UW-Allen-School-Robotics/opendubs/description/README.md

# Robot description

The single description of the robot's geometry, read by everything that needs it: the MuJoCo
simulator (`sim/`), the clearance checker, the choreography preview, and the dashboard's arm
view. Nothing else in the repository carries a copy.

| Folder | What | Source |
|---|---|---|
| [`opendubs/`](opendubs/) | the base, wheels, Z-axis lift and pan/tilt head: `opendubs.xml` (MJCF), its meshes, and `dimensions.yaml`, which records where every number came from | this project, from CAD and measurement |
| [`openarm/gafro/`](openarm/gafro/) | the arms for the gafro stack: `openarm_assets`' model with joint 2 capped for the head, generated by `tools/arm_gafro_model.py` (its meshes are `openarm/meshes/`) | generated |
| [`openarm/`](openarm/) | the two OpenArm v1 arms and their frame: `mjcf/` (MuJoCo), `urdf/` (for the dashboard), `meshes/collision/` (shared by both), `meshes/visual/` (MuJoCo only, decimated), and `chain.json` (generated) | vendored; see below |

**The geometry is real; the dynamics are not.** See the banner in `sim/README.md` before reading
anything about force, timing or mass out of these files.

## The vendored arms

`openarm/` comes from two upstream projects, both Apache-2.0 at their origin:

- **MuJoCo model** — `mjcf/` and `meshes/` from
  [`openarm_assets`](https://github.com/ericjgoossen/openarm_assets) (MIT), which packages
  [`enactic/openarm_mujoco`](https://github.com/enactic/openarm_mujoco). The MJCF and the collision
  meshes are unchanged; the visual meshes are decimated to keep this repository small.
  `PROVENANCE.json` records both commits and the triangle counts before and after.
- **URDF** — `urdf/v1.urdf` from
  [`enactic/openarm_description`](https://github.com/enactic/openarm_description), with its
  collision mesh paths pointed at the shared meshes. See `urdf/README.md`.

Licences: `LICENSE-openarm-models` (Apache-2.0, the arm models), `LICENSE-openarm_assets` (MIT,
the packaging), `urdf/LICENSE.txt` (Apache-2.0, the URDF).

`opendubs/` is the project's own: its meshes are the project's CAD under the repository's hardware
licence (CERN-OHL-W-2.0, `LICENSE-HARDWARE`), and `dimensions.yaml` (`meshes:`) records where each
came from.

### Refreshing the arms

```bash
git clone https://github.com/ericjgoossen/openarm_assets /tmp/oa_assets
uv run --python 3.11 --with trimesh --with fast-simplification --with numpy \
    python tools/vendor_openarm.py --from /tmp/oa_assets
python3 sim/scene.py --check
python3 tools/arm_chain.py --check
```

To try a newer upstream model without vendoring it, pass the checkout to `sim/scene.py --assets`.

## Who reads what

| Consumer | Reads |
|---|---|
| `sim/scene.py`, `sim/view.sh`, `sim/clearance.py`, `software/choreo/sim_preview.py` | `opendubs/opendubs.xml` + meshes, `openarm/mjcf/` + `openarm/meshes/` |
| The dashboard's arm view (`software/kiosk-dashboard/frontend/armview.js`) | `openarm/chain.json` + `openarm/meshes/collision/`, through `frontend/assets/arm`, a symlink to `openarm/` in a checkout. `deploy.sh` copies just those files to the robot |
| `tools/arm_chain.py` | `openarm/urdf/v1.urdf` → writes `openarm/chain.json` |
| `opendubs/gen_urdf.py` | `opendubs/dimensions.yaml` → writes `opendubs/opendubs.urdf` (the ROS TF tree for `robot_state_publisher`) |
| `opendubs/variants.py` | `opendubs/dimensions.yaml` → swaps an alternative part (the straight Femto mount; the 30° one is fitted) into an `opendubs.xml` MjSpec before it is compiled |

## Regenerating the derived files

`describe.py` runs every generator above, so nothing has to know them one by one:

```sh
python3 description/describe.py              # rebuild chain.json and the URDFs (one per Femto mount)
python3 description/describe.py --check      # exit 1 if either is stale (CI runs this)
python3 description/describe.py --watch      # rebuild on any change to an input (pip install watchfiles)
python3 description/describe.py --manifest   # JSON sha256 of every input and output, for caching
```

It needs Python 3 and PyYAML, and no ROS. Exit codes are 0 for OK, 1 for stale and 2 for a missing
input or a generator that crashed. A generator script counts as an input, so editing one changes the
manifest.
