UW-Allen-School-Robotics/opendubs/hardware/renders/README.md

# Renders

Exploded views and assembly figures for the build guide (exported from Fusion 360).
**TODO — populate.** One exploded render per subassembly (`CH`, `DT-*`, `PW`, …) drops straight into
the corresponding assembly-guide step.
