UW-Allen-School-Robotics/opendubs/software/kiosk-dashboard/frontend/assets/README.md

# DRIVE page mode illustrations (TEMPORARY)

The DRIVE page shows the current drive variant with a robot render. Drop the two
provided Fusion renders here (exact names matter):

- `robot-mecanum.png`  — the mecanum-wheel build (MECANUM mode)
- `robot-4wd.png`      — the traction-tire build (4WD TRACTION mode)

These are placeholders for illustration; swap for final art later. The frontend
references them at `assets/robot-mecanum.png` / `assets/robot-4wd.png`.
