UW-Allen-School-Robotics/opendubs/docs/system-overview.md

# System Overview

## Core Architecture

The core robot as buses and interfaces. **Click the diagram to pan and zoom the live board** — the
labels are small at page scale:

<div class="embed-facade" markdown="1" data-embed="https://embed.figma.com/board/LVbgJwMKO65TARF3m6v7I6/OpenDubs?node-id=21-995&embed-host=opendubs-docs" data-title="OpenDubs bus map (Figma)">
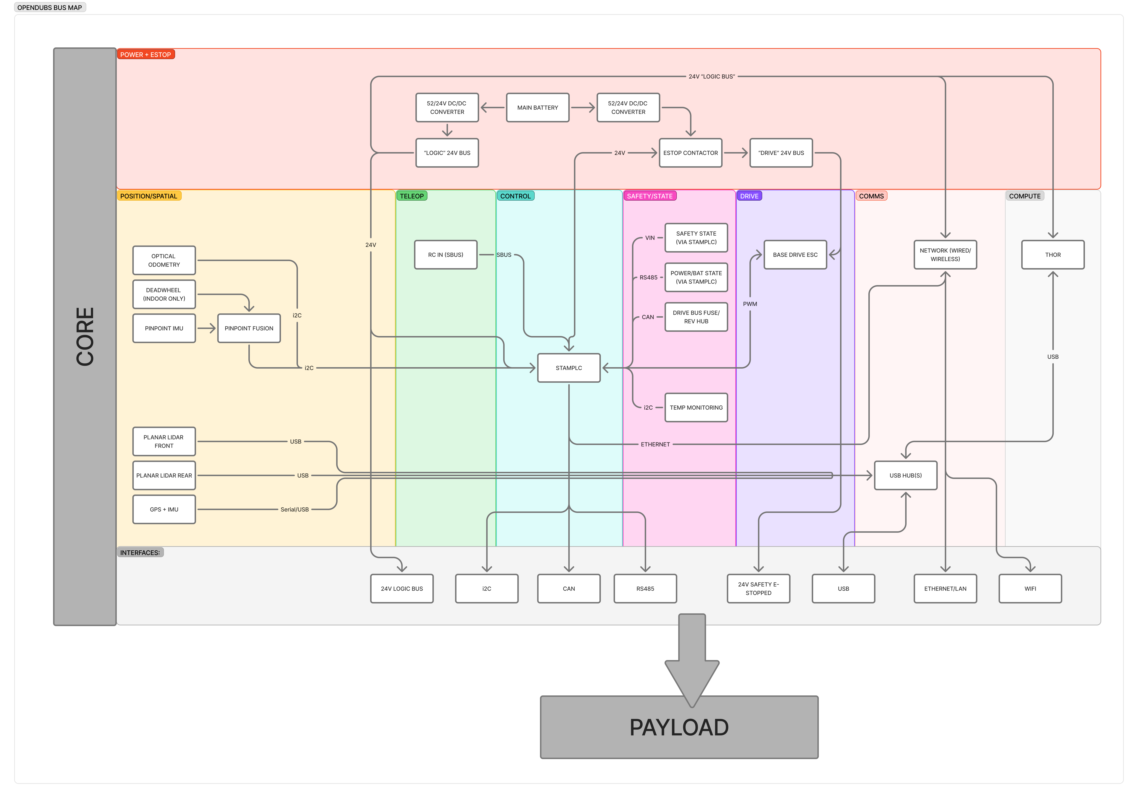
[picture p1: docs/assets/diagrams/opendubs-bus-map.png]
OpenDubs bus map — click to pan and zoom the interactive board

<span class="embed-facade__play">▶ Pan &amp; zoom the live board</span>
</div>

Power + e-stop, position/spatial, teleop, control, safety/state, drive, comms, and compute —
converging on the StamPLC and Thor, and exposed to a payload through the standard interfaces
(24 V logic, I²C, CAN, RS485, USB, Ethernet, Wi-Fi, and 24 V safety/e-stopped).

- **Open in Figma:** [OpenDubs board — bus map](https://www.figma.com/board/LVbgJwMKO65TARF3m6v7I6/OpenDubs?node-id=21-995) — the live board also includes the **payload-connected** system bus map (the poster above shows the core version). Clicking the diagram loads the full interactive board.

- Primary robot brain: **NVIDIA Thor AGX Dev Kit**
- Edge controllers: **StamPLC** on the mobile base, and an **M5Dial** neck controller for the
  head — introduced under *Responsibility split* below. Each payload may bring its own as well
- Mobile base: 4 motors + 2 dual-channel ESCs, optimised for **mecanum** drive and switchable to
  **4WD traction** drive in software
- Z-axis: the interchangeable payload that raises and lowers the arms — a **scissor lift**
  (fitted today) or a **mast** (DC motor driving a lead screw)
- Manipulators: dual OpenArm 7-DOF arms

OpenArm reference:
- https://github.com/enactic/OpenArm

## Responsibility split

Two edge controllers sit beneath the Thor. Neither reduces to a single function, so each is
introduced here with what it owns — and referred to by name everywhere after that.

### Thor AGX — robot level

- High-level behavior, planning, and autonomy orchestration
- Robot mode supervision
- Subsystem enable/disable coordination
- System-level fault handling policy decisions

### StamPLC — the mobile base

It owns the safety-critical edge of the base: it is the RC receiver, the e-stop moderator, the
source of the ESC and motor commands, and the publisher of hardware telemetry.

- RC/SBUS ingest and normalisation
- PWM output generation and safety gating
- E-stop moderation — contactor coil, button sense, weld detect
- Z-axis relay control and the pinch guard
- I²C and CAN edge interactions
- Fast safety fallback behaviours
- Hardware telemetry publishing

### The head — a tablet on an M5Dial neck

The head is two devices.

- **The tablet** — an Android tablet on the neck's mount, running the face page the dashboard
  serves. It is the display, speaker, microphone and cameras, and, lifted off its mount, the
  operator's dashboard. It runs on its own battery.
- **The M5Dial neck controller** — the second edge controller. It drives the pan and tilt servos
  through its own 8Servo, from the RC sticks (forwarded by the StamPLC) or from the Thor.

## Subsystems

- Mobile base subsystem
- Z-axis subsystem
- Left arm subsystem
- Right arm subsystem

Each subsystem has local state, fault state, and enable state.

## Related Docs

- [Control Authority and Modes](control-authority.md)
- [Robot and Subsystem State Machines](state-machines.md)
- [PWM and ESC Safety](pwm-esc-safety.md)
