UW-Allen-School-Robotics/opendubs/notes/design/choreo-dance-live.md

# DANCE on the real base

A show's DANCE cues are small dance steps of the base: sway, rock, twist, shuffle, box (`cue.DANCE_MOVES`).
Every one returns the base to where it started by construction. Until now they played in the twin only.
This is how a live run plays them on the robot. Owned by the Choreography lane. The tracker, the people
guard and the speed measurement are the Thor lane's (drive_bridge: #471 the guard, #472 the tracker).

## Fixed by the user

- **The deadman stays.** The base moves only in CH5 AUTO with the deadman held, under the firmware's
  0.35 command ceiling. Nothing here gates motion; it only sends targets.
- **No new sensors.** Relative motion comes from the Pinpoint odometry (`/odom`). The people guard uses
  the two LIDARs.
- **Free-form DRIVE stays twin-only.** Only DANCE moves, which return home, reach the robot.

## The interface (agreed with the Thor lane, 2026-10-21)

| topic | type | who | what |
|---|---|---|---|
| `/dance/origin` | `std_msgs/Empty` | runner | once per run, at the show's t0, the base at rest: the tracker latches the current `/odom` pose as the show's origin (`origin_seq` +1) |
| `/dance/target` | `nav_msgs/Odometry` | runner | 20 Hz while a move plays and for 1.5 s after it (the home target, zero twist, so the tracker closes the residual). `frame_id` `dance_origin`, `child_frame_id` `base_link`; pose = the intended base pose in the origin frame (x forward, y left, yaw); twist = the intended BODY velocity (m/s, rad/s) as feed-forward. Freshness by receipt time: older than 250 ms means stop |
| `/dance/stop` | `std_msgs/Empty` | runner | on every end: at once on an operator stop, abort or e-stop; after the last move's settle on a completion. Stops and drops the stream, and releases the base (the tracker holds it as the owner `show`, #485) |
| `/dance/status` | `std_msgs/String` (JSON, ~5 Hz) | tracker | `{"ready", "why", "origin", "origin_seq", "mode": idle\|tracking\|settling\|holding, "guard": clear\|stopped\|blind, "owner": null\|"show"\|<another program>, "err_m", "err_deg"}`; `ready` covers `/odom`, the guard, and no OTHER program holding the base ("the base is held by <name>": the base has one software owner at a time, #485); `origin` whether one is latched |

The tracker:

- never chases: corrections are capped at the 0.35 ceiling;
- past 0.3 m or 20° of error it HOLDS where it is and reports `mode: holding`;
- when a LIDAR scan is over 0.5 s old it is `blind` and refuses to move;
- refuses a target that arrives before any origin.

## The runner (`base_output.py`, `--base ros`)

- **Preflight, on a live run of a show with DANCE:** the tracker's status must be fresh and ready.
  - Not ready: the show runs WITHOUT its base moves and says why. The arms and everything else play as
    written; every move is relative to the base, so nothing collides.
  - A show with `dance: {required: true}` is refused instead (SHOW_BASE_NOT_READY).
- **The run:**
  - At t0 it publishes the origin.
  - Through each move it streams the same pose the twin draws (`sim_preview`'s model, the same speeds),
    with its body velocity.
  - Nothing is sent between moves, so the tracker stops.
  - On completion the last move still gets its settle, then it publishes `/dance/stop`. On any other end it
    publishes it at once. Either way the base is handed back, so another program can claim it.
- **Logging:** the guard (`stopped`: someone in the way; `blind`) and a `holding` tracker are logged.
  Neither aborts the show: the tracker decides what the base does.
- **Elsewhere:** a runner without `--base ros`, or a run that is not live, plays DANCE in the twin only.

## Speeds

The twist is in m/s and rad/s, and drive_bridge maps it to the wheels through its full scale, the speed
at DRIVE 1.0. In AUTO that is the firmware ceiling: 0.35 × the CH8 knob × full command.

- **The show cap** (the user's direction, 2026-10-22): software (AUTO) base motion is capped at a
  fraction of full command on every wheel, 0.35 on opendubs2 today (`cue.SHOW_BASE_CAP`, provisional). The
  Thor's drive path enforces it, per robot (`/etc/opendubs/base.env`), and the user may change it; RC is
  not capped. A dance unit of 1.0 is the cap. Top speed is never measured: shows are planned at the speeds
  at the cap.
- **Headroom** (the user's decision, 2026-10-22): a move peaks at no more than 70 % of the cap on the axis
  it uses (`cue.DANCE_PEAK_OF_CAP` 0.7; `amp` ≤ 0.7, the default), so the tracker has room to correct, and
  the validator refuses a DANCE cue that asks for more. At half the cap the motors barely turned and the
  base shuddered. No stroke moves and turns at once: strafing right yaws this base clockwise (about
  15 °/s, mechanical), and holding the heading uses part of the turn budget. The tracker trims that yaw by
  feed-forward, per strafe direction.
- **The speeds at the cap**, opendubs2's `base.env` (provisional: measured at a 0.25 cap, 1.5 s bursts,
  CH8 at its maximum, from `/odom`, and scaled to 0.35): forward 0.38 m/s, strafing 0.25 m/s either way,
  turning 0.52 rad/s (`BASE_M_PER_S_AT_CAP`, `BASE_M_PER_S_STRAFE_AT_CAP`, `BASE_RAD_PER_S_AT_CAP`). So
  at the default amp a sway peaks at about 0.175 m/s, and a 3 s sway swings about ±5.4 cm.
- **Every move starts and ends at rest** (measured on opendubs2, 2026-10-22). Constant-speed steps
  shuddered, the StamPLC holds each wheel still for 0.2 s at every direction flip, and a move that ends at
  speed makes the tracker brake from the peak. So each stroke is either a **swing**, the windowed sine
  `sin(2πu)·sin²(πu)` (out one way, through the middle at peak speed, out the other way and home, slow at
  both turn-arounds), or a **step**, `(1 − cos πu)/2` (to a new place and stop). A stroke's peak speed is
  exactly its amp × the speed at the cap.
- All of these numbers are re-measured after the drivetrain gets its belts. When the cap changes,
  `SHOW_BASE_CAP`, `DANCE_PEAK_OF_CAP` and the three speeds change together.
- Shows assume CH8 at its maximum. A lower knob can make the base lag, and the tracker holds rather than
  chase.

## Staging (also in every DANCE show's notices)

- **Glass.** Keep the show's declared floor radius clear of glass railings and glass walls: the LIDARs
  see through glass, so the guard does not see the edge.
- **Polished floors.** The odometry pods may skip on a polished floor: run a short out-and-back there
  first and compare `/odom` with where the base really went.
- **The floor test at the venue**, in this order:
  1. DANCE alone, measured with `/odom`: each move returns home within the tracker's error;
  2. then a full show.
