UW-Allen-School-Robotics/opendubs/notes/design/choreo-video.md

# Show video on a projector

Choreography lane, with the Tablet, Thor and Network lanes for their parts. Started 2026-10-20 for a
projector arriving the next day: an Anker Nebula P1i (1080p, Google TV with Chromecast built in,
a 20 W speaker; HDMI in presumed, to confirm when unboxed). It sits either on the robot or on the floor.

**Decided (the user):** casting first — the Thor serves the file over Wi-Fi and the projector's built-in
Cast plays it; HDMI from the Thor is the alternative when the projector is on the robot and sync
matters; the output is chosen at design time (per show or per cue) and at play time; and the dashboard
shows whether the projector is set up.

**Built (this PR):** the VIDEO track in the show format, the library's `video` kind, both outputs
(`software/choreo/video_out.py`), the runner playing them on the show's clock with its preflight and
the play-time override, the dashboard routes the projector card reads, and a CLI for the first test.
**Not built:** the HDMI player's service (Thor lane), the projector card (Tablet lane, #441), the
router reservation (Network lane), and the audio question (§5, for the user).

## 1. Video in a show

```yaml
video: { output: cast }            # optional: the show's default output (cast | hdmi | off), and
                                   # required: true to REFUSE the show when that output isn't ready
cues:
  - { bar: "5.1", slot: VIDEO, do: play, video: intro-loop }                   # to its end, then black
  - { t: 42.0,    slot: VIDEO, do: play, video: lab-tour, from_s: 12, secs: 20, end: hold }
  - { t: 70.0,    slot: VIDEO, do: stop }                                      # black now
```

- `video:` is a **library** id of kind `video` (`library.py add FILE --kind video --duration S --width W
  --height H --source … --licence …`). Video media never goes in the repository: the robot yes, the repo
  no. MP4/H.264 up to 1920×1080 plays on any Cast device; WebM and MKV are accepted for HDMI.
  `show_sync.py` sends a show's videos with its songs and skins (`library_sync.py`).
- `play` starts at the cue's time, `from_s` seconds into the file, for `secs` (default: to its end).
  Then `end`: `black` (default) or `hold` (its last frame). The next VIDEO cue ends the one before it.
  One video at a time — one projector — so overlapping VIDEO cues are refused like any slot collision.
- The output is the cue's `output`, else the show's `video: {output}`, else the robot's default
  (`OPENDUBS_VIDEO_OUTPUT`, else `cast`); the operator's play-time choice overrides them all (§4).
  The export carries each VIDEO event's resolved `output`.
- It stops on every end: COMPLETED, a stop, an abort → black; an e-stop → stopped at once.

## 2. The cast path

- **Discovery:** mDNS (`_googlecast._tcp`) from the Thor, refreshed every 10 s by the runner, so the
  card's answer is never older than that. Where multicast does not cross the network, a fixed address
  works without mDNS: `OPENDUBS_CAST_HOST` in `/etc/opendubs/robot.env`. With several Cast devices
  around, `OPENDUBS_CAST_NAME` names this robot's projector.
- **Serving:** the runner serves only the files a run registers (no directory, no other path) from a
  byte-range HTTP server on `OPENDUBS_VIDEO_PORT` (**8094**; 8093 is the voice service), bound at start to
  the robot-LAN interface's address — the interface avahi is limited to (`allow-interfaces`, as the
  AirPlay receiver reads it), or `OPENDUBS_VIDEO_BIND` (an address or an interface name) in robot.env;
  never a written-down address, since the Thor's LAN address is a DHCP lease. Cast receivers fetch and seek with Range
  requests. The URL's host is the Thor's own address toward the projector.
- **Control:** pychromecast, the Default Media Receiver: `load` (BUFFERED, paused at `from_s`) while the
  arms travel to their start pose, `play`, `seek`, `stop`, and a black still for `end: black`.
- **Sync** (`ShowVideo`): the receiver keeps its own clock, so —
  1. **start early** by its measured start latency, `OPENDUBS_CAST_LEAD_S` (default 0.8 s, per robot;
     measure it with `video_out.py play` and the test clip, §8);
  2. **correct with seeks**: every second the receiver's position (its last report, extrapolated to
     now) is compared with the show's; past **±250 ms** it is seeked back, but never within **8 s** of the
     last seek, because a Cast seek re-buffers — a visible hitch of a few hundred ms.
- **How tight, honestly:** the receiver reports its position as status messages, not a stream of
  timestamps, and its playback is not slaved to anything we control. Expect a steady error of about
  **±0.1–0.3 s** against the show's clock after the first correction, plus a **constant** lag of the
  projector's picture processing (typically 50–150 ms on a TV-style pipeline) that the receiver cannot
  report and only the lead can absorb — the test clip shows it. Good for backdrops, titles, scene
  changes and visuals timed to a beat; **not** good enough for lip-sync against sound played elsewhere
  (the tablet), and a correction is a visible hitch. Tighter sync is the HDMI path.
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
