UW-Allen-School-Robotics/opendubs/notes/design/network-uplinks.md

# Taking the robot off campus: joining other networks, and eduroam

**DRAFT, 2026-10-19, Network lane.** Design only; nothing is configured. Plan items N-J1…N-J5 and
N-E1…N-E4 in [`../workplan-network.md`](../workplan-network.md).

**The goal.** The router should join a venue's network as its uplink the same way it joins
UW MPSK today. The robot's own Wi-Fi ("Opendubs2") and its LAN (10.42.2.0/24) must stay exactly
as they are. An operator adds or switches a network without the router's admin web page and
without any risk of locking themselves out.

MikroTik facts come from the
[Wireless Interface](https://help.mikrotik.com/docs/spaces/ROS/pages/8978446/Wireless+Interface)
and [WiFi](https://help.mikrotik.com/docs/spaces/ROS/pages/224559120/WiFi) pages, read
2026-10-19. Facts about this router come from a read-only session the same day.

---

## 1. Constraints that shape every option
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
