UW-Allen-School-Robotics/opendubs/notes/design/choreo-direction.md

# Choreography: direction

Intent from the project team's composer discussion, 2026-10-16. **Notes, not work orders**: nothing
here is scheduled or started. What is built is in [`choreo-format-v1.md`](choreo-format-v1.md) and
[`../workplan-choreography.md`](../workplan-choreography.md).
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
