UW-Allen-School-Robotics/opendubs/docs/assets/build/electronics-bay/hero.png

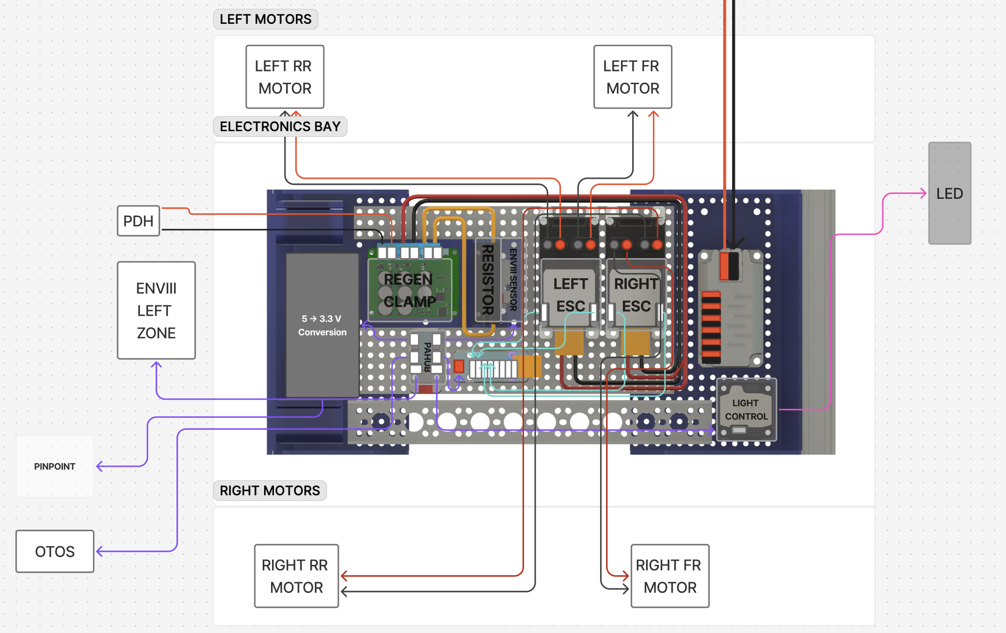
docs/assets/build/electronics-bay/hero.png
