UW-Allen-School-Robotics/opendubs/docs/assets/build/power-bay/06b-bay-overview.webp

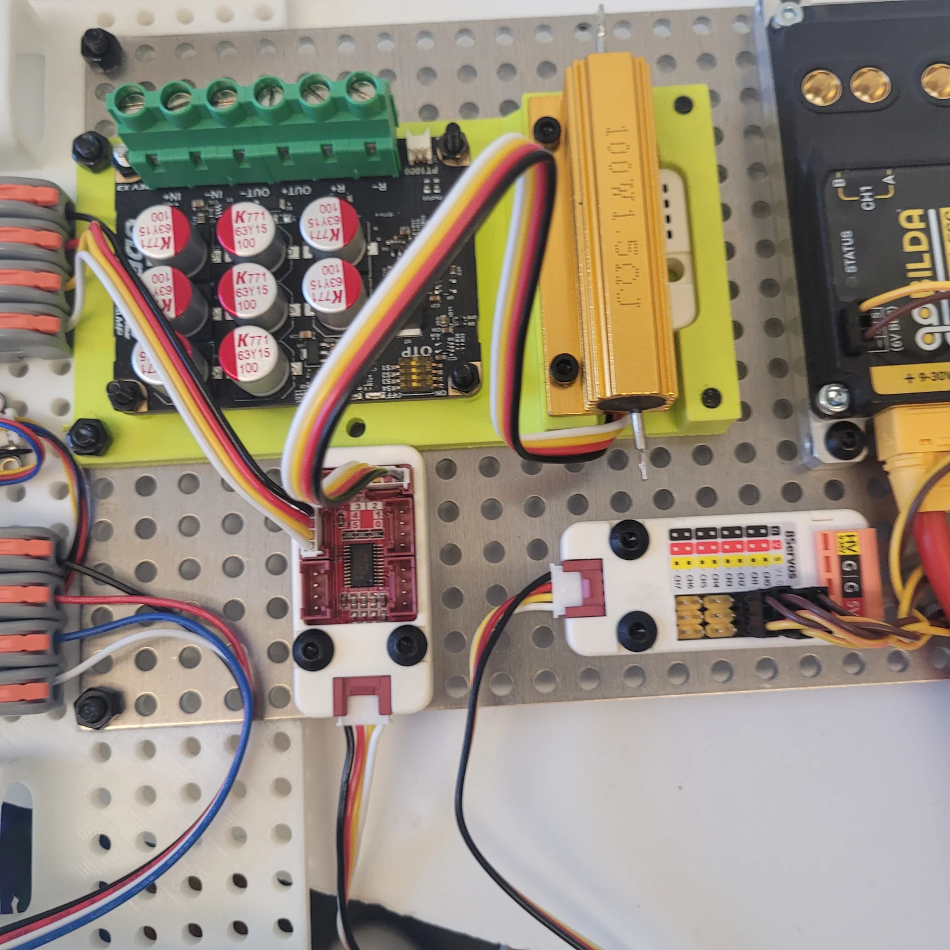
docs/assets/build/power-bay/06b-bay-overview.webp
