UW-Allen-School-Robotics/opendubs/docs/assets/composer/composer-01-overview.png

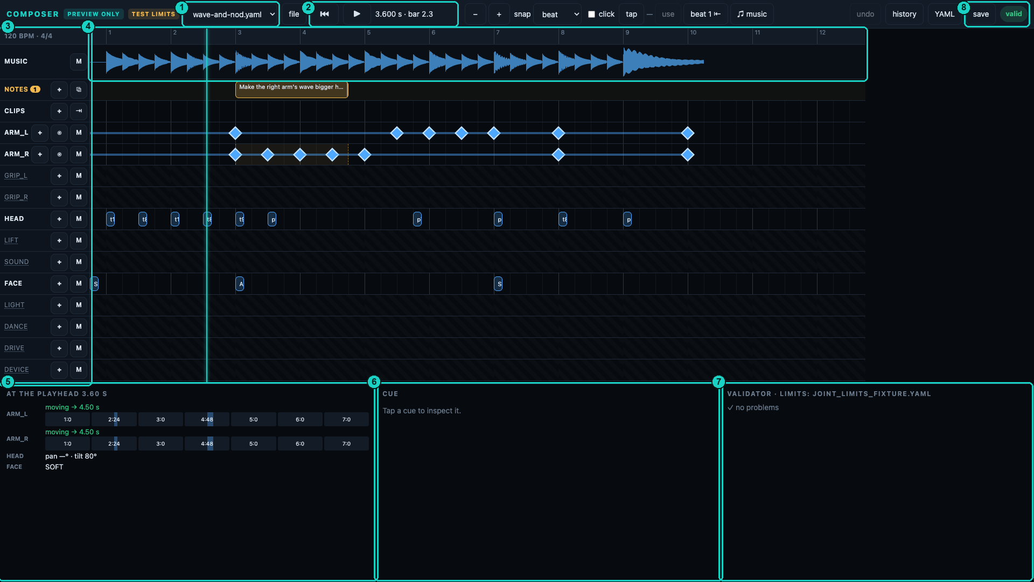
docs/assets/composer/composer-01-overview.png
