UW-Allen-School-Robotics/opendubs/docs/assets/composer/composer-02-music.png

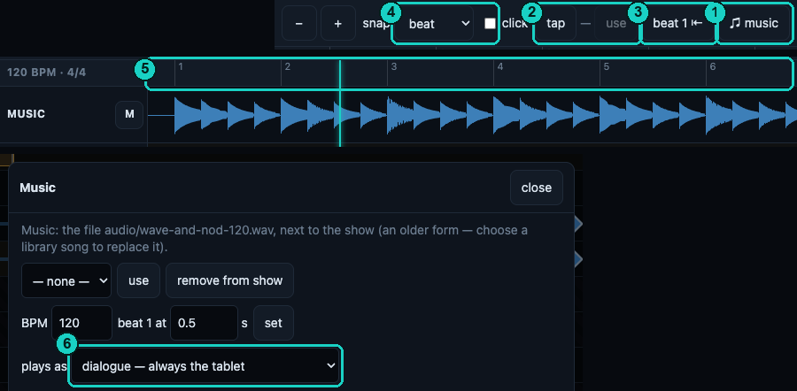
docs/assets/composer/composer-02-music.png
