UW-Allen-School-Robotics/opendubs/docs/assets/composer/composer-03-cues.png

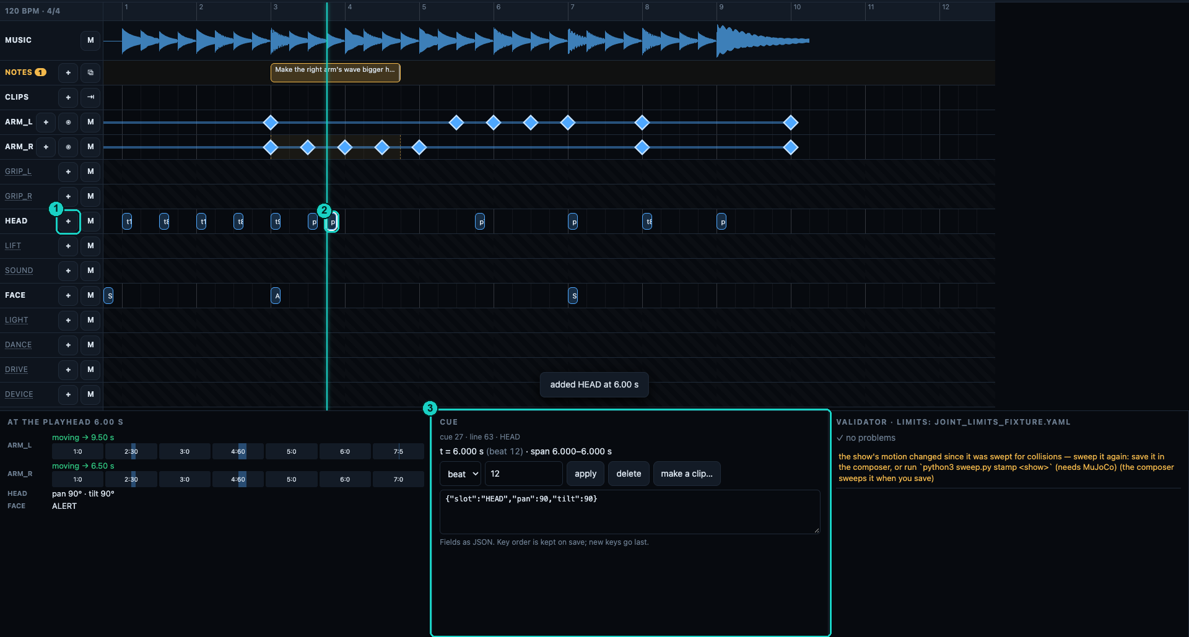
docs/assets/composer/composer-03-cues.png
