UW-Allen-School-Robotics/opendubs/docs/assets/composer/composer-04-notes.png

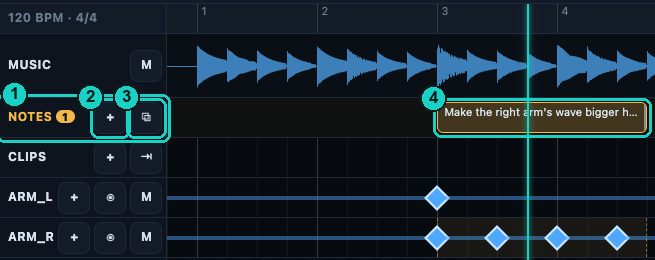
docs/assets/composer/composer-04-notes.png
