UW-Allen-School-Robotics/opendubs/docs/assets/composer/composer-06-twin.png

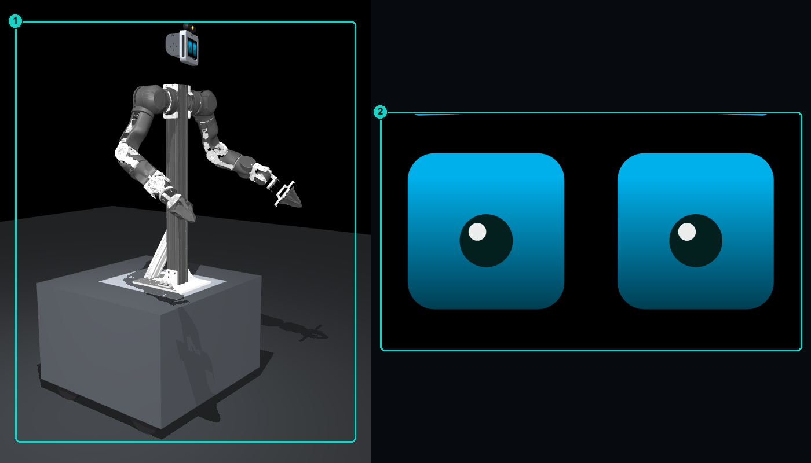
docs/assets/composer/composer-06-twin.png
