UW-Allen-School-Robotics/opendubs/docs/assets/composer/composer-07-render.png

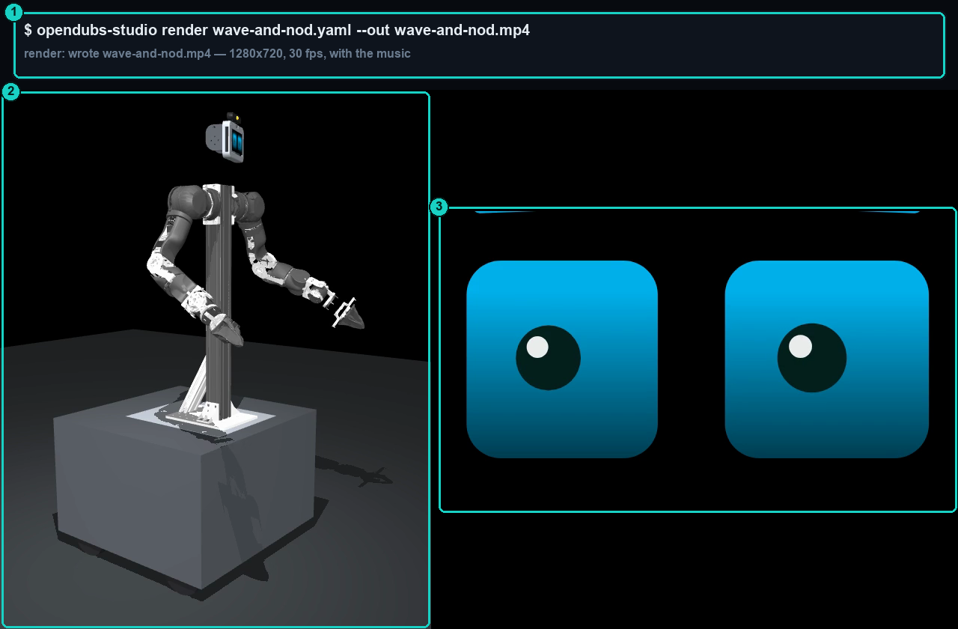
docs/assets/composer/composer-07-render.png
