UW-Allen-School-Robotics/opendubs/docs/assets/composer/composer-08-shows.png

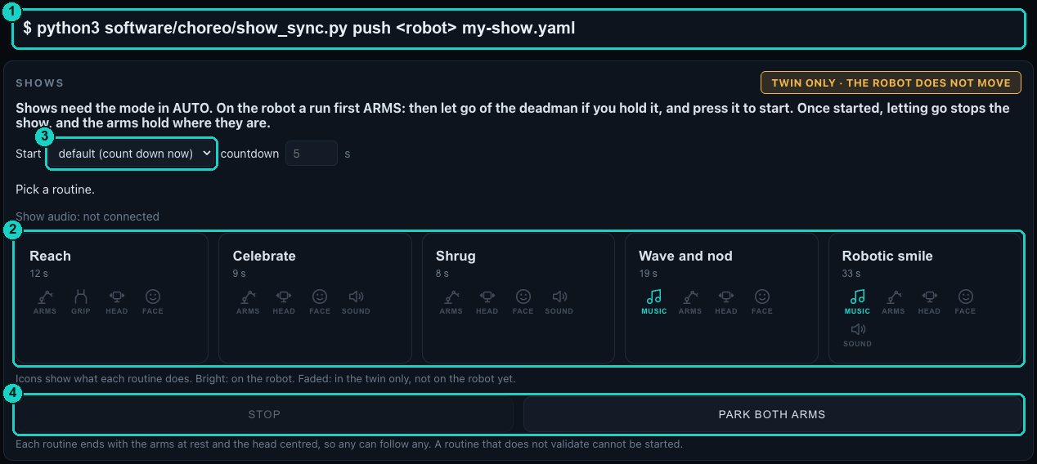
docs/assets/composer/composer-08-shows.png
