UW-Allen-School-Robotics/opendubs/docs/assets/diagrams/stamplc-buses.png

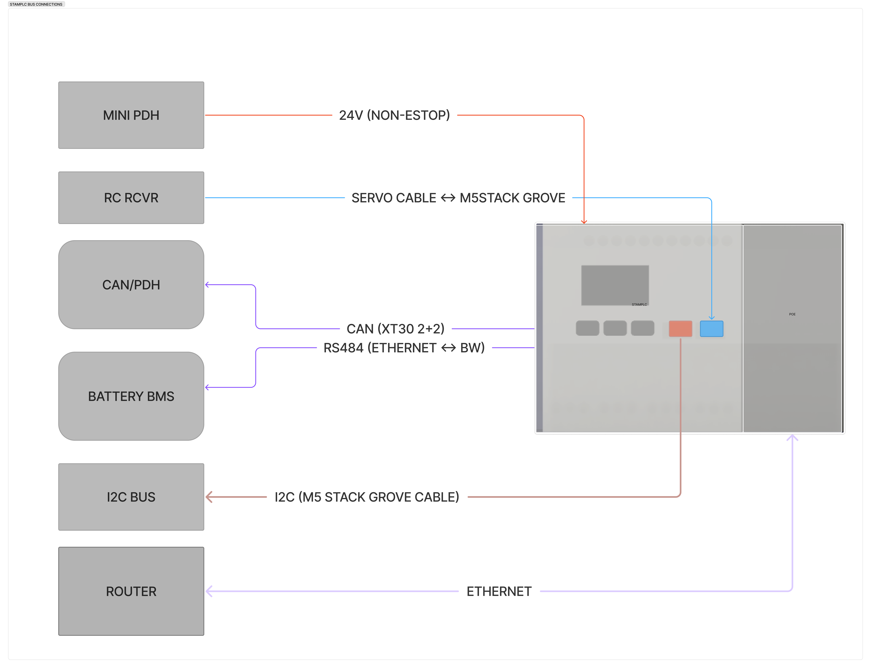
docs/assets/diagrams/stamplc-buses.png
