UW-Allen-School-Robotics/opendubs/docs/assets/diagrams/stamplc-inputs-and-relays.png

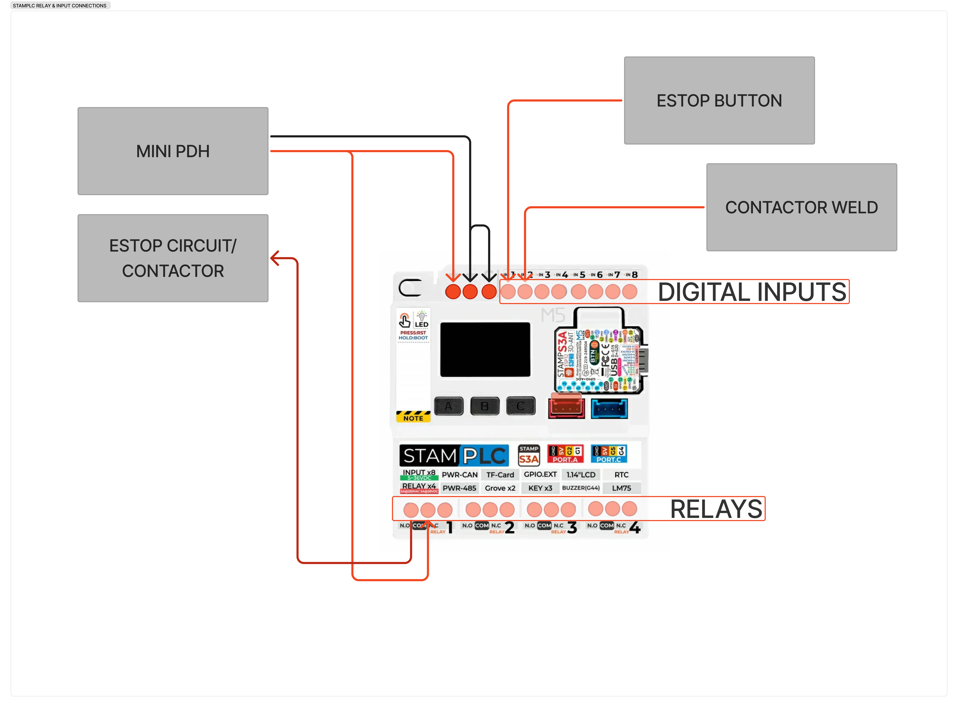
docs/assets/diagrams/stamplc-inputs-and-relays.png
