UW-Allen-School-Robotics/opendubs/hardware/parts.csv

id | name | type | group | sku | module | qty | need | source | notes | buy_qty | price_usd | price_source | price_date
uch-25h-624 | U-channel, 25-hole, 624 mm | structure | Frame structure | 1120-0025-0624 | base-frame | 2 |  | https://www.gobilda.com/1120-series-u-channel-25-hole-624mm-length/ | Frame long side rails | 2 | 28.99 | https://www.gobilda.com/1120-series-u-channel-25-hole-624mm-length/ | 2026-10-09
uch-17h-432 | U-channel, 17-hole, 432 mm | structure | Frame structure | 1120-0017-0432 | base-frame | 3 |  | https://www.gobilda.com/1120-series-u-channel-17-hole-432mm-length/ | Cross rails (three lower-rail assemblies) | 3 | 20.99 | https://www.gobilda.com/1120-series-u-channel-17-hole-432mm-length/ | 2026-10-09
quad-block | Quad block mount | structure | Frame structure | 1201-0043-0002 | base-frame | 10 |  | https://www.servocity.com/1201-series-quad-block-pattern-mount-43-2/ | 6 for lower rails + 4 for drive assemblies | 10 | 6.99 | https://www.gobilda.com/1201-series-quad-block-pattern-mount-43-2/ | 2026-10-09
gorail-192 | 1118 Series Open goRAIL, 192 mm | structure | Frame structure | 1118-0024-0192 | base-frame | 4 |  | https://www.servocity.com/1118-series-open-gorail-192mm-length/ | 192 mm open goRAIL (T-slot extrusion); 4 per frame | 4 | 7.79 | https://www.gobilda.com/1118-series-open-gorail-192mm-length/ | 2026-10-09
hub-shaft | Hub shaft | structure | Drive assembly (x4) | 2110-0608-0002 | base-frame | 4 |  | https://www.gobilda.com/shouldered-8mm-rex-hub-shaft-20mm-hub-offset/ | 1 per drive assembly | 4 | 12.99 | https://www.gobilda.com/shouldered-8mm-rex-hub-shaft-20mm-hub-offset/ | 2026-10-09
bearing-6id | Bearing, 6 mm ID | structure | Drive assembly (x4) | 1611-0514-0006 | base-frame | 4 |  | https://www.gobilda.com/1611-series-flanged-ball-bearing-6mm-id-x-14mm-od-5mm-thickness-2-pack/ | 1 per drive assembly | 2 | 3.99 | https://www.gobilda.com/1611-series-flanged-ball-bearing-6mm-id-x-14mm-od-5mm-thickness-2-pack/ | 2026-10-09
bearing-8 | Bearing, 8 mm | structure | Drive assembly (x4) | 1611-0514-0008 | base-frame | 4 |  | https://www.gobilda.com/1611-series-flanged-ball-bearing-8mm-id-x-14mm-od-5mm-thickness-2-pack/ | 1 per drive assembly | 2 | 3.99 | https://www.gobilda.com/1611-series-flanged-ball-bearing-8mm-id-x-14mm-od-5mm-thickness-2-pack/ | 2026-10-09
miter-8rex | Miter gear, 8 mm REX | structure | Drive assembly (x4) | 2320-4008-0024 | base-frame | 8 |  | https://www.gobilda.com/clamping-steel-miter-gear-8mm-rex-bore-24-tooth-mod-1/ | 2 per drive assembly; orientation sets wheel direction | 8 | 15.99 | https://www.gobilda.com/clamping-steel-miter-gear-8mm-rex-bore-24-tooth-mod-1/ | 2026-10-09
spacer-9 | Spacer, 9 mm | structure | Drive assembly (x4) | 1522-0010-0090 | base-frame | 4 |  | https://www.gobilda.com/1522-series-8mm-id-spacer-10mm-od-9mm-length-4-pack/ | 1 per drive assembly | 1 | 4.24 | https://www.gobilda.com/1522-series-8mm-id-spacer-10mm-od-9mm-length-4-pack/ | 2026-10-09
shim-6id | Shim, 6 mm ID | structure | Drive assembly (x4) | 2807-0609-0250 | base-frame | 4 |  | https://www.gobilda.com/2807-series-stainless-steel-shim-6mm-id-x-9mm-od-0-25mm-thickness-12-pack/ | 1 per drive assembly | 1 | 2.49 | https://www.gobilda.com/2807-series-stainless-steel-shim-6mm-id-x-9mm-od-0-25mm-thickness-12-pack/ | 2026-10-09
shim-8id | Shim, 8 mm ID | structure | Drive assembly (x4) | 2807-0811-0500 | base-frame | 4 |  | https://www.gobilda.com/2807-series-stainless-steel-shim-8mm-id-x-11mm-od-0-50mm-thickness-12-pack/ | 1 per drive assembly | 1 | 2.69 | https://www.gobilda.com/2807-series-stainless-steel-shim-8mm-id-x-11mm-od-0-50mm-thickness-12-pack/ | 2026-10-09
washer-4 | Washer, 4 mm | structure | Drive assembly (x4) | 2801-0004-0008 | base-frame | 4 |  | https://www.gobilda.com/2801-series-zinc-plated-steel-washer-4mm-id-x-8mm-od/ | 1 per drive assembly | 1 | 1.99 | https://www.gobilda.com/2801-series-zinc-plated-steel-washer-4mm-id-x-8mm-od/ | 2026-10-09
drive-motor | goBILDA 5303-series motor, 99.5:1, 24 mm | structure | Drive motors | 5303-series (99.5:1 / 24 mm) | base-frame | 4 |  | https://www.servocity.com/5303-series-saturn-planetary-gear-motor-99-5-1-ratio-24mm-length-8mm-rex-shaft-180-rpm-3-3-5v-encoder/ | RECOMMENDED for this build (good speed/torque mix); ANY 5303-series motor fits physically. 1 per drive assembly; same motor class reused for the mast | 4 | 59.99 | https://www.servocity.com/5303-series-saturn-planetary-gear-motor-99-5-1-ratio-24mm-length-8mm-rex-shaft-180-rpm-3-3-5v-encoder/ | 2026-10-09
wheel-mec-l | Mecanum wheel, LEFT slant | structure | Wheels | 3213-3606-0003 | base-frame | 2 |  | https://www.gobilda.com/140mm-mecanum-wheel-set-70a-durometer-bearing-supported-rollers/ | Handed; do NOT install until late in the build | 1 | 299.99 | https://www.gobilda.com/140mm-mecanum-wheel-set-70a-durometer-bearing-supported-rollers/ | 2026-10-09
wheel-mec-r | Mecanum wheel, RIGHT slant | structure | Wheels | 3213-3606-0003 | base-frame | 2 |  | https://www.gobilda.com/140mm-mecanum-wheel-set-70a-durometer-bearing-supported-rollers/ | Handed; do NOT install until late in the build | 0 | 299.99 | https://www.gobilda.com/140mm-mecanum-wheel-set-70a-durometer-bearing-supported-rollers/ | 2026-10-09
m4x8-shcs | M4 x 8 mm socket-head screw (bulk) | fastener |  |  | shared | 2-3 packs | recommended | https://a.co/d/06F4f8am | 105-count pack; the primary structural fastener; DEGREASE before use | 3 | 7.99 | https://www.amazon.com/dp/B0CZP521J7 | 2026-10-09
m4x10-shcs | M4 x 10 mm socket-head screw (bulk) | fastener |  |  | shared | 2-3 packs | recommended | https://a.co/d/07bUYr2o | 105-count pack; DEGREASE before use | 3 | 7.99 | https://www.amazon.com/dp/B0CZP5LXWV | 2026-10-09
m4-caphead | M4 cap-head screw assortment | fastener |  |  | shared | 1 assortment | optional |  | Some parts use cap-head M4 (installed with a 2.5 mm hex); buy an assortment
m3-shcs | M3 socket-head screw assortment | fastener |  |  | shared | 1 assortment | optional |  | For non-goBILDA parts; not used in the base frame
ppe-glasses | Safety glasses (PPE) | tool |  |  | shared | 1 | required |  | Wear during ALL assembly — cutting, wiring, battery handling
ppe-gloves | Work gloves (PPE) | tool |  |  | shared | 1 | required |  | Protect hands during assembly, wiring, and battery handling
tool-hex3 | 3 mm hex wrench (4-pack) | tool |  |  | shared | 1 | required | https://a.co/d/028aG2GM | Minimum tool; builds the frame by hand (~$7) | 1 | 6.59 | https://www.amazon.com/dp/B0CZRRWF71 | 2026-10-09
tool-driver | Rechargeable hex driver (incl. 3 mm bit) | tool |  |  | shared | 1 | recommended | https://a.co/d/06aqx7Jc | Much faster for the bulk of the screws | 1 | 69.99 | https://www.amazon.com/dp/B0G3TVJS2K | 2026-10-09
tool-hex25 | 2.5 mm hex wrench / bit | tool |  |  | shared | 1 | recommended |  | For M4 cap-head screws
tool-ratchet7 | 7 mm ratcheting wrench | tool |  |  | shared | 1 | optional | https://a.co/d/03lJ5n8P | For nuts | 1 | 6.99 | https://www.amazon.com/dp/B0DCZJNYR7 | 2026-10-09
tool-longbits3 | Long 3 mm hex bits | tool |  |  | shared | 1 | optional | https://a.co/d/05i2Vbj9 | Reach screws in tight spots | 1 | 11.99 | https://www.amazon.com/dp/B08DSH7WW6 | 2026-10-09
threadlocker-blue | Blue removable threadlocker | consumable |  |  | shared | 1 | recommended | https://a.co/d/0igs0Bmw | Apply to structural screws; BLUE (removable), not red | 1 | 9.99 | https://www.amazon.com/dp/B0CHM5QS3N | 2026-10-09
otos-sensor | SparkFun Optical Tracking Odometry Sensor (OTOS) | component | Sensor & level shifting |  | otos | 1 |  | https://www.sparkfun.com/sparkfun-optical-tracking-odometry-sensor-paa5160e1-qwiic.html | PAA5160E1, Qwiic; 3.3 V — needs level-shifting to the 5 V M5 I2C bus | 1 | 84.95 | https://www.sparkfun.com/sparkfun-optical-tracking-odometry-sensor-paa5160e1-qwiic.html | 2026-10-09
otos-llc | Adafruit logic level converter | component | Sensor & level shifting | Adafruit 5637 | otos | 1 |  | https://www.adafruit.com/product/5637 | Shifts OTOS 3.3 V I2C up to the 5 V M5 bus | 1 | 2.95 | https://www.adafruit.com/product/5637 | 2026-10-09
otos-enclosure | 3D-printed enclosure set | printed | Enclosure & mounting |  | otos | 1 |  |  | A few small printed parts; STLs in hardware/ TBD
m4x55-shcs | M4 x 55 mm socket-head screw | fastener | Enclosure & mounting |  | otos | 4 |  | https://www.amazon.com/iExcell-Stainless-Socket-Screws-Wrench/dp/B089NGGLZQ | Long standoff screws for the 10 mm sensor mount; confirm qty | 1 | 8.86 | https://www.amazon.com/dp/B089NGGLZQ | 2026-10-09
otos-wago | WAGO lever connectors | consumable | Wiring |  | otos | a few |  | https://a.co/d/09VO6gwP | Qwiic<->Grove and I2C/power joins — or solder instead | 1 | 23.99 | https://www.amazon.com/dp/B0D456KL7K | 2026-10-09
pinpoint-pack | 4-Bar Odometry Pack — Pinpoint computer + 2 dead-wheel pods | component | Odometry computer | 3203-3110-0002 | pinpoint | 1 |  | https://www.servocity.com/4-bar-odometry-pack-2-pods-1-pinpoint-computer/ | Pinpoint (IMU + odometry) + 2 pods; I2C at 3.3 V — the step-down lives in the electronics bay, NOT this module. Same pack on the Core BOM. | 1 | 279.99 | https://www.gobilda.com/4-bar-odometry-pack-2-pods-1-pinpoint-computer/ | 2026-10-09
pinpoint-housing | 3D-printed module housing | printed | Mounting hardware |  | pinpoint | 1 |  |  | Holds the Pinpoint computer + pods; STLs in hardware/ TBD
m10-thumbscrew | M10 thumb screw (3D-printed) | printed | Mounting hardware |  | pinpoint | 2 |  |  | Hand-tightens the module to the rear rail; confirm qty
m10-rivnut | M10 riv-nut | fastener | Mounting hardware |  | pinpoint | 2 |  | https://a.co/d/07JbuGAl | Set into the rail's 14 mm holes; rivnut install is a FOLLOW-ON base-frame step; confirm qty | 1 | 9.99 | https://www.amazon.com/dp/B0D5D1HPNY | 2026-10-09
rivnut-tool-manual | Riv-nut tool (manual) | tool | Mounting tools |  | pinpoint | 1 |  | https://a.co/d/0am8KbEV | Sets the M10 riv-nuts — CHOOSE this OR the drill attachment | 1 | 43.99 | https://www.amazon.com/dp/B0CBKFV533 | 2026-10-09
rivnut-tool-drill | Riv-nut drill attachment | tool | Mounting tools |  | pinpoint | 1 |  | https://a.co/d/09zmlaXE | Drill-driven alternative to the manual riv-nut tool | 0 | 59.99 | https://www.amazon.com/dp/B0D8Q12YDQ | 2026-10-09
ebay-power | REV Mini Power Module (24 V logic bus) | component | Power distribution | REV-11-1956 | electronics-bay | 1 |  | https://www.revrobotics.com/rev-11-1956/ | 6 fused branch circuits — feeds Thor / StamPLC / router / USB hub(s) / E-stop signal (outside the bay) and the PRISM (inside) | 1 | 38.00 | https://www.revrobotics.com/rev-11-1956/ | 2026-10-09
ebay-esc | goBILDA 2x80A ESC | component | Drive electronics | 3105-0202-0080 | electronics-bay | 2 |  | https://www.servocity.com/content/user_manuals/3105-0202-0080_data-sheet.pdf | Drive ESCs (datasheet at the link). NOTE: 2x80A is likely OVER-SPEC for this drivetrain — a lower-amperage ESC would work and cost less; we used these because we had them on hand. | 2 | 159.99 | https://www.servocity.com/2x80a-motor-controller/ | 2026-10-09
ebay-8servo | M5 8Servo unit | component | Drive electronics |  | electronics-bay | 1 |  | https://docs.m5stack.com/en/unit/8Servos%20Unit | The StamPLC's: PWM to the four drive ESCs, at I2C 0x25 behind the PaHub. The neck has its own (Pan/Tilt HMI). | 1 | 6.95 | https://shop.m5stack.com/products/8-channel-servo-driver-unit-stm32f030 | 2026-10-09
neck-dial | M5Stack Dial v1.1 (ESP32-S3) | component | Neck controller | K130-V11 | pan-tilt-hmi | 1 |  | https://shop.m5stack.com/products/m5stack-dial-v1-1 | The neck controller: takes the head's commands over the network and drives the neck's 8Servo. | 1 | 34.90 | https://shop.m5stack.com/products/m5stack-dial-v1-1 | 2026-10-16
neck-8servo | M5 8Servo unit | component | Neck controller |  | pan-tilt-hmi | 1 |  | https://docs.m5stack.com/en/unit/8Servos%20Unit | The neck's own, at I2C 0x25 on the M5Dial neck controller's Port A: channel 0 tilt, channel 1 pan. Separate from the StamPLC's in the electronics bay. | 1 | 6.95 | https://shop.m5stack.com/products/8-channel-servo-driver-unit-stm32f030 | 2026-10-09
neck-servo | goBILDA 2000 Series Dual Mode Servo (25-2, Torque) | component | Neck controller | 2000-0025-0002 | pan-tilt-hmi | 2 |  | https://www.servocity.com/2000-series-dual-mode-servo-25-2/ | Pan and tilt, on the neck 8Servo's channels 1 and 0. Dual-mode: confirm each is in positional mode before fitting (see Commissioning). | 2 | 36.99 | https://www.servocity.com/2000-series-dual-mode-servo-25-2/ | 2026-10-20
chest-light | goBILDA RGB Indicator Light (PWM Controlled) | component | Chest indicator light | 3118-0808-0002 | pan-tilt-hmi | 1 |  | https://www.servocity.com/rgb-indicator-light-pwm-controlled/ | Lights the chest badge from behind in the robot's state colour; the PWM pulse width sets the colour. Fixed with M4 screws through its own holes. | 1 | 24.99 | https://www.servocity.com/rgb-indicator-light-pwm-controlled/ | 2026-10-16
chest-printed | 3D-printed chest plate set (face, gear, diffuser, centre mask, light box) | printed | Chest indicator light |  | pan-tilt-hmi | 1 |  |  | About 59 g of PLA in black, purple, gold, transparent and white; files and print settings in hardware/chest-plate/.
chest-m4x20 | M4 x 20 mm socket-head cap screw (ISO 4762) | fastener | Chest indicator light |  | pan-tilt-hmi | 4 |  |  | Through the light box floor and the light into the inserts; snug only. Socket heads, not button heads: the light's cover leaves exactly 7 mm for a head.
chest-m4-insert | M4 heat-set insert | fastener | Chest indicator light |  | pan-tilt-hmi | 4 |  |  | In the chest piece; about 5.6 mm hole x 8.1 mm long. Check yours against the CAD parameters.
chest-magnet | 6 x 2 mm disc magnet (N52 or similar) | component | Chest indicator light |  | pan-tilt-hmi | 8 |  |  | Four pairs, poles attracting: they hold the face on, so it lifts off to reach the screws.
chest-ca | CA glue | consumable | Chest indicator light |  | pan-tilt-hmi | 1 |  |  | Fixes the magnets and the gear, and tacks the diffuser to the face.
ebay-regen | ODrive Regen Clamp | component | Regen & protection |  | electronics-bay | 1 |  | https://shop.odriverobotics.com/products/odrive-regeneration-clamp | Absorbs braking regen; the resistor lead requires SOLDERING | 1 | 89.00 | https://shop.odriverobotics.com/products/odrive-regeneration-clamp | 2026-10-09
ebay-pahub | M5Stack PaHub (I2C hub) | component | I2C bus & level shift |  | electronics-bay | 1 |  | https://docs.m5stack.com/en/unit/pahub | I2C hub for the M5 bus | 1 | 5.95 | https://shop.m5stack.com/products/i2c-hub-1-to-6-expansion-unit-v2-1-with-dip-switch-pca9548a | 2026-10-09
ebay-llc | Adafruit logic level converter | component | I2C bus & level shift | Adafruit 5637 | electronics-bay | 1 |  | https://www.adafruit.com/product/5637 | 3.3 V<->5 V step-down for the Pinpoint I2C (the Pinpoint module has none) | 1 | 2.95 | https://www.adafruit.com/product/5637 | 2026-10-09
ebay-enviii | M5 ENV III sensor | component | Sensors |  | electronics-bay | 1 |  | https://docs.m5stack.com/en/unit/env-iii | Thermal probe under the regen clamp resistor | 1 | 6.95 | https://shop.m5stack.com/products/env-iii-unit-with-temperature-humidity-air-pressure-sensor-sht30-qmp6988 | 2026-10-09
ebay-prism | goBILDA PRISM light controller | component | Lighting |  | electronics-bay | 1 |  | https://www.gobilda.com/prism-rgb-led-driver-6-30v-input-i2c-pwm-control/ | In the bay; fed by the REV Mini Power Module; goBILDA I2C | 1 | 39.99 | https://www.gobilda.com/prism-rgb-led-driver-6-30v-input-i2c-pwm-control/ | 2026-10-09
ebay-gridplate | goBILDA grid plate, 17x29-hole, 136x232 mm | structure | Mounting | 1116-0136-0232 | electronics-bay | 1 |  | https://www.servocity.com/1116-series-grid-plate-17-x-29-hole-136-x-232mm/ | M5 + goBILDA components both mount here with M4 screws | 1 | 13.99 | https://www.gobilda.com/1116-series-grid-plate-17-x-29-hole-136-x-232mm/ | 2026-10-09
ebay-printed | 3D-printed mounting components | printed | Mounting |  | electronics-bay | 2 |  |  | 2 printed parts attach the bay to the robot; STLs in hardware/ TBD
ebay-wago | WAGO lever connectors | consumable | Wiring |  | electronics-bay | a few |  | https://a.co/d/09VO6gwP | PaHub<->PRISM (goBILDA I2C) and PaHub<->LLC<->Pinpoint joins | 0 | 23.99 | https://www.amazon.com/dp/B0D456KL7K | 2026-10-09
ebay-solder | Soldering iron + solder | tool | Bay-specific tools |  | electronics-bay | 1 | required |  | Required to build the regen clamp resistor lead
ebay-wire-cutter | Wire cutter | tool | Bay-specific tools |  | electronics-bay | 1 | recommended | https://a.co/d/04pImvE0 | Or similar | 1 | 5.99 | https://www.amazon.com/dp/B0G6JKGQPD | 2026-10-09
ebay-wire-stripper | Wire stripper | tool | Bay-specific tools |  | electronics-bay | 1 | recommended | https://a.co/d/05DNUngu | Or similar | 1 | 12.99 | https://www.amazon.com/dp/B08YDCTHMS | 2026-10-09
ebay-heat-gun | Heat gun | tool | Bay-specific tools |  | electronics-bay | 1 | recommended | https://a.co/d/00PNwYUp | For heat-shrink; or similar | 1 | 24.99 | https://www.amazon.com/dp/B00004TUCV | 2026-10-09
ebay-heatshrink | Heat-shrink assortment / labels | consumable | Wiring |  | electronics-bay | 1 | recommended | https://a.co/d/04p7f5Vs | Heat-shrink tube assortment or heat-shrink labels | 1 | 7.99 | https://www.amazon.com/dp/B01MFA3OFA | 2026-10-09
pbay-pdh | REV Power Distribution Hub (PDH) | component | Distribution — choose one | REV-11-1850 | power-bay | 1 | not for new builds | https://www.revrobotics.com/rev-11-1850/ | NOT for new builds — designed for the 12 V FRC ecosystem and this drive bus is 24 V. Fitted on this robot because it was bought before the bus voltage settled; its CAN telemetry is not enabled. CHOOSE the fuse block instead.
pbay-fuseblock | Fuse block (blade fuses) | component | Distribution — choose one |  | power-bay | 1 |  | https://www.amazon.com/dp/B0FLJV9BDD | RECOMMENDED for the 24 V drive bus. Simple, cheap, correctly rated. CHOOSE this OR the REV PDH. | 1 | 29.99 | https://www.amazon.com/dp/B0FLJV9BDD | 2026-10-09
pbay-dcdc | 24 V 60 A DC/DC converter | component | Power input |  | power-bay | 1 |  |  | Mounted OUTSIDE the bay, feeds in; the bay/bus sits behind the e-stop contactor
pbay-printed | 3D-printed mounting parts | printed | Mounting |  | power-bay | 2 |  |  | Mount EITHER the REV PDH or the fuse block; STLs in hardware/ TBD
pbay-crimper | Wire crimper | tool | Wiring tools |  | power-bay | 1 | recommended | https://a.co/d/0dhX4RmB | For battery connections; also if you crimp instead of WAGO/solder | 1 | 23.99 | https://www.amazon.com/dp/B0978S514B | 2026-10-09
pbay-crimps | Crimp connector assortment (butt joints + ring terminals) | consumable | Wiring |  | power-bay | 1 | recommended | https://a.co/d/08GtC4Ql | Butt joints + ring connectors | 1 | 9.99 | https://www.amazon.com/dp/B086Z2Y1D6 | 2026-10-09
lidar-a1 | Slamtec RPLIDAR A1 | component | Lidar (front + rear) |  | lidar | 2 |  | https://www.adafruit.com/product/4010 | One front, one rear; the A1 typically ships with its USB adapter + cable | 2 | 99.95 | https://www.adafruit.com/product/4010 | 2026-10-09
lidar-daughter | RPLIDAR USB adapter (daughter board) | component | Lidar (front + rear) |  | lidar | 2 |  |  | Comes with the RPLIDAR A1 kit. | 0
lidar-usb | USB cable (A1 to hub) | component | Lidar (front + rear) |  | lidar | 2 |  |  | Usually included with the A1
lidar-mounts | 3D-printed lidar mount set | printed | Lidar (front + rear) |  | lidar | 2 |  |  | One set per unit (front + rear); STLs in hardware/ TBD
lidar-gps | Holybro M9N GPS / compass | component | GPS (front only) |  | lidar | 1 |  | https://docs.holybro.com/gps-and-rtk-system/m8n-m9n-m10-gps/standard-m10-m9n-m8n-gps/overview | FRONT lidar only | 1 | 54.99 | https://holybro.com/products/m9n-gps | 2026-10-09
lidar-gps-mount | 3D-printed GPS mount stack | printed | GPS (front only) |  | lidar | 1 |  |  | FRONT only; stacked parts that raise the M9N above the front lidar; STLs TBD
ureb-stamplc | M5Stack StamPLC controller | component | Controller | K141 | upper-right-electronics-bay | 1 |  | https://www.digikey.com/en/products/detail/m5stack-technology-co-ltd/K141/26459381 | The mobile base's edge controller. Available from many sources; DigiKey (shown) stocks well for US-based teams. | 1 | 42.90 | https://shop.m5stack.com/products/m5stamp-plc-controller-with-m5stamps3 | 2026-10-09
ureb-poe | M5Stack StamPLC PoE module | component | Controller | A165 | upper-right-electronics-bay | 1 |  | https://www.digikey.com/en/products/detail/m5stack-technology-co-ltd/A165/28968801 | Adds PoE Ethernet to the StamPLC — the StamPLC<->Thor transport rides this. Many sources; DigiKey stocks well for US teams. | 1 | 18.50 | https://www.digikey.com/en/products/detail/m5stack-technology-co-ltd/A165/28968801 | 2026-10-09
ureb-stamplc-clip | StamPLC DIN-rail clip (3D-printed) | printed | Mounting |  | upper-right-electronics-bay | 1 |  |  | Clips the StamPLC to the DIN rail; STL in hardware/ TBD.
ureb-wago-kit | WAGO DIN-rail assortment (rail + rail-mount connectors) | consumable | Wiring |  | upper-right-electronics-bay | 1 |  | https://a.co/d/07yKPglw | Includes the DIN rail AND the WAGO connectors — the bay's field-wiring junction. | 1 | 33.99 | https://www.amazon.com/dp/B0FV7YXJ8X | 2026-10-09
mpm-microfit | Micro-Fit 3.0 4-pin cable (Thor DC input) | component | Thor branch | B07Z6BJCVH | mini-power-module | 1 |  | https://a.co/d/06nenwIA | Sold as an ATX 4-pin 12 V cable — the housing fits Thor, the PIN ASSIGNMENT DOES NOT. Verify against Thor's pinout and re-pin before first power-on; do not trust wire colors. | 1 | 6.99 | https://www.amazon.com/dp/B07Z6BJCVH | 2026-10-09
mpm-fuse-5a | ATM (mini) blade fuse, 5 A | consumable | Fuses |  | mini-power-module | 4 |  |  | Positions 1/2/3/6 — StamPLC, E-stop, accessory bus, PRISM. Leave the spare bay unfused until it is used.
mpm-fuse-10a | ATM (mini) blade fuse, 10 A | consumable | Fuses |  | mini-power-module | 1 |  |  | Position 5 — Thor only. Every other branch is 5 A.
mpm-xt30 | XT30 connector pair (PRISM branch) | consumable | Lighting branch |  | mini-power-module | 1 |  |  | Position 6 lands on the PRISM light controller through an XT30; see the wiring board
thor-dualblock | goBILDA 1205-series dual block mount (2-pack) | component | Mounting |  | thor-install | 1 |  | https://www.servocity.com/1205-series-dual-block-mount-1-5-2-pack/ | The 2-pack gives the two dual blocks that clamp the Thor cradle to the rail. | 1 | 6.99 | https://www.servocity.com/1205-series-dual-block-mount-1-5-2-pack/ | 2026-10-09
thor-m4-55 | M4 x 55 mm socket-head screws | fastener | Mounting |  | thor-install | 2 |  | https://www.amazon.com/gp/product/B0DFYK39N6 | Run up through the dual blocks to receive the cradle. The 50-pack bought for the OTOS module covers these two. | 0 | 7.19 | https://www.amazon.com/dp/B0DFYK39N6 | 2026-10-09
thor-cradle | Thor cradle (3D-printed) | printed | Mounting |  | thor-install | 1 |  |  | Holds the Thor to the frame; STL in hardware/ TBD.
sys-thor | NVIDIA Jetson AGX Thor Developer Kit | component | Compute |  | system | 1 |  | https://www.nvidia.com/en-us/autonomous-machines/embedded-systems/jetson-thor/ | The main computer: runs the dashboard, the ROS software and the arms. | 1 | 5499.00 | https://developer.nvidia.com/embedded/faq | 2026-10-09
sys-tablet | Samsung Galaxy Tab A11, 8.7-inch, Wi-Fi (the head and the operator's tablet) | component | Head and operator interface | SM-X133 | system | 1 |  | https://www.samsung.com/latin_en/tablets/galaxy-tab-a/galaxy-tab-a11-gray-64gb-sm-x133nzaagto/ | One tablet does both jobs: on the head's mount it is the face and plays the robot's sound; lifted off, it is the operator's dashboard. It runs the project's kiosk app, whose setup guide is written for this model.
sys-battery | ECO-WORTHY 51.2 V 50 Ah LiFePO4 server-rack battery | component | Power |  | system | 1 |  | https://www.ecoworthy.com/ | 2.56 kWh, 16 cells in series. Its BMS reports charge and voltage to the StamPLC over RS-485. The heaviest single part. | 1 | 399.00 | paid: the listing it was bought from has been withdrawn | 2026-10-09
sys-charger | 48 V LiFePO4 battery charger | component | Power |  | system | 1 |  | https://a.co/d/0aP9q4YX | Set it to 48 V; 8 A is the recommended current. | 1 | 98.00 | https://www.amazon.com/dp/B0G8JYWGBP | 2026-10-09
sys-contactor | GIGAVAC GX11 contactor, 24 V coil | component | Power | GX11CAB | system | 1 |  | https://www.sensata.com/products/gigavac-power-contactors-fuses/gx-contactors-800v/gx-normally-open-contactors | The e-stop contactor: sealed, normally open, with an auxiliary contact the StamPLC reads to detect a weld. | 1 | 194.91 | https://www.digikey.com/en/products/detail/sensata-gigavac-clean-energy/GX11CAB/17867704 | 2026-10-09
sys-rc | RadioLink T8S transmitter + R8EF receiver | component | Control |  | system | 1 |  | https://a.co/d/0cFzagC4 | Manual control; the receiver talks SBUS to the StamPLC. | 1 | 51.99 | https://www.amazon.com/dp/B09BTSJN7P | 2026-10-09
sys-lift | DIHOOL electric scissor lift table, 130 lb, 3.95–14.76 in travel | component | Z-axis |  | system | 1 |  | https://www.amazon.com/dp/B0F7H1C4DJ | Comes with its own up/down controller; the StamPLC presses its buttons through two relays. | 1 | 168.88 | https://www.amazon.com/dp/B0F7H1C4DJ | 2026-10-09
sys-lift-tof | M5Stack ToF4M unit (VL53L1X) | component | Z-axis |  | system | 1 |  | https://docs.m5stack.com/en/unit/Unit-ToF4M | Measures the lift's height for the pinch guard. | 1 | 8.95 | https://shop.m5stack.com/products/time-of-flight-distance-unit-vl53l1x | 2026-10-09
sys-openarm | OpenArm bimanual arm set (two 7-DOF arms with grippers) | component | Arms |  | system | 1 |  | https://shop.wowrobo.com/products/openarm-open-source-humanoid-robot-arm-by-enactic | Left and right, from OpenArm's certified seller. Each arm has its own CAN-FD bus. The robot uses the follower set; leader arms are a separate set. | 1 | 5400.00 | https://shop.wowrobo.com/products/openarm-open-source-humanoid-robot-arm-by-enactic | 2026-10-09
sys-pcan | Pibiger USB to dual-channel CAN FD converter | component | Arms | SavvyCAN-FD-X2 | system | 1 |  | https://www.amazon.com/dp/B0CGPRPZN8 | Two CAN-FD channels, one per arm: up to 12 Mbit/s, isolated from USB to 2.5 kV. | 1 | 139.00 | https://www.amazon.com/dp/B0CGPRPZN8 | 2026-10-20
sys-router | MikroTik hAP ac3 router | component | Network |  | system | 1 |  | https://mikrotik.com/product/hap_ac3 | The robot's own network: the computer, the StamPLC, the head and the tablet. | 1 | 109.00 | https://mikrotik.com/product/hap_ac3 | 2026-10-09
sys-camera | RealSense D415 depth camera | component | Sensing |  | system | 1 | optional | https://www.realsenseai.com/products/stereo-depth-camera-d415/ | Optional. A depth camera for the head; the face tracker uses it. The Orbbec Femto Bolt is an alternative. | 1 | 325.00 | https://store.realsenseai.com/buy-realsense-depth-camera-d415.html | 2026-10-09
sys-camera-femto | Orbbec Femto Bolt depth camera | component | Camera | 100100433 | depth-camera | 1 | optional | https://store.orbbec.com/products/femto-bolt | Optional. A time-of-flight depth camera; an alternative to the RealSense D415. | 1 | 418.00 | https://store.orbbec.com/products/femto-bolt | 2026-10-20
stage-pi5 | Raspberry Pi 5, 4 GB | component | Stage display box |  | stage-display | 1 | optional | https://www.raspberrypi.com/products/raspberry-pi-5/ | Optional, for shows. The box's computer. 4 GB is plenty. A Raspberry Pi 4 runs the same image and makes a good spare.
stage-psu | Raspberry Pi 27 W USB-C power supply | component | Stage display box |  | stage-display | 1 | optional | https://www.raspberrypi.com/products/27w-power-supply/ | Optional, for shows. The official supply for the Pi 5; a weaker one shows as an under-voltage warning on the stage page. A Pi 4 takes the official 15 W one.
stage-cooler | Raspberry Pi Active Cooler (for Pi 5) | component | Stage display box |  | stage-display | 1 | optional | https://www.raspberrypi.com/products/active-cooler/ | Optional, for shows. Clips onto the Pi 5.
stage-microsd | High-endurance microSD card, 32 GB or more | component | Stage display box |  | stage-display | 1 | optional | https://www.sandisk.com/products/memory-cards/microsd-cards/sandisk-high-endurance-uhs-i-microsd | Optional, for shows. Holds the system, which runs read-only. A high-endurance card is made for constant use.
stage-hdmi | Micro-HDMI to HDMI cable, short | component | Stage display box |  | stage-display | 1 | optional | https://www.raspberrypi.com/products/micro-hdmi-to-standard-hdmi-a-cable/ | Optional, for shows. The Pi's HDMI ports are micro-HDMI. Use HDMI 0, the port nearest the USB-C power.
stage-usb-stick | USB 3 flash drive, 32 GB or more | component | Stage display box |  | stage-display | 1 | optional |  | Optional, for shows. The box's own copies of the show videos, so a show plays without Wi-Fi. The setup erases it. Plug it into a blue (USB 3) port.
stage-audio | Sabrent USB external stereo sound adapter | component | Stage display box | AU-MMSA | stage-display | 1 | optional | https://sabrent.com/products/au-mmsa | Optional, for shows. Any class-compliant USB audio adapter works. Sends the show's music to a powered speaker instead of the screen.
stage-aux | 3.5 mm stereo audio cable | component | Stage display box |  | stage-display | 1 | optional |  | Optional, for shows. From the USB audio adapter to a powered speaker's aux input.
stage-isolator | 3.5 mm ground-loop isolator | component | Stage display box |  | stage-display | 1 | optional |  | Optional, for shows. Only if the speaker hums. Fits inline on the audio cable.
femto-mount | Femto Bolt mount, 30° or straight (3D-printed) | printed | Mount |  | depth-camera | 1 | optional |  | A sleeve around the camera with two legs that drop into the face holder's pockets. The 30° mount tilts the camera down and is the default; the straight one holds it square. PLA or PETG, 15% infill; STL and 3MF in hardware/ TBD.
femto-mount-m4 | M4 x 16 mm bolt with a nut or threaded insert | fastener | Mount |  | depth-camera | 2 | optional |  | One through each pocket of the face holder and the leg inside it (4.3 mm hole). A pin that stops the leg sliding out; the pocket's fit holds the mount.
femto-retain | Camera retaining screw (size TBD) | fastener | Mount |  | depth-camera | 4 | optional |  | Through the small holes in the sleeve's side walls, two a side, to hold the camera in. Size and length to be confirmed.
