UW-Allen-School-Robotics/opendubs/docs/assets/build/power-bay/05a-level-shifter-parts.webp

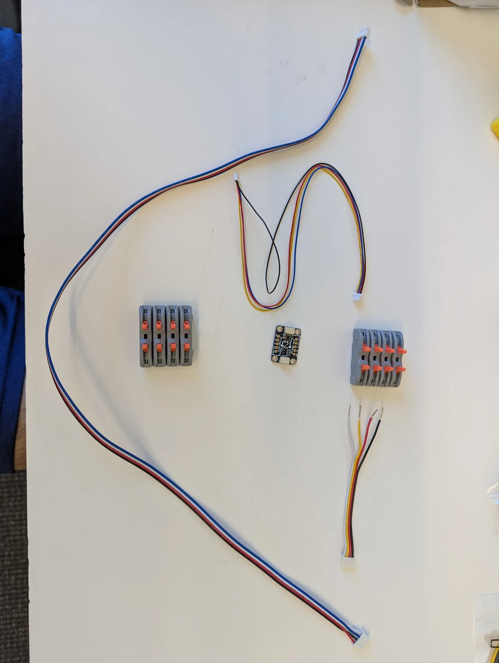
docs/assets/build/power-bay/05a-level-shifter-parts.webp
