UW-Allen-School-Robotics/opendubs/description/openarm/meshes/collision/arm/link4.stl

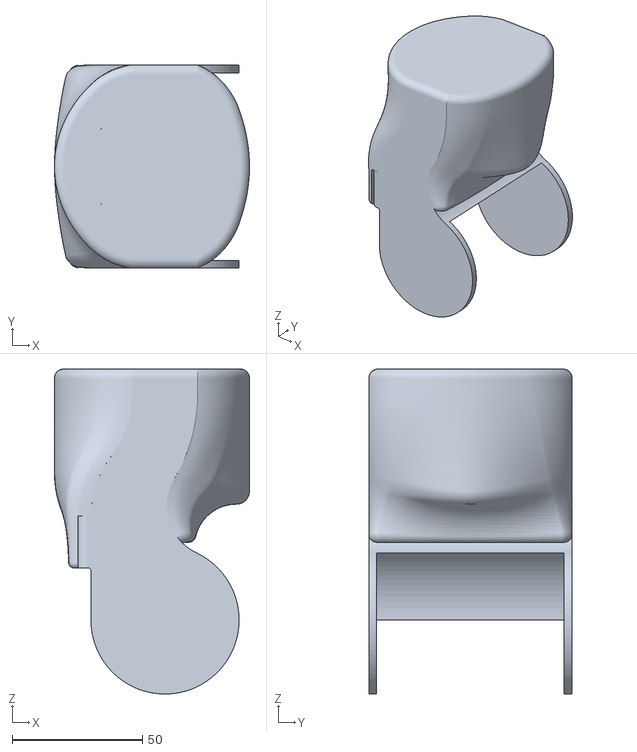
[picture p14: CAD file, 2026-10-04]
description/openarm/meshes/collision/arm/link4.stl
75.0 x 78.2 x 125.0
