UW-Allen-School-Robotics/opendubs/description/openarm/meshes/collision/body/body_link0.stl

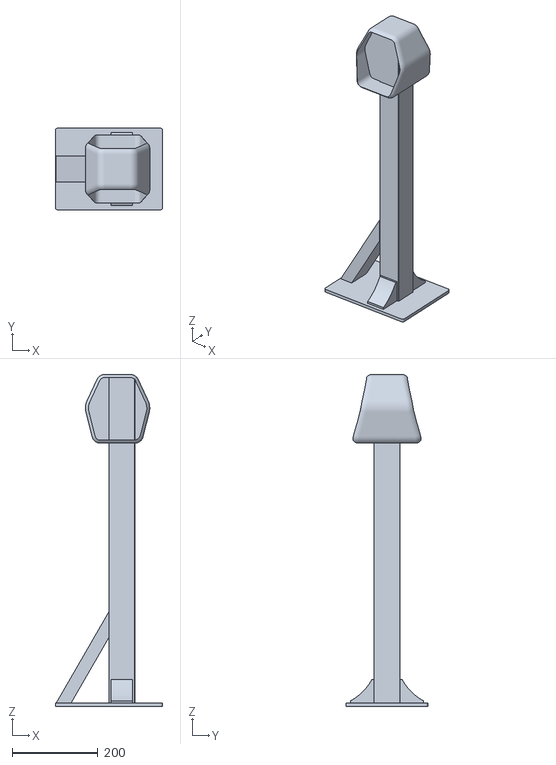
[picture p15: CAD file, 2026-10-04]
description/openarm/meshes/collision/body/body_link0.stl
250.0 x 190.0 x 773.0
