UW-Allen-School-Robotics/opendubs/description/openarm/meshes/collision/gripper/hand.stl

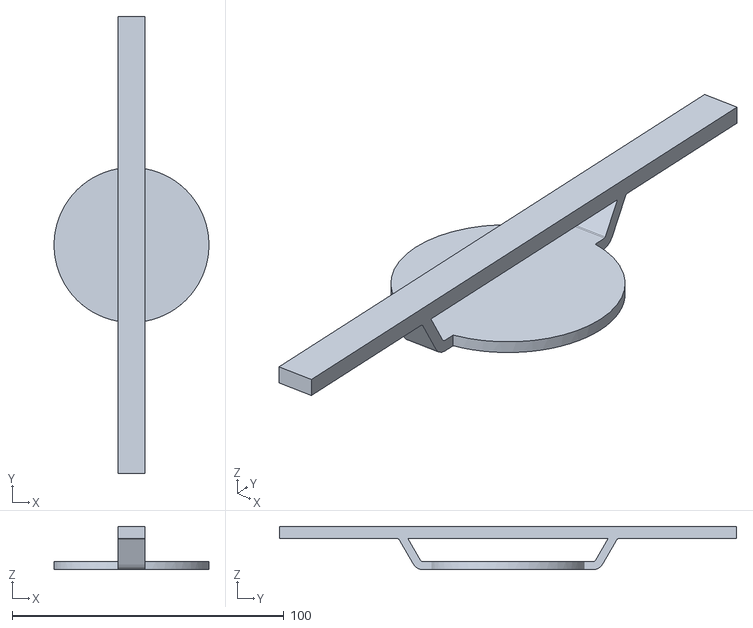
[picture p16: CAD file, 2026-10-08]
description/openarm/meshes/collision/gripper/hand.stl
57.0 x 168.1 x 16.0
