UW-Allen-School-Robotics/opendubs/description/openarm/meshes/visual/arm/link4_2.obj

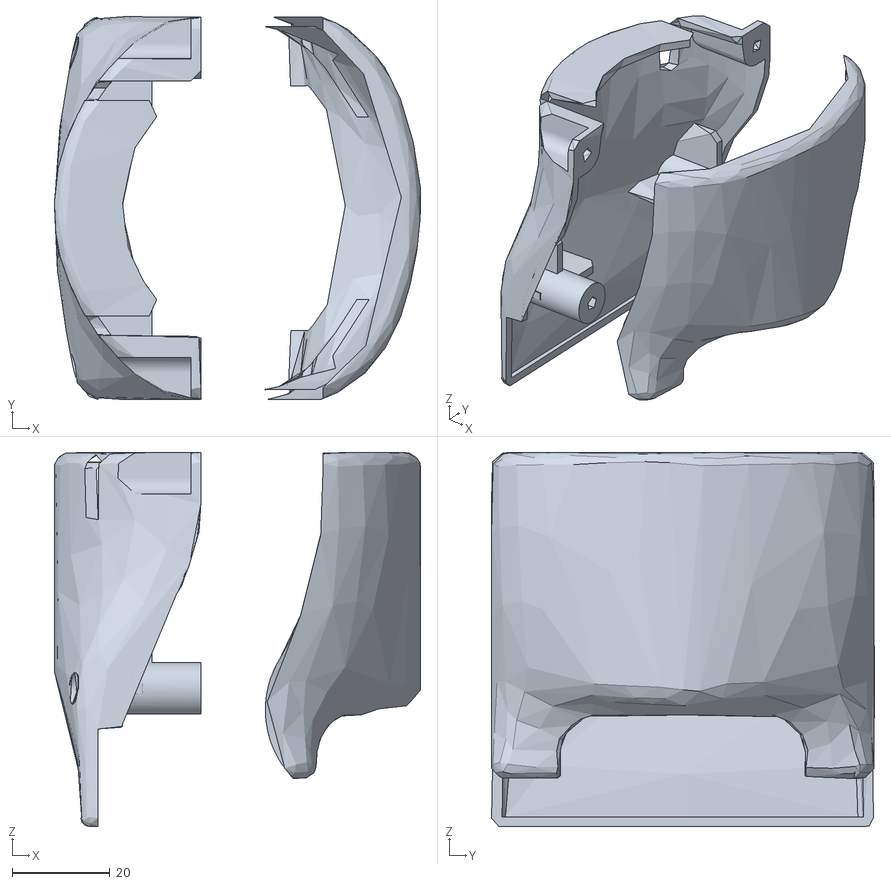
[picture p17: CAD file, 2026-10-08]
description/openarm/meshes/visual/arm/link4_2.obj
74.8 x 78.3 x 76.5
