UW-Allen-School-Robotics/opendubs/description/openarm/meshes/visual/body/body_link0_5.obj

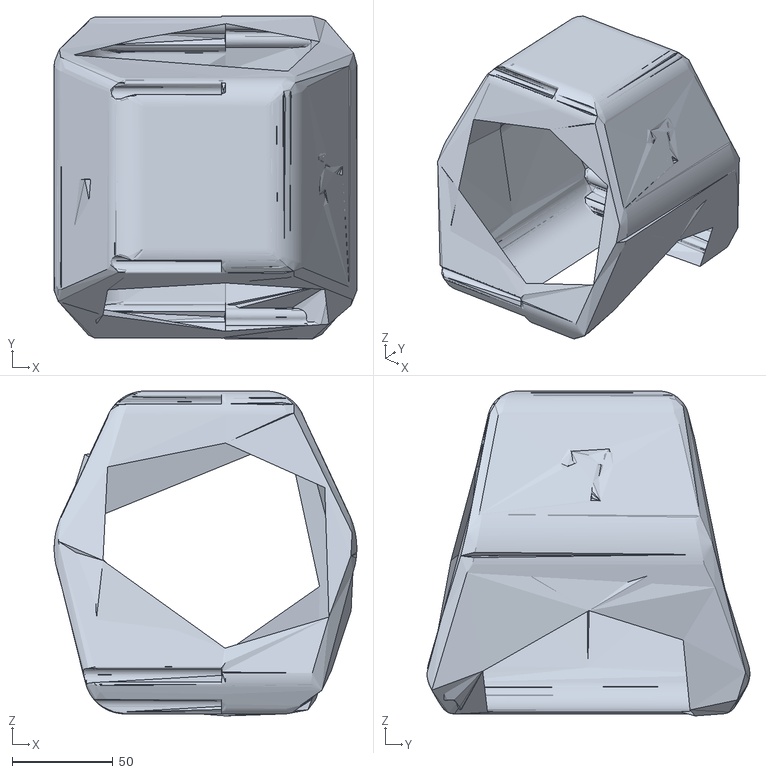
[picture p18: CAD file, 2026-10-08]
description/openarm/meshes/visual/body/body_link0_5.obj
150.0 x 160.1 x 161.0
