UW-Allen-School-Robotics/opendubs/description/openarm/meshes/visual/gripper/finger_1.obj

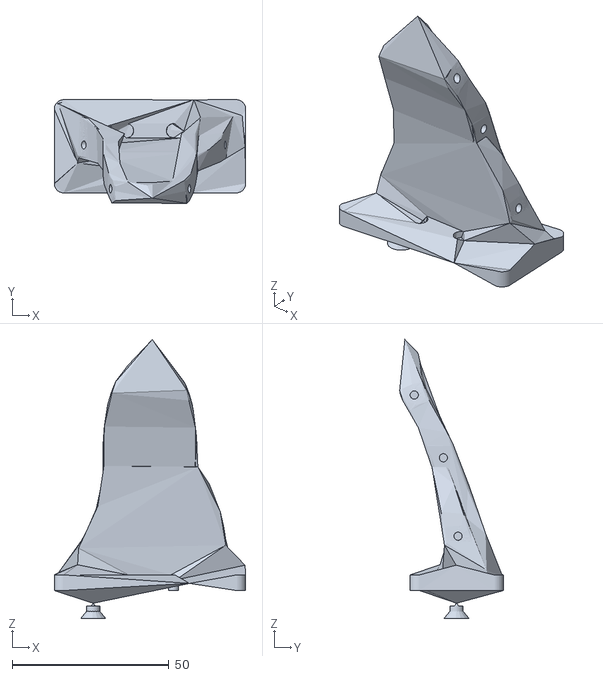
[picture p19: CAD file, 2026-10-08]
description/openarm/meshes/visual/gripper/finger_1.obj
61.0 x 33.0 x 88.9
