UW-Allen-School-Robotics/opendubs/description/opendubs/meshes/femto_mount_tilt30.stl

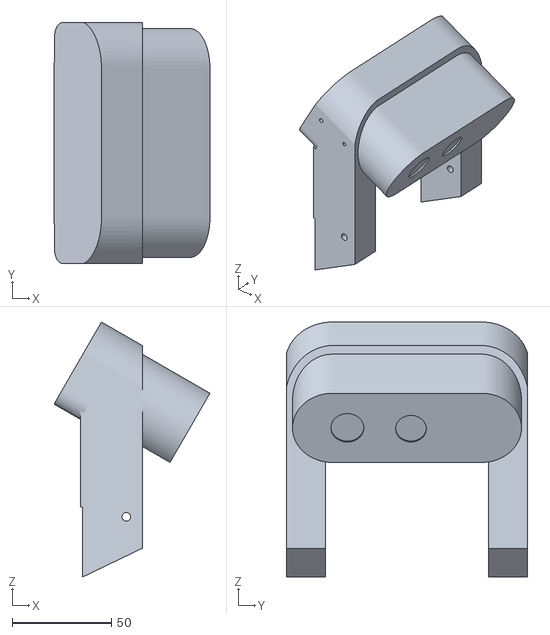
[picture p20: CAD file, 2026-10-28]
description/opendubs/meshes/femto_mount_tilt30.stl
78.4 x 121.1 x 128.3
