UW-Allen-School-Robotics/opendubs/hardware/chest-plate/cad/husky_trace.dxf

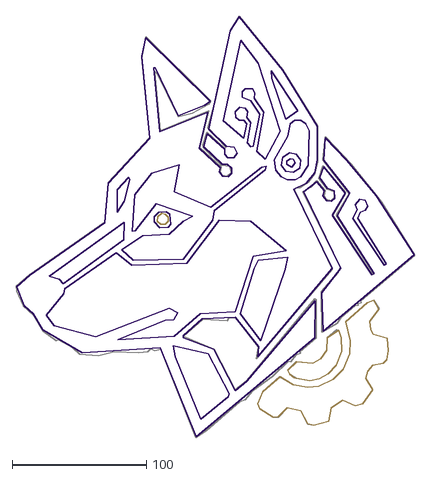
[picture p21: CAD file, 2026-10-16]
hardware/chest-plate/cad/husky_trace.dxf
296.8 x 314.2
