UW-Allen-School-Robotics/opendubs/sim/props/candy_bucket_handle_down.stl

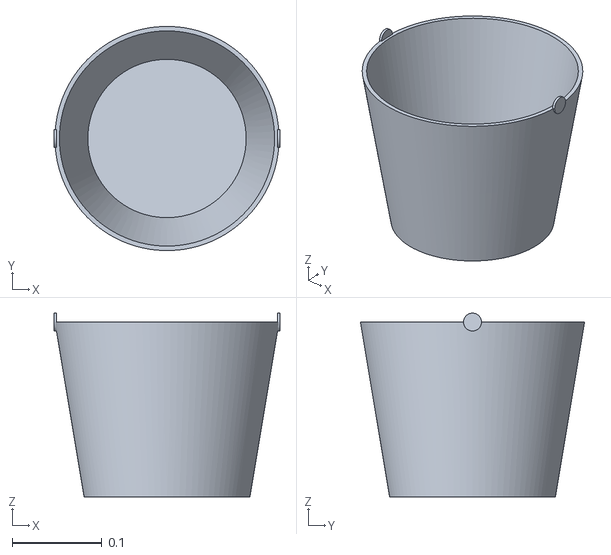
[picture p22: CAD file, 2026-10-29]
sim/props/candy_bucket_handle_down.stl
0.252 x 0.25 x 0.205
