UW-Allen-School-Robotics/opendubs/description/openarm/meshes/collision/arm/link3.stl

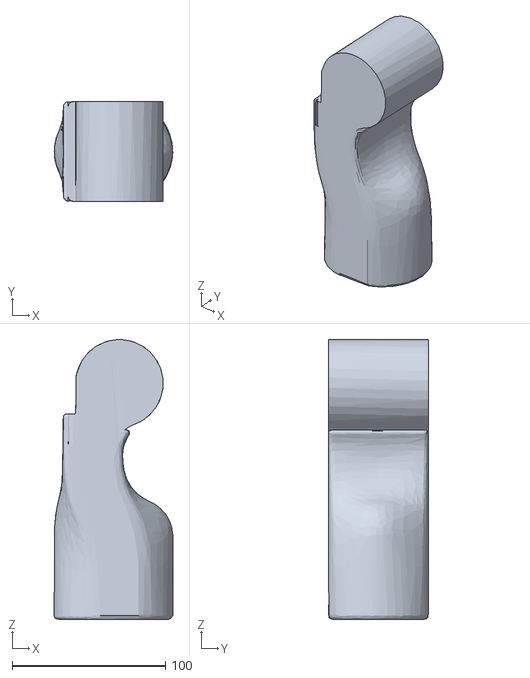
[picture p23: CAD file, 2026-10-04]
description/openarm/meshes/collision/arm/link3.stl
77.3 x 65.0 x 182.6
