UW-Allen-School-Robotics/opendubs/description/openarm/meshes/collision/gripper/finger.stl

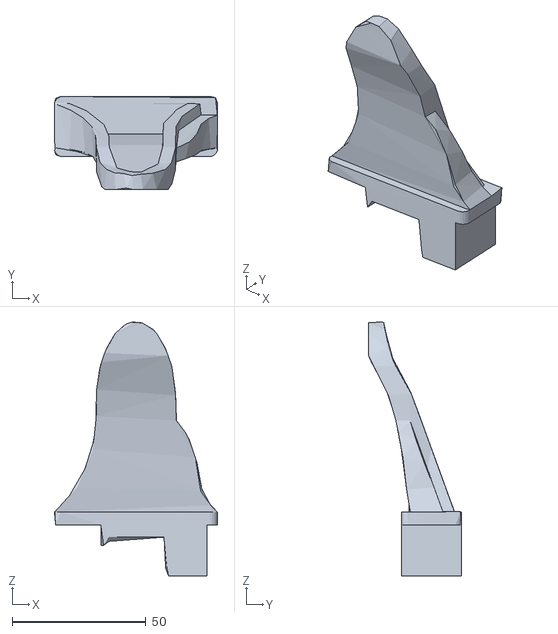
[picture p24: CAD file, 2026-10-04]
description/openarm/meshes/collision/gripper/finger.stl
61.0 x 34.8 x 94.9
