UW-Allen-School-Robotics/opendubs/description/openarm/meshes/visual/arm/link1_0.obj

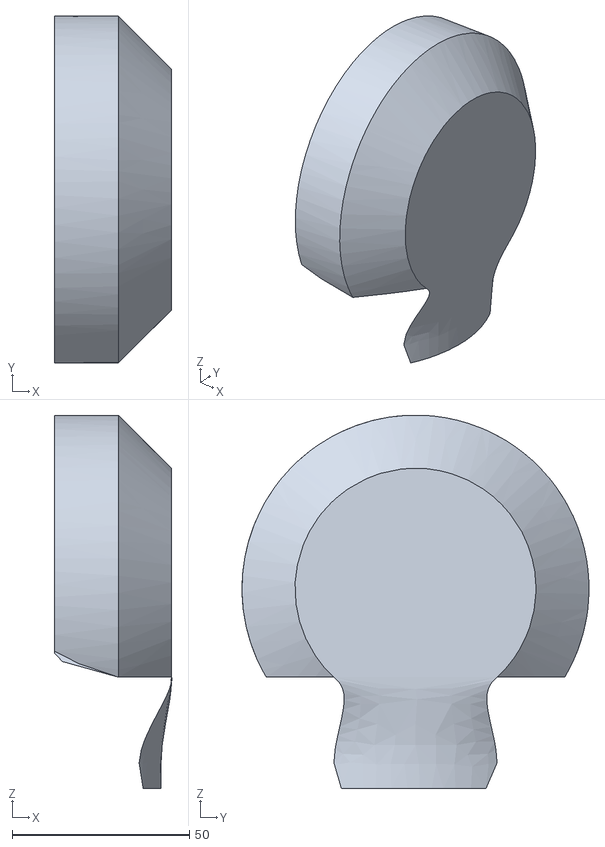
[picture p25: CAD file, 2026-10-08]
description/openarm/meshes/visual/arm/link1_0.obj
33.1 x 98.0 x 105.5
