UW-Allen-School-Robotics/opendubs/description/openarm/meshes/visual/body/body_link0_4.obj

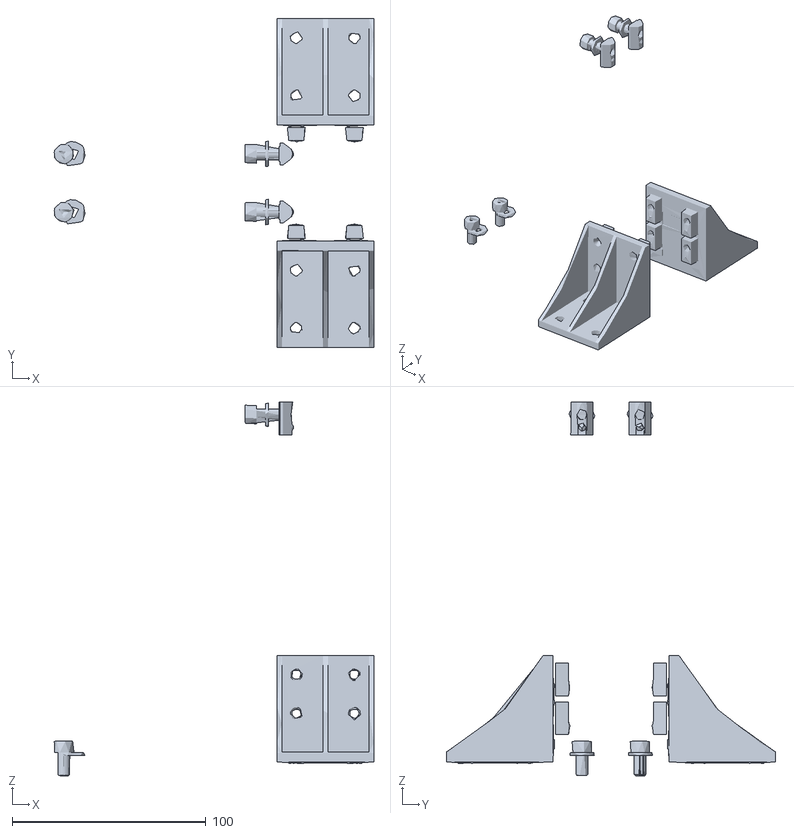
[picture p26: CAD file, 2026-10-08]
description/openarm/meshes/visual/body/body_link0_4.obj
165.0 x 170.0 x 193.1
