UW-Allen-School-Robotics/opendubs/description/openarm/meshes/visual/gripper/hand_1.obj

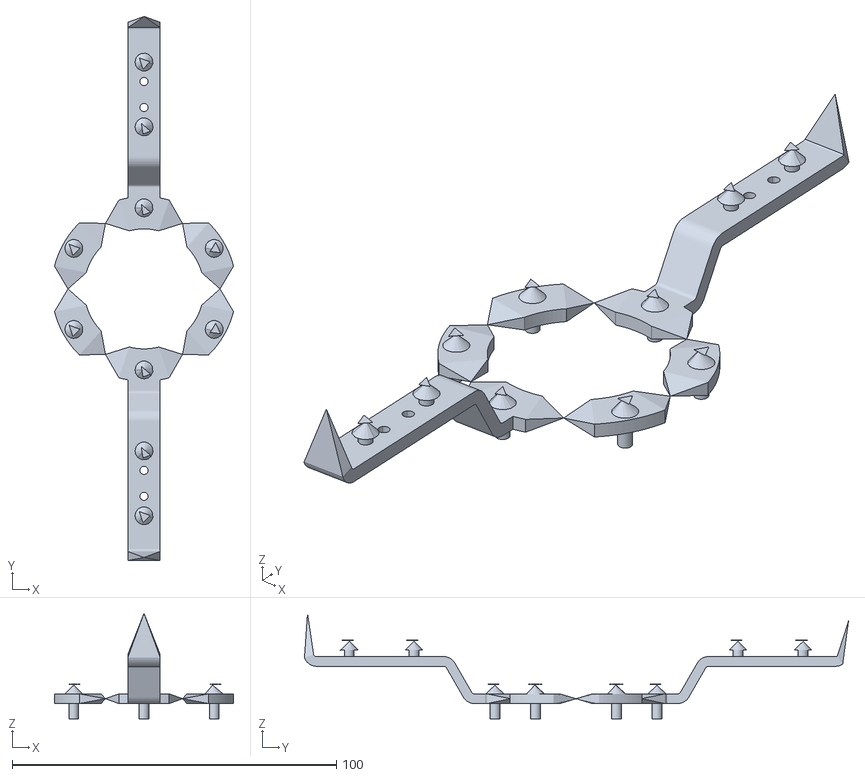
[picture p27: CAD file, 2026-10-08]
description/openarm/meshes/visual/gripper/hand_1.obj
55.2 x 167.9 x 32.6
