UW-Allen-School-Robotics/opendubs/description/opendubs/meshes/chest_cover.stl

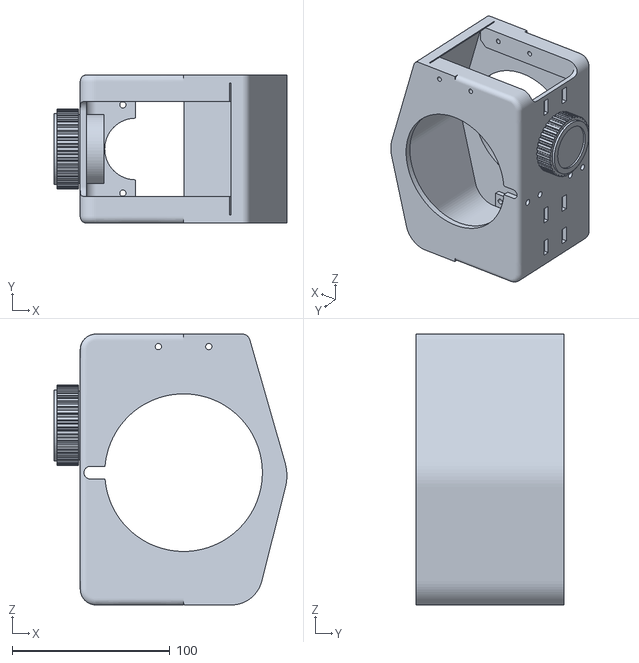
[picture p28: CAD file, 2026-10-28]
description/opendubs/meshes/chest_cover.stl
147.8 x 94.0 x 172.0
