UW-Allen-School-Robotics/opendubs/sim/props/candy_bucket.stl

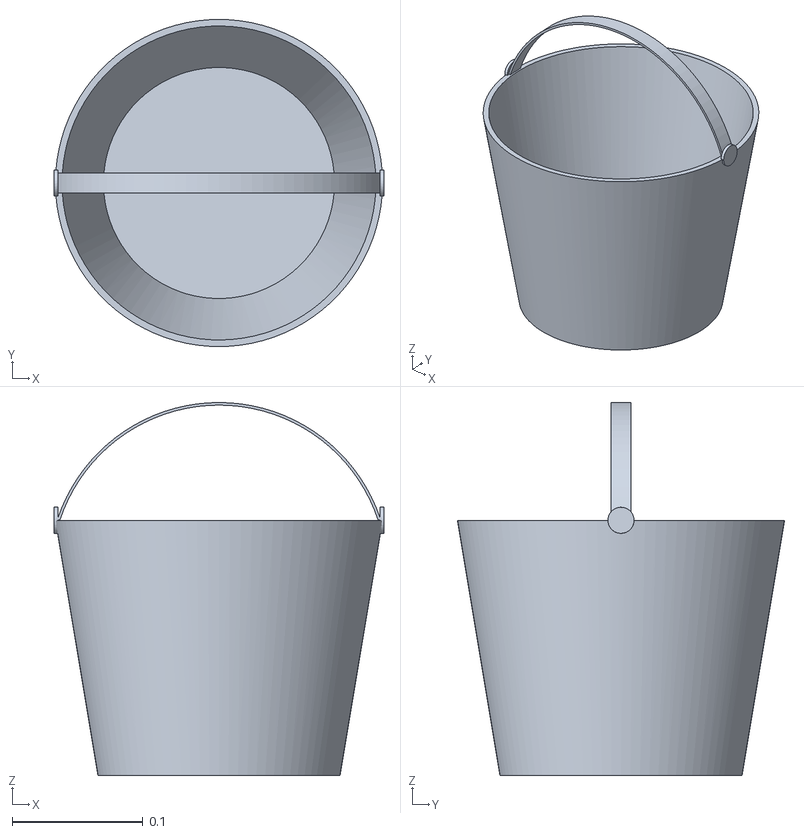
[picture p29: CAD file, 2026-10-28]
sim/props/candy_bucket.stl
0.252 x 0.25 x 0.285
