UW-Allen-School-Robotics/opendubs/description/openarm/meshes/collision/arm/link7.stl

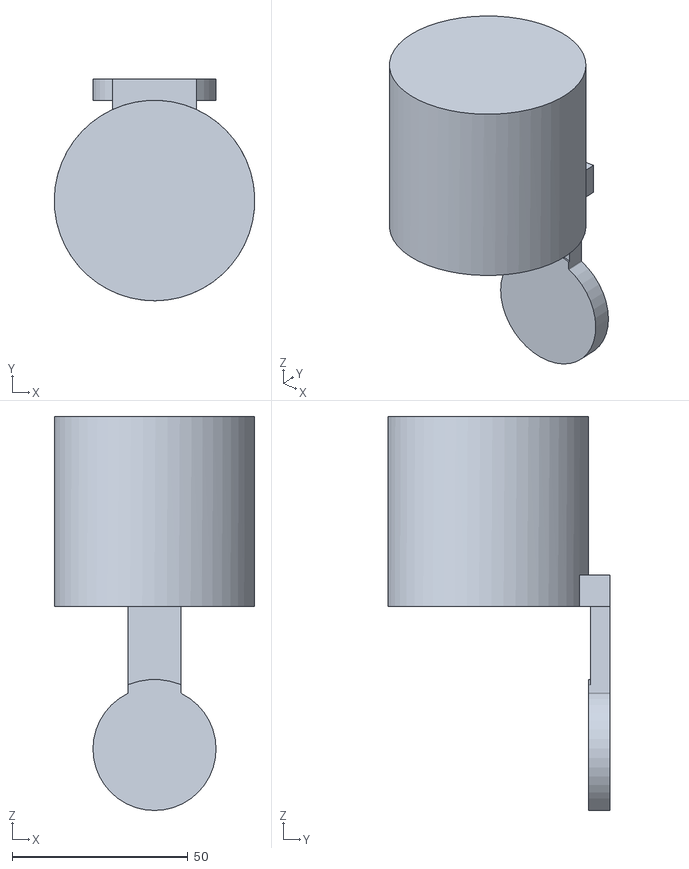
[picture p30: CAD file, 2026-10-04]
description/openarm/meshes/collision/arm/link7.stl
57.0 x 63.0 x 112.0
