UW-Allen-School-Robotics/opendubs/description/openarm/meshes/visual/arm/link4_0.obj

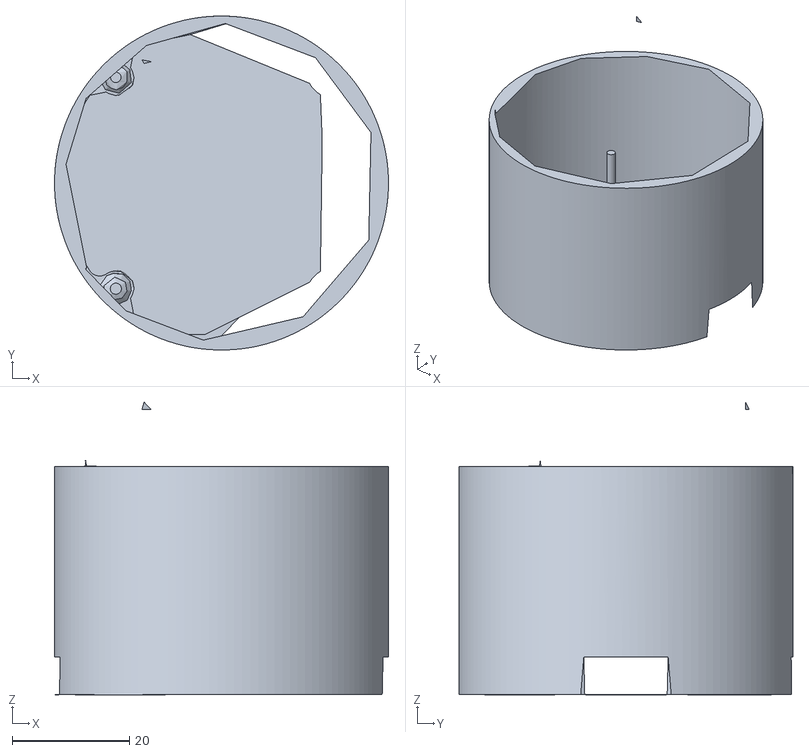
[picture p31: CAD file, 2026-10-08]
description/openarm/meshes/visual/arm/link4_0.obj
57.0 x 57.0 x 50.0
