UW-Allen-School-Robotics/opendubs/description/openarm/meshes/visual/body/body_link0_1.obj

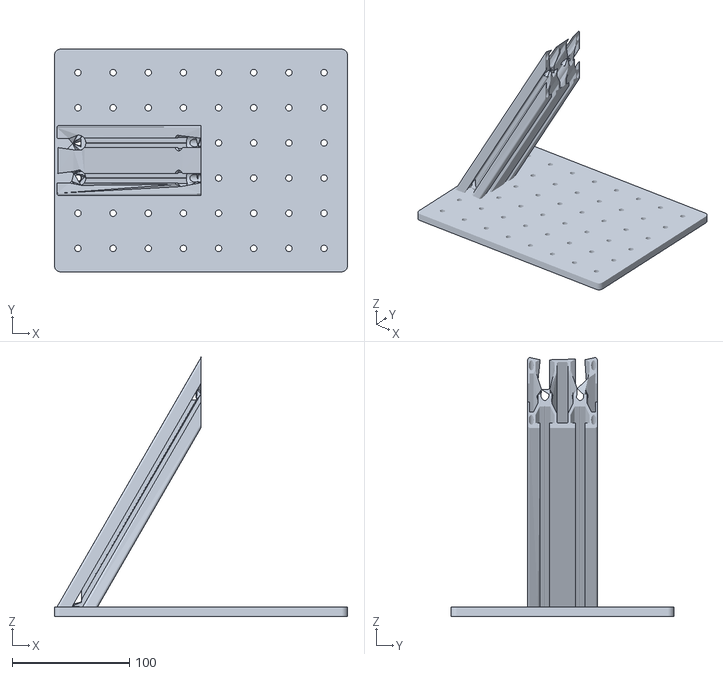
[picture p32: CAD file, 2026-10-08]
description/openarm/meshes/visual/body/body_link0_1.obj
250.0 x 190.0 x 221.0
