UW-Allen-School-Robotics/opendubs/description/openarm/meshes/visual/gripper/finger_0.obj

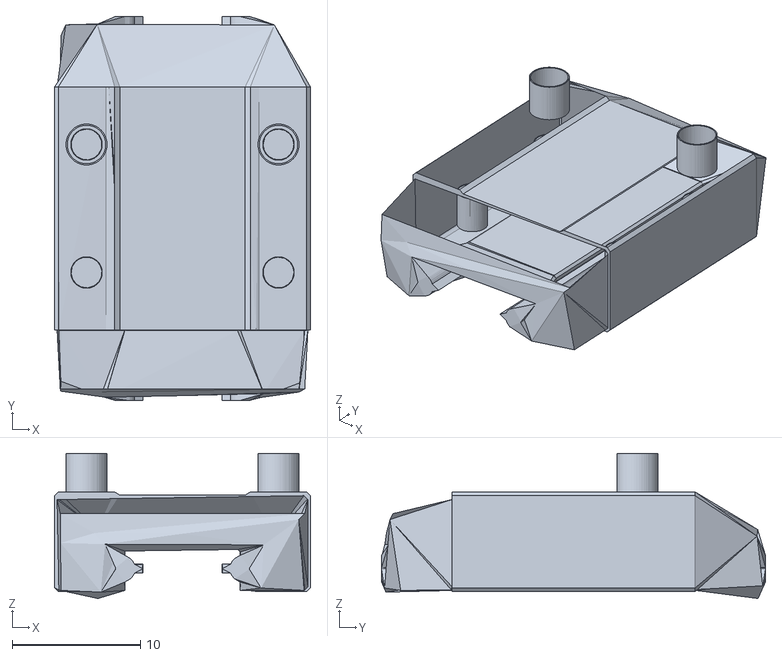
[picture p33: CAD file, 2026-10-08]
description/openarm/meshes/visual/gripper/finger_0.obj
20.0 x 30.0 x 11.3
