UW-Allen-School-Robotics/opendubs/description/openarm/meshes/collision/arm/link5.stl

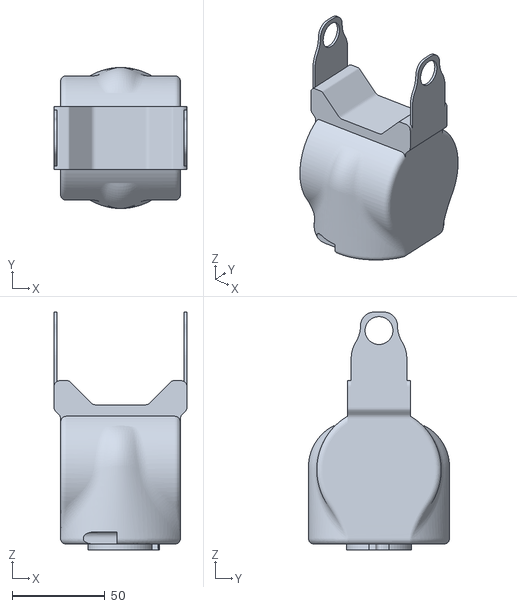
[picture p34: CAD file, 2026-10-04]
description/openarm/meshes/collision/arm/link5.stl
71.6 x 76.0 x 128.2
