UW-Allen-School-Robotics/opendubs/description/openarm/meshes/visual/arm/link3_0.obj

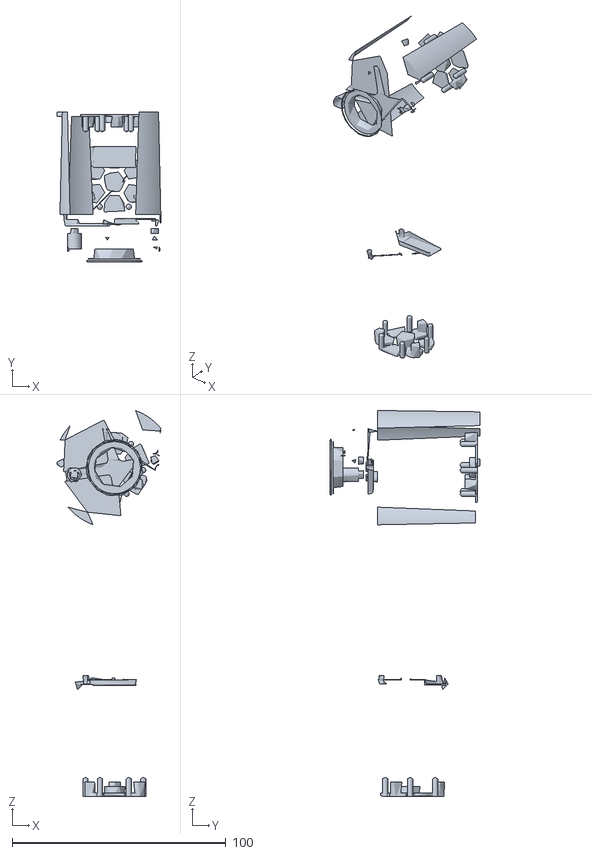
[picture p35: CAD file, 2026-10-08]
description/openarm/meshes/visual/arm/link3_0.obj
48.6 x 69.9 x 180.5
