UW-Allen-School-Robotics/opendubs/description/openarm/meshes/visual/body/body_link0_2.obj

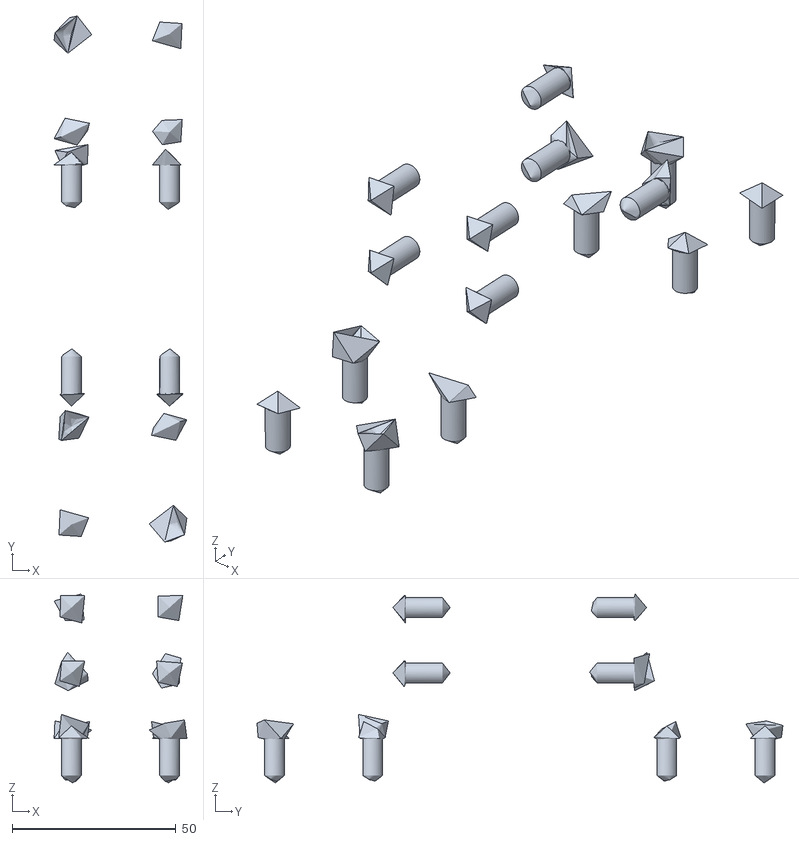
[picture p36: CAD file, 2026-10-08]
description/openarm/meshes/visual/body/body_link0_2.obj
40.6 x 160.8 x 57.8
