UW-Allen-School-Robotics/opendubs/description/openarm/meshes/visual/gripper/hand_0.obj

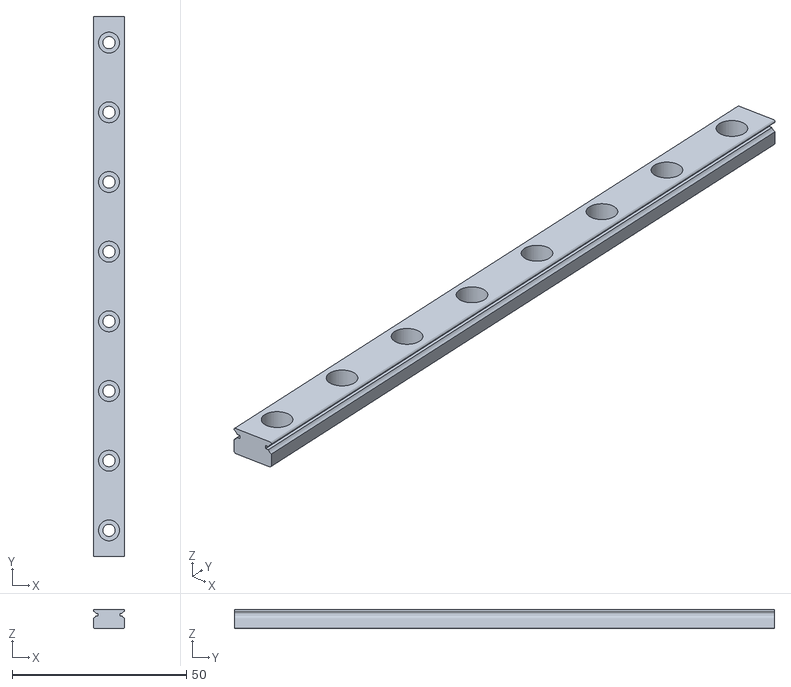
[picture p37: CAD file, 2026-10-08]
description/openarm/meshes/visual/gripper/hand_0.obj
9.00 x 155.0 x 5.50
