UW-Allen-School-Robotics/opendubs/description/opendubs/meshes/femto_mount.stl

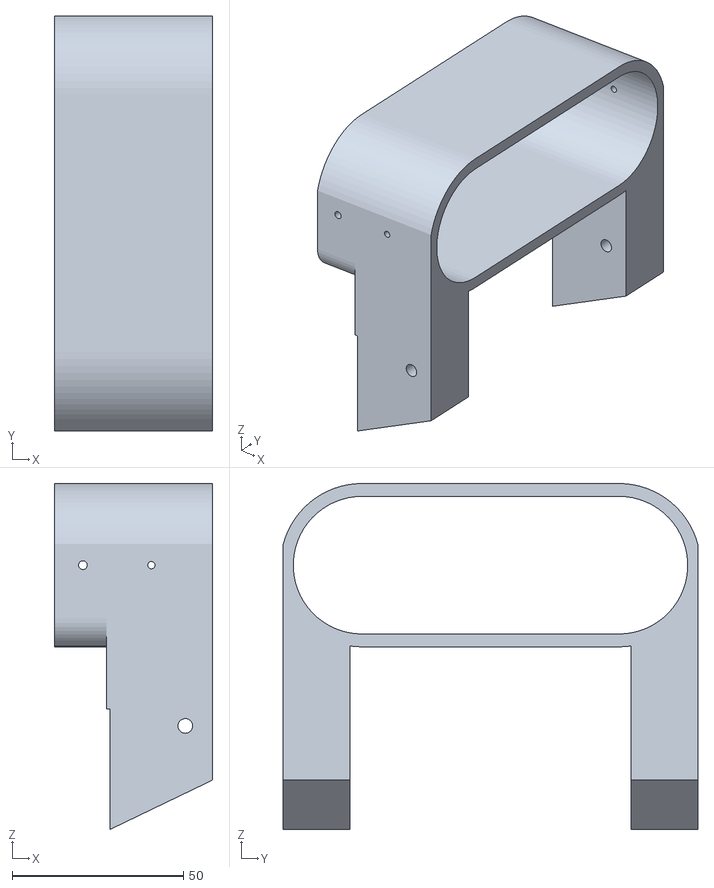
[picture p38: CAD file, 2026-10-23]
description/opendubs/meshes/femto_mount.stl
46.3 x 121.1 x 101.1
