UW-Allen-School-Robotics/opendubs/description/openarm/meshes/collision/arm/link0.stl

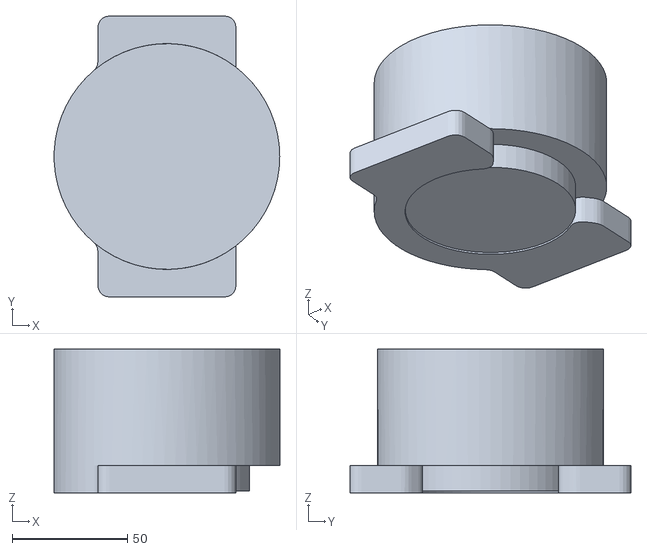
[picture p39: CAD file, 2026-10-04]
description/openarm/meshes/collision/arm/link0.stl
97.9 x 122.0 x 62.5
