UW-Allen-School-Robotics/opendubs/description/openarm/meshes/visual/arm/link7_0.obj

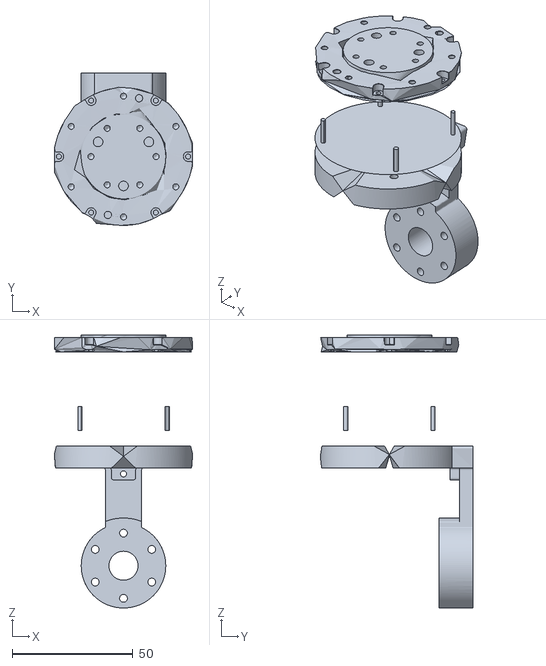
[picture p40: CAD file, 2026-10-08]
description/openarm/meshes/visual/arm/link7_0.obj
57.3 x 63.1 x 113.0
