UW-Allen-School-Robotics/opendubs/description/openarm/meshes/visual/body/body_link0_0.obj

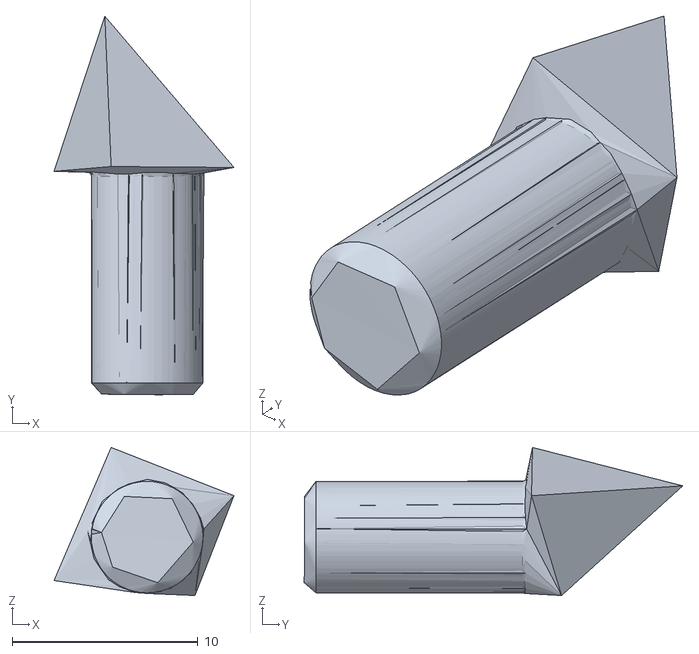
[picture p41: CAD file, 2026-10-08]
description/openarm/meshes/visual/body/body_link0_0.obj
9.70 x 20.4 x 7.98
