UW-Allen-School-Robotics/opendubs/description/opendubs/meshes/head_face_tilt.stl

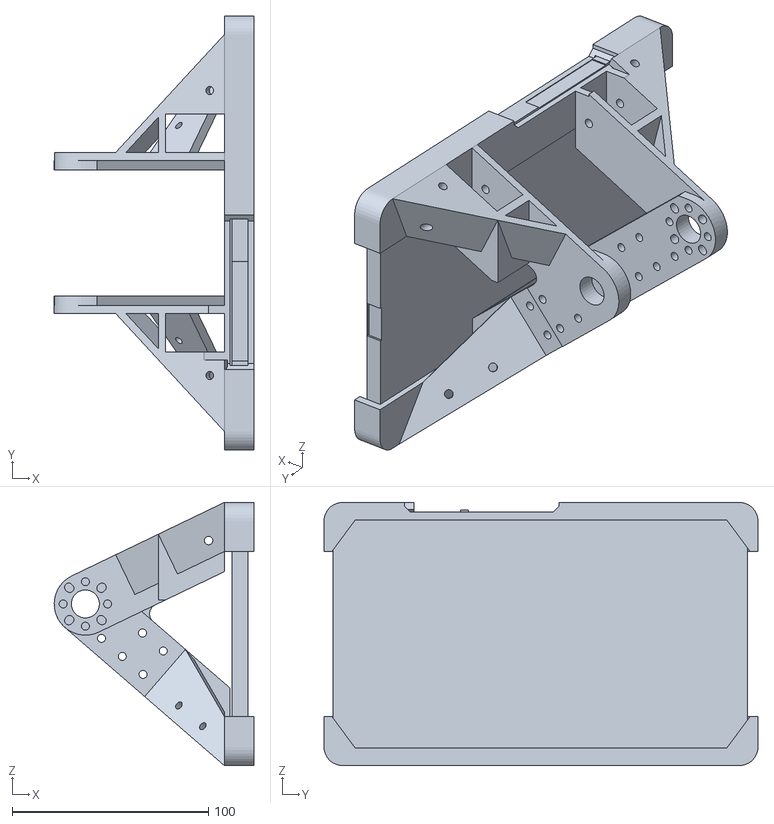
[picture p42: CAD file, 2026-10-23]
description/opendubs/meshes/head_face_tilt.stl
101.6 x 221.0 x 134.0
