UW-Allen-School-Robotics/opendubs/description/openarm/meshes/collision/arm/link6.stl

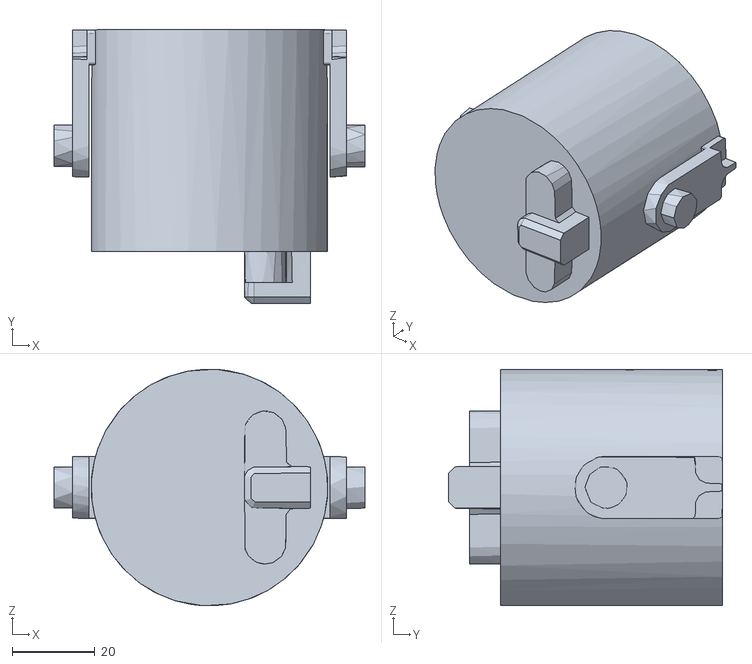
[picture p43: CAD file, 2026-10-04]
description/openarm/meshes/collision/arm/link6.stl
75.0 x 66.0 x 57.0
