UW-Allen-School-Robotics/opendubs/description/openarm/meshes/visual/arm/link0_0.obj

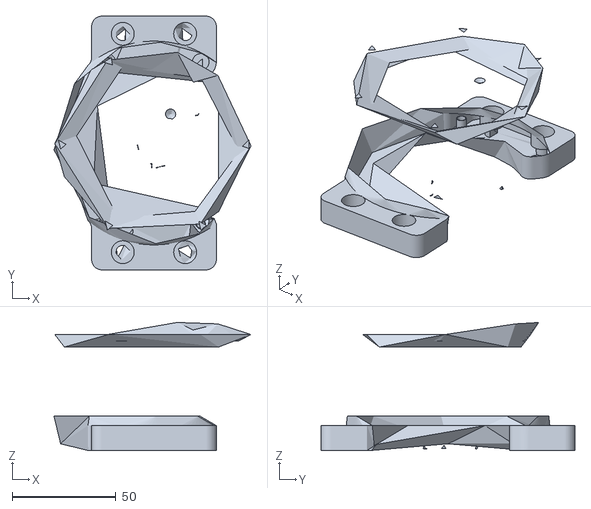
[picture p44: CAD file, 2026-10-08]
description/openarm/meshes/visual/arm/link0_0.obj
94.8 x 122.0 x 61.6
