UW-Allen-School-Robotics/opendubs/description/openarm/meshes/visual/body/body_link0_3.obj

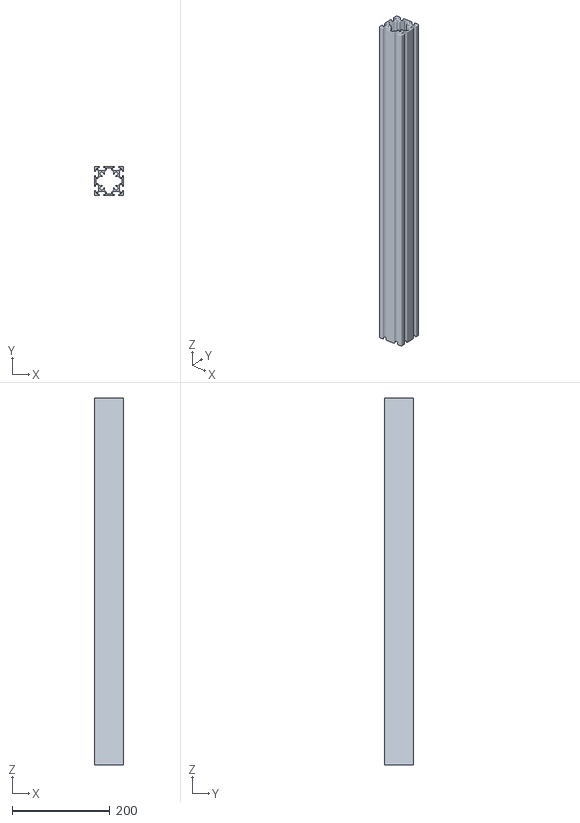
[picture p45: CAD file, 2026-10-08]
description/openarm/meshes/visual/body/body_link0_3.obj
60.0 x 60.0 x 750.0
