UW-Allen-School-Robotics/opendubs/description/opendubs/meshes/head_neck_pan.stl

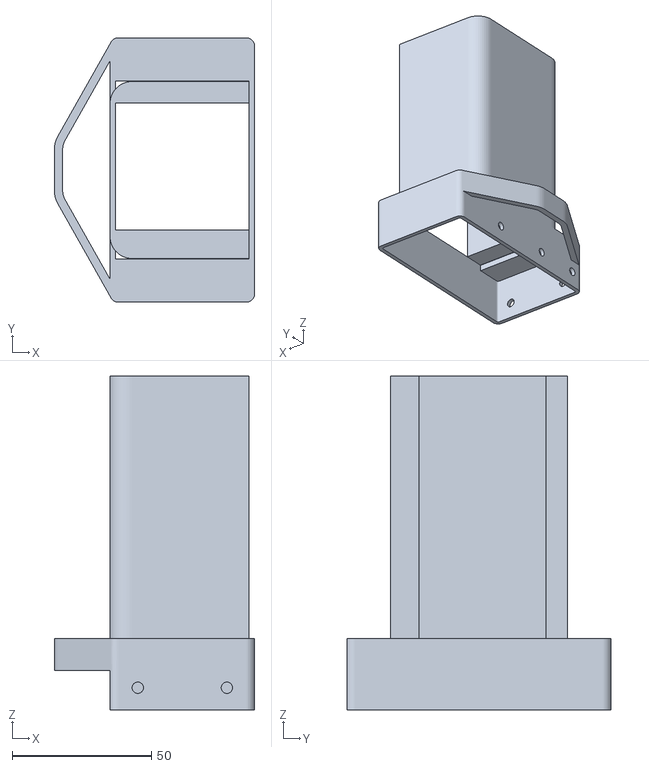
[picture p46: CAD file, 2026-10-23]
description/opendubs/meshes/head_neck_pan.stl
72.0 x 95.0 x 120.0
