UW-Allen-School-Robotics/opendubs/description/openarm/meshes/collision/arm/link1.stl

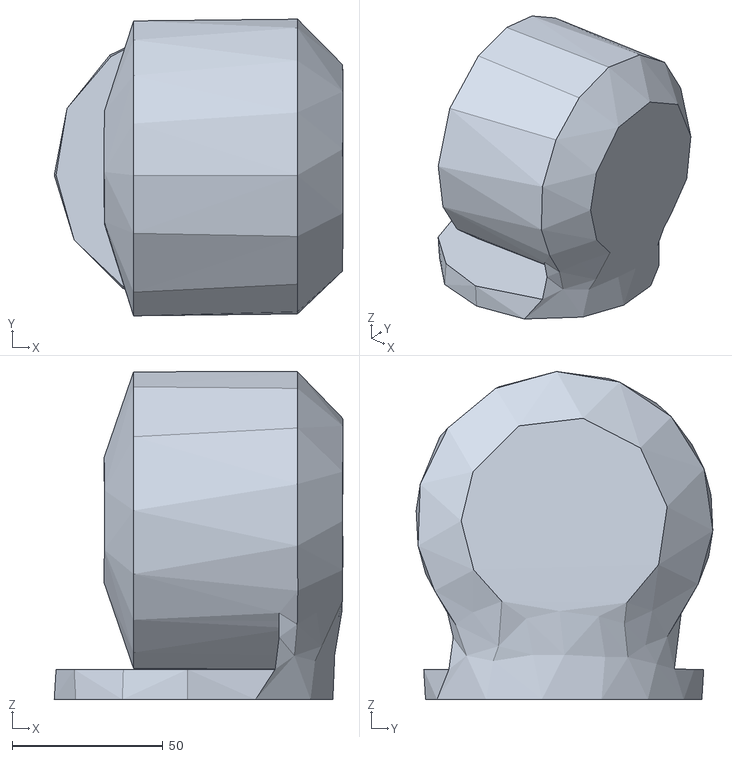
[picture p47: CAD file, 2026-10-04]
description/openarm/meshes/collision/arm/link1.stl
95.7 x 98.4 x 108.8
