UW-Allen-School-Robotics/opendubs/description/openarm/meshes/visual/arm/link2_1.obj

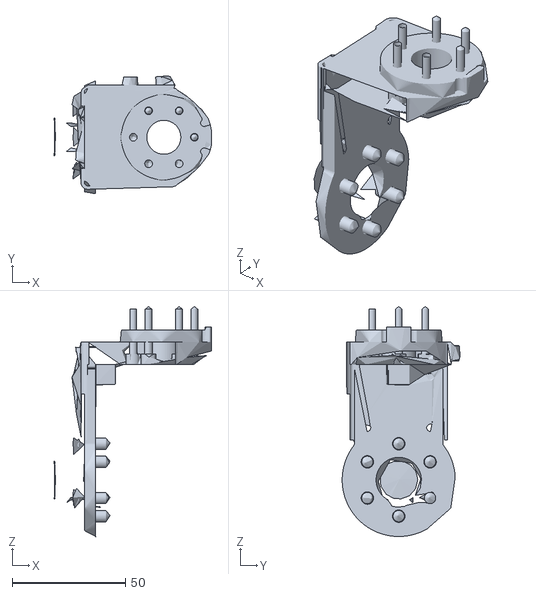
[picture p48: CAD file, 2026-10-08]
description/openarm/meshes/visual/arm/link2_1.obj
69.5 x 52.0 x 101.6
