UW-Allen-School-Robotics/opendubs/description/opendubs/meshes/FR-wheel.stl

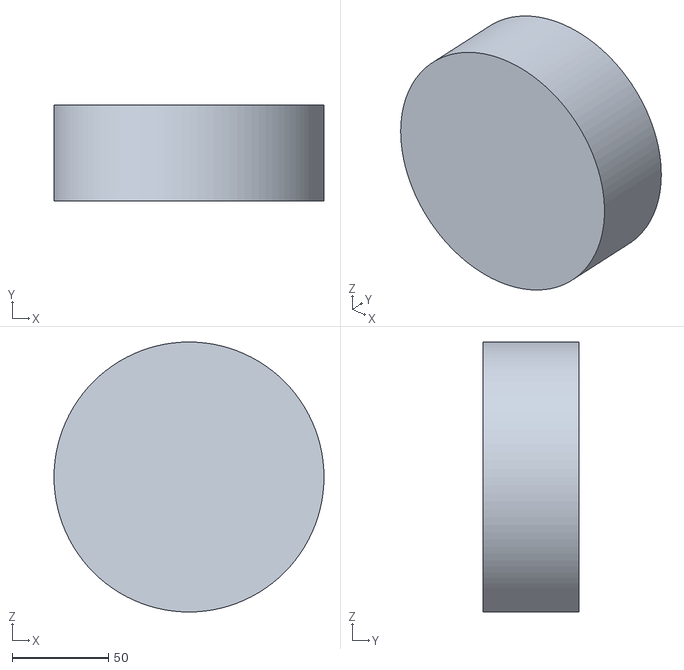
[picture p49: CAD file, 2026-09-23]
description/opendubs/meshes/FR-wheel.stl
140.0 x 50.0 x 140.0
