UW-Allen-School-Robotics/opendubs/description/openarm/meshes/collision/arm/link2.stl

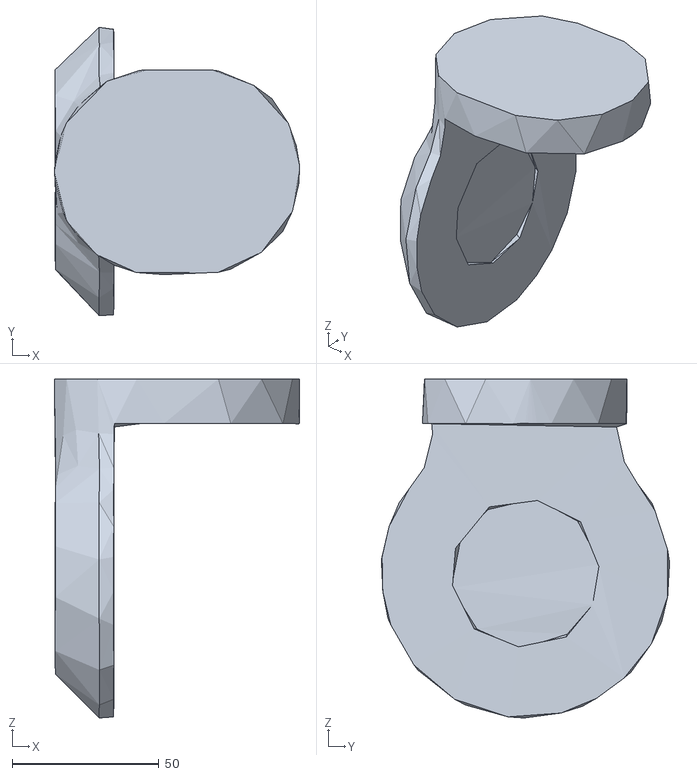
[picture p50: CAD file, 2026-10-04]
description/openarm/meshes/collision/arm/link2.stl
83.7 x 98.3 x 115.6
