UW-Allen-School-Robotics/opendubs/description/openarm/meshes/visual/arm/link3_2.obj

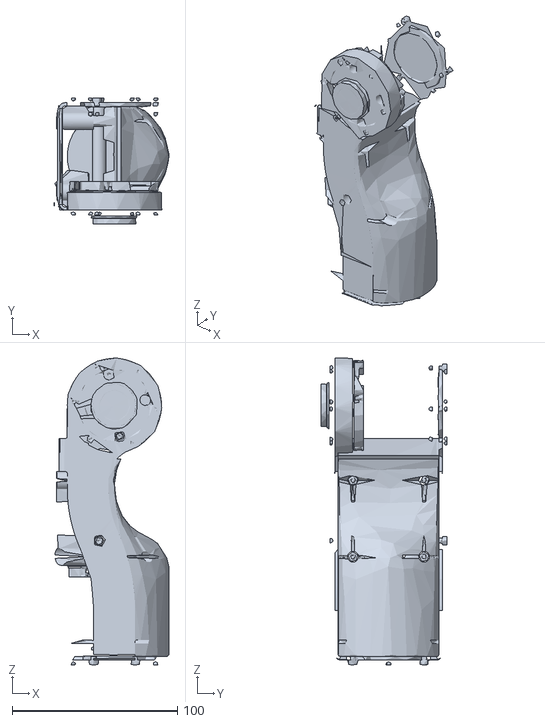
[picture p51: CAD file, 2026-10-08]
description/openarm/meshes/visual/arm/link3_2.obj
69.5 x 76.5 x 185.7
