UW-Allen-School-Robotics/opendubs/description/opendubs/meshes/z-axis-down.stl

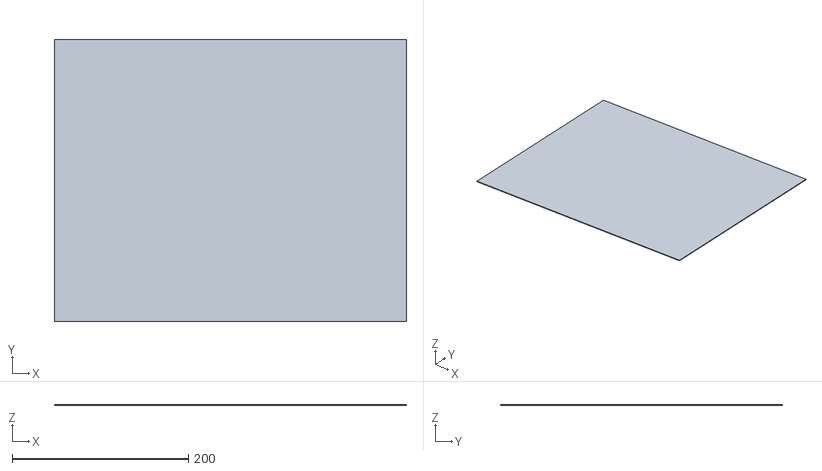
[picture p52: CAD file, 2026-09-23]
description/opendubs/meshes/z-axis-down.stl
400.0 x 320.0 x 1.00
