UW-Allen-School-Robotics/opendubs/description/openarm/meshes/visual/arm/link6_1.obj

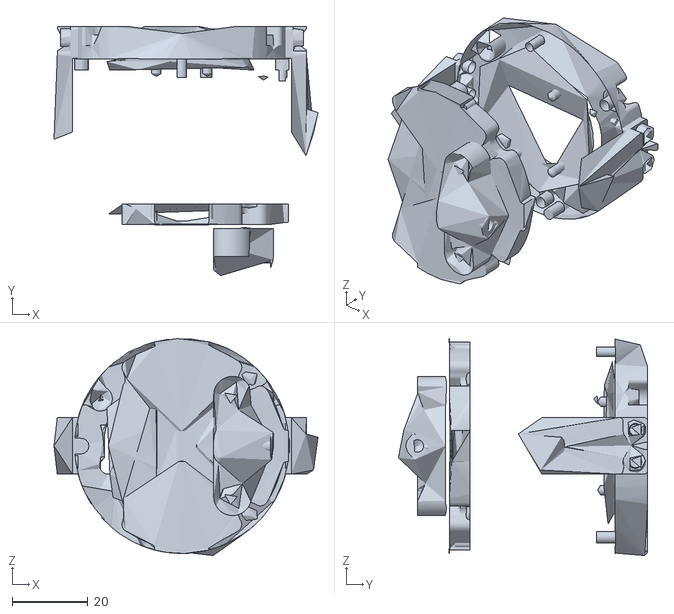
[picture p53: CAD file, 2026-10-08]
description/openarm/meshes/visual/arm/link6_1.obj
69.9 x 66.0 x 57.5
