UW-Allen-School-Robotics/opendubs/description/openarm/meshes/visual/arm/link5_0.obj

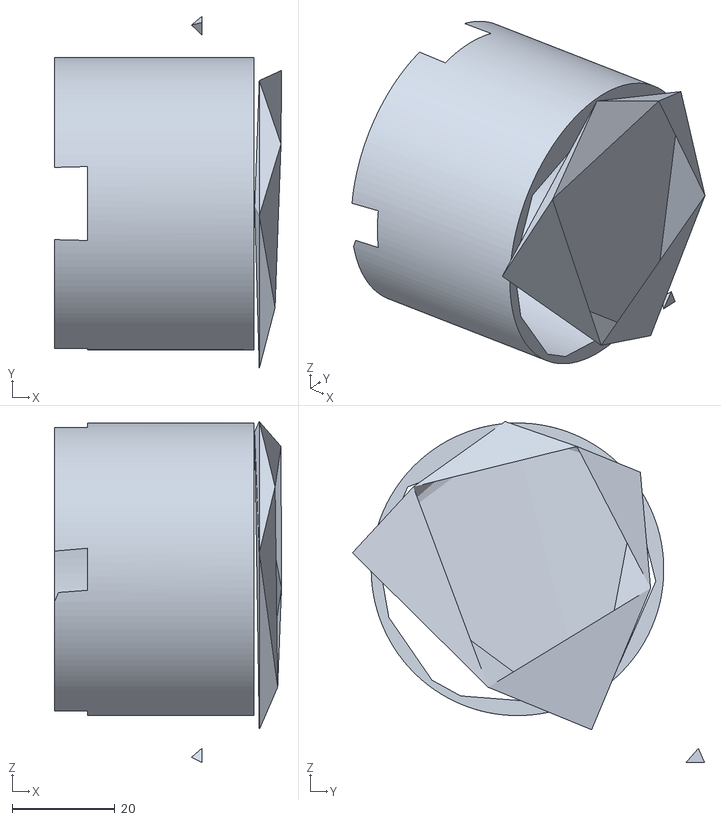
[picture p54: CAD file, 2026-10-08]
description/openarm/meshes/visual/arm/link5_0.obj
44.2 x 68.6 x 66.4
