UW-Allen-School-Robotics/opendubs/description/openarm/meshes/visual/arm/link4_1.obj

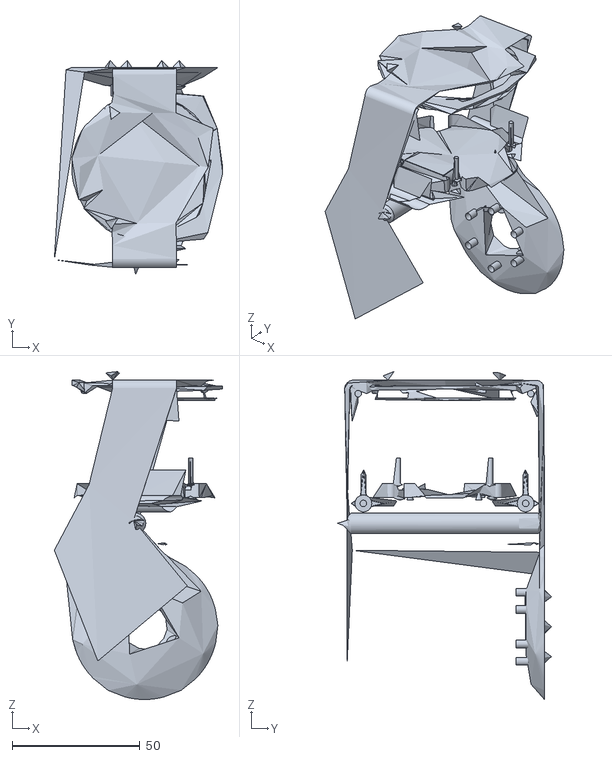
[picture p55: CAD file, 2026-10-08]
description/openarm/meshes/visual/arm/link4_1.obj
65.9 x 83.8 x 128.4
