UW-Allen-School-Robotics/opendubs/description/openarm/meshes/visual/arm/link0_1.obj

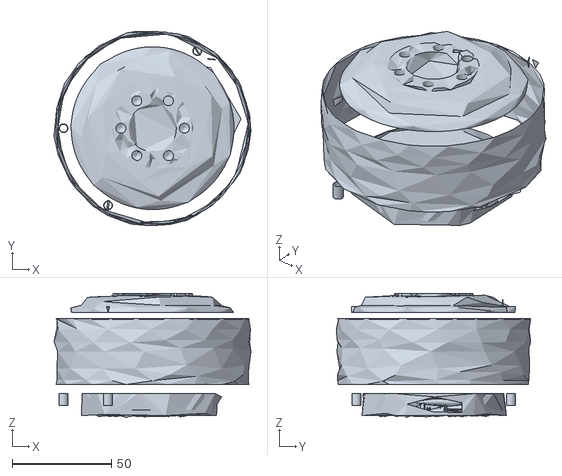
[picture p56: CAD file, 2026-10-08]
description/openarm/meshes/visual/arm/link0_1.obj
99.5 x 98.2 x 62.7
