UW-Allen-School-Robotics/opendubs/description/openarm/meshes/visual/arm/link2_0.obj

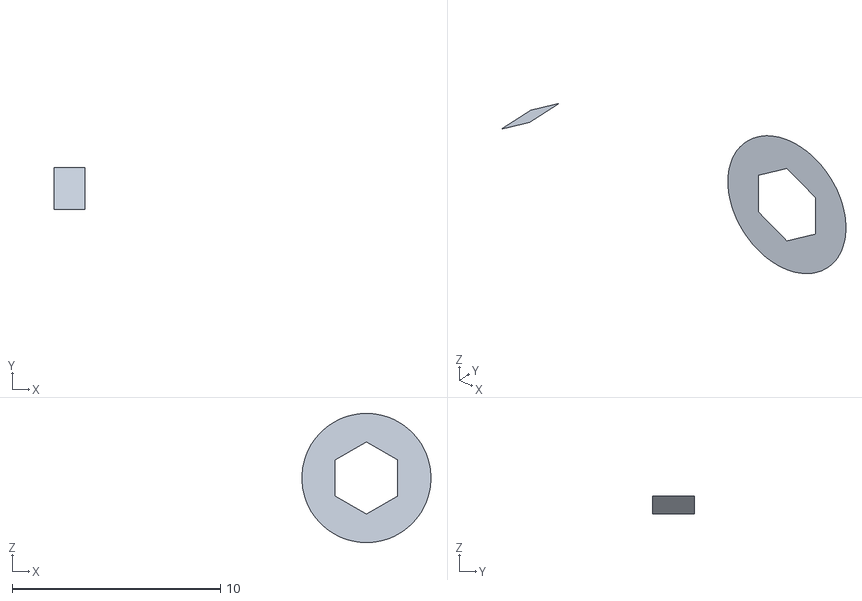
[picture p57: CAD file, 2026-10-08]
description/openarm/meshes/visual/arm/link2_0.obj
18.1 x 2.00 x 6.20
