UW-Allen-School-Robotics/opendubs/description/openarm/meshes/visual/arm/link1_2.obj

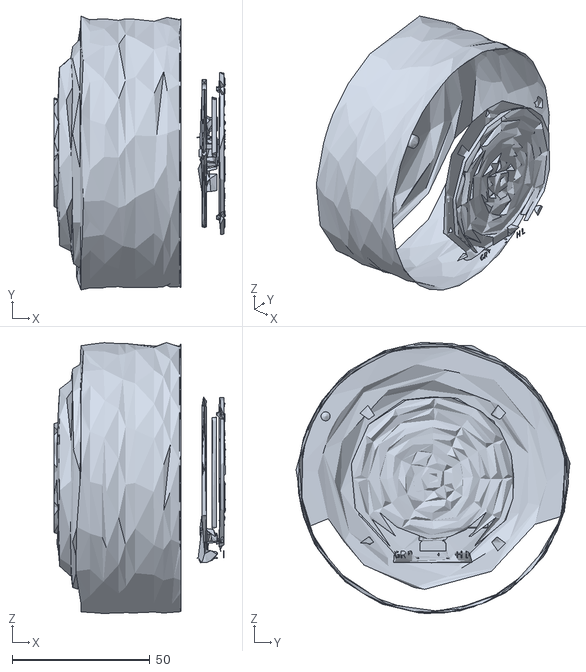
[picture p58: CAD file, 2026-10-08]
description/openarm/meshes/visual/arm/link1_2.obj
62.4 x 99.5 x 98.5
