UW-Allen-School-Robotics/opendubs/description/openarm/meshes/visual/arm/link3_1.obj

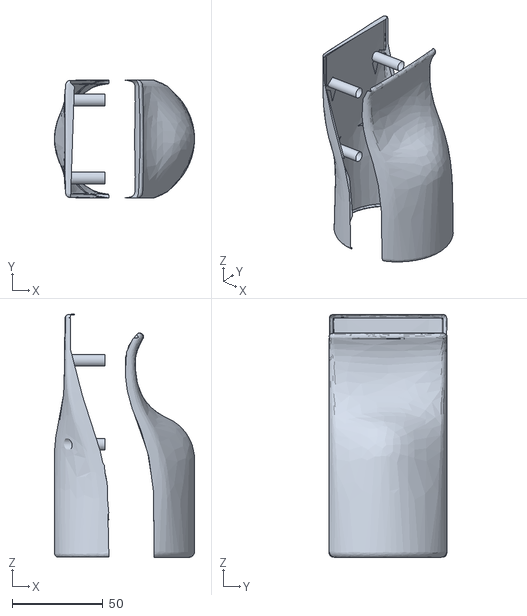
[picture p59: CAD file, 2026-10-08]
description/openarm/meshes/visual/arm/link3_1.obj
77.3 x 65.0 x 134.0
