UW-Allen-School-Robotics/opendubs/description/openarm/meshes/visual/arm/link5_1.obj

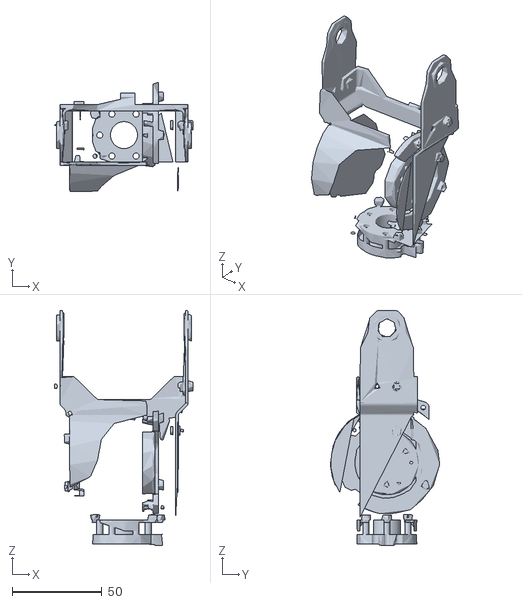
[picture p60: CAD file, 2026-10-08]
description/openarm/meshes/visual/arm/link5_1.obj
77.6 x 61.0 x 131.0
