UW-Allen-School-Robotics/opendubs/description/openarm/meshes/visual/arm/link6_0.obj

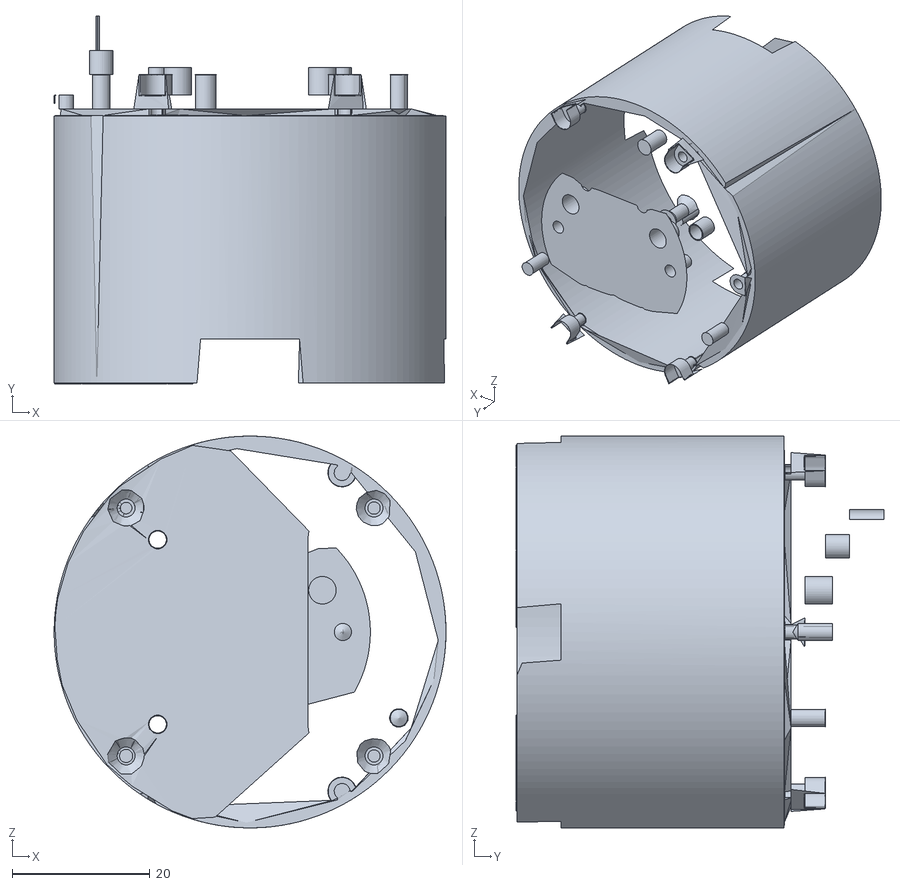
[picture p61: CAD file, 2026-10-08]
description/openarm/meshes/visual/arm/link6_0.obj
57.0 x 53.5 x 57.0
