UW-Allen-School-Robotics/opendubs/description/openarm/meshes/visual/arm/link2_2.obj

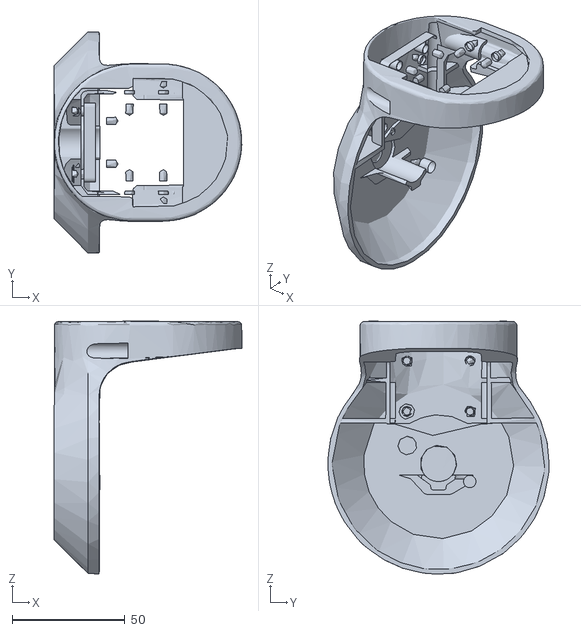
[picture p62: CAD file, 2026-10-08]
description/openarm/meshes/visual/arm/link2_2.obj
83.2 x 98.1 x 112.2
