UW-Allen-School-Robotics/opendubs/description/openarm/meshes/visual/arm/link1_3.obj

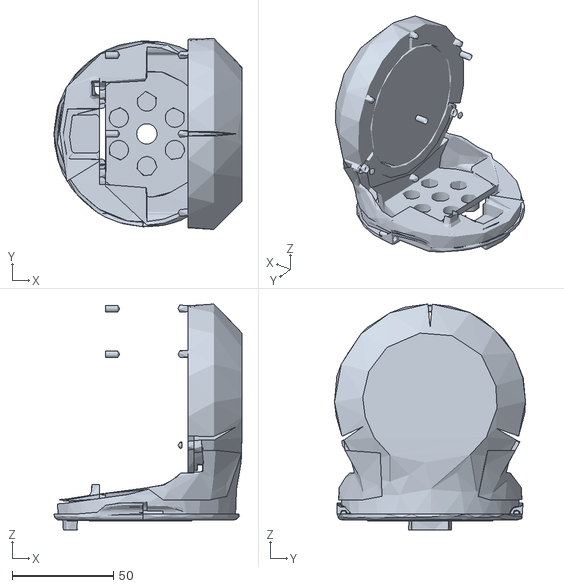
[picture p63: CAD file, 2026-10-08]
description/openarm/meshes/visual/arm/link1_3.obj
92.9 x 94.4 x 111.7
