UW-Allen-School-Robotics/opendubs/description/openarm/meshes/visual/arm/link5_2.obj

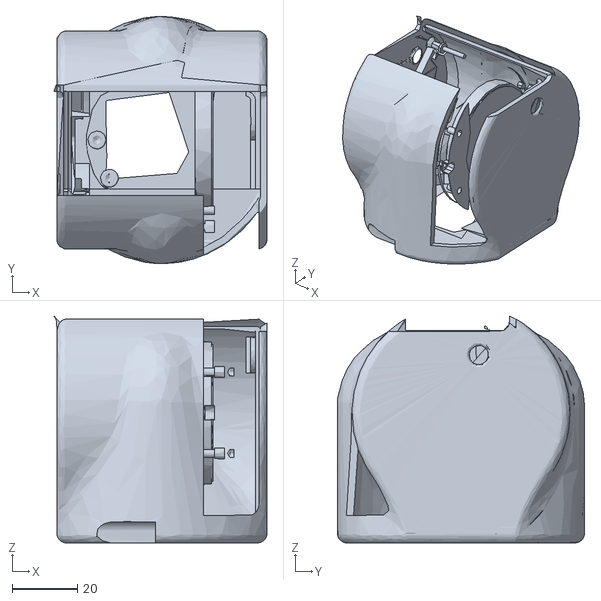
[picture p64: CAD file, 2026-10-08]
description/openarm/meshes/visual/arm/link5_2.obj
65.5 x 76.0 x 69.8
