UW-Allen-School-Robotics/opendubs/description/openarm/meshes/visual/arm/link1_1.obj

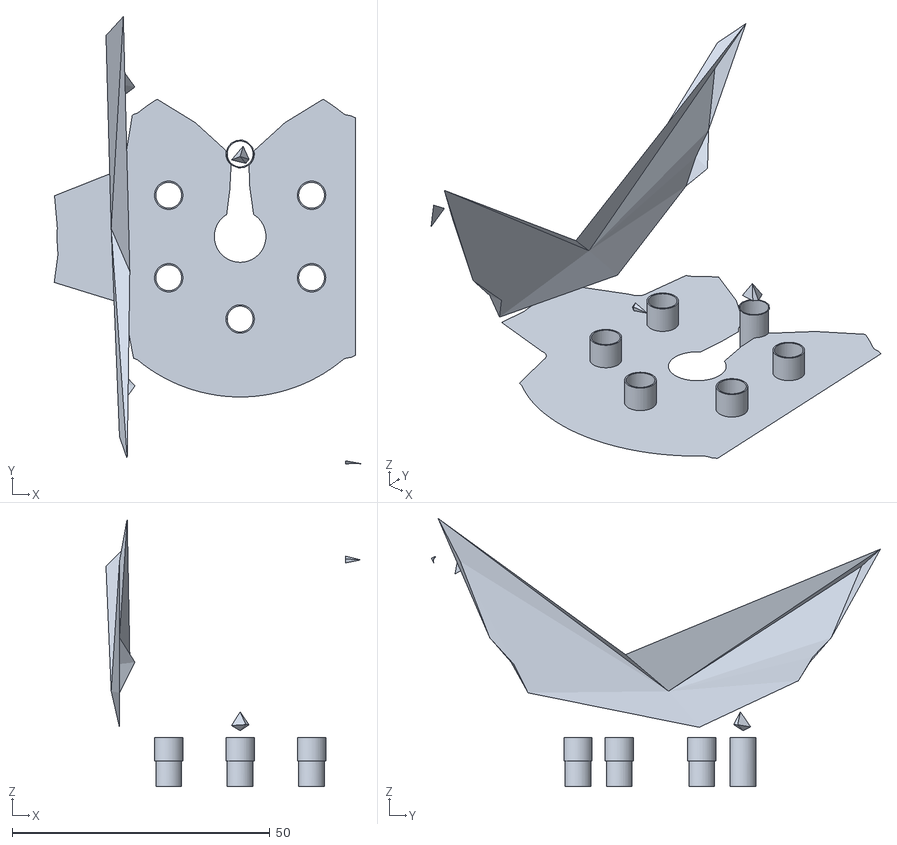
[picture p65: CAD file, 2026-10-08]
description/openarm/meshes/visual/arm/link1_1.obj
59.5 x 87.1 x 52.0
