UW-Allen-School-Robotics/opendubs/description/openarm/meshes/visual/arm/link7_1.obj

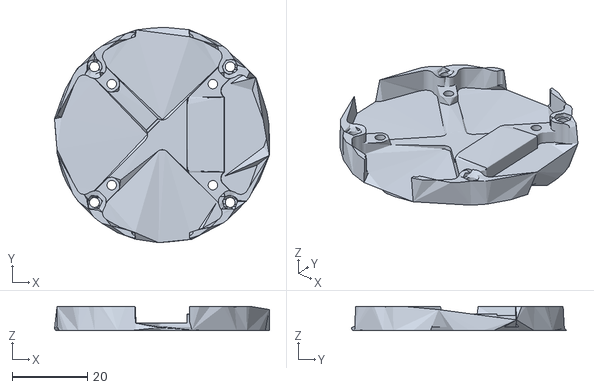
[picture p66: CAD file, 2026-10-08]
description/openarm/meshes/visual/arm/link7_1.obj
57.1 x 57.2 x 6.51
