UW-Allen-School-Robotics/opendubs/(list of files, cad)

Other CAD files:
description/opendubs/meshes/FL-wheel.stl
description/opendubs/meshes/RL-wheel.stl
description/opendubs/meshes/RR-wheel.stl
description/opendubs/meshes/femto_bolt.stl
