UW-Allen-School-Robotics/opendubs/docs/build/depth-camera.md

# Depth Camera Mount (Femto Bolt)

!!! warning "In development"
    The mount is designed and its geometry is in the repository, but this page does not yet have
    photos, the CAD and print files, the camera's retaining-screw size or the cable. Those are
    marked *TODO* below.

!!! info "At a glance"
    | | |
    |---|---|
    | **You'll build** | A 3D-printed sleeve that holds an Orbbec Femto Bolt depth camera on top of the robot's face, looking where the face looks |
    | **Time** | *TODO* |
    | **Difficulty** | Beginner (print one part, slide the camera in, fit a few screws) |
    | **Prerequisites** | The [Pan/Tilt HMI module](pan-tilt-hmi.md), whose face holder carries the mount; an Orbbec Femto Bolt |
    | **Mates to** | Two pockets in the top of the face holder; a USB 3 cable to a USB hub on the [Thor](thor-install.md) (*TODO: the cable*) |
    | **Optional?** | Yes — the robot drives and performs without one |

## What this is

A depth camera measures how far away each point in its view is. The robot uses one to find
people: the face can turn toward them, and the stage page draws the people dancing in front of
the robot as live skeletons. No camera image is shown, streamed or recorded for that; only
joint positions are used.

This module puts an **Orbbec Femto Bolt**, a time-of-flight depth camera, on top of the robot's
face. It rides the face's tilt, so the camera always looks where the face looks.

The mount is a single printed part: a **rectangular sleeve** that wraps the camera's body, with
**two legs** underneath that drop into pockets in the top of the face holder.

There are two versions of the mount, and both fit the same pockets in the same way:

- the **30° mount**, which tilts the camera 30° down from the face. This is the default, and the
  one the robot model describes;
- the **straight mount**, which holds the camera square to the face.

Print whichever suits where the robot works. The sleeve measurements below are the straight
mount's; *TODO: the 30° mount's, where they differ.*

The Intel RealSense D415 is an alternative depth camera, also listed as optional in the
[Hardware BOM](../hardware-bom.md). This mount is for the Femto Bolt only.
[Camera selection](../camera-selection.md) compares these and other cameras.

## CAD & 3D model

- **View in browser (Fusion):** *TODO — add permalink*
- **Download:** *TODO — STEP, plus the mount's STL and 3MF print file, into `hardware/`. 3MF
  print files are still to come for every printed part in this guide.*

The robot's description in the repository already carries simplified meshes, for the simulator
and the robot model, in `description/opendubs/meshes/`: `femto_mount_tilt30.stl` (the 30° mount
with the camera in it), and for the straight mount `femto_mount.stl` and `femto_bolt.stl` (the
camera's 115 × 65 × 40 mm outer envelope, not Orbbec's CAD). Use the CAD downloads above for
printing, not these.

## Bill of materials

!!! note "Generated from `hardware/parts.csv`"
    Edit the CSV (rows tagged `module = depth-camera`), then run `tools/bom.py --inject`.

<!-- BOM-AUTO:build:depth-camera -->
**Camera**

| Part | SKU | Qty | Notes |
|---|---|---:|---|
| [Orbbec Femto Bolt depth camera](https://store.orbbec.com/products/femto-bolt) | `100100433` | 1 | Optional. A time-of-flight depth camera; an alternative to the RealSense D415. |

**Mount**

| Part | SKU | Qty | Notes |
|---|---|---:|---|
| Femto Bolt mount, 30° or straight (3D-printed) | — | 1 | A sleeve around the camera with two legs that drop into the face holder's pockets. The 30° mount tilts the camera down and is the default; the straight one holds it square. PLA or PETG, 15% infill; STL and 3MF in hardware/ TBD. |
| M4 x 16 mm bolt with a nut or threaded insert | — | 2 | One through each pocket of the face holder and the leg inside it (4.3 mm hole). A pin that stops the leg sliding out; the pocket's fit holds the mount. |
| Camera retaining screw (size TBD) | — | 4 | Through the small holes in the sleeve's side walls, two a side, to hold the camera in. Size and length to be confirmed. |
<!-- /BOM-AUTO:build:depth-camera -->

## Print

Print the mount in **PLA or PETG** at **15% infill**, as the part sits on the bed in the print
file. *TODO: the 3MF print file.*

The sleeve's walls are about 3 mm thick at the sides and 3.75 mm top and bottom.

## Assembly

*TODO — photos for each step.*

1. **Slide the camera into the sleeve.** The sleeve is open at the back and the front. It
   holds the camera on all four sides, with the camera's front face standing about 19 mm proud
   of the sleeve so nothing overlaps the lenses. Face the camera's lenses forward, the same way
   as the tablet's screen.
2. **Fit the retaining screws.** Each side wall of the sleeve has two small holes at the
   camera's mid-height, 20 mm apart. A screw through each holds the camera in the sleeve so it
   can't slide out. *TODO: the screw size and length.*
3. **Drop the legs into the face holder.** The top of the face holder has two rectangular
   pockets, one at each side. Each leg slides about 50 mm down into its pocket, which holds it
   on all four sides; the sleeve then sits just above the top of the face holder.
4. **Pin each leg.** A 4.3 mm hole runs sideways through each pocket and the leg inside it. Put
   an M4 × 16 mm bolt through each, with a nut or a threaded insert. The pockets' fit is what
   holds the mount; the bolts act as pins that stop the legs sliding back out, so they only
   need to be snug.
5. **Run the camera's cable**, a USB 3 cable, to a USB hub on the Thor. Leave enough slack for
   the head's full pan and tilt. *TODO: the cable and its route along the neck.*

## Where the camera is, for software

The robot model places the camera with three frames. The numbers below are from the CAD, with
the head at its centre (no pan, no tilt) and the lift fully down; the robot model
(`description/opendubs/dimensions.yaml`, turned into the robot's URDF by
`description/opendubs/gen_urdf.py`) is the source for them.

| Frame | Attached to | Where | Orientation |
|---|---|---|---|
| `femto_mount_link` | `head_tilt_link` (the tilting face) | where the mount's legs enter the face holder: centred between the two pockets, on the holder's top face | the same as `head_tilt_link` |
| `camera_link`, 30° mount | `femto_mount_link` | on the **depth** camera's lens, at the camera's front face: 39.00 mm forward, 30.0 mm to the robot's right and 25.34 mm up from `femto_mount_link` | pitched **36° down** |
| `camera_link`, straight mount | `femto_mount_link` | the same point: 33.95 mm forward, 30.0 mm to the robot's right and 27.51 mm up | pitched **6° down** |

The depth lens is the one 30 mm to the right of the camera's centre, as seen from behind the
robot; the colour (RGB) lens is near the centre. Orbbec's documentation gives the depth camera a
6° downward tilt relative to the colour camera, which is square to the housing. So `camera_link`
is pitched 6° down on the straight mount, and 36° down on the 30° mount (Orbbec's 6° plus the
mount's 30°).

The robot's URDF, `opendubs.urdf`, describes the 30° mount. The straight mount has its own,
`opendubs-femto-straight.urdf`: on a robot that carries the straight mount, point
`robot_state_publisher` at that one (the `OPENDUBS_URDF` setting).

`camera_link` is placed at the front face of the housing. The depth camera's true optical
centre is somewhat behind the glass; its exact depth is not in this geometry.

The frames *below* `camera_link` (the depth, colour and IMU frames, and their optical frames)
are published by Orbbec's ROS 2 driver, OrbbecSDK_ROS2, from the camera's own factory
calibration. The robot model stops at `camera_link`, so the two never publish the same
transform.

## Verify — done when…

- [ ] The camera sits square in the sleeve, lenses forward, with nothing over the lenses.
- [ ] Both legs are fully down in their pockets and bolted; the camera doesn't rock when the
      head tilts.
- [ ] The cable has enough slack for the head's full pan and tilt.
- [ ] The camera appears on the Thor. *TODO: the check command.*
