UW-Allen-School-Robotics/opendubs/docs/build/upper-frame.md

# Upper Frame Assembly

## At a glance

| | |
|---|---|
| **You'll do** | Build the upper frame, add controls (StamPLC + touchscreen), clad it, then mate it to the lower frame and close up the covers |
| **Prerequisites** | [Base Frame Final Assembly + Wiring](base-frame-final.md) (lower frame complete) |

!!! warning "In development"
    The upper frame is the build's next phase, and its pages are still being written: the six steps
    below are outlined, not yet documented. The complete build today is the [lower frame](lower-frame.md), steps 1–13.

## The upper-frame phase, in order

1. **Build the upper frame** — the goBILDA sub-assembly that carries the controls + cladding.
2. **[Right Upper Electronics Bay](upper-right-electronics-bay.md)** — mount the StamPLC and a
   DIN rail of WAGO connectors on the right upper frame.
3. **Install the touchscreen / operator panel.**
4. **Install the upper claddings.**
5. **Join upper ↔ lower** — wire the two frames together and **physically fasten** them.
6. **Lower claddings + front / rear covers** — final enclosure.

*Each of the six steps above will get its own build page + BOM + photos.*
