UW-Allen-School-Robotics/opendubs/docs/build/base-frame-final.md

# 13 · Base Frame Final Assembly + Wiring

## At a glance

| | |
|---|---|
| **You'll do** | Final wiring pass + mechanical button-up of the whole lower frame |
| **Prerequisites** | Steps 1–12 |
| **Ends with** | A complete, wired, testable lower frame — ready for the upper frame |

!!! note "Stub — assembly steps coming"
    The final lower-frame pass: complete the interconnect wiring, dress and strain-relieve the
    harnesses, and mechanically button up the lower frame before the upper frame goes on.

<figure class="amap" markdown="1">
  <div class="amap-frame" markdown="1">
--8<-- "amap-map.html"
  </div>
  <figcaption>By step 13 every lower-frame module is in — see the <a href="../lower-frame/">assembly overview</a> to click into the live 3D model.</figcaption>
</figure>

This closes out the **lower-frame group (steps 1–13)**. The next major phase is the
[Upper Frame Assembly](upper-frame.md).

*Assembly steps, verification checklist, and photos to be added.*
