UW-Allen-School-Robotics/opendubs/docs/build/battery-install.md

# 12 · Battery Install

## At a glance

| | |
|---|---|
| **You'll do** | Secure the battery; land the main power leads + the BMS RS485 link |
| **Prerequisites** | [Power Bay](power-bay.md), [Charger Port](charger-port.md) |
| **Watch** | It's the heaviest single item — mount it low and strap it down |

!!! note "Stub — assembly steps coming"
    Mount and secure the main **ECO-WORTHY ~52 V LiFePO4** pack in the lower frame and land its
    power + **BMS (RS485)** connections.

!!! danger "Battery safety"
    The pack is the **heaviest single part** and a **high-energy lithium battery**. Get help lifting
    it, and keep **hands and feet clear from under the robot**. Wear **PPE** (safety glasses +
    gloves). Disconnect before wiring; never short, over-discharge, puncture, submerge, or charge a
    damaged pack, and isolate any pack that is hot, swollen, or smoking. Read the manufacturer's full
    safety + PPE guidance:
    [ECO-WORTHY battery manual (PDF)](https://cdn.shopify.com/s/files/1/0253/9752/6580/files/48V_50AH_Rack_Battery_Instruction_Manual.pdf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).

<figure class="amap amap--battery" markdown="1">
  <div class="amap-frame" markdown="1">
--8<-- "amap-map.html"
  </div>
  <figcaption>Where the <strong>Main Battery</strong> sits in the lower frame — see the <a href="../lower-frame/">assembly overview</a>.</figcaption>
</figure>

*Assembly steps, BOM rows, and photos to be added. See [Power architecture](../power-architecture.md).*
