UW-Allen-School-Robotics/opendubs/docs/assets/build/README.md

# Build photos — convention

Curated, web-ready photos for the assembly guides live under
`docs/assets/build/<module>/`. This is the **published, versioned** home for the *final*
step photos — the raw shoot stays on the team Drive; only chosen shots get committed.

## Prep
- **Convert HEIC → JPG/WebP** (phone photos are HEIC; browsers don't render them).
- **Resize** to ~1600 px on the long edge, aim **< 300 KB**.
- **Strip the metadata.** A phone photo records where it was taken, and these are published.
  Both converters do it: `tools/convert_build_photos.py` (any platform) writes none, and
  `tools/convert-build-photos.sh` (macOS) requires `exiftool` and runs it. Check before
  committing: `exiftool -if '$GPSLatitude' -p '$FileName' docs/assets/build/<module>` must print
  nothing.
- Run `tools/convert-build-photos.sh <staging-dir> docs/assets/build/<module>/photos.manifest docs/assets/build/<module>`.

## Naming
`NN-short-description.jpg` matching the page's steps (`01-…`, `02-…`), plus
`completed-01.jpg` for finished shots and `hero.png` for the module hero.
