UW-Allen-School-Robotics/opendubs/docs/assets/build/lower-frame/assembly-map.png

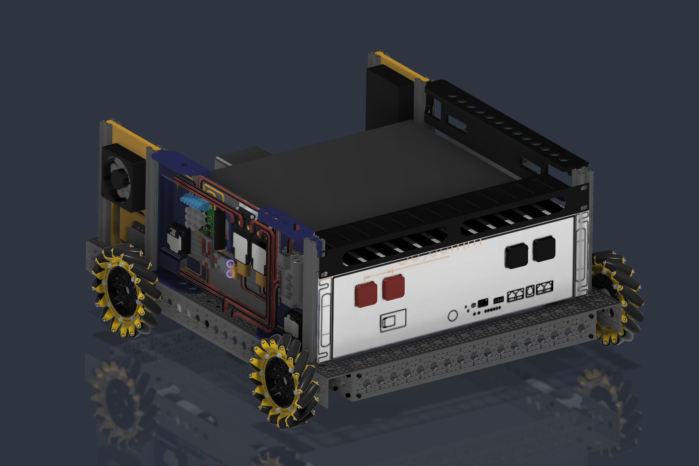
docs/assets/build/lower-frame/assembly-map.png
