UW-Allen-School-Robotics/opendubs/docs/assets/build/power-bay/01a-backplate-bare.webp

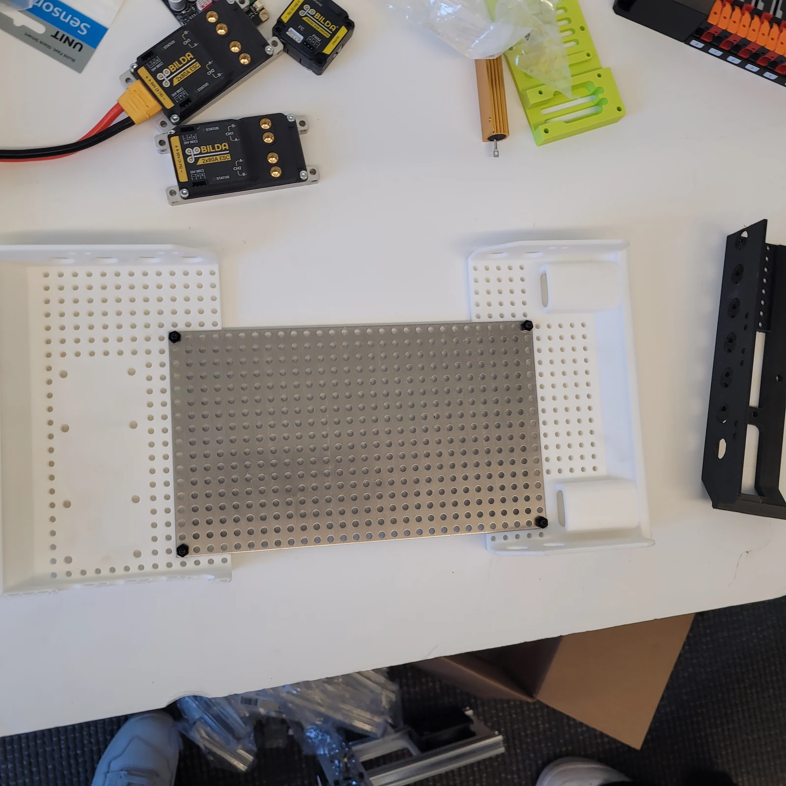
docs/assets/build/power-bay/01a-backplate-bare.webp
