UW-Allen-School-Robotics/opendubs/docs/assets/build/power-bay/01b-backplate-underside.webp

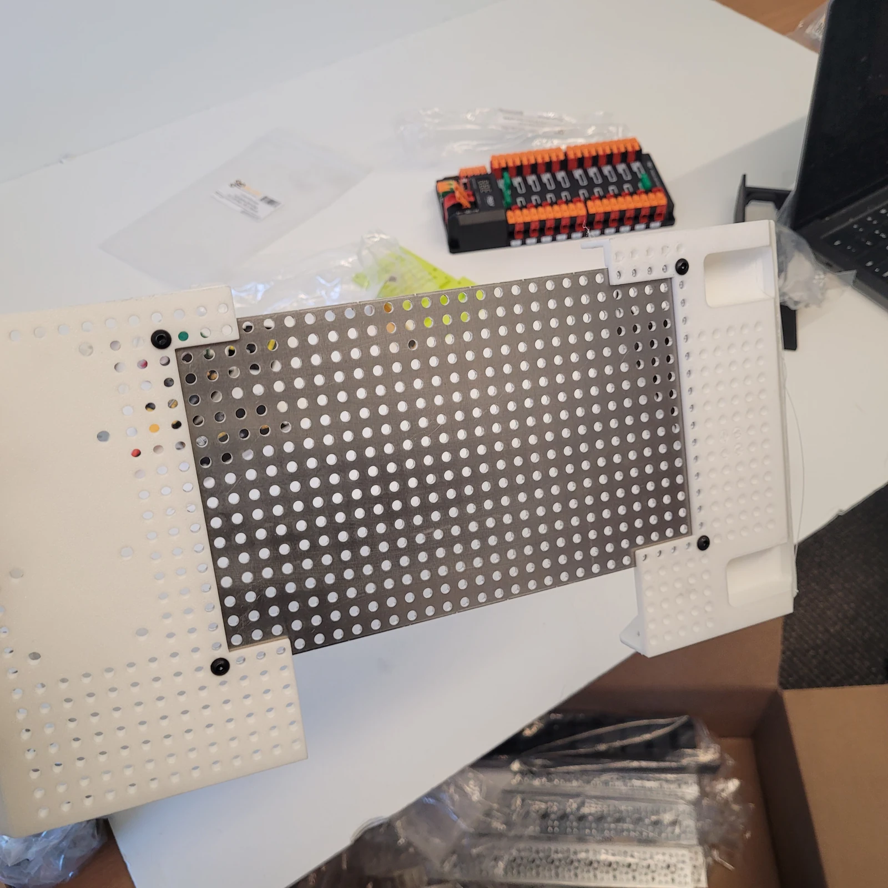
docs/assets/build/power-bay/01b-backplate-underside.webp
