UW-Allen-School-Robotics/opendubs/docs/assets/build/power-bay/01c-module-dry-fit.webp

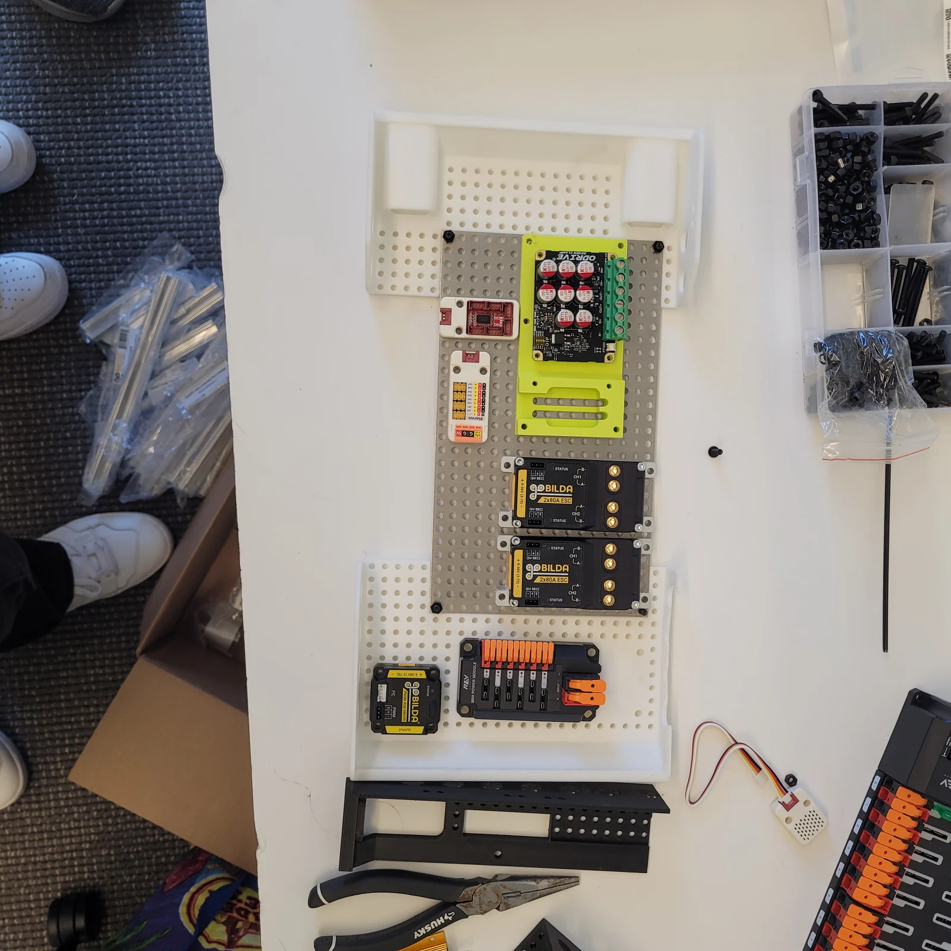
docs/assets/build/power-bay/01c-module-dry-fit.webp
