UW-Allen-School-Robotics/opendubs/docs/assets/build/power-bay/01d-modules-screwed-down.webp

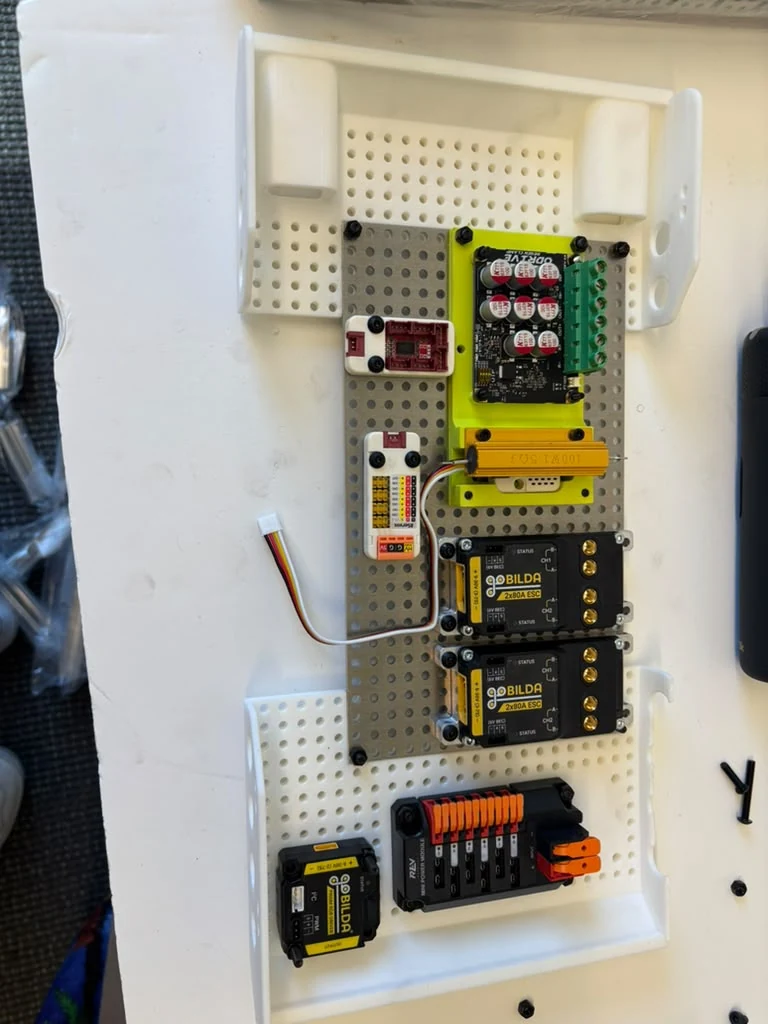
docs/assets/build/power-bay/01d-modules-screwed-down.webp
