UW-Allen-School-Robotics/opendubs/docs/assets/build/power-bay/02a-regen-clamp-carrier.webp

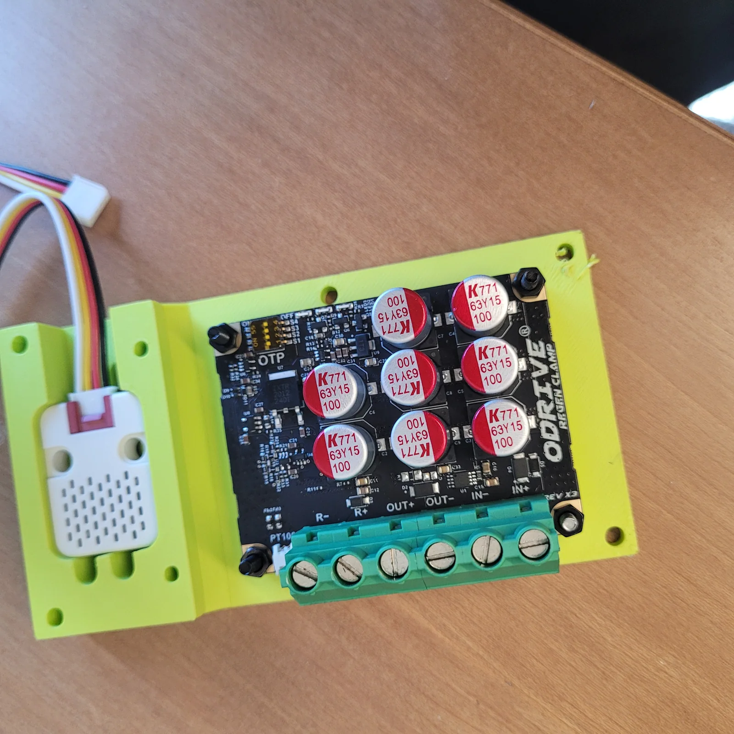
docs/assets/build/power-bay/02a-regen-clamp-carrier.webp
