UW-Allen-School-Robotics/opendubs/docs/assets/build/power-bay/02b-regen-clamp-resistor.webp

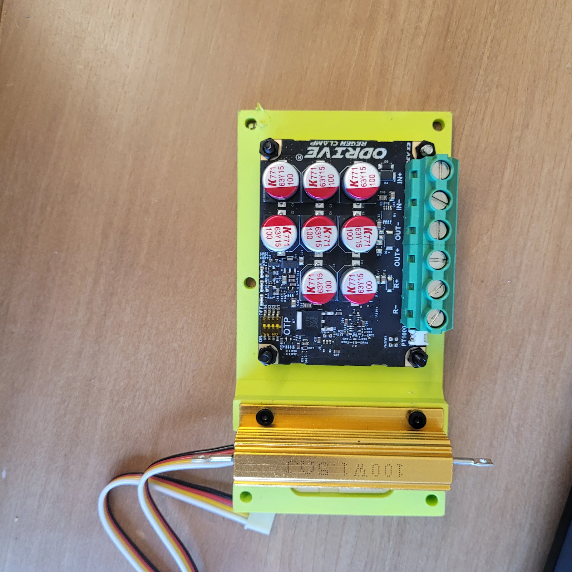
docs/assets/build/power-bay/02b-regen-clamp-resistor.webp
