UW-Allen-School-Robotics/opendubs/docs/assets/build/power-bay/02c-regen-clamp-underside.webp

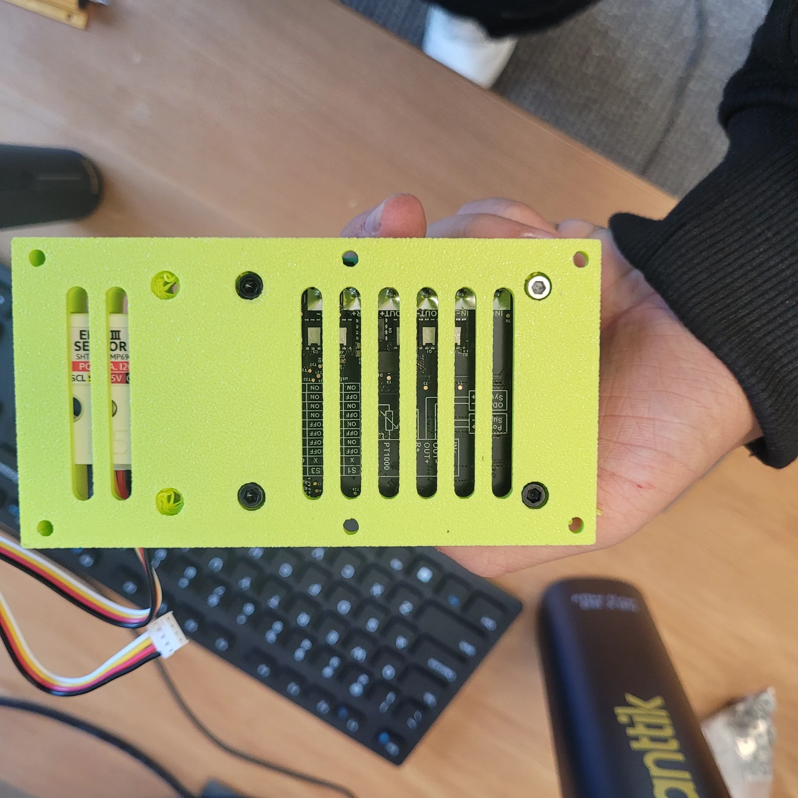
docs/assets/build/power-bay/02c-regen-clamp-underside.webp
