UW-Allen-School-Robotics/opendubs/docs/assets/build/power-bay/03a-servo-lead-pins.webp

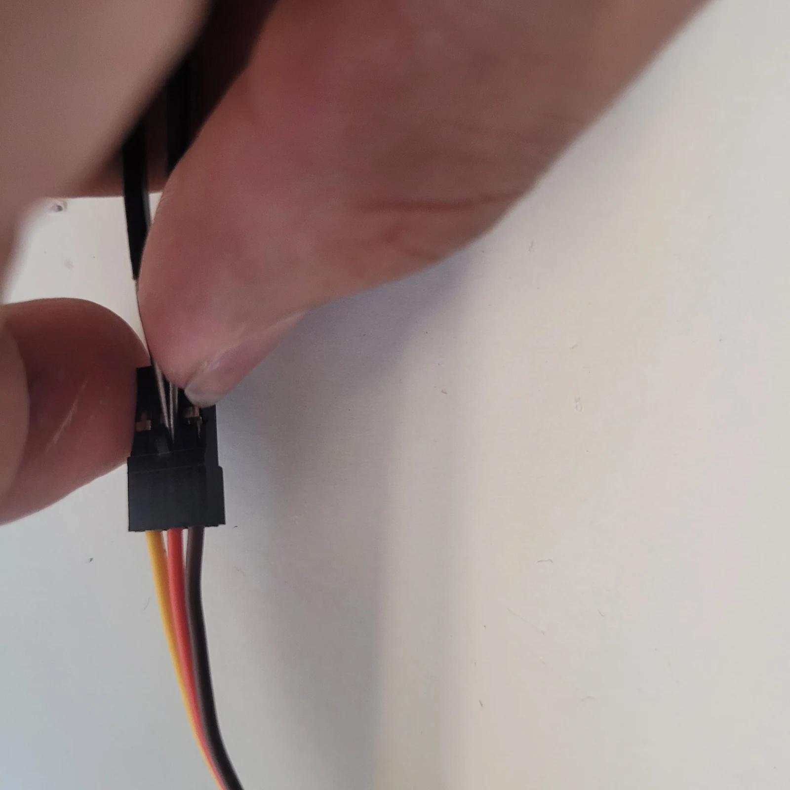
docs/assets/build/power-bay/03a-servo-lead-pins.webp
