UW-Allen-School-Robotics/opendubs/docs/assets/build/power-bay/03b-servo-connector.webp

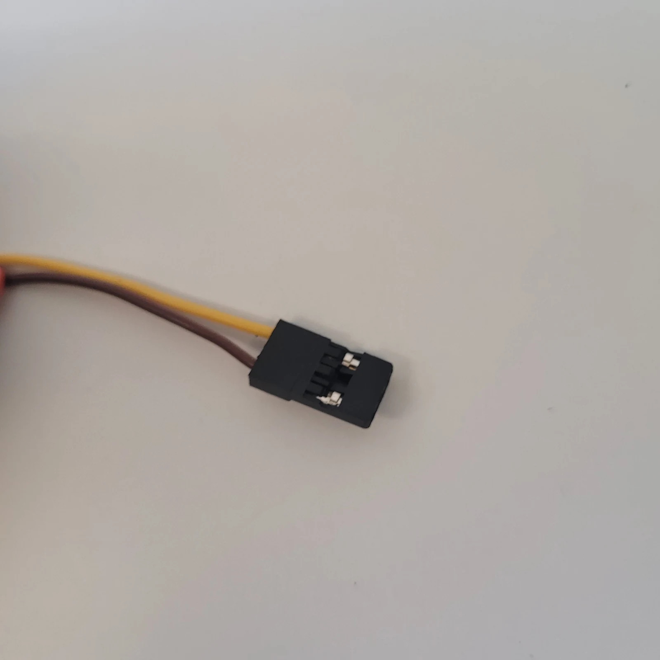
docs/assets/build/power-bay/03b-servo-connector.webp
