UW-Allen-School-Robotics/opendubs/docs/assets/build/power-bay/03c-servo-extension-lead.webp

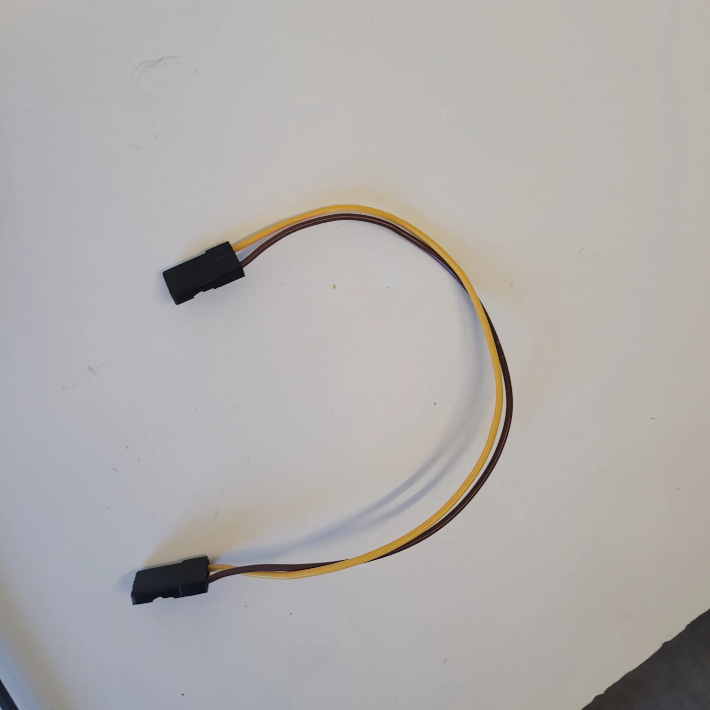
docs/assets/build/power-bay/03c-servo-extension-lead.webp
