UW-Allen-School-Robotics/opendubs/docs/assets/build/power-bay/03d-esc-bec-headers.webp

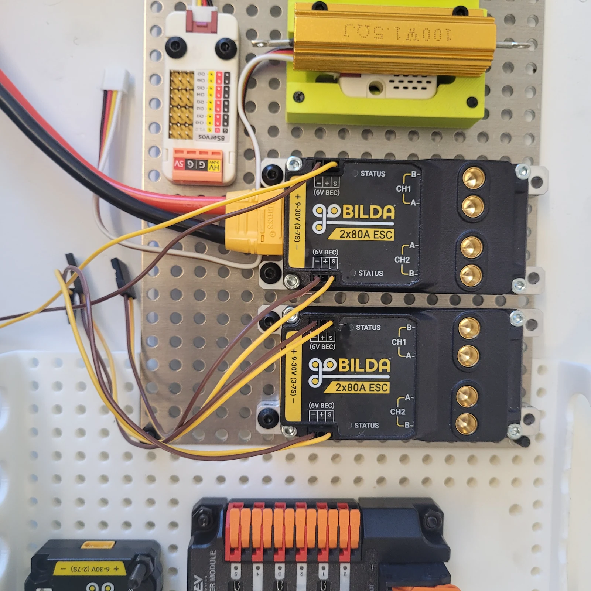
docs/assets/build/power-bay/03d-esc-bec-headers.webp
