UW-Allen-School-Robotics/opendubs/docs/assets/build/power-bay/03e-esc-xt90-power.webp

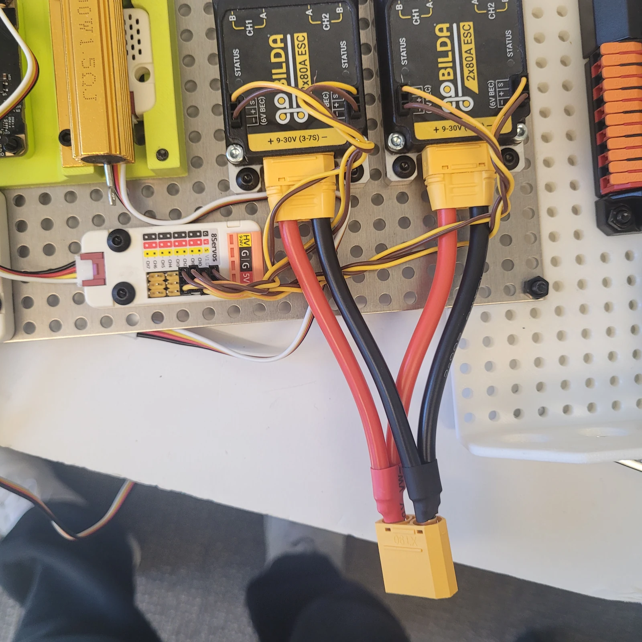
docs/assets/build/power-bay/03e-esc-xt90-power.webp
