UW-Allen-School-Robotics/opendubs/docs/assets/build/power-bay/04a-strip-jst-lead.webp

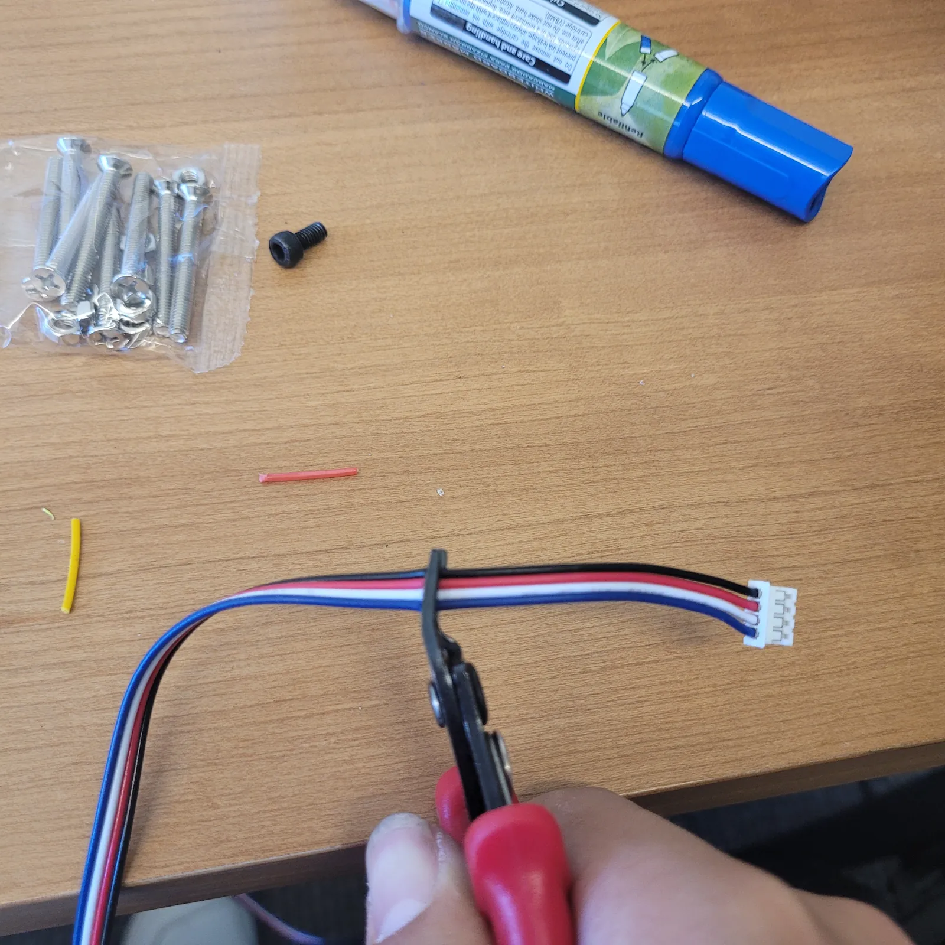
docs/assets/build/power-bay/04a-strip-jst-lead.webp
