UW-Allen-School-Robotics/opendubs/docs/assets/build/power-bay/04b-jst-lead-stripped.webp

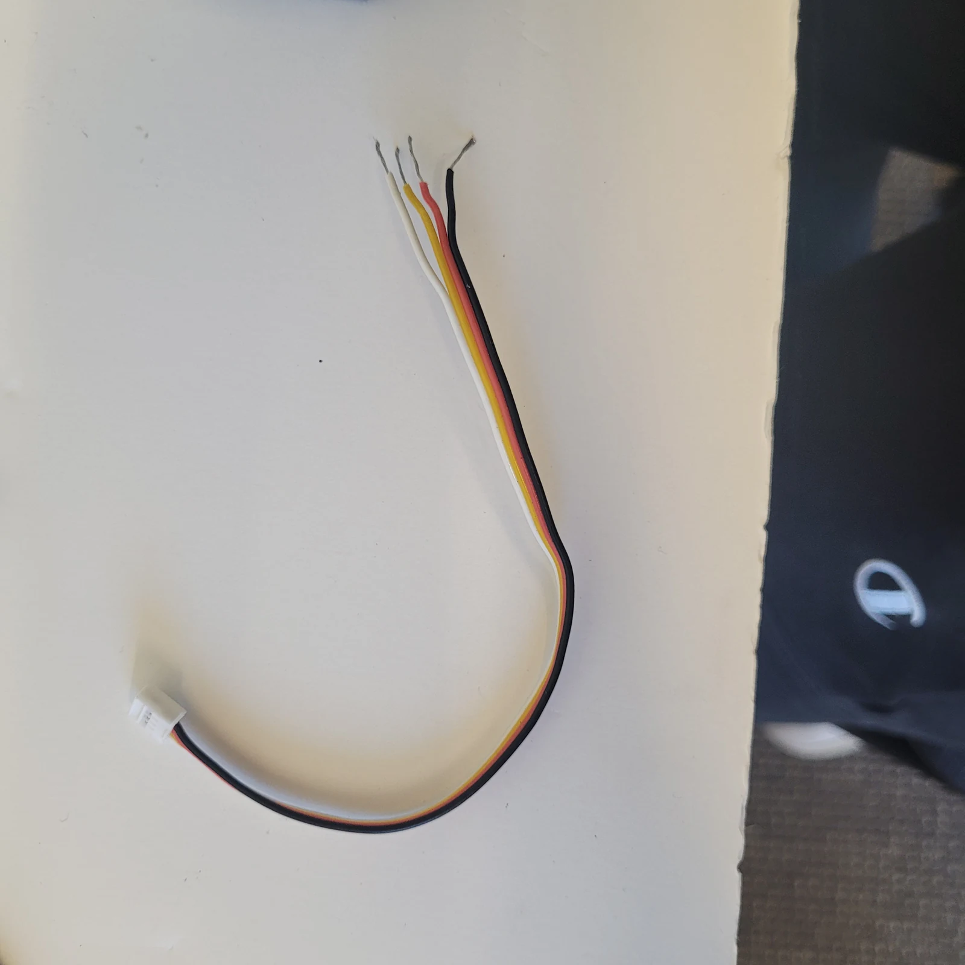
docs/assets/build/power-bay/04b-jst-lead-stripped.webp
