UW-Allen-School-Robotics/opendubs/docs/assets/build/power-bay/04c-lever-nuts-and-leads.webp

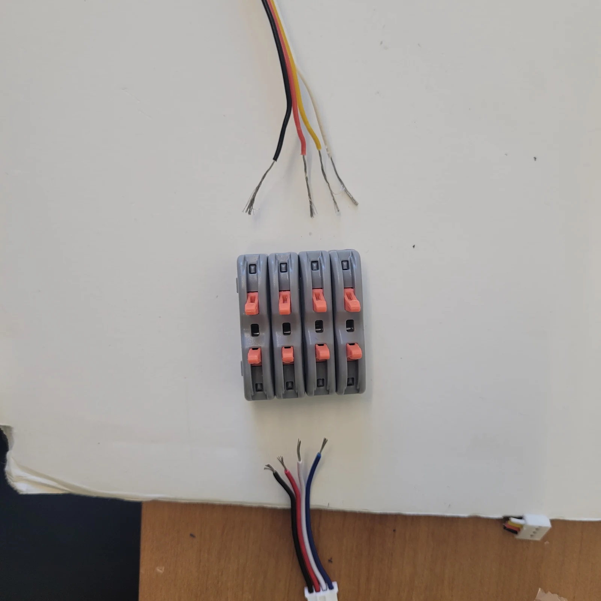
docs/assets/build/power-bay/04c-lever-nuts-and-leads.webp
