UW-Allen-School-Robotics/opendubs/docs/assets/build/power-bay/04d-first-lead-landed.webp

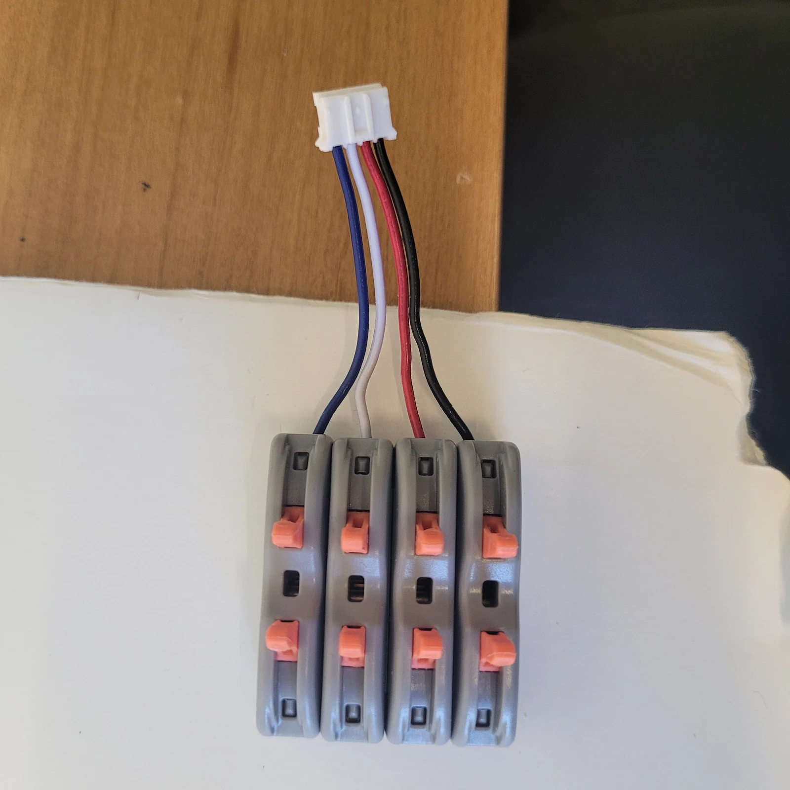
docs/assets/build/power-bay/04d-first-lead-landed.webp
