UW-Allen-School-Robotics/opendubs/docs/assets/build/power-bay/04e-first-lead-seated.webp

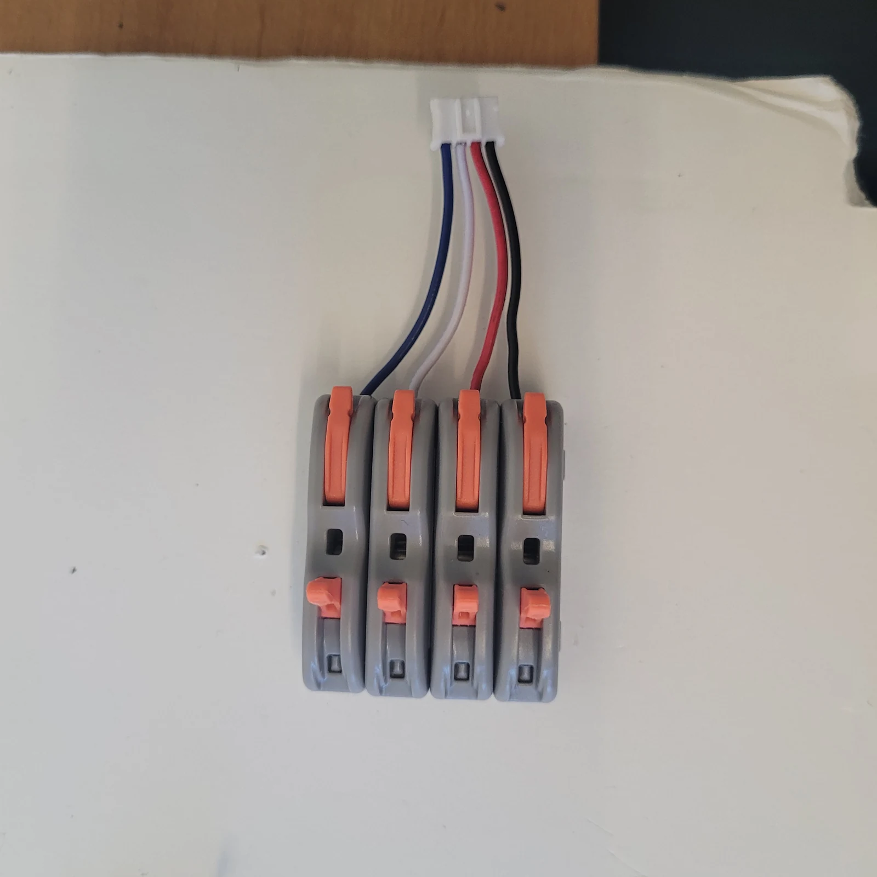
docs/assets/build/power-bay/04e-first-lead-seated.webp
