UW-Allen-School-Robotics/opendubs/docs/assets/build/power-bay/04f-both-leads-landed.webp

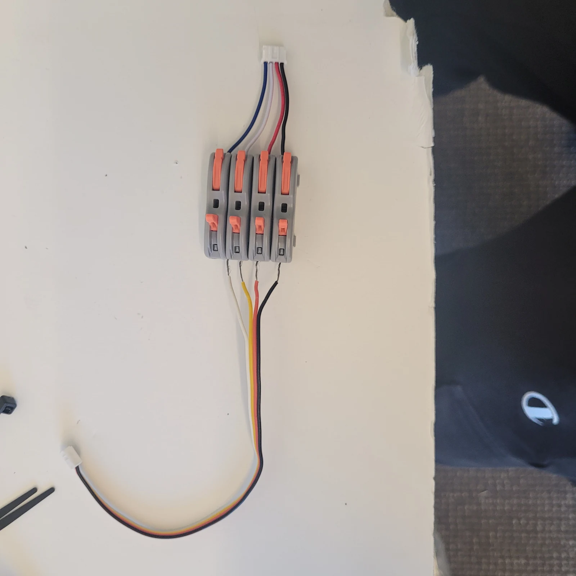
docs/assets/build/power-bay/04f-both-leads-landed.webp
