UW-Allen-School-Robotics/opendubs/docs/assets/build/power-bay/04g-harness-complete.webp

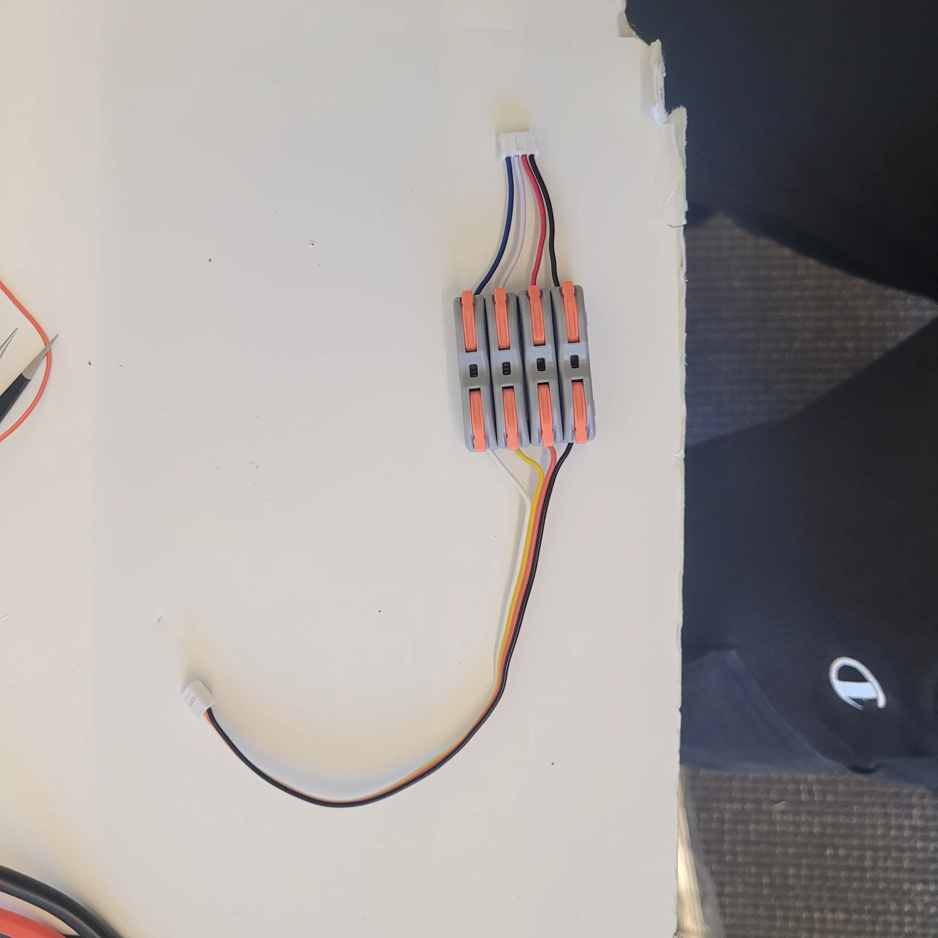
docs/assets/build/power-bay/04g-harness-complete.webp
