UW-Allen-School-Robotics/opendubs/docs/assets/build/power-bay/04h-harness-to-rgb-driver.webp

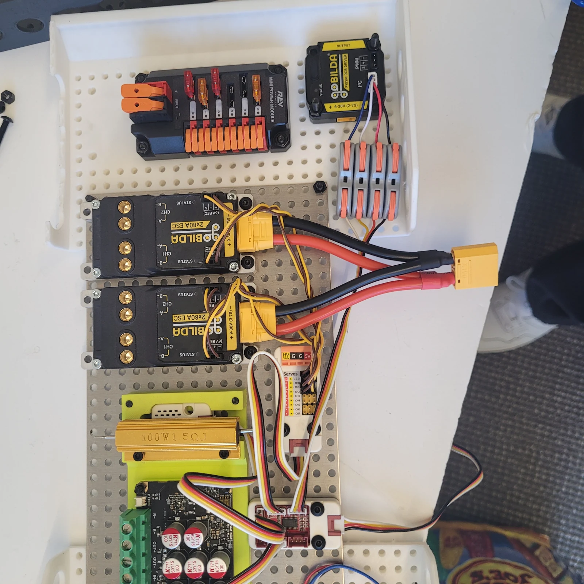
docs/assets/build/power-bay/04h-harness-to-rgb-driver.webp
