UW-Allen-School-Robotics/opendubs/docs/assets/build/power-bay/04i-rgb-driver-wired.webp

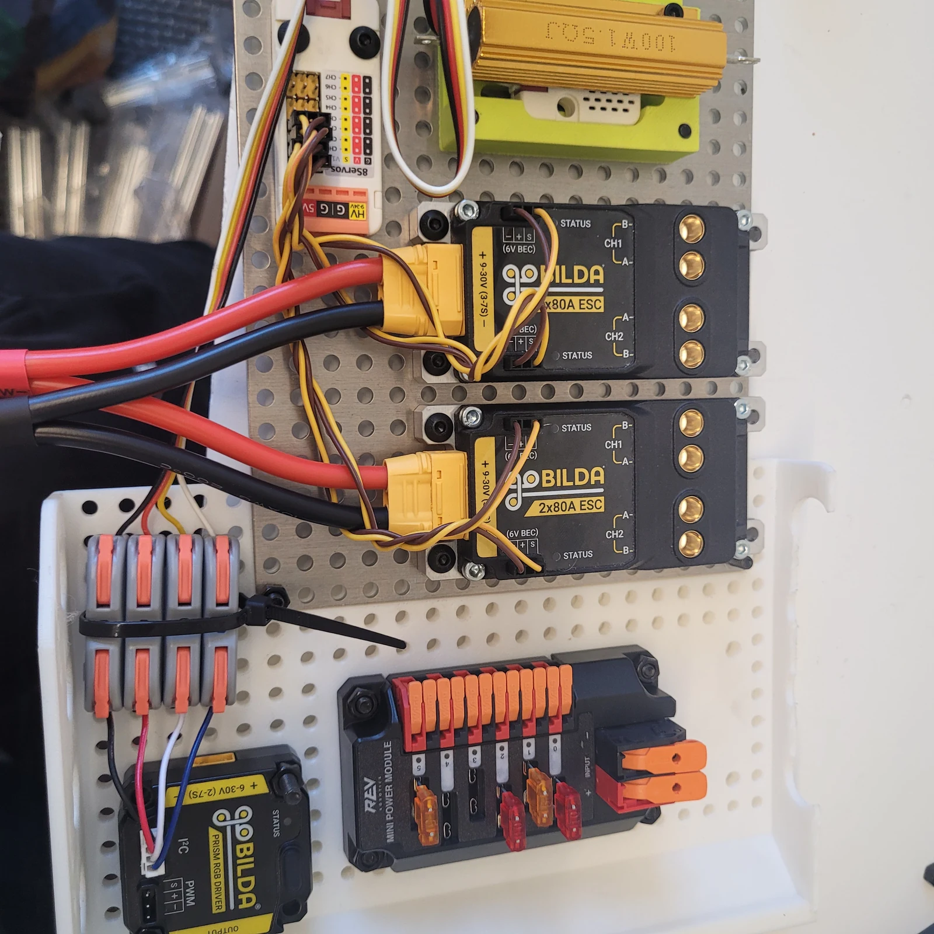
docs/assets/build/power-bay/04i-rgb-driver-wired.webp
