UW-Allen-School-Robotics/opendubs/docs/assets/build/power-bay/05b-leads-laid-out.webp

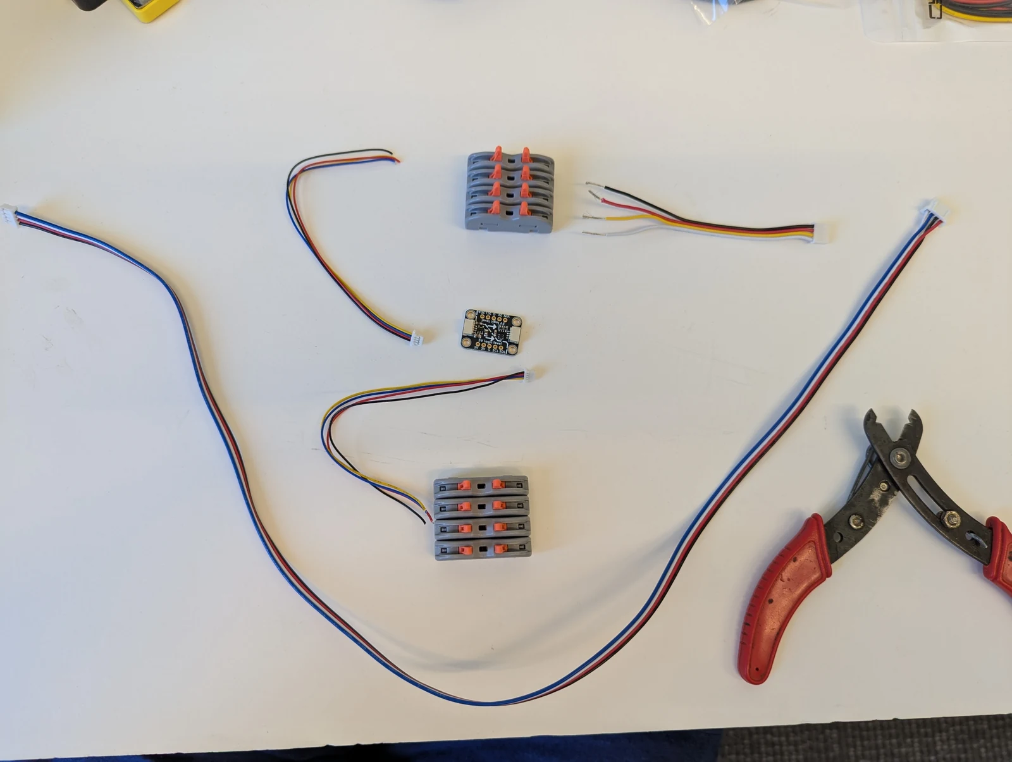
docs/assets/build/power-bay/05b-leads-laid-out.webp
