UW-Allen-School-Robotics/opendubs/docs/assets/build/power-bay/05c-leads-stripped.webp

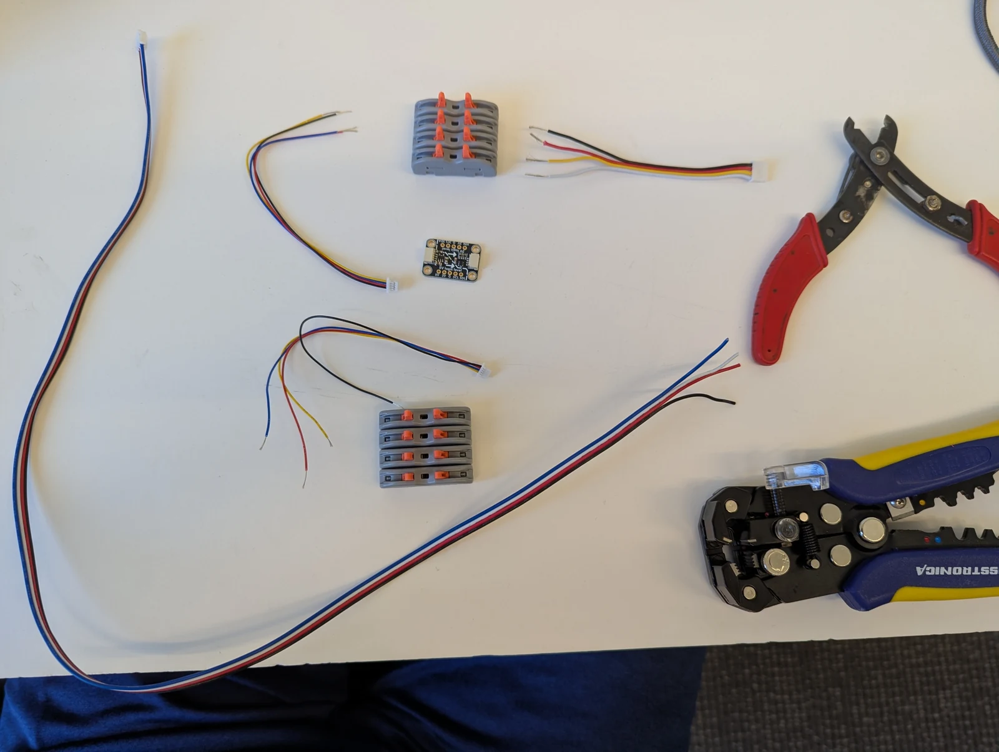
docs/assets/build/power-bay/05c-leads-stripped.webp
