UW-Allen-School-Robotics/opendubs/docs/assets/build/power-bay/05d-leads-cut-to-length.webp

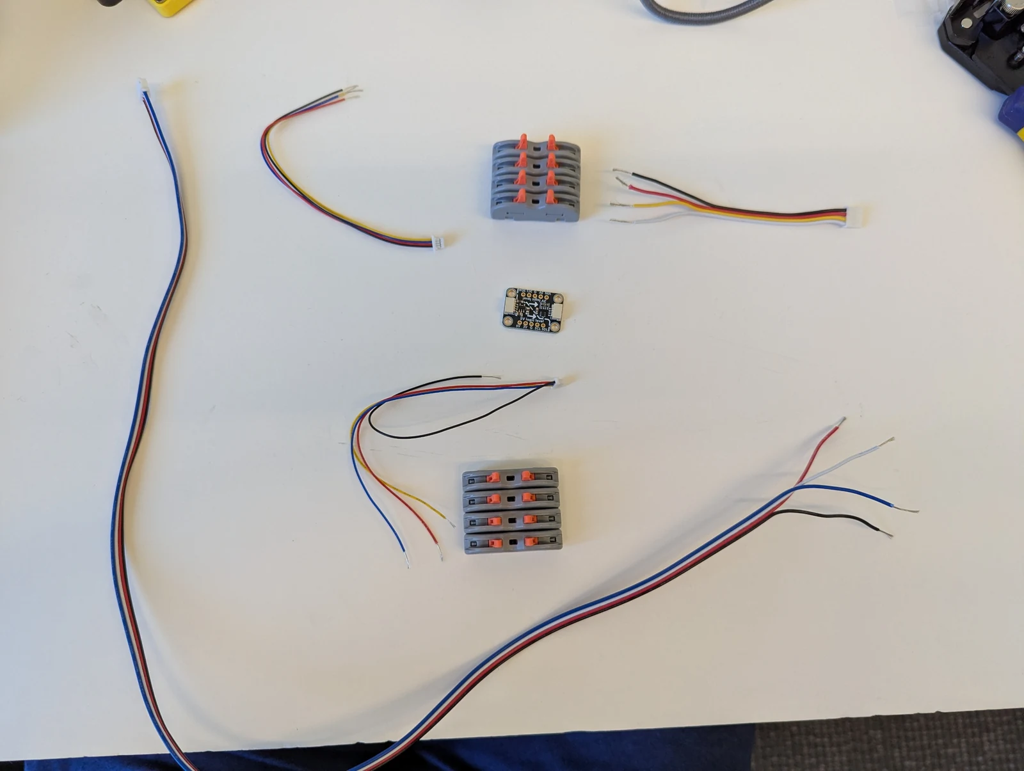
docs/assets/build/power-bay/05d-leads-cut-to-length.webp
