UW-Allen-School-Robotics/opendubs/docs/assets/build/power-bay/05e-shifter-between-blocks.webp

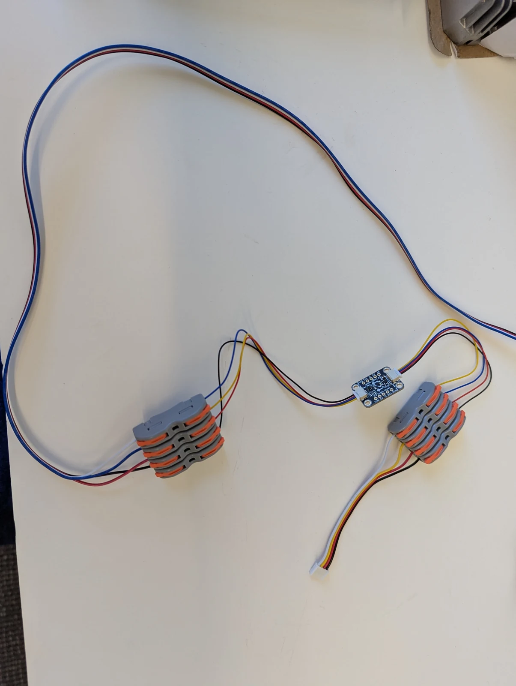
docs/assets/build/power-bay/05e-shifter-between-blocks.webp
