UW-Allen-School-Robotics/opendubs/docs/assets/build/power-bay/05f-blocks-mounted.webp

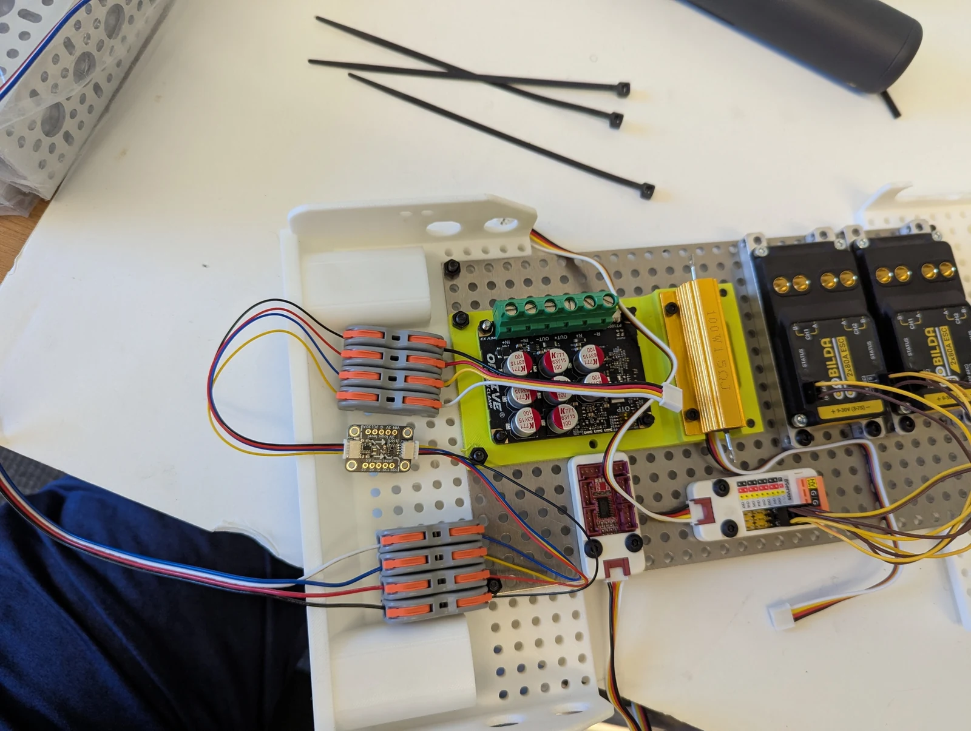
docs/assets/build/power-bay/05f-blocks-mounted.webp
