UW-Allen-School-Robotics/opendubs/docs/assets/build/power-bay/05g-shifter-installed.webp

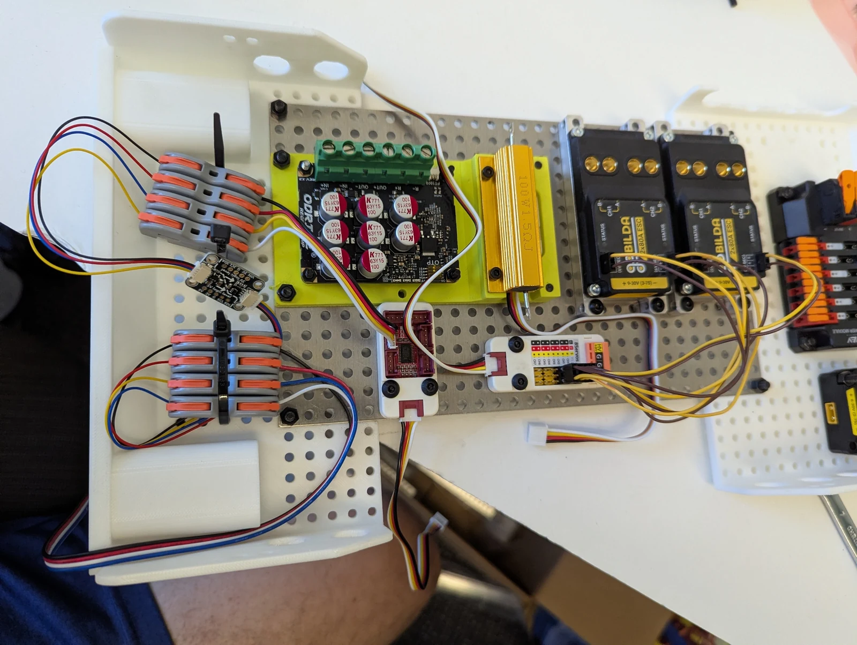
docs/assets/build/power-bay/05g-shifter-installed.webp
