UW-Allen-School-Robotics/opendubs/docs/assets/build/power-bay/05h-harness-tidied.webp

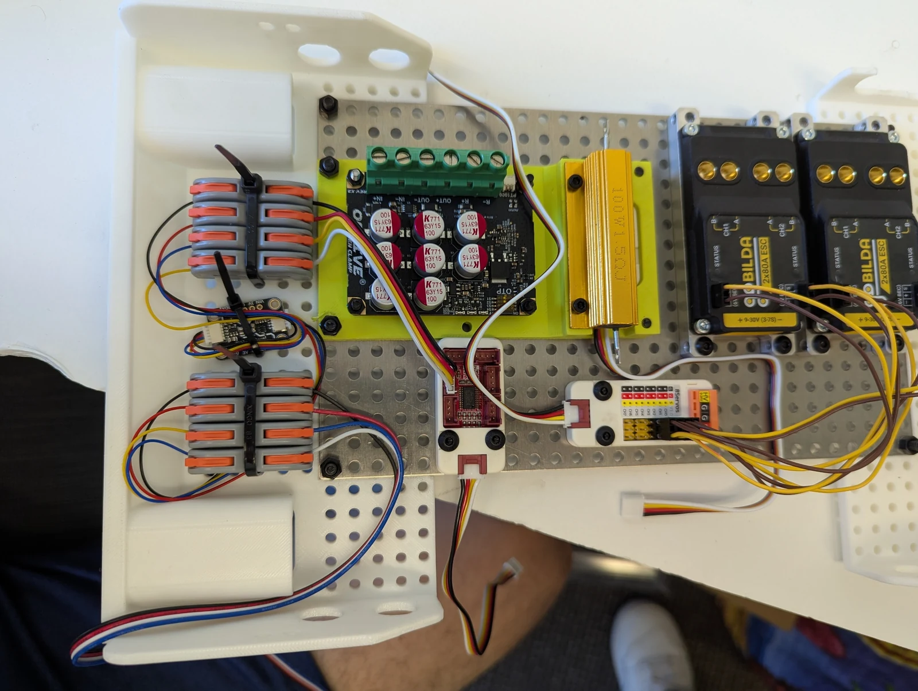
docs/assets/build/power-bay/05h-harness-tidied.webp
