UW-Allen-School-Robotics/opendubs/docs/assets/build/power-bay/05i-bay-complete.webp

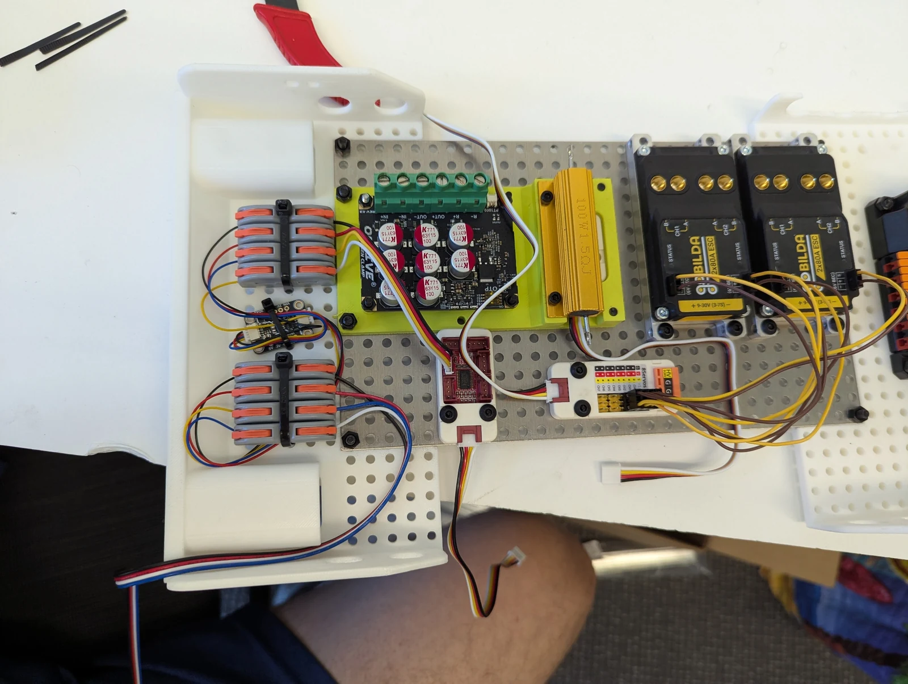
docs/assets/build/power-bay/05i-bay-complete.webp
