UW-Allen-School-Robotics/opendubs/docs/assets/build/power-bay/06a-strip-spare-jst.webp

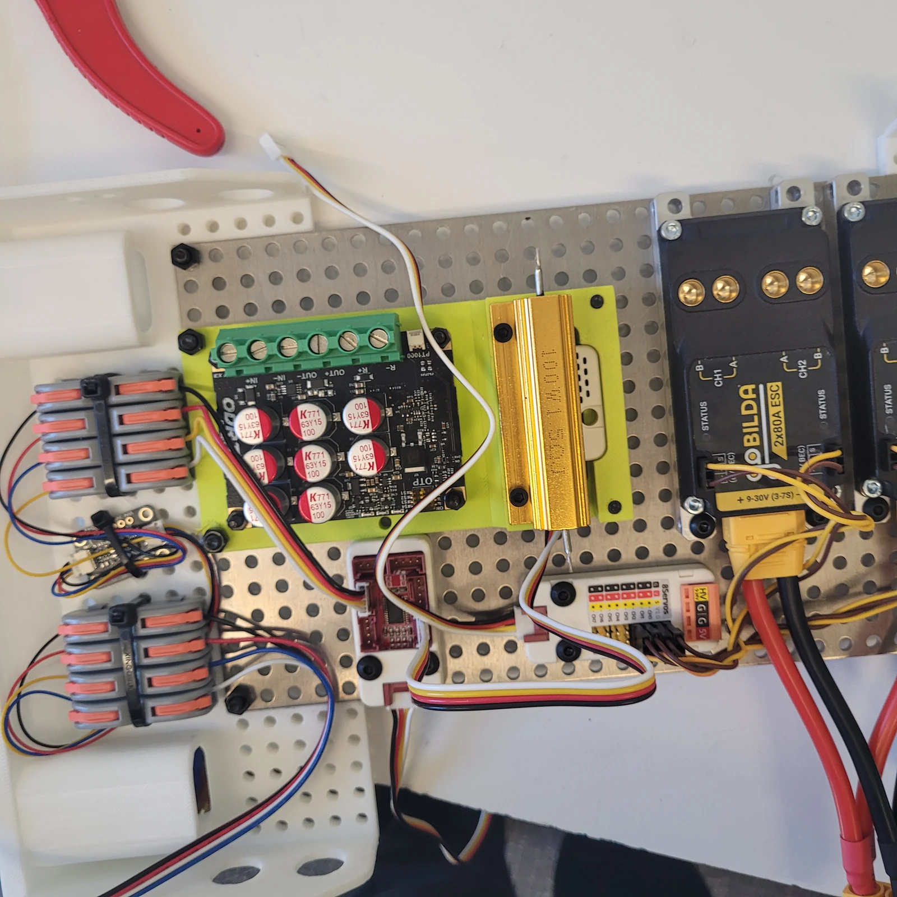
docs/assets/build/power-bay/06a-strip-spare-jst.webp
