UW-Allen-School-Robotics/opendubs/docs/assets/diagrams/e-stop-wiring-with-sup-estop.png

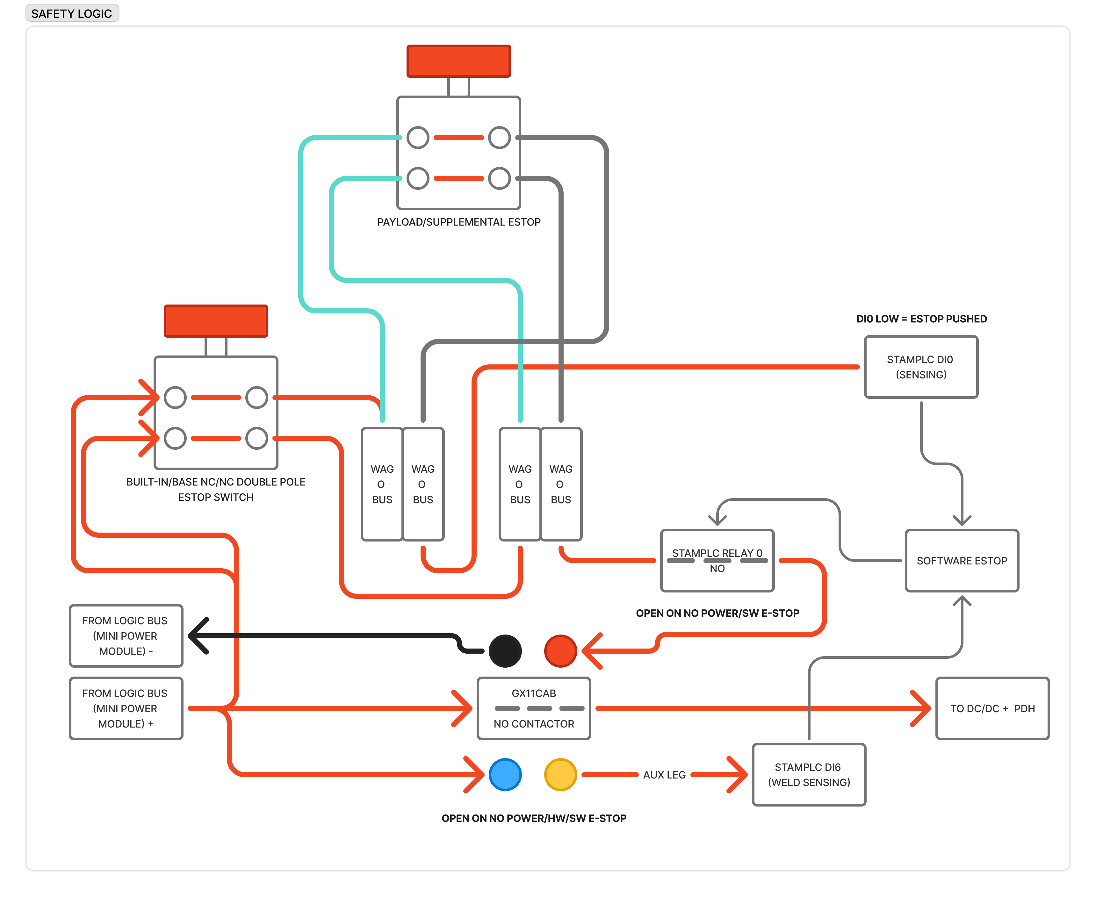
docs/assets/diagrams/e-stop-wiring-with-sup-estop.png
