UW-Allen-School-Robotics/opendubs/docs/assets/diagrams/e-stop-wiring.png

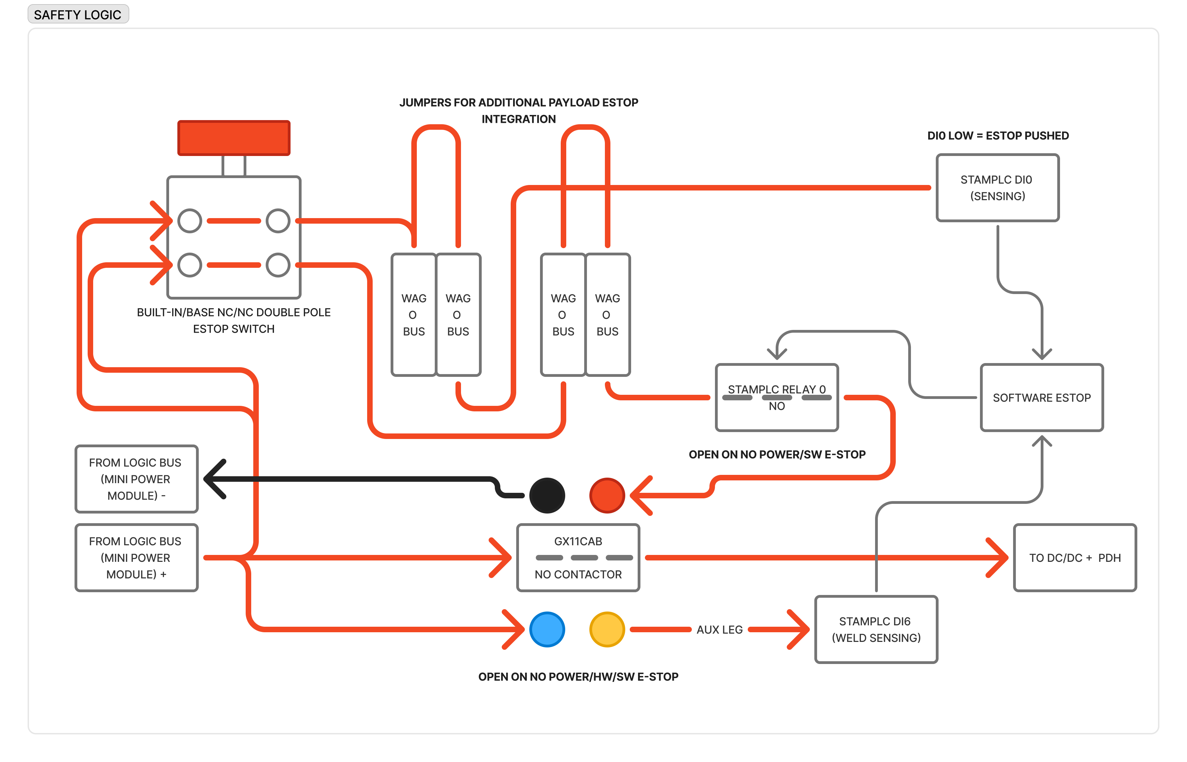
docs/assets/diagrams/e-stop-wiring.png
