UW-Allen-School-Robotics/opendubs/docs/assets/composer/composer-05-validate.png

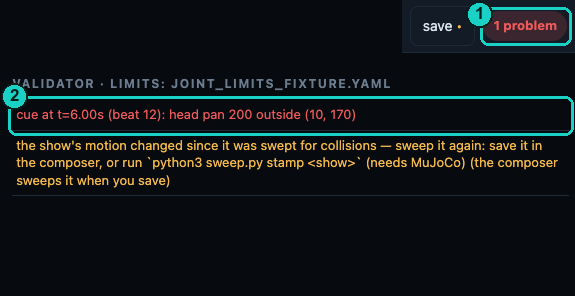
docs/assets/composer/composer-05-validate.png
