UW-Allen-School-Robotics/opendubs/description/opendubs/opendubs-femto-straight.urdf

<?xml version="1.0"?>
<!-- GENERATED by description/opendubs/gen_urdf.py from dimensions.yaml. Do not edit:
     change dimensions.yaml and re-run the generator.
     Head assembly fitted: galaxy_tablet; Femto mount: straight.
     base_link: centre of the wheel rectangle, axle height (workplan-thor-stack L.1).
     Movable joints zaxis / head_pan / head_tilt need a joint_states source.
     LEFT OUT (no CAD or measured position in the repo yet):
       - pinpoint_link (pinpoint)
       - tablet_front_camera_link (galaxy_tablet)
       - tablet_front_camera_optical_frame (follows tablet_front_camera_link)
       - tablet_rear_camera_link (galaxy_tablet)
       - tablet_rear_camera_optical_frame (follows tablet_rear_camera_link)
       - tablet_gps_link (galaxy_tablet)
       - tablet_imu_link (galaxy_tablet) -->
<robot name="opendubs">
  <material name="frame"><color rgba="0.55 0.57 0.6 1"/></material>
  <material name="plate"><color rgba="0.75 0.75 0.78 1"/></material>
  <material name="rubber"><color rgba="0.1 0.1 0.1 1"/></material>
  <link name="base_link"/>
  <link name="base_footprint"/>
  <joint name="base_footprint_joint" type="fixed">
    <parent link="base_link"/>
    <child link="base_footprint"/>
    <origin xyz="0 0 -0.07" rpy="0 0 0"/>
  </joint>
  <link name="datum">
    <visual>
      <origin xyz="0.29 0 0.154" rpy="0 0 0"/>
      <geometry><box size="0.644 0.649 0.404"/></geometry>
      <material name="frame"/>
    </visual>
  </link>
  <joint name="datum_joint" type="fixed">
    <parent link="base_link"/>
    <child link="datum"/>
    <origin xyz="-0.324 0 0.024" rpy="0 0 0"/>
  </joint>
  <link name="wheel_fl">
    <visual>
      <origin xyz="0 0 0" rpy="1.570796 0 0"/>
      <geometry><cylinder radius="0.07" length="0.05"/></geometry>
      <material name="rubber"/>
    </visual>
  </link>
  <joint name="wheel_fl_joint" type="fixed">
    <parent link="datum"/>
    <child link="wheel_fl"/>
    <origin xyz="0.528 0.2945 -0.024" rpy="0 0 0"/>
  </joint>
  <link name="wheel_fr">
    <visual>
      <origin xyz="0 0 0" rpy="1.570796 0 0"/>
      <geometry><cylinder radius="0.07" length="0.05"/></geometry>
      <material name="rubber"/>
    </visual>
  </link>
  <joint name="wheel_fr_joint" type="fixed">
    <parent link="datum"/>
    <child link="wheel_fr"/>
    <origin xyz="0.528 -0.2945 -0.024" rpy="0 0 0"/>
  </joint>
  <link name="wheel_rl">
    <visual>
      <origin xyz="0 0 0" rpy="1.570796 0 0"/>
      <geometry><cylinder radius="0.07" length="0.05"/></geometry>
      <material name="rubber"/>
    </visual>
  </link>
  <joint name="wheel_rl_joint" type="fixed">
    <parent link="datum"/>
    <child link="wheel_rl"/>
    <origin xyz="0.12 0.2945 -0.024" rpy="0 0 0"/>
  </joint>
  <link name="wheel_rr">
    <visual>
      <origin xyz="0 0 0" rpy="1.570796 0 0"/>
      <geometry><cylinder radius="0.07" length="0.05"/></geometry>
      <material name="rubber"/>
    </visual>
  </link>
  <joint name="wheel_rr_joint" type="fixed">
    <parent link="datum"/>
    <child link="wheel_rr"/>
    <origin xyz="0.12 -0.2945 -0.024" rpy="0 0 0"/>
  </joint>
  <link name="laser"/>
  <joint name="laser_joint" type="fixed">
    <parent link="datum"/>
    <child link="laser"/>
    <origin xyz="0.55438 0 0.2413" rpy="0 0 3.141593"/>
  </joint>
  <link name="laser_rear"/>
  <joint name="laser_rear_joint" type="fixed">
    <parent link="datum"/>
    <child link="laser_rear"/>
    <origin xyz="-0.199578 0 0.2413" rpy="0 0 0"/>
  </joint>
  <link name="lift_platform">
    <visual>
      <origin xyz="0.348 0 0.3571" rpy="0 0 0"/>
      <geometry><box size="0.4 0.32 0.001"/></geometry>
      <material name="plate"/>
    </visual>
    <visual>
      <origin xyz="0.4147 0 1.055875" rpy="0 0 0"/>
      <geometry><box size="0.14778 0.094 0.172"/></geometry>
      <material name="frame"/>
    </visual>
    <visual>
      <origin xyz="0.713 0.022 0.322305" rpy="0 0 0"/>
      <geometry><box size="0.232 0.424 0.0515"/></geometry>
      <material name="plate"/>
    </visual>
  </link>
  <joint name="zaxis" type="prismatic">
    <parent link="datum"/>
    <child link="lift_platform"/>
    <origin xyz="0 0 0" rpy="0 0 0"/>
    <axis xyz="0 0 1"/>
    <limit lower="0" upper="0.2751" effort="0" velocity="0"/>
  </joint>
  <link name="arm_mount"/>
  <joint name="arm_mount_joint" type="fixed">
    <parent link="lift_platform"/>
    <child link="arm_mount"/>
    <origin xyz="0.423 0 0.3575" rpy="0 0 0"/>
  </joint>
  <link name="head_pan_link">
    <visual>
      <origin xyz="-0.01 0 -0.0357" rpy="0 0 0"/>
      <geometry><box size="0.072 0.095 0.12"/></geometry>
      <material name="frame"/>
    </visual>
  </link>
  <joint name="head_pan" type="revolute">
    <parent link="lift_platform"/>
    <child link="head_pan_link"/>
    <origin xyz="0.423 0 1.245575" rpy="0 0 0"/>
    <axis xyz="0 0 1"/>
    <limit lower="-2.617994" upper="2.617994" effort="0" velocity="0"/>
  </joint>
  <link name="head_tilt_link">
    <visual>
      <origin xyz="0.03494 0 -0.015" rpy="0 0 0"/>
      <geometry><box size="0.10162 0.221 0.134"/></geometry>
      <material name="plate"/>
    </visual>
  </link>
  <joint name="head_tilt" type="revolute">
    <parent link="head_pan_link"/>
    <child link="head_tilt_link"/>
    <origin xyz="0 0 0" rpy="0 0 0"/>
    <axis xyz="0 1 0"/>
    <limit lower="-1.636246" upper="0.274889" effort="0" velocity="0"/>
  </joint>
  <link name="head_screen_link"/>
  <joint name="head_screen_link_joint" type="fixed">
    <parent link="head_tilt_link"/>
    <child link="head_screen_link"/>
    <origin xyz="0.0828 -0.00035 -0.01515" rpy="0 0 0"/>
  </joint>
  <link name="femto_mount_link">
    <visual>
      <origin xyz="-0.008125 0 0.000835" rpy="0 0 0"/>
      <geometry><box size="0.04625 0.1211 0.10105"/></geometry>
      <material name="frame"/>
    </visual>
    <visual>
      <origin xyz="0.00135 0 0.02751" rpy="0 0 0"/>
      <geometry><box size="0.0652 0.11516 0.0402"/></geometry>
      <material name="rubber"/>
    </visual>
  </link>
  <joint name="femto_mount_link_joint" type="fixed">
    <parent link="head_tilt_link"/>
    <child link="femto_mount_link"/>
    <origin xyz="0.05575 0 0.052" rpy="0 0 0"/>
  </joint>
  <link name="camera_link"/>
  <joint name="camera_link_joint" type="fixed">
    <parent link="femto_mount_link"/>
    <child link="camera_link"/>
    <origin xyz="0.03395 -0.03 0.02751" rpy="0 0.10472 0"/>
  </joint>
</robot>
