UW-Allen-School-Robotics/opendubs/firmware/rc_serial_probe/src/main.cpp

#include <Arduino.h>
#include <M5StamPLC.h>
#include <SPI.h>
#include <M5_Ethernet.h>   // PoE module W5500 (SPI on G7/G9/G8, CS G11)
#include "driver/uart.h"     // ESP-IDF UART for the RS485 port (BMS)
#include "esp_task_wdt.h"
#include "rc_config.h"
#include "mast.h"
#include "tof.h"
#include "ppcfg.h"    // task watchdog — auto-reset if the loop hangs
// THIS ROBOT's calibration and wiring (drive channels and signs, ESC shaping, lift relays). Per
// robot, never committed or deployed: create it from src/robot_config.h.example.
#if defined(__has_include)
#  if !__has_include("robot_config.h")
#    error "src/robot_config.h is missing: this robot's calibration. Copy src/robot_config.h.example and set this robot's values (or tools/make_robot_config.py from its older main.cpp). Never guess them."
#  endif
#endif
#include "robot_config.h"
#include <stdarg.h>          // tprintf() telemetry tee
#include <Update.h>          // ESP32 OTA writer — Ethernet firmware pull (OTA command)
#include "ota_verify.h"      // signed OTA: the shared check (firmware/common/ota_verify, firmware-signing.md)
#include "ota_keys.h"        // the signing keys this build trusts (generated from that library's keys/)
static constexpr const char* kOtaBoard = "stamplc";   // what our signatures must name
static bool ota_selftest_ok = false;   // set in setup(); a broken check accepts nothing (there is USB)
static char ota_key_ids[40] = "none";  // "id" or "id,id" during a rotation

// ---- Telemetry tee (USB Serial + PoE UDP) -------------------------------------------------
// Mirror a telemetry line to USB Serial AND, when the PoE link is up, out over UDP so the SAME
// [TAG] text protocol reaches the Thor over EITHER transport. Crucially the UDP send is
// INDEPENDENT of the USB TX buffer: with USB unplugged the CDC TX buffer fills and
// availableForWrite() drops to ~0, so we must NOT gate the UDP path on it — telemetry keeps
// flowing over Ethernet regardless. netSendLine() is defined with the Ethernet section below.
void netSendLine(const char* buf, int n);
static bool netBringUp(bool dhcp);   // Ethernet bring-up / self-heal — defined in the Ethernet section, used in setup()
static void netMaintain();           // Ethernet link watchdog — defined in the Ethernet section, used in loop()
static void otaHttpPull(const char* url);   // Ethernet OTA — HTTP-GET a .bin off the Thor and self-flash (OTA command)

static void temit(const char* buf, int n)   // raw line (already formatted, includes trailing \n)
{
    if (n <= 0) return;
    if (Serial.availableForWrite() >= n) Serial.write((const uint8_t*)buf, n);  // USB: drop, never block
    netSendLine(buf, n);                                                        // Ethernet: independent
}

#include "telem.h"
void tprintf(const char* fmt, ...)
{
    char buf[384];
    va_list ap; va_start(ap, fmt);
    int n = vsnprintf(buf, sizeof(buf), fmt, ap);
    va_end(ap);
    if (n < 0) return;
    if (n >= (int)sizeof(buf)) n = (int)sizeof(buf) - 1;   // truncated — still emit what we have
    temit(buf, n);
}

// From M5StamPLC/src/pin_config.h:
// STAMPLC_PIN_GROVE_BLUE_SDA = 5, STAMPLC_PIN_GROVE_BLUE_SCL = 4
static constexpr int kBluePortRxPin = 5;
static constexpr int kBluePortTxPin = 4;

// Port A = StamPLC Grove RED port (external I2C). pin_config.h:
//   STAMPLC_PIN_GROVE_RED_SDA = 2  (G2),  STAMPLC_PIN_GROVE_RED_SCL = 1  (G1).
// This is a SEPARATE bus from the internal peripheral bus (m5::In_I2C, I2C_NUM_0
// on G13/G15: INA226 0x40, RX8130 0x32, PI4IOE5V6408 0x43, LM75B 0x48, AW9523B 0x59).
// We bind our external scanner to Port A on I2C_NUM_1 so it can never fall back to
// the internal bus (which is what M5.Ex_I2C's default was doing before).
static constexpr int kPortASda = 2;   // G2
static constexpr int kPortAScl = 1;   // G1

// --- External I2C topology: M5Stack PaHUB (PCA9548A 1-to-6 mux) on Port A -------
// Devices were moved BEHIND the hub (2026-06). Each device access selects its
// channel first (selectChannel()); if no hub is detected at boot the firmware
// falls back to flat Port-A access so it still works without the hub. NOTE: some
// of these are Qwiic 3.3 V parts behind the 5 V level shifter — if one doesn't
// detect, suspect the level conversion on that channel, not the firmware.
static constexpr uint8_t kPaHubAddr          = 0x70;  // PCA9548A mux
static constexpr uint8_t kExtEncoderAddr     = 0x59;  // M5 ExtEncoder Unit (mast position)
static constexpr uint8_t kExtEncoderCountReg = 0x00;  // int32 count
static constexpr uint8_t kExtEncoderResetReg = 0x30;
static constexpr uint8_t kTofAddr            = 0x29;  // M5 ToF4M (VL53L1X)
static constexpr uint8_t kServo8Addr         = 0x25;  // M5 8Servo
static constexpr uint8_t kServo8ModeReg      = 0x00;  // per-pin mode  (MODE_REG + pin)
static constexpr uint8_t kServo8PulseReg     = 0x60;  // per-pin pulse (REG + pin*2), 16-bit LE us
static constexpr uint8_t kServo8ModeServoCtl = 3;     // SERVO_CTL_MODE
static constexpr uint32_t kServo8Hz          = 400000; // 8Servo bus speed

// ============================ DRIVE OUTPUT ================================
// RC/ROS command -> mixer -> 8Servo PWM -> two goBILDA 2x80A ESCs.
//
// SAFETY: DRIVE_ENABLE gates only the physical PWM write. The gate/arm/mix logic
// runs regardless and streams to [DRIVE] telemetry, so you can verify arming +
// protection on the bench with NO signal reaching the ESCs (flag = 0). Flip it to
// 1 only when the wheels may move. Even then the arm gate blocks output under any
// un-cleared condition, and the hardware e-stop CONTACTOR (relay 0, drive-24V bus)
// is the true motion kill — commanding neutral here is defense-in-depth.
#ifndef DRIVE_ENABLE
#define DRIVE_ENABLE 1   // ENABLED 2026-08-19: RC/ROS drive writes the ESCs (bench-verified map below)
#endif

// The 8Servo channel map, wheel signs, ESC shaping and lift relays are per robot: robot_config.h.
// ---- RC pan/tilt: the stick, straight to the head ---------------------------------
// Sent DIRECTLY to the Tab5 rather than relayed via the Thor: fewer hops, and the head keeps
// answering the sticks if the dashboard stops. The Thor supplies the address once (TAB5IP)
// and the StamPLC remembers it, so a Thor that dies later does not take pan/tilt with it.
//
// A RATE, not an angle. The stick is spring-centred — hold to move, release to stop — and
// the Tab5 owns the position, so two devices can never integrate separately and diverge.
static constexpr uint16_t kTab5Port   = 4242;
static constexpr uint16_t kHeadLocalPort = 5007;   // our end of the head link
static constexpr float    kHeadDps    = 60.0f;   // full stick = 60 deg/s
static constexpr uint32_t kHeadSendMs = 50;      // 20 Hz; the Tab5 expires it after 600 ms
static IPAddress g_tab5Ip;
static bool      g_haveTab5 = false;
// Its OWN socket, not the one used for telemetry broadcast and command receive. Sending on
// a W5500 socket that is bound for receive makes the driver tear the socket down and rebuild
// it around each send, which costs tens of milliseconds — and this transmits at 20 Hz while
// the operator is aiming, i.e. exactly when the control loop must not stall. The chip has
// eight sockets; spending one here is cheap.
// ONE SOCKET AT A TIME. The Ethernet library is built with MAX_SOCK_NUM 2 — eth_udp holds
// one, so a permanently-open second socket leaves ZERO for anything else, including the
// OTA's HTTP client. That is exactly what happened: the head socket opened the first time
// an operator aimed the stick, and every OTA afterwards silently failed to fetch while the
// board dutifully dropped its drive bus on each attempt. Recovering needed a physical reset.
//
// So the head socket is held only while actually aiming, and released shortly after. You do
// not reflash while aiming a head, so the two uses never need to overlap.
static EthernetUDP head_udp;
static bool        head_udp_open = false;
static uint32_t    head_last_tx_ms = 0;
static constexpr uint32_t kHeadIdleCloseMs = 1000;

static void headSocketClose()
{
    if (!head_udp_open) return;
    head_udp.stop();
    head_udp_open = false;
}
static uint32_t    g_headTx = 0;      // head packets actually put on the wire
static bool        g_headSockFail = false;   // begin() refused — no free W5500 socket?

// PWM MIRROR — a diagnostic, off by default.
//
// Duplicates one ESC's pulse onto a spare 8Servo channel driving an indicator light, so the
// 8Servo's ACTUAL PWM OUTPUT is visible during a wedge. It answers a question the I2C side
// cannot: when writes start failing, does the 8Servo keep emitting its last pulse (hardware
// timers alive, firmware hung) or stop emitting entirely (no signal -> ESC red fault)?
//
// Lived only on opendubs2 for weeks, which made it invisible to everyone reading the repo
// and put it one SD-card failure from being lost — and every telemetry change collided with
// it on deploy. Committed here, defaulting OFF, enabled at runtime: `MIRROR <wheel> <pin>`,
// `MIRROR OFF`. It refuses any pin already assigned to a drive channel.
static int8_t   g_mirrorSrc  = -1;    // wheel index 0..3 (FL,FR,RL,RR); -1 = off
static uint8_t  g_mirrorPin  = 4;     // spare 8Servo channel with the indicator light
static uint32_t g_mirrorFail = 0;

// AUTONOMOUS IS DELIBERATELY RESTRICTED until autonomy has been watched enough to trust it. Both
// limits live here so relaxing them is one edit in one place.
//
// The deadman: the firmware did NOT require it under AUTO — `autoAuth` alone fed the mixer, so CH5
// in AUTO plus any live publisher drove the robot with nothing held. Requiring a human to hold a
// switch is the wrong LONG-TERM design, since a planner cannot hold one and the point of autonomy
// is that nobody is standing there. It is the right default while we are still establishing
// whether the Pinpoint even reads the right way round.
//
// The cap SCALES rather than clamps, so limiting magnitude cannot rotate the direction the planner
// asked for. The CH8 speed knob multiplies it, keeping a physical throttle over a software driver.
static constexpr bool     kAutoRequiresDeadman = true;
static constexpr float    kAutoMaxUnit         = 0.35f;   // ceiling on |command| under AUTO

// kEscNeutralUs, kEscSpanUs, kEscSlewUs and kEscRevDwellTicks are per robot: robot_config.h.
static constexpr uint16_t kEscDeadzoneUs    = 6;      // treat |cmd|<this as 0 (matches the ESC ±10µs deadzone)
static constexpr uint32_t kArmHoldMs        = 2000;   // hold neutral this long, gate satisfied, to ARM the ESCs
// (kEscRevDwellTicks spreads regen on a direction flip so the bus clamp can absorb it: a full
// FWD→REV slam tripped the ESCs.)
static constexpr uint32_t kDriveTickMs      = 20;     // 50 Hz output (matches the 2x80A's expected RC rate)
static constexpr uint32_t kRosCmdTimeoutMs  = 250;    // autonomous heartbeat: a stale Thor/ROS cmd → neutral
// Build identity. An OTA that silently does not land is worse than one that fails: it leaves
// you reading stale firmware while believing you are testing a fix, which cost real time
// today. The flash script compares this across the reboot and refuses to claim success
// unless it changed.
static const char kBuildId[] = __DATE__ " " __TIME__;

static constexpr uint32_t kWdtTimeoutS      = 8;      // task watchdog: loop hang > this → auto chip reset

// ==== DRIVE-SAFE GATE ===============================================================
// Nothing may be commanded to move until the control loop is demonstrably RUNNING.
//
// The 8Servo is a hardware PWM generator: once written it holds that pulse forever, with no
// help from us. So the failsafe -- release the deadman, output goes neutral -- only exists
// while the loop is executing. A stalled loop does not stop the robot; it freezes whatever
// the robot was last told to do, and nothing can interrupt it.
//
// That happened. netMaintain() retried DHCP with a BLOCKING Ethernet.begin(mac, 4000, 1500)
// every 5 s until a lease arrived, so during boot the loop ran about one second in five.
// SBUS frames were lost in each 4 s stall (hence "RC keeps dropping out" with the
// transmitter plainly switched on), and twice an operator's legitimate deadman-held input
// was accepted just before a stall -- leaving the robot driving, uninterruptibly, until the
// loop came back. The 8 s task watchdog never fired because 4 s is well under it.
//
// The gate therefore keys on the property that actually matters -- is the loop keeping
// time -- rather than on any particular cause:
//
//   * minimum uptime, so early init noise is never mistaken for steady state
//   * RC continuously live, not merely live right now
//   * no long loop iteration recently
//
// It is CONTINUOUS, not boot-only. A stall at any point drops the gate and the robot must
// re-earn it, which is what makes this a fix for the class rather than for DHCP.
// Bytes of SBUS drained per loop iteration.
//
// This was 256, and that was too tight — my mistake, and an instructive one. The link
// delivers ~8.3 kB/s, so 256 bytes at 50 Hz gives 12.8 kB/s of drain: a margin of 1.5x that
// any latency eats. Once behind, the drain hit the cap on EVERY iteration and never caught
// up, so the UART buffer sat permanently full and the loop stalled 130-250 ms at a time —
// which dropped the drive-safe gate, which silently suppressed RC pan/tilt. A cap meant to
// stop a transient backlog monopolising one iteration created a permanent deficit instead.
//
// 1024 gives ~50 kB/s of drain capacity: it is never the binding constraint in steady state,
// and still bounds a backlog to a known worst case rather than handing over the whole ring.
static constexpr uint32_t kSbusBytesPerTick = 1024;
static constexpr uint32_t kBootSettleMs = 3000;   // never "safe" before this, whatever else says
static constexpr uint32_t kLoopStallMs  = 250;    // an iteration longer than this = a stall
static constexpr uint32_t kStableForMs  = 2000;   // ... and this much clean time to recover
static uint32_t g_lastStallMs = 0;                // last loop iteration that overran
static uint32_t g_lastRcGapMs = 0;                // last time RC was not live
static uint32_t g_worstLoopMs = 0;                // worst iteration seen (observability)
static bool     g_driveSafe   = false;
// Contactor auto-arm state. Declared here because the PRISM overlay reads g_autoArmWaiting far
// above autoArmTick's definition — see the CONTACTOR AUTO-ARM block for what these mean.
static bool     g_autoArmFired   = false;   // we have closed it once; never again this boot
static bool     g_autoArmBlocked = false;   // disabled for this boot (latched e-stop, or a weld)
static bool     g_autoArmWaiting = false;   // conditions unmet — drives the PRISM indication
static uint32_t g_autoArmBootMs  = 0;
static constexpr uint32_t kAutoArmSettleMs = 2500;   // let the loop, DI and RC settle first

// Which part of the loop overran. `loopmax` told us a 396 ms iteration happened at boot but
// not what did it, and guessing at that is how you end up "fixing" the wrong thing. PHASE()
// costs one millis() call per phase and names the offender.
static const char *g_phaseName = "?";
static uint32_t    g_phaseStartMs = 0;
static const char *g_worstPhase = "-";       // worst EVER, for telemetry
static uint32_t    g_worstPhaseMs = 0;
static uint32_t    g_iterSbusBytes = 0;      // bytes drained in the CURRENT iteration
static uint32_t    g_iterSbusUs = 0;         // ... and how long that took, in us
static uint32_t    g_iterSbusMaxUs = 0;      // worst SINGLE byte, in us
static const char *g_iterPhase = "-";        // worst in the CURRENT iteration
static uint32_t    g_iterPhaseMs = 0;
static inline void phaseBegin(const char *name)
{
    const uint32_t now = millis();
    if (g_phaseStartMs != 0) {
        const uint32_t d = now - g_phaseStartMs;
        // Per-iteration first: the all-time worst is the wrong thing to blame a specific
        // stall on, and reporting it as the cause sends you after the wrong phase entirely.
        if (d > g_iterPhaseMs)  { g_iterPhaseMs = d;  g_iterPhase = g_phaseName; }
        if (d > g_worstPhaseMs) { g_worstPhaseMs = d; g_worstPhase = g_phaseName; }
    }
    g_phaseName = name;
    g_phaseStartMs = now;
}
static inline void phaseIterReset() { g_iterPhase = "-"; g_iterPhaseMs = 0; }

static inline bool driveSafeNow()
{
    const uint32_t t = millis();
    return t > kBootSettleMs
        && (t - g_lastStallMs) > kStableForMs
        && (t - g_lastRcGapMs) > kStableForMs;
}
static constexpr uint32_t kRcTimeoutMs      = 500;    // RC FAILSAFE: no valid SBUS frame within this → NO-LINK (disarms drive, PRISM alarm)
static constexpr uint32_t kBmsQueryTimeoutMs = 200;   // JBD reply window: a PRESENT pack early-breaks in ~50-90 ms; must exceed its latency or frames cross/corrupt. Absent-pack stall is bounded by the backoff below, NOT this.
static constexpr uint16_t kSbusValidLo      = 160;    // analog stick floor: full deflection is ~172, so anything below is corrupt / a receiver failsafe-preset pegged to an extreme
static constexpr uint16_t kSbusValidHi      = 1840;   // analog stick ceiling: full deflection is ~1811, so anything above is corrupt / pegged
static constexpr uint32_t kBmsPollMs        = 1000;   // BMS auto-poll cadence while the pack is answering
static constexpr uint32_t kBmsBackoffMs     = 15000;  // after repeated no-replies, retry this slowly so an absent BMS can't starve the control loop
static constexpr int      kBmsFailBackoff   = 3;      // consecutive failed polls before backing off to kBmsBackoffMs
static constexpr int      kSbusCtr = 1000, kSbusHalf = 810;   // SBUS raw (~200..1820) → normalized -1..1
enum DriveMode { DM_MECANUM = 0, DM_SKID4 = 1, DM_DIFF2 = 2 };
static DriveMode g_driveMode         = DM_MECANUM;    // default; changed only by the DRIVEMODE command (software-only, no physical jumper)
static bool      g_driveModeOverride = false;         // true once a DRIVEMODE command has been issued

// Autonomous command from the Thor/ROS: host `DRIVE <fwd> <rot> <str>` (each -1..1).
// Under RC_AUTO authority this REPLACES the RC sticks as the command source. The
// timestamp is the heartbeat — if the Thor stops publishing, the cmd goes stale
// and drive falls to neutral (the autonomous equivalent of releasing the deadman).
struct RosDriveCmd { float fwd = 0, rot = 0, str = 0; uint32_t ms = 0; };

// Last commanded drive intent + derived turn direction — the single "movement intent" that
// feeds [DRIVE] telemetry, the DRIVE screen, the Tab5 chevrons, and the PRISM turn-signals.
// turn = net rightward intent (rotate right OR strafe right) → +1 right, -1 left, 0 straight.
static float g_intentFwd = 0, g_intentRot = 0, g_intentStr = 0;
static float g_wheelMix[4] = {0, 0, 0, 0};   // commanded mix (for the DRIVE screen; ESC output is arm-gated)
static float g_speed = 0;                    // CH8 speed knob 0..1 (DRIVE-screen annunciation)
static int   g_turnDir = 0;
static uint32_t g_turnTestUntil = 0;         // TURNTEST override window (bench PRISM turn-signal test)
// MASTTEST override: force the Z-axis hazard overlay without moving anything, so the colours
// and blink rates can be judged by eye with the lift unpowered. 0=off 1=up 2=down 3=hold.
static uint8_t  g_mastTest = 0;
static uint32_t g_mastTestUntil = 0;
static constexpr float kTurnIntentThresh = 0.15f;
static RosDriveCmd g_rosCmd;
// Z-axis intent from the Thor, same heartbeat discipline as the drive command.
struct RosMastCmd { float v = 0; uint32_t ms = 0; };
static RosMastCmd g_rosMast;

static bool     g_escArmed    = false;                 // ESCs have completed the neutral-hold arm
static uint32_t g_armStart_ms = 0;
static uint16_t g_escOut[4]   = {kEscNeutralUs, kEscNeutralUs, kEscNeutralUs, kEscNeutralUs};
static uint32_t g_s8Fail      = 0;                     // cumulative 8Servo I2C write failures (signal-dropout diag)
static uint32_t last_drive_ms = 0, last_drive_pub_ms = 0, last_rc_pub_ms = 0;
// =========================================================================

// ============================ RS485 (BMS) ================================
// Raw UART1 half-duplex probe for the ECO-WORTHY BMS on the RS485 port
// (TX=G0, RX=G39, DIR=G46 — the M5StamPLC library only offers a Modbus *slave*,
// so we drive the UART directly). Passive RX is logged as `[485] rx:`; host
// commands `RS485BAUD <n>`, `RS485TX <hex...>`, and `BMS` (JBD read-basic-info)
// drive active probing while we determine the battery's protocol/baud.
static constexpr uart_port_t kRs485Uart   = UART_NUM_1;
static constexpr int         kRs485TxPin  = 0, kRs485RxPin = 39, kRs485DirPin = 46;
static uint32_t g_rs485Baud = 9600;    // JBD BMS default; change with RS485BAUD
static bool     g_rs485Up   = false;

static void rs485Init(uint32_t baud)
{
    if (g_rs485Up) uart_driver_delete(kRs485Uart);
    uart_config_t cfg = {};
    cfg.baud_rate  = (int)baud;
    cfg.data_bits  = UART_DATA_8_BITS;
    cfg.parity     = UART_PARITY_DISABLE;
    cfg.stop_bits  = UART_STOP_BITS_1;
    cfg.flow_ctrl  = UART_HW_FLOWCTRL_DISABLE;
    cfg.source_clk = UART_SCLK_APB;
    uart_driver_install(kRs485Uart, 1024, 0, 0, NULL, 0);
    uart_param_config(kRs485Uart, &cfg);
    uart_set_pin(kRs485Uart, kRs485TxPin, kRs485RxPin, kRs485DirPin, UART_PIN_NO_CHANGE);
    uart_set_mode(kRs485Uart, UART_MODE_RS485_HALF_DUPLEX);   // DIR auto-driven as RTS
    g_rs485Baud = baud; g_rs485Up = true;
    Serial.printf("[485] init UART1 baud=%lu TX=%d RX=%d DIR=%d half-duplex\n",
                  (unsigned long)baud, kRs485TxPin, kRs485RxPin, kRs485DirPin);
}

// Drain RS485 RX (non-blocking) and log as hex. Called every loop.
static void rs485Poll()
{
    if (!g_rs485Up) return;
    uint8_t buf[160];
    int n = uart_read_bytes(kRs485Uart, buf, sizeof(buf), 0);
    if (n > 0) {
        Serial.printf("[485] rx %d:", n);
        for (int i = 0; i < n; ++i) Serial.printf(" %02X", buf[i]);
        Serial.println();
    }
}

// Parse a hex string ("DD A5 03 ..") → bytes. Skips any non-hex separators.
static int hexToBytes(const char* s, uint8_t* out, int maxlen)
{
    int n = 0, hi = -1;
    for (; *s && n < maxlen; ++s) {
        int v;
        if (*s >= '0' && *s <= '9')      v = *s - '0';
        else if (*s >= 'a' && *s <= 'f') v = *s - 'a' + 10;
        else if (*s >= 'A' && *s <= 'F') v = *s - 'A' + 10;
        else continue;
        if (hi < 0) hi = v; else { out[n++] = (uint8_t)((hi << 4) | v); hi = -1; }
    }
    return n;
}

static void rs485Send(const uint8_t* data, int len)
{
    if (!g_rs485Up) { Serial.println("[485] not initialized"); return; }
    Serial.printf("[485] tx %d:", len);
    for (int i = 0; i < len; ++i) Serial.printf(" %02X", data[i]);
    Serial.println();
    uart_write_bytes(kRs485Uart, (const char*)data, len);
    uart_wait_tx_done(kRs485Uart, pdMS_TO_TICKS(100));
}

// ---- JBD BMS reader (auto): protocol confirmed JBD @ 9600 (probed live). ----
static bool     g_bmsAuto   = true;    // auto-poll + emit [BMS]/[BMSC]; BMSAUTO 0 for manual probing

// ---- Non-blocking JBD/BMS poller (state machine) ----
// The JBD pack answers with ~100-200 ms latency; a blocking read that long stalls the
// 50 Hz control loop, which stops SBUS servicing and makes the dashboard see [RC] gaps /
// spurious NO-LINK. So we SEND a query, then poll the RS485 RX non-blocking (0-timeout)
// across loop iterations until the framed reply lands or a per-query timeout elapses —
// each loop pass costs a few µs. The interactive BMS/BMS_CELLS/RS485TX commands are
// independent (rs485Send + rs485Poll logging, used with BMSAUTO 0) so there's no contention.
enum BmsState { BMS_IDLE, BMS_WAIT_CELLS, BMS_WAIT_BASIC };
static BmsState g_bmsState    = BMS_IDLE;
static uint8_t  g_bmsBuf[96];
static int      g_bmsLen      = 0;
static uint32_t g_bmsSentMs   = 0;
static uint32_t g_bmsCycleMs  = 0;      // last poll-cycle start (throttle/backoff timer)
static int      g_bmsFail     = 0;
static bool     g_bmsAnswered = false;  // did the pack reply at all this cycle?
static float    g_cmin = 0, g_cmax = 0; // carried from the cells frame into the [BMS] line

// Fire a len=0 read query for `reg`; flush stale RX first. Non-blocking: no tx-done wait —
// the RS485 half-duplex driver manages DIR, and the reply can't arrive before the next poll.
static void bmsSend(uint8_t reg)
{
    uint8_t junk[64];
    while (uart_read_bytes(kRs485Uart, junk, sizeof(junk), 0) > 0) {}   // flush stale RX
    const uint16_t chk = (uint16_t)(0x10000u - reg);
    uint8_t q[7] = {0xDD, 0xA5, reg, 0x00, (uint8_t)(chk >> 8), (uint8_t)(chk & 0xFF), 0x77};
    uart_write_bytes(kRs485Uart, (const char*)q, 7);
    g_bmsLen = 0; g_bmsSentMs = millis();
}

// Non-blocking: accumulate whatever RX is available into g_bmsBuf; true once a full frame is in.
static bool bmsRxComplete()
{
    if (g_bmsLen < (int)sizeof(g_bmsBuf)) {
        int r = uart_read_bytes(kRs485Uart, g_bmsBuf + g_bmsLen, sizeof(g_bmsBuf) - g_bmsLen, 0);
        if (r > 0) g_bmsLen += r;
    }
    return (g_bmsLen >= 4 && g_bmsLen >= 4 + g_bmsBuf[3] + 3);
}

static bool bmsFrameValid() { return g_bmsLen >= 7 && g_bmsBuf[0] == 0xDD && g_bmsBuf[2] == 0x00; }

static void bmsDecodeCells()   // 0x04 → [BMSC] + cache cmin/cmax for the [BMS] line
{
    int ncell = g_bmsBuf[3] / 2; if (ncell > 16) ncell = 16;
    g_cmin = 1e9; g_cmax = -1e9;
    Serial.print("[BMSC]");
    for (int k = 0; k < ncell; ++k) {
        float cv = (float)((g_bmsBuf[4 + k*2] << 8) | g_bmsBuf[4 + k*2 + 1]) / 1000.0f;
        if (cv < g_cmin) g_cmin = cv;
        if (cv > g_cmax) g_cmax = cv;
        Serial.printf(" c%d=%.3f", k, cv);
    }
    Serial.println();
    g_bmsAnswered = true;
}

static void bmsDecodeBasic()   // 0x03 → [BMS]. Sign is JBD-native (+chg/−dsg); flip if inverted.
{
    const int n = g_bmsLen;
    const uint8_t* d = g_bmsBuf + 4;
    auto u16 = [&](int o) { return (int)((d[o] << 8) | d[o + 1]); };
    auto s16 = [&](int o) { return (int)(int16_t)((d[o] << 8) | d[o + 1]); };
    const float    v    = u16(0) / 100.0f;
    const float    i    = s16(2) / 100.0f;
    const uint16_t prot = (uint16_t)u16(16);
    const int      soc  = d[19];
    const int      nntc = d[22];
    float tmin = 1e9, tmax = -1e9;
    for (int k = 0; k < nntc && (23 + k * 2 + 1) <= (n - 4 - 3); ++k) {
        const float t = (u16(23 + k * 2) - 2731) / 10.0f;
        if (t < tmin) tmin = t;
        if (t > tmax) tmax = t;
    }
    const bool charging = i > 0.05f, discharging = i < -0.05f;
    tprintf("[BMS] soc=%d v=%.2f i=%.2f cmin=%.3f cmax=%.3f tmin=%.1f tmax=%.1f "
                  "chg=%d dsg=%d chgr=%d flags=0x%04X\n",
                  soc, v, i, g_cmin, g_cmax, tmin, tmax,
                  charging ? 1 : 0, discharging ? 1 : 0, charging ? 1 : 0, prot);
    g_bmsAnswered = true;
}

static void bmsBackoffTick()   // end-of-cycle: reset or count toward the slow-retry backoff
{
    if (g_bmsAnswered) { if (g_bmsFail) Serial.println("[BMS] pack online — resuming poll"); g_bmsFail = 0; }
    else if (g_bmsFail < 1000 && ++g_bmsFail == kBmsFailBackoff)
        Serial.printf("[BMS] no reply ×%d — backing off to %lus (RS485/pack absent?)\n",
                      kBmsFailBackoff, (unsigned long)(kBmsBackoffMs / 1000));
    g_bmsCycleMs = millis(); g_bmsState = BMS_IDLE;
}

// Called every loop iteration — NEVER blocks. Advances one step of the query/response cycle.
static void bmsStep()
{
    if (!g_rs485Up) return;
    const uint32_t interval = (g_bmsFail >= kBmsFailBackoff) ? kBmsBackoffMs : kBmsPollMs;
    switch (g_bmsState) {
        case BMS_IDLE:
            if (millis() - g_bmsCycleMs >= interval) {
                g_bmsAnswered = false; g_cmin = 0; g_cmax = 0;
                bmsSend(0x04); g_bmsState = BMS_WAIT_CELLS;
            }
            break;
        case BMS_WAIT_CELLS:
            if (bmsRxComplete()) {
                if (bmsFrameValid()) bmsDecodeCells();
                bmsSend(0x03); g_bmsState = BMS_WAIT_BASIC;
            } else if (millis() - g_bmsSentMs > kBmsQueryTimeoutMs) {
                bmsSend(0x03); g_bmsState = BMS_WAIT_BASIC;   // no cells this round; still try basic
            }
            break;
        case BMS_WAIT_BASIC:
            if (bmsRxComplete()) {
                if (bmsFrameValid() && g_bmsLen >= 27) bmsDecodeBasic();
                bmsBackoffTick();
            } else if (millis() - g_bmsSentMs > kBmsQueryTimeoutMs) {
                bmsBackoffTick();
            }
            break;
    }
}
// =========================================================================

// Payload mode — what the RIGHT STICK means. Two sticks, three things that want one, so a
// 3-position switch (CH7) arbitrates:
//
//   OFF       right stick vertical does nothing; horizontal still strafes. Floor driving,
//             and the Z-axis cannot be moved by the stick at all — which is the whole point:
//             the lift used to creep whenever the operator meant to drive.
//   Z-AXIS    vertical drives the lift; horizontal still strafes.
//   PAN-TILT  vertical tilts, horizontal pans. STRAFE IS UNAVAILABLE here — CH4 is doing
//             something else — but forward/reverse and rotate are untouched, so the robot
//             can still be repositioned tank-style while the head is being aimed.
//
// The left stick never changes meaning.
enum PayloadMode : uint8_t { PM_OFF = 0, PM_ZAXIS = 1, PM_PANTILT = 2 };
static PayloadMode g_payloadMode = PM_OFF;
// After a mode change the right stick MEANS something different, so it must be centred once
// before it is honoured again. Without this, flipping from PAN-TILT to Z-AXIS with the stick
// held down hands the lift a full-scale command the instant the switch clicks — and coming
// the other way, a stick held sideways would lurch the robot into a strafe.
static bool g_pmodeArmed = true;

// Decoded through rcUnit() rather than a raw threshold so a switch wired the other way round
// is fixed by RCCAL reversal instead of by editing firmware.
static PayloadMode computePayloadMode(const uint16_t *ch)
{
    const float u = rcUnit(FN_PMODE, ch);
    if (u < 0.33f) return PM_OFF;
    if (u < 0.75f) return PM_ZAXIS;
    return PM_PANTILT;
}

// PRISM state indicator: robot state -> PRISM PWM pulse (us), driven on 8Servo ch0.
// 580 = police (unambiguous alarm). Solid-color hues (1050-1949 sweep) are APPROXIMATE
// and meant to be tuned by eye — see the PRISM PWM/color table. Prism is on 8Servo pin 0.
static constexpr uint8_t  kPrismServoPin = 0;
static constexpr uint16_t kPrismPolice   = 580;    // flashing police -> alarm
static constexpr uint16_t kPrismAmber    = 1230;   // manual, deadman released (tuned: was 1280, read slightly green)
static constexpr uint16_t kPrismGreen    = 1430;   // manual, deadman held/live (tuned: was 1500, read too blue)
static constexpr uint16_t kPrismBlue     = 1633;   // mode OFF (idle)
static constexpr uint16_t kPrismAuto     = 2100;   // autonomous: violet PULSE (kinetic). Pulse range ~1950-2199; tune hue by eye.
static constexpr uint8_t kPinpointAddr       = 0x31;  // goBILDA Pinpoint odometry
static constexpr uint8_t kOtosAddr           = 0x17;  // SparkFun OTOS (optical tracking odo)
static constexpr uint8_t kEnvAddr            = 0x44;  // M5 ENV III SHT30 (temp/humidity); 2 units,
                                                     // one per PaHub channel, both @0x44 (mux-isolated)

// PaHUB channel assignments — corrected 2026-08-13 to the AS-WIRED robot from an I2C_SCAN
// (each device's fixed I2C address pinned its channel unambiguously). The prior 2026-06 map
// went stale after reassembly: the firmware was selecting the wrong channel for every device,
// so drive (8Servo), PRISM, and the scan all failed until this remap.
static constexpr uint8_t kChPrism      = 0;   // PRISM_LED 0x38 measured on ch0 (was 1)
static constexpr uint8_t kChServo8     = 1;   // 8Servo   0x25 measured on ch1 (was 5) — drive + PRISM PWM
static constexpr uint8_t kChEnv        = 2;   // ENVIII SHT30 0x44 on ch2 (NEW — regen-resistor thermal)
static constexpr uint8_t kChTof        = 3;   // M5 ToF4M (VL53L1X) 0x29 — mast height
static constexpr uint8_t kChExtEncoder = 3;   // ExtEncoder 0x59 (currently absent)
static constexpr uint8_t kChPinpoint   = 4;   // Pinpoint 0x31 measured on ch4 (was 0)
static constexpr uint8_t kChOtos       = 5;   // OTOS     0x17 measured on ch5 (was 4)

// goBILDA PRISM RGB LED driver (Port A I2C). Protocol from the goBILDA_Prism
// Arduino library: writes are [register, payload...]. CONTROL=6 carries strip
// length/clear; per-layer animation regs live at ANIMATION_SLOT_0(8)+layer.
static constexpr uint8_t kPrismAddr        = 0x38;
static constexpr uint8_t kPrismRegControl  = 6;   // CONTROL
static constexpr uint8_t kPrismRegLayer0   = 8;   // ANIMATION_SLOT_0 (LAYER_0)
static constexpr uint8_t kPrismAnimSolid   = 1;   // AnimationType::SOLID
// Per-layer animation sub-registers:
static constexpr uint8_t kPrismSubSelect   = 0x00;  // AnimationSelection
static constexpr uint8_t kPrismSubBright   = 0x01;  // Brightness (0-100)
static constexpr uint8_t kPrismSubStart    = 0x02;  // StartIndex
static constexpr uint8_t kPrismSubStop     = 0x03;  // StopIndex
static constexpr uint8_t kPrismSubPrimary  = 0x04;  // PrimaryColor (r,g,b)
// PRISM strip = 48 LEDs, daisy-chained. Segment map (order from the strip start = RIGHT FRONT):
//   [ 0.. 5] RIGHT FRONT  (6)   [ 6..11] RIGHT REAR (6)   [12..23] CENTER REAR  (12)
//   [24..29] LEFT REAR    (6)   [30..35] LEFT FRONT (6)   [36..47] CENTER FRONT (12)
// Whole-strip solid color (state) lights all 48; per-segment control (turn signals / per-side
// status) uses these index ranges via the layer start/stop registers — TODO.
static uint8_t prism_strip_len = 48;

m5::I2C_Class* extI2C = nullptr;

// Expected device map behind the PaHUB (channel, addr, name) — drives the scan
// report + per-device channel routing.
struct HubDevice { uint8_t channel; uint8_t addr; const char* name; };
static const HubDevice kHubDevices[] = {
    {kChPrism,      kPrismAddr,      "PRISM_LED"},
    {kChServo8,     kServo8Addr,     "8Servo"},
    {kChEnv,        kEnvAddr,        "ENVIII_z0"},   // ch2 — regen clamp resistor
    {kChExtEncoder, kEnvAddr,        "ENVIII_z1"},   // ch3 — 2nd probe (not yet wired; ExtEncoder deferred)
    {kChPinpoint,   kPinpointAddr,   "Pinpoint"},
    {kChOtos,       kOtosAddr,       "OTOS"},
};
static bool g_paHubPresent = false;   // detected at boot
static int  g_currentHubCh = -1;      // last-selected channel (cache)

// Defined further down; forward-declared so selectChannel() can use them.
bool probeI2CAddress(m5::I2C_Class& i2c, uint8_t addr);
bool selectPaHubChannel(m5::I2C_Class& i2c, uint8_t channel);

// Route the external bus to a device's PaHUB channel before access. No-op when no
// hub was detected (flat wiring). Caches the current channel to skip redundant selects.
bool selectChannel(uint8_t channel)
{
    if (!g_paHubPresent) return true;
    if (g_currentHubCh == static_cast<int>(channel)) return true;
    if (selectPaHubChannel(*extI2C, channel)) { g_currentHubCh = channel; return true; }
    g_currentHubCh = -1;
    return false;
}

struct UartProfile {
    const char* name;
    uint32_t baud;
    uint32_t config;
    bool inverted;
};

static const UartProfile kProfiles[] = {
    {"SBUS (inverted)", 100000, SERIAL_8E2, true},
};

// Per-frame [SBUS] OK line is debug only (RC telemetry the dashboard uses comes from [RC]
// @10Hz + the 1 Hz [SBUS] status line). At ~83 frames/s, printing every frame was ~83
// lines/s — the dominant serial firehose that filled the USB-CDC buffer and stalled the
// loop on Serial.printf whenever the host reader hiccuped. Throttle to ~2/s.
static constexpr uint16_t kSbusPrintEveryNFrames = 40;
static constexpr uint32_t kPdhSetSwitchChannelFrameBase = 0x8050840u;
static constexpr uint32_t kPdhStatus0FrameBase          = 0x8051800u;
static constexpr uint32_t kPdhStatus1FrameBase          = 0x8051840u;
static constexpr uint32_t kPdhStatus2FrameBase          = 0x8051880u;
static constexpr uint32_t kPdhStatus3FrameBase          = 0x80518C0u;
static constexpr uint32_t kPdhStatus4FrameBase          = 0x8051900u;
static constexpr uint32_t kPdhClearFaultsFrameBase      = 0x8051B80u;
static constexpr uint32_t kPdhFrameApiMask              = 0x1FFFFFC0u;
static constexpr uint32_t kPdhDeviceIdMask              = 0x3Fu;
static constexpr uint8_t kCanMaxMsgsPerLoop             = 8;
static constexpr uint32_t kCanBudgetUs                  = 700;

HardwareSerial& rc = Serial2;
// Latest decoded RC state, mirrored from consumeByte() for the local UI.
static uint16_t rc_ch[16] = {0};
static bool     rc_failsafe = false;
static bool     rc_frame_lost = false;
static bool     rc_range_bad = false;   // a drive stick pegged outside the plausible SBUS band → treat as failsafe

static inline bool sbusInBand(uint16_t v) { return v >= kSbusValidLo && v <= kSbusValidHi; }

// True only if the USB-CDC TX buffer has room for a full line — so a high-rate telemetry
// print can be SKIPPED (dropped) rather than blocking the control loop when the host reader
// lags. The dashboard keeps last values, so an occasional dropped line is harmless.
static inline bool txReady(int need) { return Serial.availableForWrite() >= need; }
unsigned long last_valid_frame_ms = 0;
unsigned long last_status_ms = 0;
unsigned long last_i2c_scan_ms = 0;
unsigned long last_sens_ms = 0;
unsigned long last_can_status_ms = 0;
unsigned long last_can_rx_ms = 0;
unsigned long last_pdh_pub_ms = 0;
unsigned long last_io_pub_ms = 0;
unsigned long total_bytes = 0;
uint32_t valid_frames = 0;
uint32_t invalid_frames = 0;
uint32_t can_rx_frames = 0;
uint32_t can_rx_std_unique = 0;
uint32_t can_rx_ext_unique = 0;
uint8_t pdh_device_id = 1;
bool pdh_id_locked = false;

struct PdhState {
    bool s0_seen = false;
    bool s1_seen = false;
    bool s2_seen = false;
    bool s3_seen = false;
    bool s4_seen = false;
    float channel_a[24] = {0.0f};
    bool breaker_fault[24] = {false};   // live per-channel breaker/fuse fault (Status0-3)
    uint32_t sticky_breaker = 0;        // latched per-channel breaker faults (Status4)
    float v_bus = 0.0f;
    float total_current = 0.0f;
    float total_power = 0.0f;
    float energy_wh = 0.0f;
    bool switch_channel = false;
    bool brownout_fault = false;
    bool can_warning_fault = false;
    bool hardware_fault = false;
    unsigned long last_update_ms = 0;
    unsigned long last_s4_ms = 0;
};

PdhState pdh;

static bool can_std_seen[2048] = {false};
static uint32_t can_ext_seen[64] = {0};
static uint8_t can_ext_seen_count = 0;
char host_cmd_buf[96] = {0};
size_t host_cmd_len = 0;

uint8_t frame_buf[25];
size_t frame_pos = 0;

// ================= Local UI: onboard screen + buttons + status LED =================
// Shows safety + health straight from THIS MCU — valid even when Thor / ROS / the
// dashboard is down. Deliberately NOT a copy of the touchscreen. Safety rule: buttons
// may only DE-energize (BtnC hold = local e-stop); re-arm stays host/dashboard-guarded.
static M5Canvas*     ui_canvas          = nullptr;
static int           ui_page            = 0;      // 0 = HEALTH, 1 = SAFETY
static const int     kUiPages           = 2;
static unsigned long ui_last_draw_ms    = 0;
unsigned long        last_host_cmd_ms   = 0;       // 0 = host never seen (bench/headless)
static bool          local_estop_active = false;   // latched by BtnC; cleared by host re-arm
static bool          estopc_down        = false;
static bool          estopc_fired       = false;
static unsigned long estopc_start_ms    = 0;
static const uint32_t kEstopHoldMs      = 1500;    // hold-to-confirm to avoid accidental trip
static unsigned long identify_until_ms  = 0;
static uint32_t      ui_last_fault_mask = 0;

// --- PoE W5500 Ethernet state ---
static bool           eth_up = false;
static unsigned long  last_eth_ms = 0;
static EthernetUDP     eth_udp;
static IPAddress       eth_bcast;
static char            eth_ip_str[20] = "--";
static unsigned long   last_net_tx = 0;
static uint8_t        eth_mac[6]  = {0};      // filled in setup() from the eFuse MAC; reused for self-heal re-init
static IPAddress      eth_cfg_ip, eth_cfg_dns, eth_cfg_gw, eth_cfg_subnet;  // DHCP-acquired, re-asserted statically on self-heal
static bool           eth_have_cfg = false;   // we have a captured address to re-assert
static uint16_t       eth_reinit_count = 0;   // self-heal re-inits since boot (observability)
static uint8_t        eth_link_down_ticks = 0;
static unsigned long  last_eth_reinit_ms = 0;
static unsigned long  last_hb_rx_ms = 0;       // last time we RECEIVED a Thor "HB" over UDP (RX proof-of-life)
static bool           hb_seen = false;         // we've heard at least one HB → the watchdog is armed
static constexpr uint32_t kHbTimeoutMs = 6000; // no HB for this long (while link reads up) ⇒ RX wedged ⇒ re-init
static uint32_t        net_seq = 0;
static const uint16_t  kNetPort = 5005;

static inline uint32_t unpackBitsLE(const uint8_t* data, uint8_t start_bit, uint8_t bit_len)
{
    uint32_t out = 0;
    for (uint8_t i = 0; i < bit_len; ++i) {
        const uint8_t bit = start_bit + i;
        if (data[bit / 8] & (1u << (bit % 8))) {
            out |= (1u << i);
        }
    }
    return out;
}

static inline bool isPdhFrame(uint32_t id, uint32_t base)
{
    return (id & kPdhFrameApiMask) == base;
}

void publishPdhSummary()
{
    tprintf("[PDH] stat id=%u v=%.3fV i=%.1fA p=%.1fW e=%.3fWh sw=%d brn=%d can=%d hw=%d seen=%d%d%d%d%d\n",
                  static_cast<unsigned>(pdh_device_id),
                  pdh.v_bus,
                  pdh.total_current,
                  pdh.total_power,
                  pdh.energy_wh,
                  pdh.switch_channel ? 1 : 0,
                  pdh.brownout_fault ? 1 : 0,
                  pdh.can_warning_fault ? 1 : 0,
                  pdh.hardware_fault ? 1 : 0,
                  pdh.s0_seen ? 1 : 0,
                  pdh.s1_seen ? 1 : 0,
                  pdh.s2_seen ? 1 : 0,
                  pdh.s3_seen ? 1 : 0,
                  pdh.s4_seen ? 1 : 0);

    tprintf("[PDH] ch c0=%.3f c1=%.3f c2=%.3f c3=%.3f c4=%.3f c5=%.3f c6=%.3f c7=%.3f c8=%.3f c9=%.3f c10=%.3f c11=%.3f c12=%.3f c13=%.3f c14=%.3f c15=%.3f c16=%.3f c17=%.3f c18=%.3f c19=%.3f c20=%.3f c21=%.3f c22=%.3f c23=%.3f\n",
                  pdh.channel_a[0], pdh.channel_a[1], pdh.channel_a[2], pdh.channel_a[3], pdh.channel_a[4], pdh.channel_a[5],
                  pdh.channel_a[6], pdh.channel_a[7], pdh.channel_a[8], pdh.channel_a[9], pdh.channel_a[10], pdh.channel_a[11],
                  pdh.channel_a[12], pdh.channel_a[13], pdh.channel_a[14], pdh.channel_a[15], pdh.channel_a[16], pdh.channel_a[17],
                  pdh.channel_a[18], pdh.channel_a[19], pdh.channel_a[20], pdh.channel_a[21], pdh.channel_a[22], pdh.channel_a[23]);

    uint32_t live = 0;
    for (int i = 0; i < 24; ++i)
        if (pdh.breaker_fault[i]) live |= (1u << i);
    tprintf("[PDH] flt live=0x%06lX sticky=0x%06lX\n",
                  static_cast<unsigned long>(live),
                  static_cast<unsigned long>(pdh.sticky_breaker));
}

bool sendPdhSwitchCommand(bool enabled)
{
    twai_message_t tx = {};
    tx.identifier = (kPdhSetSwitchChannelFrameBase | (pdh_device_id & kPdhDeviceIdMask));
    tx.extd = 1;
    tx.rtr = 0;
    tx.data_length_code = 1;
    tx.data[0] = enabled ? 1 : 0;
    return twai_transmit(&tx, 0) == ESP_OK;
}

bool sendPdhClearFaultsCommand()
{
    twai_message_t tx = {};
    tx.identifier = (kPdhClearFaultsFrameBase | (pdh_device_id & kPdhDeviceIdMask));
    tx.extd = 1;
    tx.rtr = 0;
    tx.data_length_code = 0;
    return twai_transmit(&tx, 0) == ESP_OK;
}

bool readExtEncoder(int32_t& out)
{
    if (extI2C == nullptr || !extI2C->isEnabled()) return false;
    if (!selectChannel(kChExtEncoder)) return false;
    uint8_t b[4];
    if (!extI2C->readRegister(kExtEncoderAddr, kExtEncoderCountReg, b, 4, 400000)) return false;
    out = static_cast<int32_t>(static_cast<uint32_t>(b[0]) | (static_cast<uint32_t>(b[1]) << 8) |
                               (static_cast<uint32_t>(b[2]) << 16) | (static_cast<uint32_t>(b[3]) << 24));
    return true;
}

// ================= goBILDA Pinpoint odometry (0x31, PaHub ch4) =================
// Protocol per goBILDA's official Arduino library. Registers are INDEXED 4-BYTE WORDS: write the
// one-byte register index, then read 4 bytes little-endian. Pose/velocity are IEEE-754 floats
// (position in mm, heading in radians); encoder counts and status are integers. Newer Pinpoint
// firmware appends a CRC8 byte — we request only 4 bytes and simply never read it, which is
// harmless. DEVICE_ID reads 2 on a genuine Pinpoint; we use that to confirm identity.
static constexpr uint8_t kPpRegDeviceId  = 1;
static constexpr uint8_t kPpRegStatus    = 3;
static constexpr uint8_t kPpRegLoopTime  = 5;
static constexpr uint8_t kPpRegEncX      = 6;
static constexpr uint8_t kPpRegEncY      = 7;
static constexpr uint8_t kPpRegPosX      = 8;
static constexpr uint8_t kPpRegPosY      = 9;
static constexpr uint8_t kPpRegHeading   = 10;
static constexpr uint8_t kPpRegVelX      = 11;
static constexpr uint8_t kPpRegVelY      = 12;
static constexpr uint8_t kPpRegVelH      = 13;
static constexpr uint8_t kPpDeviceIdVal  = 2;

// Cached last-good Pinpoint state (published even when a frame is missed, with ok=0).
// pp_frame_ok is "did the last poll succeed" — the [ODO] ok= flag. pp_present is DEBOUNCED:
// it goes false only after kPpFailBeforeAbsent misses in a row. They used to be one flag, so
// a single glitched read looked like a reboot to ppcfg, which re-zeroed the IMU mid-drive.
// A gyro zeroed while the robot moves keeps reporting that motion: heading spun at up to
// 1.3 rad/s with the robot parked (2026-09-21).
static bool     pp_present = false;
static bool     pp_frame_ok = false;
static uint16_t pp_fail_run = 0;
static constexpr uint16_t kPpFailBeforeAbsent = 10;   // ~1 s of consecutive misses at 10 Hz
static uint32_t pp_status = 0, pp_loop_us = 0, pp_fails = 0;
static int32_t  pp_encx = 0, pp_ency = 0;
static float    pp_x = 0, pp_y = 0, pp_h = 0, pp_vx = 0, pp_vy = 0, pp_vh = 0;

// The Pinpoint requires a STOP between the register-pointer write and the read -- goBILDA's own
// library does endTransmission(TRUE). readRegister() issues a repeated start instead, which the
// device does not answer (the address probe still ACKs, so it looks present but every register
// read fails). Compose the two transactions explicitly. Also 100 kHz, not 400: the Pinpoint sits
// behind the 3.3/5 V level shifter, where fast edges are marginal.
static constexpr uint32_t kPpHz = 100000;

// CRC-8, poly 0x31, init 0x00, MSB-first — matches goBILDA's crc8_table (CRC(0x01)==0x31).
// Newer Pinpoint firmware appends this byte after the 4 data bytes. Without checking it,
// occasional corrupt frames sail through as plausible-looking floats (we saw y=-nan and
// loop=4294967143), which is far worse than a dropped frame.
static uint8_t ppCrc8(const uint8_t *d, size_t n)
{
    uint8_t c = 0;
    for (size_t i = 0; i < n; ++i) {
        c ^= d[i];
        for (int b = 0; b < 8; ++b) c = (c & 0x80) ? (uint8_t)((c << 1) ^ 0x31) : (uint8_t)(c << 1);
    }
    return c;
}

static int pp_crc_mode = -1;      // -1 = probe, 1 = device sends CRC, 0 = it does not
static uint32_t pp_crc_bad = 0;

static bool ppXfer(uint8_t reg, uint8_t *buf, uint8_t n)
{
    if (!extI2C->start(kPinpointAddr, false, kPpHz)) return false;   // write mode
    if (!extI2C->write(reg)) { extI2C->stop(); return false; }
    extI2C->stop();                                                   // STOP, not repeated start
    if (!extI2C->start(kPinpointAddr, true, kPpHz)) return false;     // read mode
    const bool ok = extI2C->read(buf, n, true);
    extI2C->stop();
    return ok;
}

static bool ppRead32(uint8_t reg, uint8_t *b4)
{
    if (extI2C == nullptr || !extI2C->isEnabled()) return false;
    if (!selectChannel(kChPinpoint)) return false;

    if (pp_crc_mode != 0) {                       // try the 5-byte (data+CRC) form
        uint8_t b5[5];
        if (ppXfer(reg, b5, 5)) {
            if (ppCrc8(b5, 4) == b5[4]) { memcpy(b4, b5, 4); pp_crc_mode = 1; return true; }
            if (pp_crc_mode == 1) { pp_crc_bad++; return false; }   // known-CRC device: reject
        }
        if (pp_crc_mode == -1) pp_crc_mode = 0;   // no CRC on this firmware — fall through
    }
    return ppXfer(reg, b4, 4);
}

static bool ppU32(uint8_t reg, uint32_t *out)
{
    uint8_t b[4]; if (!ppRead32(reg, b)) return false;
    *out = (uint32_t)b[0] | ((uint32_t)b[1] << 8) | ((uint32_t)b[2] << 16) | ((uint32_t)b[3] << 24);
    return true;
}
static bool ppI32(uint8_t reg, int32_t *out)
{ uint32_t u; if (!ppU32(reg, &u)) return false; *out = (int32_t)u; return true; }
static bool ppF32(uint8_t reg, float *out)
{ uint32_t u; if (!ppU32(reg, &u)) return false; memcpy(out, &u, sizeof(u)); return true; }

// One poll of the whole pose. Any failed register aborts the frame so we never publish a
// half-updated pose (mixing a new X with a stale Y would look like a real jump).
// One missed frame is a bus glitch, not a missing device.
static void ppNoteMiss()
{
    pp_fails++;
    pp_frame_ok = false;
    if (pp_fail_run < 0xFFFF) pp_fail_run++;
    if (pp_fail_run >= kPpFailBeforeAbsent) pp_present = false;
}

static void pinpointPoll()
{
    uint32_t id = 0;
    if (!ppU32(kPpRegDeviceId, &id) || id != kPpDeviceIdVal) { ppNoteMiss(); return; }
    uint32_t st = 0, lt = 0; int32_t ex = 0, ey = 0;
    float x = 0, y = 0, h = 0, vx = 0, vy = 0, vh = 0;
    const bool ok = ppU32(kPpRegStatus, &st) && ppU32(kPpRegLoopTime, &lt)
                 && ppI32(kPpRegEncX, &ex)   && ppI32(kPpRegEncY, &ey)
                 && ppF32(kPpRegPosX, &x)    && ppF32(kPpRegPosY, &y)  && ppF32(kPpRegHeading, &h)
                 && ppF32(kPpRegVelX, &vx)   && ppF32(kPpRegVelY, &vy) && ppF32(kPpRegVelH, &vh);
    if (!ok) { ppNoteMiss(); return; }
    pp_fail_run = 0; pp_frame_ok = true; pp_present = true;
    pp_status = st; pp_loop_us = lt;
    pp_encx = ex; pp_ency = ey;
    pp_x = x; pp_y = y; pp_h = h; pp_vx = vx; pp_vy = vy; pp_vh = vh;
}

// Is the robot genuinely still? Only then may the Pinpoint re-measure its IMU zero, which
// takes ~0.25 s and bakes in whatever motion it sees. Still = not commanded (every ESC output
// at neutral) AND not moving (pod counts steady) for kPpStillMs. Both, because the robot can
// coast after the sticks centre, or be pushed by hand with nothing commanded.
static constexpr uint32_t kPpStillMs    = 1500;
static constexpr int32_t  kPpStillTicks = 40;   // ~3 mm on a swingarm pod; at rest counts jitter ~±20
static bool ppRobotStill(uint32_t nowMs)
{
    static uint32_t sinceMs = 0;
    static int32_t  refX = 0, refY = 0;
    bool moving = !pp_frame_ok || sinceMs == 0;
    for (int i = 0; i < 4 && !moving; ++i)
        if (abs((int)g_escOut[i] - (int)kEscNeutralUs) > (int)kEscDeadzoneUs) moving = true;
    if (!moving && (abs(pp_encx - refX) > kPpStillTicks || abs(pp_ency - refY) > kPpStillTicks))
        moving = true;
    if (moving) { sinceMs = nowMs; refX = pp_encx; refY = pp_ency; }
    return nowMs - sinceMs >= kPpStillMs;
}

// [ODO] — pose in mm / rad, plus the raw pod counts and the device status bitfield.
// Status bits (goBILDA): b0 !ready, b1 calibrating, b2 X pod, b3 Y pod, b4 IMU runaway,
// b5 bad write CRC, b6 bad read.
static void publishOdo()
{
    // DEVICE_STATUS bits per goBILDA's FTC driver enum (authoritative):
    //   b0 READY | b1 CALIBRATING | b2 FAULT_X_POD_NOT_DETECTED | b3 FAULT_Y_POD_NOT_DETECTED
    //   b4 FAULT_IMU_RUNAWAY | b5 FAULT_BAD_READ
    // NOTE the pod bits are FAULT flags: SET means the pod is MISSING, not present.
    tprintf("[ODO] ok=%d st=0x%02X rdy=%d cal=%d xpod=%d ypod=%d imurun=%d badread=%d "
            "x=%.1f y=%.1f h=%.4f vx=%.1f vy=%.1f vh=%.4f "
            "ex=%ld ey=%ld loop=%lu fail=%lu crcbad=%lu imupend=%d\n",
            pp_frame_ok ? 1 : 0, (unsigned)(pp_status & 0xFF),
            (pp_status & 0x01) ? 1 : 0, (pp_status & 0x02) ? 1 : 0,
            (pp_status & 0x04) ? 0 : 1, (pp_status & 0x08) ? 0 : 1,
            (pp_status & 0x10) ? 1 : 0, (pp_status & 0x20) ? 1 : 0,
            pp_x, pp_y, pp_h, pp_vx, pp_vy, pp_vh,
            (long)pp_encx, (long)pp_ency,
            (unsigned long)pp_loop_us, (unsigned long)pp_fails, (unsigned long)pp_crc_bad,
            ppCfgImuPending() ? 1 : 0);
}

void publishIo()
{
    // No txReady() gate: tprintf() self-guards the USB write + always tees over Ethernet.
    uint8_t di = 0;
    for (uint8_t i = 0; i < 8; ++i)
        if (M5StamPLC.readPlcInput(i)) di |= (1u << i);
    uint8_t relay = 0;
    for (uint8_t i = 0; i < 4; ++i)
        if (M5StamPLC.readPlcRelay(i)) relay |= (1u << i);
    tprintf("[IO] di=0x%02X relay=0x%01X temp=%.1f isocket=%.3f\n",
                  di, relay, M5StamPLC.getTemp(), M5StamPLC.getIoSocketOutputCurrent());

    int32_t enc = 0;
    if (readExtEncoder(enc))
        tprintf("[ENC] mast=%ld present=1\n", static_cast<long>(enc));
    else
        Serial.println("[ENC] mast=0 present=0");
}

// --- goBILDA PRISM RGB driver (raw I2C, replicating goBILDA_Prism lib) ---
bool prismWrite(uint8_t reg, const uint8_t* data, size_t len)
{
    if (extI2C == nullptr || !extI2C->isEnabled()) return false;
    if (!selectChannel(kChPrism)) return false;
    return extI2C->writeRegister(kPrismAddr, reg, data, len, 400000);
}

bool prismSetStripLength(uint8_t len)
{
    prism_strip_len = len;
    const uint8_t d[4] = {0, 0, len, 0x01};   // CONTROL: bit24 + length
    return prismWrite(kPrismRegControl, d, sizeof(d));
}

// Last base color pushed to LAYER_0 (by the Thor via LED_COLOR). Remembered so the turn-signal
// overlay on LAYER_1 can be repainted with THIS color to hide it — see prismOverlayHide().
static uint8_t g_baseR = 0, g_baseG = 0, g_baseB = 0, g_baseBr = 100;
// Who currently owns the LAYER_1 overlay. Declared here because prismSolid() has to know
// whether repainting the hidden overlay would stomp a live hazard signal.
enum class PrismOverlay : uint8_t { NONE = 0, TURN, MAST_MOVE, MAST_HOLD, NOT_READY, NO_ARM };
static PrismOverlay g_overlay = PrismOverlay::NONE;
static void prismOverlayHide();   // fwd decl (defined with the overlay block below)

// Fill the whole strip with one solid color via a Solid animation on LAYER_0.
bool prismSolid(uint8_t r, uint8_t g, uint8_t b, uint8_t bright)
{
    if (bright > 100) bright = 100;
    const uint8_t stop = prism_strip_len ? (uint8_t)(prism_strip_len - 1) : 0;
    bool ok = true;
    uint8_t sel[2]   = {kPrismSubSelect, kPrismAnimSolid};   ok &= prismWrite(kPrismRegLayer0, sel, 2);   delay(5);
    uint8_t br[2]    = {kPrismSubBright, bright};            ok &= prismWrite(kPrismRegLayer0, br, 2);    delay(5);
    uint8_t st[2]    = {kPrismSubStart, 0};                  ok &= prismWrite(kPrismRegLayer0, st, 2);    delay(5);
    uint8_t sp[2]    = {kPrismSubStop, stop};                ok &= prismWrite(kPrismRegLayer0, sp, 2);    delay(5);
    uint8_t col[4]   = {kPrismSubPrimary, r, g, b};          ok &= prismWrite(kPrismRegLayer0, col, 4);   delay(5);
    g_baseR = r; g_baseG = g; g_baseB = b; g_baseBr = bright;
    // Keep the (invisible) LAYER_1 overlay in sync with the new base so a later overlay-OFF
    // reveals THIS color, not a stale one. Skip while an overlay is live — that is a hazard
    // signal, don't stomp it.
    if (g_overlay == PrismOverlay::NONE) prismOverlayHide();
    return ok;
}

bool prismClear()
{
    const uint8_t d[4] = {0, 0, 0, 0x02};   // CONTROL: clear all animations
    return prismWrite(kPrismRegControl, d, sizeof(d));
}

// --- PRISM overlay on LAYER_1: turn-signals AND the Z-axis hazard, arbitrated ---
//
// LAYER_1 sits above the state base color on LAYER_0, and there is exactly one of it, so
// the two things that want to flash have to be arbitrated rather than both writing. The
// order is by hazard, not by who asked first:
//
//   MAST_HOLD   red strobe,  whole strip   descent stopped just above full-down, waiting
//                                          for the operator to consent to the last stretch
//   MAST_MOVE   amber blink, whole strip   the lift is travelling — DOWN blinks twice as
//                                          fast as UP, because descent is the direction
//                                          that closes the gap on a hand
//   TURN        amber blink, one side      steering intent, as before
//
// The Z-axis outranks the turn-signal, and takes the WHOLE strip, because the pinch hazard
// has no side: someone standing behind the robot is as exposed as the operator. It also
// moves while the robot is otherwise still and silent, which is exactly when a bystander
// has no other cue. Losing the turn-signal for the few seconds the lift is moving costs
// nothing — in that moment the robot is a hazard for a different reason, and that is the
// thing worth saying.
//
// Flash by toggling ONLY the layer brightness (one I2C write) so it never blocks the RC
// loop; segment range and color are (re)written only when the owner or its shape changes.
static constexpr uint8_t kPrismRegLayer1 = kPrismRegLayer0 + 1;   // ANIMATION_SLOT_1
static constexpr uint8_t kPrismAnimNone  = 0;                     // transparent
static constexpr uint8_t kTurnBright     = 90;
// Blink half-periods, ms. Tune by eye — these are readability values, not measurements.
static constexpr uint32_t kBlinkTurn     = 380;
static constexpr uint32_t kBlinkMastUp   = 400;
static constexpr uint32_t kBlinkMastDown = 200;   // descent: deliberately more urgent
static constexpr uint32_t kBlinkMastHold = 110;   // strobe — "this is waiting on you"
static constexpr uint32_t kBlinkNotReady = 700;   // slow breath — "wait, I am not ready"
static constexpr uint32_t kBlinkNoArm    = 160;   // fast amber — "waiting on you: CH5 to OFF"

static void prismOverlayConfig(uint8_t start, uint8_t stop,
                               uint8_t r, uint8_t g, uint8_t b, uint8_t bright)
{
    uint8_t sel[2] = {kPrismSubSelect, kPrismAnimSolid};   prismWrite(kPrismRegLayer1, sel, 2); delay(3);
    uint8_t st[2]  = {kPrismSubStart, start};              prismWrite(kPrismRegLayer1, st, 2);  delay(3);
    uint8_t sp[2]  = {kPrismSubStop, stop};                prismWrite(kPrismRegLayer1, sp, 2);  delay(3);
    uint8_t col[4] = {kPrismSubPrimary, r, g, b};          prismWrite(kPrismRegLayer1, col, 4); delay(3);
    uint8_t br[2]  = {kPrismSubBright, bright};            prismWrite(kPrismRegLayer1, br, 2);
}
static void prismOverlayBright(uint8_t bright) { uint8_t br[2] = {kPrismSubBright, bright}; prismWrite(kPrismRegLayer1, br, 2); }

// Hide the overlay by repainting LAYER_1 with the CURRENT base color over the whole strip, so it
// matches LAYER_0 and disappears. On this PRISM, select=NONE does NOT clear a layer's last render
// (the amber sticks), so we paint-to-match instead of relying on a "none" opcode. (void)kPrismAnimNone.
static void prismOverlayHide()
{
    const uint8_t stop = prism_strip_len ? (uint8_t)(prism_strip_len - 1) : 0;
    prismOverlayConfig(0, stop, g_baseR, g_baseG, g_baseB, g_baseBr);
}

void scanI2CFull();  // defined below; invoked on-demand by the I2C_SCAN command

// --- M5 ENV III (SHT30 @0x44) — MULTI-ZONE, non-blocking single-shot reads. ---
// One ENVIII per PaHub channel (both at 0x44, mux-isolated). Round-robins the zones, one
// two-phase read at a time (issue measure, then read ~16 ms later on a later loop) so it NEVER
// blocks the 50 Hz control loop / SBUS servicing (would risk [RC] gaps). An absent zone (e.g.
// z1 until it's wired) fails the measure fast and is skipped silently — it simply starts
// appearing in [ENV] the moment it's plugged in. Emits "[ENV] z=<zone> t=<C> h=<%>".
struct EnvZone { uint8_t zone; uint8_t channel; };
static const EnvZone   kEnvZones[]    = { {0, kChEnv}, {1, kChExtEncoder} };  // z0=ch2 resistor, z1=ch3 (2nd probe)
static const int       kNumEnvZones   = (int)(sizeof(kEnvZones) / sizeof(kEnvZones[0]));
static const uint32_t  kEnvIntervalMs = 500;   // per-zone service gate → each present zone ≈1 Hz

static int           env_idx     = 0;   // zone currently being serviced
static uint8_t       env_phase   = 0;   // 0 = idle/wait, 1 = measurement in flight
static unsigned long env_meas_ms = 0;
static unsigned long last_env_ms = 0;

void envStep()
{
    if (extI2C == nullptr || !extI2C->isEnabled()) return;
    const EnvZone& z = kEnvZones[env_idx];
    if (env_phase == 0) {
        if (millis() - last_env_ms < kEnvIntervalMs) return;
        // 0x24,0x00 = single-shot, high repeatability, clock stretching DISABLED (non-blocking).
        if (!selectChannel(z.channel) || !extI2C->writeRegister8(kEnvAddr, 0x24, 0x00, 100000)) {
            last_env_ms = millis();
            env_idx = (env_idx + 1) % kNumEnvZones;   // sensor absent on this channel → skip quietly
            return;
        }
        env_meas_ms = millis();
        env_phase   = 1;
        return;
    }
    if (millis() - env_meas_ms < 16) return;   // wait out the conversion (~15 ms high-rep)
    env_phase   = 0;
    last_env_ms = millis();
    const uint8_t zone = z.zone;
    env_idx = (env_idx + 1) % kNumEnvZones;
    uint8_t rx[6];
    bool ok = false;
    if (selectChannel(z.channel) && extI2C->start(kEnvAddr, true, 100000)) {
        ok = extI2C->read(rx, sizeof(rx), true);
        extI2C->stop();
    }
    if (!ok) return;                            // transient/absent — keep dashboard's last value, no spam
    const uint16_t rawT = ((uint16_t)rx[0] << 8) | rx[1];   // rx[2] = CRC (not checked)
    const uint16_t rawH = ((uint16_t)rx[3] << 8) | rx[4];   // rx[5] = CRC
    const float tC = -45.0f + 175.0f * (rawT / 65535.0f);
    const float rh = 100.0f  * (rawH / 65535.0f);
    if (tC < -40.0f || tC > 125.0f) return;
    tprintf("[ENV] z=%u t=%.2f h=%.1f\n", (unsigned)zone, tC, rh);
}

// 8Servo per-pin MODE cache. The pin's mode register (SERVO_CTL) latches in the 8Servo until it is
// reset, so writing it on EVERY pulse (4 channels × 50 Hz = 400 extra I2C txns/s) was pure overhead
// — and a leading cause of the `s8fail` I2C-write drops that track the ESC red-fault at idle. Set
// each pin's mode once; re-assert only after a write failure or an I2C re-init.
static uint8_t g_servo8ModeSet = 0;                                  // bit p set ⇒ pin p already in SERVO_CTL mode
static inline void servo8InvalidateModes() { g_servo8ModeSet = 0; } // force mode re-assert (after an I2C re-init)

// ---- ToF4M / VL53L1X (mast height) ------------------------------------------------
// NOTE the VL53L1X uses SIXTEEN-BIT register addresses, unlike the VL53L0X on the Tab5
// (8-bit). A driver for one will not read the other, and the ID read below is what tells
// them apart: VL53L1X answers EA CC 10 at 0x010F; VL53L0X answers EE AA 10 at 0xC0.
//
// STOP-separated, not a repeated start — the same thing Pinpoint needed on this bus, and
// the thing that wedged the 8Servo when we tried a repeated start there.
static constexpr uint32_t kTofHz = 100000;

static bool tofRead16(uint16_t reg, uint8_t *buf, uint8_t n)
{
    if (extI2C == nullptr || !extI2C->isEnabled()) return false;
    if (!selectChannel(kChTof)) return false;
    if (!extI2C->start(kTofAddr, false, kTofHz)) { extI2C->stop(); return false; }
    if (!extI2C->write((uint8_t)(reg >> 8)))     { extI2C->stop(); return false; }
    if (!extI2C->write((uint8_t)(reg & 0xFF)))   { extI2C->stop(); return false; }
    extI2C->stop();
    if (!extI2C->start(kTofAddr, true, kTofHz))  { extI2C->stop(); return false; }
    const bool ok = extI2C->read(buf, n, true);
    extI2C->stop();
    return ok;
}

// Confirm the sensor is on ch3 and is the part we think it is, before any driver work.
static void tofProbe()
{
    if (!selectChannel(kChTof)) { tprintf("[TOF] mux ch3 select FAILED\n"); return; }
    const bool ack = probeI2CAddress(*extI2C, kTofAddr);
    tprintf("[TOF] ch%u addr 0x%02X: %s\n", kChTof, kTofAddr, ack ? "ACK" : "no response");
    if (!ack) { tprintf("[TOF] check wiring/power before anything else\n"); return; }
    uint8_t id[3] = {0};
    if (!tofRead16(0x010F, id, 3)) { tprintf("[TOF] ID read FAILED\n"); return; }
    tprintf("[TOF] ID @0x010F: %02X %02X %02X  -> %s\n", id[0], id[1], id[2],
                  (id[0] == 0xEA) ? "VL53L1X (ToF4M) as expected"
                                  : "NOT a VL53L1X — check the part");
}

// ---- Z-axis (mast / lift) -------------------------------------------------------
// R1/R2 drive the lift's two legs; NO contacts, so energized = pressed. WHICH relay drives
// which leg is a per-robot wiring fact, discovered on the bench with `MAST UP|DOWN` --
// swap these two if the bench says they are the other way round.
// Bench-discovered on opendubs2 2026-09-04 by pulsing each relay and watching the lift:
//   code R2 (SILK R3) = UP     code R1 (SILK R2) = DOWN
// Silk is 1-indexed and code is 0-indexed -- that offset cost us a debugging cycle, so
// both are written out here. Re-discover on any new build; it depends only on which of
// two wires was landed.
// kRelayMastUp / kRelayMastDown: robot_config.h.
// Height source: the ToF on PaHub ch3. Returns false until the sensor is BOTH answering and
// calibrated (TOFCAL ZERO at the bottom limit), which leaves the lift open-loop but working
// -- enough for relay bring-up. Belief correction and the pinch guard switch themselves on
// the moment this starts returning readings, and off again if it stops.
static ScissorRelayMast g_mast(kRelayMastUp, kRelayMastDown, tofHeightMm);

// Drive the LAYER_1 overlay from robot state. Defined here rather than with the other PRISM
// code because it is the one part that has to see the mast driver. Call every loop.
void prismOverlayStep()
{
    // Who owns the layer this tick, and what it looks like.
    const uint8_t last = prism_strip_len ? (uint8_t)(prism_strip_len - 1) : 0;
    PrismOverlay want = PrismOverlay::NONE;
    uint8_t start = 0, stop = last, r = 255, g = 96, b = 0, bright = kTurnBright;
    uint32_t half = kBlinkTurn;

    // NOT READY outranks everything. While the drive gate is shut the robot cannot be
    // commanded to move at all, and an operator holding the deadman and getting nothing needs
    // to know it is the robot waiting rather than the transmitter failing — otherwise the
    // reasonable response is to keep trying, which is precisely what went wrong before.
    // Slow WHITE breath: unmistakably "not yet", and no other signal on this robot is white.
    if (!g_driveSafe) {
        want = PrismOverlay::NOT_READY;
        r = 255; g = 255; b = 255; bright = 55; half = kBlinkNotReady;
    } else if (g_autoArmWaiting) {
        // Motion power is NOT available and the robot is waiting on the operator — almost always
        // CH5 left out of OFF at power-on. Without a signal this is indistinguishable from a dead
        // robot, and the reasonable response is to keep flipping switches. AMBER, fast: "I am
        // waiting on you", distinct from the white "not yet" breath above.
        want = PrismOverlay::NO_ARM;
        r = 255; g = 140; b = 0; bright = 70; half = kBlinkNoArm;
    } else {
    // Bench override (MASTTEST) — same code path as the real thing, so what you tune by eye
    // is what you get in service.
    const uint8_t mt = (millis() < g_mastTestUntil) ? g_mastTest : 0;
    if (mt == 3 || g_mast.pinchHold()) {
        want = PrismOverlay::MAST_HOLD;
        r = 255; g = 0; b = 0; bright = 100; half = kBlinkMastHold;
    } else if (mt != 0 || g_mast.motion() != MastMotion::STOP) {
        want = PrismOverlay::MAST_MOVE;
        const bool down = mt ? (mt == 2) : (g_mast.motion() == MastMotion::DOWN);
        half = down ? kBlinkMastDown : kBlinkMastUp;
    } else if (g_turnDir != 0) {
        want = PrismOverlay::TURN;
        start = g_turnDir > 0 ? 0 : 24;
        stop  = g_turnDir > 0 ? 11 : 35;
    }
    }

    // Reconfigure only when the picture actually changes — the flash itself is one write.
    static uint8_t prevStart = 255, prevStop = 255, prevR = 0, prevG = 0, prevB = 0;
    static bool     flashOn = false;
    static uint32_t flashMs = 0;
    const bool shapeChanged = (want != g_overlay) || start != prevStart || stop != prevStop
                              || r != prevR || g != prevG || b != prevB;
    if (shapeChanged) {
        g_overlay = want;
        prevStart = start; prevStop = stop; prevR = r; prevG = g; prevB = b;
        if (want == PrismOverlay::NONE) prismOverlayHide();
        else { prismOverlayConfig(start, stop, r, g, b, bright); flashOn = true; flashMs = millis(); }
    }
    if (want != PrismOverlay::NONE && millis() - flashMs > half) {
        flashMs = millis();
        flashOn = !flashOn;
        prismOverlayBright(flashOn ? bright : 0);
    }
}

// ---- I2C bus recovery ---------------------------------------------------------
// M5Unified's writeRegister() is a short-circuiting && chain:
//     beginTransaction(..) && writeBytes(&reg,1) && writeBytes(data,len) && endTransaction(..)
// If ANY step fails, endTransaction() is never reached, so NO STOP is issued and the
// slave is abandoned mid-transaction. The 8Servo's STM32F030F4 latches in exactly that
// state: it keeps ACKing its address in hardware but never services data again, and every
// subsequent write fails. That is what turns a single glitched write into a permanent
// wedge — and why Pinpoint survives on the same bus, since ppXfer() stops on every path.
static uint32_t      g_i2cRecoverCount = 0;   // bus recoveries since boot (observability)
static uint8_t       g_s8ConsecFail    = 0;   // consecutive 8Servo write failures
static unsigned long g_lastRecover_ms  = 0;
static constexpr uint8_t  kS8FailBeforeRecover  = 8;    // ~40 ms at 200 writes/s = 2 drive ticks
static constexpr uint32_t kRecoverMinIntervalMs = 250;  // don't spin on a genuinely dead bus

// Clock out up to 9 pulses on SCL with SDA released, then a manual STOP. A slave stuck
// mid-byte releases SDA once the rest of that byte is clocked through; the STOP then
// returns it to idle. Bit-banged, because the peripheral will not drive clocks while it
// believes the bus is busy.
static void i2cBusRecover()
{
    if (extI2C == nullptr) return;
    const int sda = extI2C->getSDA();
    const int scl = extI2C->getSCL();
    if (sda < 0 || scl < 0) return;

    g_i2cRecoverCount++;
    g_lastRecover_ms = millis();
    extI2C->release();                       // hand the pins back to GPIO

    pinMode(sda, INPUT_PULLUP);
    pinMode(scl, OUTPUT_OPEN_DRAIN);
    digitalWrite(scl, HIGH);
    delayMicroseconds(5);
    for (int i = 0; i < 9 && digitalRead(sda) == LOW; ++i) {
        digitalWrite(scl, LOW);  delayMicroseconds(5);
        digitalWrite(scl, HIGH); delayMicroseconds(5);
    }
    pinMode(sda, OUTPUT_OPEN_DRAIN);         // manual STOP: SDA low->high while SCL is high
    digitalWrite(sda, LOW);  delayMicroseconds(5);
    digitalWrite(scl, HIGH); delayMicroseconds(5);
    digitalWrite(sda, HIGH); delayMicroseconds(5);

    extI2C->begin(I2C_NUM_1, kPortASda, kPortAScl);
    g_currentHubCh = -1;                     // mux selection is unknown after a re-init
    servo8InvalidateModes();                 // the 8Servo may have missed its mode writes
    tprintf("[I2C] bus recovery #%lu\n", (unsigned long)g_i2cRecoverCount);
}

// ABSENT-DEVICE BACK-OFF. A wedged slave is worth recovering; a device that is simply not
// there is not, and hammering it is expensive. With the 8Servo dead we were attempting 200
// writes a second (4 channels x 50 Hz), every one failing, each dragging a mux select and a
// recovery check behind it — and calling the bit-banged bus recovery four times a second.
// That cost showed up as loop stalls of 130-340 ms, which backed the SBUS drain up until it
// hit its byte cap on EVERY iteration and never caught up, which dropped the drive-safe
// gate, which silently suppressed RC pan/tilt. A dead part on one I2C channel was making
// the whole control loop miss its deadline.
//
// So: recover a few times, and if it keeps failing, stop asking. Retry occasionally, because
// a replacement 8Servo must come back on its own without a reflash.
static constexpr uint16_t kS8FailBeforeAbsent = 400;    // ~2 s of solid failure at 200/s
static constexpr uint32_t kS8RetryMs          = 3000;   // ... then poke it this often
static bool     g_s8Absent   = false;
static uint32_t g_s8RetryMs  = 0;
static uint16_t g_s8FailRun  = 0;      // failures since the last success (saturating)

static inline void servo8NoteFail()
{
    if (g_s8FailRun < 0xFFFF) g_s8FailRun++;
    if (g_s8FailRun >= kS8FailBeforeAbsent && !g_s8Absent) {
        g_s8Absent = true;
        g_s8RetryMs = millis() + kS8RetryMs;
        tprintf("[8SERVO] absent after %u consecutive failures — backing off, retry every %lums\n",
                g_s8FailRun, (unsigned long)kS8RetryMs);
    }
    if (++g_s8ConsecFail < kS8FailBeforeRecover) return;
    g_s8ConsecFail = 0;
    if (!g_s8Absent && millis() - g_lastRecover_ms >= kRecoverMinIntervalMs) i2cBusRecover();
}

// True when a write should be attempted at all. While the part is absent this lets exactly
// one attempt through every kS8RetryMs, which is enough to notice it come back.
static inline bool servo8Reachable()
{
    if (!g_s8Absent) return true;
    if ((int32_t)(millis() - g_s8RetryMs) < 0) return false;
    g_s8RetryMs = millis() + kS8RetryMs;
    return true;                        // one probe; success clears g_s8Absent below
}

// Write to an 8Servo register with a STOP on EVERY exit path — the thing writeRegister()
// does not do. Mirrors ppXfer()'s discipline.
static bool servo8Write(uint8_t reg, const uint8_t* d, size_t n)
{
    if (!extI2C->start(kServo8Addr, false, kServo8Hz)) { extI2C->stop(); return false; }
    if (!extI2C->write(reg))                          { extI2C->stop(); return false; }
    if (n && !extI2C->write(d, n))                    { extI2C->stop(); return false; }
    return extI2C->stop();
}

// Drive one 8Servo channel as a servo PWM pulse (microseconds) — the 4 goBILDA 2x80A ESCs.
// (PRISM is NOT here: it is an I2C RGB driver at 0x38; ch0 is the Rear-Left ESC.)
bool servo8SetPulse(uint8_t pin, uint16_t pulse_us)
{
    if (extI2C == nullptr || !extI2C->isEnabled()) return false;
    if (pin > 7) return false;
    if (!selectChannel(kChServo8)) { servo8NoteFail(); return false; }
    // Put the pin in servo-control mode ONCE (see the mode-cache note above), then write the
    // 16-bit pulse (low byte, high byte). A pulse-write failure invalidates the pin's mode bit so
    // mode is re-asserted next call — covers a bus glitch or an 8Servo that lost power/reset.
    if (!(g_servo8ModeSet & (1u << pin))) {
        const uint8_t m = kServo8ModeServoCtl;
        if (!servo8Write(kServo8ModeReg + pin, &m, 1)) { servo8NoteFail(); return false; }
        g_servo8ModeSet |= (1u << pin);
    }
    const uint8_t d[2] = { (uint8_t)(pulse_us & 0xFF), (uint8_t)((pulse_us >> 8) & 0xFF) };
    if (!servo8Write(kServo8PulseReg + pin * 2, d, 2)) {
        g_servo8ModeSet &= ~(1u << pin);
        servo8NoteFail();
        return false;
    }
    g_s8ConsecFail = 0;   // a clean write means the bus is healthy again
    g_s8FailRun = 0;
    if (g_s8Absent) { g_s8Absent = false; tprintf("[8SERVO] back on the bus\n"); }
    return true;
}

void handleHostCommand(const char* cmd)
{
    if (rcCalCommand(cmd, rc_ch)) return;
    if (tofCalCommand(cmd)) return;
    if (ppCfgCommand(cmd)) return;
    if (!strcasecmp(cmd, "TOF")) { tofProbe(); return; }
    // Bench discovery of which relay moves the lift which way -- a per-robot wiring fact.
    // Bypasses intent, so it works with the sticks centred.
    int mpulse = -1, mgap = -1;
    if (sscanf(cmd, "MAST PULSE %d %d", &mpulse, &mgap) >= 1) {
        if (mgap < 0) mgap = (int)g_mast.gapMs();
        g_mast.setTiming((uint32_t)mpulse, (uint32_t)mgap);
        g_mast.saveCfg();
        tprintf("[MAST] pulse=%lums gap=%lums (saved)\n",
                (unsigned long)g_mast.pulseMs(), (unsigned long)g_mast.gapMs());
        return;
    }
    // Pinch-guard threshold + release dwell. Per-robot: it depends on where the ToF is
    // mounted and how far the lift coasts after the stop pulse, so it is commissioned on
    // the machine rather than assumed here.
    int mpinch = -1, mdwell = -1;
    if (sscanf(cmd, "MAST PINCH %d %d", &mpinch, &mdwell) >= 1) {
        if (mdwell < 0) mdwell = (int)g_mast.pinchDwellMs();
        g_mast.setPinch((float)mpinch, (uint32_t)mdwell);
        g_mast.saveCfg();               // commissioned value — must survive a reboot
        tprintf("[MAST] pinch=%.0fmm dwell=%lums (saved) guard=%s\n", g_mast.pinchMm(),
                (unsigned long)g_mast.pinchDwellMs(),
                g_mast.pinchActive() ? "active" : "NO HEIGHT SENSOR - descent unguarded");
        return;
    }
    // Consent for one descent through the pinch zone, for an automated lowering. Spent when
    // that descent stops, and stale after 15 s, so it can't be pre-armed and left lying about.
    if (!strcasecmp(cmd, "MAST ACK")) {
        g_mast.pinchAck(millis());
        tprintf("[MAST] pinch ACK — one descent through the zone authorized\n");
        return;
    }
    if (!strcasecmp(cmd, "MAST UP") || !strcasecmp(cmd, "MAST DOWN")) {
        const bool up = (strcasecmp(cmd, "MAST UP") == 0);
        g_mast.pulseLeg(up, millis());
        tprintf("[MAST] cmd='%s' -> %s leg, code R%u (silk R%u)\n", cmd,
                up ? "UP" : "DOWN",
                up ? kRelayMastUp : kRelayMastDown,
                (up ? kRelayMastUp : kRelayMastDown) + 1);
        return;
    }
    int ta, tb, tc, td;
    if (sscanf(cmd, "TAB5IP %d.%d.%d.%d", &ta, &tb, &tc, &td) == 4) {
        g_tab5Ip = IPAddress((uint8_t)ta, (uint8_t)tb, (uint8_t)tc, (uint8_t)td);
        g_haveTab5 = true;
        tprintf("[HEAD] Tab5 at %d.%d.%d.%d — RC pan/tilt enabled\n", ta, tb, tc, td);
        return;
    }

    int msrc = -1, mpin = -1;
    if (!strcasecmp(cmd, "MIRROR OFF")) {
        g_mirrorSrc = -1;
        tprintf("[MIRROR] off\n");
        return;
    }
    if (sscanf(cmd, "MIRROR %d %d", &msrc, &mpin) == 2) {
        bool clash = false;
        for (int i = 0; i < 4; ++i) if (kDriveCh[i] == (uint8_t)mpin) clash = true;
        if (msrc < 0 || msrc > 3 || mpin < 0 || mpin > 7 || clash) {
            tprintf("[MIRROR] refused: wheel 0-3, pin 0-7, and the pin must not be a drive channel\n");
        } else {
            g_mirrorSrc = (int8_t)msrc; g_mirrorPin = (uint8_t)mpin;
            tprintf("[MIRROR] wheel %d -> 8Servo pin %d\n", msrc, mpin);
        }
        return;
    }

    int value = -1;
    if (sscanf(cmd, "PDH_SWITCH %d", &value) == 1) {
        const bool en = value != 0;
        const bool ok = sendPdhSwitchCommand(en);
        Serial.printf("[PDH] cmd switch=%d %s\n", en ? 1 : 0, ok ? "queued" : "failed");
        return;
    }

    if (strcmp(cmd, "PDH_CLEAR_FAULTS") == 0) {
        const bool ok = sendPdhClearFaultsCommand();
        Serial.printf("[PDH] cmd clear_faults %s\n", ok ? "queued" : "failed");
        return;
    }

    int module = -1;
    if (sscanf(cmd, "PDH_ID %d", &module) == 1) {
        if (module >= 0 && module <= 63) {
            pdh_device_id = static_cast<uint8_t>(module);
            pdh_id_locked = true;
            Serial.printf("[PDH] cmd id=%u locked=1\n", static_cast<unsigned>(pdh_device_id));
        } else {
            Serial.println("[PDH] cmd invalid id (expected 0..63)");
        }
        return;
    }

    if (strcmp(cmd, "PDH_ID_AUTO") == 0) {
        pdh_id_locked = false;
        Serial.println("[PDH] cmd id auto-detect enabled");
        return;
    }

    int relay_ch = -1, relay_st = -1;
    if (sscanf(cmd, "RELAY %d %d", &relay_ch, &relay_st) == 2) {
        if (relay_ch >= 0 && relay_ch <= 3) {
            M5StamPLC.writePlcRelay(static_cast<uint8_t>(relay_ch), relay_st != 0);
            if (relay_ch == 0 && relay_st != 0) local_estop_active = false;  // host re-arm clears local latch
            Serial.printf("[IO] cmd relay %d=%d\n", relay_ch, relay_st != 0 ? 1 : 0);
        } else {
            Serial.println("[IO] cmd invalid relay (expected 0..3)");
        }
        return;
    }

    if (strcmp(cmd, "REBOOT") == 0) {
        // Deliberate, and safe-by-order: drop the contactor FIRST so the bus is dead across
        // the restart, exactly as the OTA path does. Exists because recovering a wedged
        // Ethernet socket otherwise required physical access to the board.
        M5StamPLC.writePlcRelay(0, false);
        local_estop_active = true;
        tprintf("[SYS] REBOOT — contactor opened, restarting\n");
        delay(150);                     // let the telemetry line reach the wire
        ESP.restart();
        return;
    }

    if (strcmp(cmd, "ESTOP") == 0) {
        // Safe-direction software E-stop: drop the contactor coil (relay 0).
        M5StamPLC.writePlcRelay(0, false);
        local_estop_active = true;
        Serial.println("[IO] cmd ESTOP -> relay0 OFF (contactor open)");
        return;
    }

    if (strcmp(cmd, "ENC_RESET") == 0) {
        bool ok = false;
        if (extI2C != nullptr && extI2C->isEnabled())
            ok = extI2C->writeRegister8(kExtEncoderAddr, kExtEncoderResetReg, 1, 400000);
        Serial.printf("[ENC] cmd reset %s\n", ok ? "ok" : "failed");
        return;
    }

    int page = -1;
    if (sscanf(cmd, "PAGE %d", &page) == 1) {
        if (page >= 0 && page < kUiPages) { ui_page = page; Serial.printf("[UI] page=%d\n", page); }
        else Serial.println("[UI] invalid page");
        return;
    }

    int s8pin = -1, s8pulse = -1;
    if (sscanf(cmd, "SERVO8 %d %d", &s8pin, &s8pulse) == 2) {
        if (s8pin >= 0 && s8pin <= 7 && s8pulse >= 0 && s8pulse <= 3000) {
            const bool ok = servo8SetPulse((uint8_t)s8pin, (uint16_t)s8pulse);
            Serial.printf("[8SERVO] pin=%d pulse=%dus %s\n", s8pin, s8pulse, ok ? "ok" : "FAILED");
        } else {
            Serial.println("[8SERVO] invalid (pin 0..7, pulse 0..3000)");
        }
        return;
    }

    // Ethernet OTA: pull a .bin over HTTP off the Thor and self-flash, then reboot into it. This is
    // what makes the StamPLC reflashable with USB unplugged. `OTA http://<thor-ip>:<port>/fw.bin`.
    if (strncmp(cmd, "OTA ", 4) == 0) {
        otaHttpPull(cmd + 4);
        return;
    }

    // Autonomous drive command from the Thor/ROS: `DRIVE <fwd> <rot> <str>` (-1..1).
    // Only takes effect under RC_AUTO authority (CH5) + the arm gate; each message
    // also refreshes the heartbeat, so stopping the stream stops the robot.
    // Z-axis intent from the Thor/ROS. Deliberately the ONLY remote way to move the lift:
    // it feeds the same setIntent() the sticks do, so the pinch guard, the limits and the
    // belief correction all apply. Driving the relays directly from the network -- which is
    // what the Tab5 bridge used to do -- goes round every one of them.
    // Heartbeat-gated like DRIVE: stop sending and the lift stops.
    float dmast = 0;
    if (sscanf(cmd, "MAST CMD %f", &dmast) == 1) {
        g_rosMast.v  = constrain(dmast, -1.0f, 1.0f);
        g_rosMast.ms = millis();          // silent ack — arrives at command rate
        return;
    }

    float dfwd = 0, drot = 0, dstr = 0;
    if (sscanf(cmd, "DRIVE %f %f %f", &dfwd, &drot, &dstr) == 3) {
        g_rosCmd.fwd = constrain(dfwd, -1.0f, 1.0f);
        g_rosCmd.rot = constrain(drot, -1.0f, 1.0f);
        g_rosCmd.str = constrain(dstr, -1.0f, 1.0f);
        g_rosCmd.ms  = millis();          // heartbeat (silent ack — arrives at command rate)
        return;
    }
    int dmode = -1;
    if (sscanf(cmd, "DRIVEMODE %d", &dmode) == 1) {
        if (dmode >= 0 && dmode <= 2) {
            g_driveMode = (DriveMode)dmode; g_driveModeOverride = true;   // bench override (ignores DI7 jumper)
            Serial.printf("[DRIVE] mode override=%d (0=mecanum 1=skid4 2=diff2)\n", dmode);
        } else if (dmode == -1) {
            g_driveModeOverride = false; Serial.println("[DRIVE] mode override cleared (jumper DI7)");
        } else Serial.println("[DRIVE] invalid mode (0..2, or -1 to clear override)");
        return;
    }

    // ---- RS485 / BMS probe ----
    unsigned int rbaud;
    if (sscanf(cmd, "RS485BAUD %u", &rbaud) == 1) { rs485Init(rbaud); return; }
    if (strncmp(cmd, "RS485TX ", 8) == 0) {
        uint8_t tx[64]; int n = hexToBytes(cmd + 8, tx, sizeof(tx));
        if (n > 0) rs485Send(tx, n); else Serial.println("[485] RS485TX: no hex bytes");
        return;
    }
    if (strcmp(cmd, "BMS") == 0) {          // JBD read-basic-info (0x03)
        static const uint8_t q[] = {0xDD, 0xA5, 0x03, 0x00, 0xFF, 0xFD, 0x77};
        rs485Send(q, sizeof(q)); return;
    }
    if (strcmp(cmd, "BMS_CELLS") == 0) {    // JBD read cell voltages (0x04)
        static const uint8_t q[] = {0xDD, 0xA5, 0x04, 0x00, 0xFF, 0xFC, 0x77};
        rs485Send(q, sizeof(q)); return;
    }
    int bauto = -1;
    if (sscanf(cmd, "BMSAUTO %d", &bauto) == 1) {
        g_bmsAuto = (bauto != 0);
        Serial.printf("[BMS] auto=%d\n", g_bmsAuto ? 1 : 0); return;
    }

    if (strcmp(cmd, "I2C_SCAN") == 0) {
        // On-demand full bus sweep (high-latency; not run periodically).
        scanI2CFull();
        return;
    }

    int r = -1, g = -1, b = -1, br = 100;
    int n = sscanf(cmd, "LED_COLOR %d %d %d %d", &r, &g, &b, &br);
    if (n >= 3) {
        auto cl = [](int v) { return (uint8_t)(v < 0 ? 0 : (v > 255 ? 255 : v)); };
        const bool ok = prismSolid(cl(r), cl(g), cl(b), (uint8_t)(br < 0 ? 0 : (br > 100 ? 100 : br)));
        tprintf("[PRISM] color r=%d g=%d b=%d bright=%d len=%d %s\n",
                cl(r), cl(g), cl(b), br, prism_strip_len, ok ? "ok" : "FAILED");
        return;
    }

    int len = -1;
    if (sscanf(cmd, "LED_LEN %d", &len) == 1) {
        const bool ok = (len >= 0 && len <= 255) && prismSetStripLength((uint8_t)len);
        tprintf("[PRISM] strip_len=%d %s\n", len, ok ? "ok" : "FAILED");
        return;
    }

    if (strcmp(cmd, "LED_OFF") == 0) {
        const bool ok = prismClear();
        tprintf("[PRISM] clear %s\n", ok ? "ok" : "FAILED");
        return;
    }

    char mtw[8] = {0};
    int  mtsecs = 0;
    if (sscanf(cmd, "MASTTEST %7s %d", mtw, &mtsecs) >= 1) {
        if (mtsecs <= 0) mtsecs = 10;
        g_mastTestUntil = millis() + (uint32_t)mtsecs * 1000;
        if      (!strcasecmp(mtw, "UP"))   g_mastTest = 1;
        else if (!strcasecmp(mtw, "DOWN")) g_mastTest = 2;
        else if (!strcasecmp(mtw, "HOLD")) g_mastTest = 3;
        else { g_mastTest = 0; g_mastTestUntil = 0; }
        tprintf("[MASTTEST] %s for %ds — LIGHTS ONLY, no relay is touched\n",
                g_mastTest == 1 ? "UP" : g_mastTest == 2 ? "DOWN" : g_mastTest == 3 ? "HOLD" : "off",
                mtsecs);
        return;
    }

    int tval;
    if (sscanf(cmd, "TURNTEST %d", &tval) == 1) {   // bench-force the turn-signal for 12s
        g_turnDir = (tval > 0) ? 1 : (tval < 0) ? -1 : 0;
        g_turnTestUntil = millis() + 12000;
        tprintf("[TURN] test dir=%d (12s)\n", g_turnDir);
        return;
    }

    if (strcmp(cmd, "I2C_INFO") == 0) {
        // Report which physical bus the external scanner is bound to.
        if (extI2C)
            Serial.printf("[I2C] info bus=PortA(GroveRED,I2C_NUM_1) SDA=G%d SCL=G%d enabled=%d pahub=%d\n",
                          extI2C->getSDA(), extI2C->getSCL(), extI2C->isEnabled() ? 1 : 0,
                          g_paHubPresent ? 1 : 0);
        else
            Serial.println("[I2C] info: extI2C is null");
        return;
    }

    Serial.printf("[PDH] cmd unknown: %s\n", cmd);
}

void pollHostCommands()
{
    while (Serial.available() > 0) {
        const int c = Serial.read();
        if (c < 0) {
            break;
        }

        if (c == '\r') {
            continue;
        }

        if (c == '\n') {
            if (host_cmd_len > 0) {
                host_cmd_buf[host_cmd_len] = '\0';
                handleHostCommand(host_cmd_buf);
                host_cmd_len = 0;
                last_host_cmd_ms = millis();   // host-link heartbeat for the local UI
            }
            continue;
        }

        if (host_cmd_len + 1 < sizeof(host_cmd_buf)) {
            host_cmd_buf[host_cmd_len++] = static_cast<char>(c);
        } else {
            host_cmd_len = 0;
            Serial.println("[PDH] cmd buffer overflow");
        }
    }
}

void decodePdhStatusFrame(const twai_message_t& can_msg)
{
    const uint32_t id = can_msg.identifier;
    const uint8_t dev_id = static_cast<uint8_t>(id & kPdhDeviceIdMask);
    if (!pdh_id_locked) {
        pdh_device_id = dev_id;
    } else if (dev_id != pdh_device_id) {
        return;
    }

    const uint8_t* d = can_msg.data;
    pdh.last_update_ms = millis();

    if (isPdhFrame(id, kPdhStatus0FrameBase)) {
        pdh.s0_seen = true;
        pdh.channel_a[0] = static_cast<float>(unpackBitsLE(d, 0, 10)) * 0.125f;
        pdh.channel_a[1] = static_cast<float>(unpackBitsLE(d, 10, 10)) * 0.125f;
        pdh.channel_a[2] = static_cast<float>(unpackBitsLE(d, 20, 10)) * 0.125f;
        pdh.channel_a[3] = static_cast<float>(unpackBitsLE(d, 32, 10)) * 0.125f;
        pdh.channel_a[4] = static_cast<float>(unpackBitsLE(d, 42, 10)) * 0.125f;
        pdh.channel_a[5] = static_cast<float>(unpackBitsLE(d, 52, 10)) * 0.125f;
        pdh.breaker_fault[0] = unpackBitsLE(d, 30, 1) != 0;
        pdh.breaker_fault[1] = unpackBitsLE(d, 31, 1) != 0;
        pdh.breaker_fault[2] = unpackBitsLE(d, 62, 1) != 0;
        pdh.breaker_fault[3] = unpackBitsLE(d, 63, 1) != 0;
        return;
    }

    if (isPdhFrame(id, kPdhStatus1FrameBase)) {
        pdh.s1_seen = true;
        pdh.channel_a[6] = static_cast<float>(unpackBitsLE(d, 0, 10)) * 0.125f;
        pdh.channel_a[7] = static_cast<float>(unpackBitsLE(d, 10, 10)) * 0.125f;
        pdh.channel_a[8] = static_cast<float>(unpackBitsLE(d, 20, 10)) * 0.125f;
        pdh.channel_a[9] = static_cast<float>(unpackBitsLE(d, 32, 10)) * 0.125f;
        pdh.channel_a[10] = static_cast<float>(unpackBitsLE(d, 42, 10)) * 0.125f;
        pdh.channel_a[11] = static_cast<float>(unpackBitsLE(d, 52, 10)) * 0.125f;
        pdh.breaker_fault[4] = unpackBitsLE(d, 30, 1) != 0;
        pdh.breaker_fault[5] = unpackBitsLE(d, 31, 1) != 0;
        pdh.breaker_fault[6] = unpackBitsLE(d, 62, 1) != 0;
        pdh.breaker_fault[7] = unpackBitsLE(d, 63, 1) != 0;
        return;
    }

    if (isPdhFrame(id, kPdhStatus2FrameBase)) {
        pdh.s2_seen = true;
        pdh.channel_a[12] = static_cast<float>(unpackBitsLE(d, 0, 10)) * 0.125f;
        pdh.channel_a[13] = static_cast<float>(unpackBitsLE(d, 10, 10)) * 0.125f;
        pdh.channel_a[14] = static_cast<float>(unpackBitsLE(d, 20, 10)) * 0.125f;
        pdh.channel_a[15] = static_cast<float>(unpackBitsLE(d, 32, 10)) * 0.125f;
        pdh.channel_a[16] = static_cast<float>(unpackBitsLE(d, 42, 10)) * 0.125f;
        pdh.channel_a[17] = static_cast<float>(unpackBitsLE(d, 52, 10)) * 0.125f;
        pdh.breaker_fault[8] = unpackBitsLE(d, 30, 1) != 0;
        pdh.breaker_fault[9] = unpackBitsLE(d, 31, 1) != 0;
        pdh.breaker_fault[10] = unpackBitsLE(d, 62, 1) != 0;
        pdh.breaker_fault[11] = unpackBitsLE(d, 63, 1) != 0;
        return;
    }

    if (isPdhFrame(id, kPdhStatus3FrameBase)) {
        pdh.s3_seen = true;
        pdh.channel_a[18] = static_cast<float>(unpackBitsLE(d, 0, 10)) * 0.125f;
        pdh.channel_a[19] = static_cast<float>(unpackBitsLE(d, 10, 10)) * 0.125f;
        pdh.channel_a[20] = static_cast<float>(unpackBitsLE(d, 24, 8)) * 0.0625f;
        pdh.channel_a[21] = static_cast<float>(unpackBitsLE(d, 32, 8)) * 0.0625f;
        pdh.channel_a[22] = static_cast<float>(unpackBitsLE(d, 40, 8)) * 0.0625f;
        pdh.channel_a[23] = static_cast<float>(unpackBitsLE(d, 48, 8)) * 0.0625f;
        pdh.breaker_fault[12] = unpackBitsLE(d, 20, 1) != 0;
        pdh.breaker_fault[13] = unpackBitsLE(d, 21, 1) != 0;
        pdh.breaker_fault[14] = unpackBitsLE(d, 22, 1) != 0;
        pdh.breaker_fault[15] = unpackBitsLE(d, 23, 1) != 0;
        pdh.breaker_fault[16] = unpackBitsLE(d, 56, 1) != 0;
        pdh.breaker_fault[17] = unpackBitsLE(d, 57, 1) != 0;
        pdh.breaker_fault[18] = unpackBitsLE(d, 58, 1) != 0;
        pdh.breaker_fault[19] = unpackBitsLE(d, 59, 1) != 0;
        pdh.breaker_fault[20] = unpackBitsLE(d, 60, 1) != 0;
        pdh.breaker_fault[21] = unpackBitsLE(d, 61, 1) != 0;
        pdh.breaker_fault[22] = unpackBitsLE(d, 62, 1) != 0;
        pdh.breaker_fault[23] = unpackBitsLE(d, 63, 1) != 0;
        return;
    }

    if (isPdhFrame(id, kPdhStatus4FrameBase)) {
        pdh.s4_seen = true;
        pdh.v_bus = static_cast<float>(unpackBitsLE(d, 0, 12)) * 0.0078125f;
        pdh.brownout_fault = unpackBitsLE(d, 16, 1) != 0;
        pdh.can_warning_fault = unpackBitsLE(d, 18, 1) != 0;
        pdh.hardware_fault = unpackBitsLE(d, 19, 1) != 0;
        pdh.switch_channel = unpackBitsLE(d, 20, 1) != 0;
        pdh.total_current = static_cast<float>(unpackBitsLE(d, 32, 8)) * 2.0f;
        pdh.total_power = pdh.v_bus * pdh.total_current;
        {
            uint32_t sb = 0;
            for (int i = 0; i < 20; ++i)
                if (unpackBitsLE(d, 40 + i, 1)) sb |= (1u << i);   // sticky ch0-19
            for (int i = 0; i < 4; ++i)
                if (unpackBitsLE(d, 27 + i, 1)) sb |= (1u << (20 + i));  // sticky ch20-23
            pdh.sticky_breaker = sb;
        }

        const unsigned long now_ms = millis();
        if (pdh.last_s4_ms != 0 && now_ms > pdh.last_s4_ms) {
            const float dt_h = static_cast<float>(now_ms - pdh.last_s4_ms) / 3600000.0f;
            pdh.energy_wh += pdh.total_power * dt_h;
        }
        pdh.last_s4_ms = now_ms;
        return;
    }
}

bool decodeSbusFrame(const uint8_t* frame, uint16_t* ch, bool* failsafe, bool* frame_lost)
{
    if (frame[0] != 0x0F) {
        return false;
    }

    // Accept common SBUS footer variants seen across receivers.
    const uint8_t footer = frame[24];
    if (!(footer == 0x00 || footer == 0x04 || footer == 0x14 || footer == 0x24)) {
        return false;
    }

    ch[0]  = (frame[1] | frame[2] << 8) & 0x07FF;
    ch[1]  = (frame[2] >> 3 | frame[3] << 5) & 0x07FF;
    ch[2]  = (frame[3] >> 6 | frame[4] << 2 | frame[5] << 10) & 0x07FF;
    ch[3]  = (frame[5] >> 1 | frame[6] << 7) & 0x07FF;
    ch[4]  = (frame[6] >> 4 | frame[7] << 4) & 0x07FF;
    ch[5]  = (frame[7] >> 7 | frame[8] << 1 | frame[9] << 9) & 0x07FF;
    ch[6]  = (frame[9] >> 2 | frame[10] << 6) & 0x07FF;
    ch[7]  = (frame[10] >> 5 | frame[11] << 3) & 0x07FF;
    ch[8]  = (frame[12] | frame[13] << 8) & 0x07FF;
    ch[9]  = (frame[13] >> 3 | frame[14] << 5) & 0x07FF;
    ch[10] = (frame[14] >> 6 | frame[15] << 2 | frame[16] << 10) & 0x07FF;
    ch[11] = (frame[16] >> 1 | frame[17] << 7) & 0x07FF;
    ch[12] = (frame[17] >> 4 | frame[18] << 4) & 0x07FF;
    ch[13] = (frame[18] >> 7 | frame[19] << 1 | frame[20] << 9) & 0x07FF;
    ch[14] = (frame[20] >> 2 | frame[21] << 6) & 0x07FF;
    ch[15] = (frame[21] >> 5 | frame[22] << 3) & 0x07FF;

    const uint8_t flags = frame[23];
    *frame_lost         = (flags & (1 << 2)) != 0;
    *failsafe           = (flags & (1 << 3)) != 0;
    return true;
}

bool probeI2CAddress(m5::I2C_Class& i2c, uint8_t addr)
{
    return i2c.scanID(addr, 400000);
}

bool selectPaHubChannel(m5::I2C_Class& i2c, uint8_t channel)
{
    if (channel >= 6) {
        return false;
    }

    if (!i2c.start(kPaHubAddr, false, 400000)) {
        return false;
    }
    bool ok = i2c.write(1 << channel);
    ok      = i2c.stop() && ok;
    return ok;
}

// Deselect every PaHUB channel (mux passes nothing through).
void deselectHub()
{
    g_currentHubCh = -1;
    if (extI2C && extI2C->start(kPaHubAddr, false, 400000)) {
        extI2C->write(0x00);
        extI2C->stop();
    }
}

void scanExternalBus()
{
    if (extI2C == nullptr || !extI2C->isEnabled()) {
        Serial.println("[I2C] External I2C bus is not enabled");
        return;
    }

    const float power_v = M5StamPLC.getPowerVoltage();
    tprintf("[SENS] power=%.2fV\n", power_v);

    // Cheap steady-state probe (low latency). With the PaHUB, probe each expected
    // device on its channel; without it, probe Port A flat. Bare 0xNN tokens keep
    // the dashboard parser happy; per-channel detail is in the I2C_SCAN command.
    // Full bus sweep = "I2C_SCAN" host command (scanI2CFull()).
    // Build the whole line into one buffer, then TEE it (USB + UDP). This line was serial-only, so
    // the dashboard's I2C device list went blank the moment USB was unplugged — tee it for parity.
    char sbuf[160];
    int  p = snprintf(sbuf, sizeof(sbuf), "[I2C] scan:");
    bool any = false;
    auto add = [&](uint8_t addr) {
        if (p > 0 && p < (int)sizeof(sbuf) - 6) p += snprintf(sbuf + p, sizeof(sbuf) - p, " 0x%02X", addr);
        any = true;
    };
    if (g_paHubPresent) {
        for (const HubDevice& d : kHubDevices) {
            if (!selectChannel(d.channel)) continue;
            if (!probeI2CAddress(*extI2C, d.addr)) continue;
            add(d.addr);
        }
    } else {
        static const uint8_t kFlat[] = {
            kServo8Addr, kPinpointAddr, kPrismAddr, kExtEncoderAddr, kOtosAddr};
        for (uint8_t addr : kFlat) {
            if (!probeI2CAddress(*extI2C, addr)) continue;
            add(addr);
        }
    }
    if (!any && p > 0 && p < (int)sizeof(sbuf) - 6) p += snprintf(sbuf + p, sizeof(sbuf) - p, " none");
    if (p > 0 && p < (int)sizeof(sbuf) - 1) { sbuf[p++] = '\n'; sbuf[p] = '\0'; }
    temit(sbuf, p);
}

// On-demand full 7-bit bus sweep (0x08-0x77). Triggered by the "I2C_SCAN" host
// command — NOT run periodically, since probing 112 addresses is high-latency.
// PaHUB-aware: top-level sweep first (the hub shows at 0x70), then a sweep behind
// each channel. The "[I2C] full:" line carries bare 0xNN for the dashboard; the
// "[I2C] hub chN:" lines carry the per-channel detail + expected-device labels.
void scanI2CFull()
{
    if (extI2C == nullptr || !extI2C->isEnabled()) {
        tprintf("[I2C] full: external I2C bus is not enabled\n");
        return;
    }
    // Each line is built into a buffer and TEE'd, so the scan is readable over Ethernet.
    // It used to be Serial-only, which made it useless without USB — and USB is exactly
    // what a robot in the field does not have.
    char b[192];
    int  n = snprintf(b, sizeof(b), "[I2C] full:");
    bool any = false;
    for (uint8_t addr = 0x08; addr <= 0x77; addr++) {
        if (!probeI2CAddress(*extI2C, addr)) continue;
        if (n > 0 && n < (int)sizeof(b) - 6) n += snprintf(b + n, sizeof(b) - n, " 0x%02X", addr);
        any = true;
    }
    if (!any) snprintf(b + n, sizeof(b) - n, " none");
    tprintf("%s\n", b);
    delay(25);

    if (!probeI2CAddress(*extI2C, kPaHubAddr)) {
        tprintf("[I2C] hub: not present at 0x70 (flat wiring)\n");
        return;
    }
    for (uint8_t ch = 0; ch < 6; ++ch) {
        if (!selectPaHubChannel(*extI2C, ch)) {
            tprintf("[I2C] hub ch%u: select failed\n", ch);
            continue;
        }
        n = snprintf(b, sizeof(b), "[I2C] hub ch%u:", ch);
        bool found = false;
        for (uint8_t addr = 0x08; addr <= 0x77; addr++) {
            if (addr == kPaHubAddr) continue;   // the mux doesn't answer behind itself
            if (!probeI2CAddress(*extI2C, addr)) continue;
            if (n > 0 && n < (int)sizeof(b) - 6) n += snprintf(b + n, sizeof(b) - n, " 0x%02X", addr);
            found = true;
        }
        if (!found && n > 0) n += snprintf(b + n, sizeof(b) - n, " none");
        for (const HubDevice& d : kHubDevices)
            if (d.channel == ch && n > 0 && n < (int)sizeof(b) - 32)
                n += snprintf(b + n, sizeof(b) - n, " [exp %s@0x%02X]", d.name, d.addr);
        tprintf("%s\n", b);
        delay(25);
    }
    deselectHub();
}

void consumeByte(uint8_t b)
{
    if (frame_pos == 0) {
        if (b != 0x0F) {
            return;
        }
        frame_buf[frame_pos++] = b;
        return;
    }

    frame_buf[frame_pos++] = b;
    if (frame_pos < sizeof(frame_buf)) {
        return;
    }

    uint16_t ch[16];
    bool failsafe = false;
    bool lost = false;

    if (decodeSbusFrame(frame_buf, ch, &failsafe, &lost)) {
        valid_frames++;
        last_valid_frame_ms = millis();
        memcpy(rc_ch, ch, sizeof(rc_ch));   // mirror to the local UI
        rc_failsafe   = failsafe;
        rc_frame_lost = lost;
        // Range-sanitize the analog sticks CH1-CH4 (ROTATE/MAST/FWD-REV/STRAFE). A value
        // outside the plausible SBUS band is not a real command — a receiver failsafe-preset
        // pegged to an extreme (e.g. CH3=0) or bus corruption. Flag it so the drive arm gate
        // blocks motion EVEN IF the SBUS failsafe flag was not set. Switch channels CH5-8
        // legitimately sit at their endpoints, so they are excluded.
        // Sanitize the channels actually carrying axes, whichever they are.
        rc_range_bad = false;
        for (const RcFn f : {FN_FWD, FN_ROT, FN_STR, FN_MAST}) {
            const int8_t c = rcCfgGet(f).ch;
            if (c >= 0 && !sbusInBand(ch[c])) { rc_range_bad = true; break; }
        }

        // NO PRINT HERE. A Serial.printf on this path blocked the control loop and was
        // the root cause of the intermittent "RC signal loss" chased in August; the fix
        // then was to print less often, which reduced the odds rather than removing the
        // hazard. It came back: 170-250 ms stalls in the SBUS drain, dropping the
        // drive-safe gate and — because armOK gates it — silently suppressing RC pan/tilt.
        //
        // It was redundant anyway. The 1 Hz [SBUS] status line carries the same counters
        // and is tee'd over Ethernet, which is the only place anyone can read it in service.
    } else {
        invalid_frames++;
    }

    frame_pos = 0;
}

void beginProfile(int idx)
{
    const auto& p = kProfiles[idx];
    rc.end();
    delay(20);
    rc.begin(p.baud, p.config, kBluePortRxPin, kBluePortTxPin, p.inverted);

    frame_pos          = 0;
    valid_frames       = 0;
    invalid_frames     = 0;
    total_bytes        = 0;
    last_valid_frame_ms = 0;
    last_status_ms      = millis();

    Serial.println();
    Serial.printf("[RC] Profile: %s | baud=%lu | cfg=0x%lX | inverted=%s | RX=G%d TX=G%d\n", p.name,
                  static_cast<unsigned long>(p.baud), static_cast<unsigned long>(p.config),
                  p.inverted ? "yes" : "no", kBluePortRxPin, kBluePortTxPin);
}

// ---- Local UI implementation ----
enum UiState { ST_BENCH, ST_ARMED, ST_WARN, ST_FAULT, ST_ESTOP };

// RC-derived operational state (drives the hero label + the PRISM indicator).
enum RcMode { RCM_NOLINK, RCM_FAILSAFE, RCM_ESTOP, RCM_OFF, RCM_MANUAL_SAFE, RCM_MANUAL_LIVE, RCM_AUTO };

static RcMode computeRcMode()
{
    if (local_estop_active) return RCM_ESTOP;
    const bool rc_live = (last_valid_frame_ms != 0) && (millis() - last_valid_frame_ms < kRcTimeoutMs);
    if (!rc_live)     return RCM_NOLINK;
    if (rc_failsafe || rc_range_bad) return RCM_FAILSAFE;   // flag OR a stick pegged out-of-band
    // Channel and polarity come from the per-robot RC map (RCCAL), not from fixed
    // indices — "which channel is the deadman, and which way round" is a transmitter
    // question, answered once in rc_config rather than re-litigated per subsystem.
    const uint16_t m    = rcRaw(FN_AUTH, rc_ch);
    const bool     held = rcAxis(FN_DEAD, rc_ch) > 0.5f;
    if (m < 600)  return RCM_OFF;
    if (m < 1400) return held ? RCM_MANUAL_LIVE : RCM_MANUAL_SAFE;
    return RCM_AUTO;
}

static uint8_t uiDi();   // fwd decl — defined below with the local-UI helpers

// ---- CONTACTOR AUTO-ARM ---------------------------------------------------------------------
// Closes R0 after startup so the robot comes up with motion power available instead of needing a
// dashboard re-arm on every power cycle.
//
// It KEEPS CHECKING until it arms. Powering on with CH5 already in MANUAL must not be a stuck
// state — it waits, says why on the PRISM, and arms the moment authority goes to OFF.
//
// It arms AT MOST ONCE, and an e-stop disables it for the rest of the boot. That is the safety
// property, not an optimisation: R0 is the e-stop element — the mushroom, the host ESTOP and the
// BtnC hold all work by OPENING it. Anything that re-closes it on a timer is a safety system
// fighting the operator. After an e-stop, re-arming is deliberate and guarded, via the dashboard.

static void autoArmTick(uint32_t now)
{
    if (g_autoArmFired || g_autoArmBlocked) { g_autoArmWaiting = false; return; }
    if (g_autoArmBootMs == 0) g_autoArmBootMs = now;
    if (now - g_autoArmBootMs < kAutoArmSettleMs) return;

    // A LATCHED e-stop is an explicit operator action, and a weld is a hardware fault. Neither is
    // something to wait out: stop trying for this boot so nothing arms behind the operator later.
    const uint8_t di = uiDi();
    if (local_estop_active) {
        g_autoArmBlocked = true; g_autoArmWaiting = false;
        tprintf("[SAFE] auto-arm disabled this boot: e-stop latched\n");
        return;
    }
    if ((di & (1u << 1)) != 0) {
        g_autoArmBlocked = true; g_autoArmWaiting = false;
        tprintf("[SAFE] auto-arm disabled this boot: contactor weld on DI1\n");
        return;
    }

    // Transient reasons to WAIT rather than give up. The e-stop chain is normally-closed, so a
    // held button (or a broken conductor) reads as pressed; releasing it should let the robot arm.
    const bool   di0estop = (di & 0x01) == 0;
    const RcMode mode     = computeRcMode();
    // Authority must not already be granted: the robot must not come up drivable. With no RC link
    // there is nothing to grant it, and the arm gate blocks output anyway, so that case may arm.
    const bool authorityOff = (mode == RCM_NOLINK) || (mode == RCM_OFF);

    const char* why = nullptr;
    if (!g_driveSafe)       why = "loop/RC still settling";
    else if (di0estop)      why = "e-stop chain open — button pressed, or a broken conductor";
    else if (!authorityOff) why = "CH5 not OFF";

    if (why) {
        g_autoArmWaiting = true;
        // Say it once per distinct reason rather than at 50 Hz.
        static const char* lastWhy = nullptr;
        if (why != lastWhy) { lastWhy = why; tprintf("[SAFE] not arming: %s\n", why); }
        return;
    }

    g_autoArmFired  = true;
    g_autoArmWaiting = false;
    M5StamPLC.writePlcRelay(0, true);
    tprintf("[SAFE] auto-arm: contactor closed (once only; an e-stop will NOT be re-armed)\n");
}

// ---- Drive: SBUS axis → normalized -1..1 ----
static float sbusAxis(uint16_t raw)
{
    const float v = (float)((int)raw - kSbusCtr) / (float)kSbusHalf;
    return constrain(v, -1.0f, 1.0f);
}

// ---- Mixer: (fwd, rot, str) -1..1 → wheel[4] {FL,FR,RL,RR} -1..1 ----
// Mode-aware and source-agnostic (same math whether the inputs came from the RC
// sticks or a ROS/Thor DRIVE command). Strafe collapses to 0 in non-mecanum modes.
static void driveMix(float fwd, float rot, float str, DriveMode mode, float w[4])
{
    if (mode == DM_MECANUM) {
        str *= (float)kStrafeInvert;   // per robot: the rollers' handedness (robot_config.h)
        w[0] = fwd + str + rot;   // FL
        w[1] = fwd - str - rot;   // FR
        w[2] = fwd - str + rot;   // RL
        w[3] = fwd + str - rot;   // RR
    } else {                      // SKID4 / DIFF2: arcade, strafe ignored
        const float l = fwd + rot, r = fwd - rot;
        w[0] = (mode == DM_DIFF2) ? 0.0f : l;   // FL (idle → caster/ball in 2WD)
        w[1] = (mode == DM_DIFF2) ? 0.0f : r;   // FR (idle in 2WD)
        w[2] = l;                                // RL
        w[3] = r;                                // RR
    }
    // Scale down uniformly if any wheel exceeds ±1 (preserves heading/ratio).
    float mx = 1.0f;
    for (int i = 0; i < 4; ++i) mx = max(mx, fabsf(w[i]));
    for (int i = 0; i < 4; ++i) w[i] = constrain(w[i] / mx, -1.0f, 1.0f);
}
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
