UW-Allen-School-Robotics/opendubs/firmware/rc_serial_probe/src/vl53l1x/VL53L1X.h

// VENDORED from https://github.com/pololu/vl53l1x-arduino (BSD-3 — see LICENSE.txt).
//
// Kept as close to upstream as possible so it can be re-synced: the ONLY change is the bus
// type. Arduino's Wire is not on the StamPLC's external I2C, and every device there sits
// behind a PaHub mux, so `HubI2C` presents the same five methods over m5::I2C_Class with a
// channel select in front of each transaction. Everything else — the register map, the init
// sequence, the timing-budget maths — is upstream's and should stay that way.
#pragma once

#include <Arduino.h>
#include "hub_i2c.h"

class VL53L1X
{
  public:

    // register addresses from API vl53l1x_register_map.h
    enum regAddr : uint16_t
    {
      SOFT_RESET                                                                 = 0x0000,
      I2C_SLAVE__DEVICE_ADDRESS                                                  = 0x0001,
      ANA_CONFIG__VHV_REF_SEL_VDDPIX                                             = 0x0002,
      ANA_CONFIG__VHV_REF_SEL_VQUENCH                                            = 0x0003,
      ANA_CONFIG__REG_AVDD1V2_SEL                                                = 0x0004,
      ANA_CONFIG__FAST_OSC__TRIM                                                 = 0x0005,
      OSC_MEASURED__FAST_OSC__FREQUENCY                                          = 0x0006,
      OSC_MEASURED__FAST_OSC__FREQUENCY_HI                                       = 0x0006,
      OSC_MEASURED__FAST_OSC__FREQUENCY_LO                                       = 0x0007,
      VHV_CONFIG__TIMEOUT_MACROP_LOOP_BOUND                                      = 0x0008,
      VHV_CONFIG__COUNT_THRESH                                                   = 0x0009,
      VHV_CONFIG__OFFSET                                                         = 0x000A,
      VHV_CONFIG__INIT                                                           = 0x000B,
      GLOBAL_CONFIG__SPAD_ENABLES_REF_0                                          = 0x000D,
      GLOBAL_CONFIG__SPAD_ENABLES_REF_1                                          = 0x000E,
      GLOBAL_CONFIG__SPAD_ENABLES_REF_2                                          = 0x000F,
      GLOBAL_CONFIG__SPAD_ENABLES_REF_3                                          = 0x0010,
      GLOBAL_CONFIG__SPAD_ENABLES_REF_4                                          = 0x0011,
      GLOBAL_CONFIG__SPAD_ENABLES_REF_5                                          = 0x0012,
      GLOBAL_CONFIG__REF_EN_START_SELECT                                         = 0x0013,
      REF_SPAD_MAN__NUM_REQUESTED_REF_SPADS                                      = 0x0014,
      REF_SPAD_MAN__REF_LOCATION                                                 = 0x0015,
      ALGO__CROSSTALK_COMPENSATION_PLANE_OFFSET_KCPS                             = 0x0016,
      ALGO__CROSSTALK_COMPENSATION_PLANE_OFFSET_KCPS_HI                          = 0x0016,
      ALGO__CROSSTALK_COMPENSATION_PLANE_OFFSET_KCPS_LO                          = 0x0017,
      ALGO__CROSSTALK_COMPENSATION_X_PLANE_GRADIENT_KCPS                         = 0x0018,
      ALGO__CROSSTALK_COMPENSATION_X_PLANE_GRADIENT_KCPS_HI                      = 0x0018,
      ALGO__CROSSTALK_COMPENSATION_X_PLANE_GRADIENT_KCPS_LO                      = 0x0019,
      ALGO__CROSSTALK_COMPENSATION_Y_PLANE_GRADIENT_KCPS                         = 0x001A,
      ALGO__CROSSTALK_COMPENSATION_Y_PLANE_GRADIENT_KCPS_HI                      = 0x001A,
      ALGO__CROSSTALK_COMPENSATION_Y_PLANE_GRADIENT_KCPS_LO                      = 0x001B,
      REF_SPAD_CHAR__TOTAL_RATE_TARGET_MCPS                                      = 0x001C,
      REF_SPAD_CHAR__TOTAL_RATE_TARGET_MCPS_HI                                   = 0x001C,
      REF_SPAD_CHAR__TOTAL_RATE_TARGET_MCPS_LO                                   = 0x001D,
      ALGO__PART_TO_PART_RANGE_OFFSET_MM                                         = 0x001E,
      ALGO__PART_TO_PART_RANGE_OFFSET_MM_HI                                      = 0x001E,
      ALGO__PART_TO_PART_RANGE_OFFSET_MM_LO                                      = 0x001F,
      MM_CONFIG__INNER_OFFSET_MM                                                 = 0x0020,
      MM_CONFIG__INNER_OFFSET_MM_HI                                              = 0x0020,
      MM_CONFIG__INNER_OFFSET_MM_LO                                              = 0x0021,
      MM_CONFIG__OUTER_OFFSET_MM                                                 = 0x0022,
      MM_CONFIG__OUTER_OFFSET_MM_HI                                              = 0x0022,
      MM_CONFIG__OUTER_OFFSET_MM_LO                                              = 0x0023,
      DSS_CONFIG__TARGET_TOTAL_RATE_MCPS                                         = 0x0024,
      DSS_CONFIG__TARGET_TOTAL_RATE_MCPS_HI                                      = 0x0024,
      DSS_CONFIG__TARGET_TOTAL_RATE_MCPS_LO                                      = 0x0025,
      DEBUG__CTRL                                                                = 0x0026,
      TEST_MODE__CTRL                                                            = 0x0027,
      CLK_GATING__CTRL                                                           = 0x0028,
      NVM_BIST__CTRL                                                             = 0x0029,
      NVM_BIST__NUM_NVM_WORDS                                                    = 0x002A,
      NVM_BIST__START_ADDRESS                                                    = 0x002B,
      HOST_IF__STATUS                                                            = 0x002C,
      PAD_I2C_HV__CONFIG                                                         = 0x002D,
      PAD_I2C_HV__EXTSUP_CONFIG                                                  = 0x002E,
      GPIO_HV_PAD__CTRL                                                          = 0x002F,
      GPIO_HV_MUX__CTRL                                                          = 0x0030,
      GPIO__TIO_HV_STATUS                                                        = 0x0031,
      GPIO__FIO_HV_STATUS                                                        = 0x0032,
      ANA_CONFIG__SPAD_SEL_PSWIDTH                                               = 0x0033,
      ANA_CONFIG__VCSEL_PULSE_WIDTH_OFFSET                                       = 0x0034,
      ANA_CONFIG__FAST_OSC__CONFIG_CTRL                                          = 0x0035,
      SIGMA_ESTIMATOR__EFFECTIVE_PULSE_WIDTH_NS                                  = 0x0036,
      SIGMA_ESTIMATOR__EFFECTIVE_AMBIENT_WIDTH_NS                                = 0x0037,
      SIGMA_ESTIMATOR__SIGMA_REF_MM                                              = 0x0038,
      ALGO__CROSSTALK_COMPENSATION_VALID_HEIGHT_MM                               = 0x0039,
      SPARE_HOST_CONFIG__STATIC_CONFIG_SPARE_0                                   = 0x003A,
      SPARE_HOST_CONFIG__STATIC_CONFIG_SPARE_1                                   = 0x003B,
      ALGO__RANGE_IGNORE_THRESHOLD_MCPS                                          = 0x003C,
      ALGO__RANGE_IGNORE_THRESHOLD_MCPS_HI                                       = 0x003C,
      ALGO__RANGE_IGNORE_THRESHOLD_MCPS_LO                                       = 0x003D,
      ALGO__RANGE_IGNORE_VALID_HEIGHT_MM                                         = 0x003E,
      ALGO__RANGE_MIN_CLIP                                                       = 0x003F,
      ALGO__CONSISTENCY_CHECK__TOLERANCE                                         = 0x0040,
      SPARE_HOST_CONFIG__STATIC_CONFIG_SPARE_2                                   = 0x0041,
      SD_CONFIG__RESET_STAGES_MSB                                                = 0x0042,
      SD_CONFIG__RESET_STAGES_LSB                                                = 0x0043,
      GPH_CONFIG__STREAM_COUNT_UPDATE_VALUE                                      = 0x0044,
      GLOBAL_CONFIG__STREAM_DIVIDER                                              = 0x0045,
      SYSTEM__INTERRUPT_CONFIG_GPIO                                              = 0x0046,
      CAL_CONFIG__VCSEL_START                                                    = 0x0047,
      CAL_CONFIG__REPEAT_RATE                                                    = 0x0048,
      CAL_CONFIG__REPEAT_RATE_HI                                                 = 0x0048,
      CAL_CONFIG__REPEAT_RATE_LO                                                 = 0x0049,
      GLOBAL_CONFIG__VCSEL_WIDTH                                                 = 0x004A,
      PHASECAL_CONFIG__TIMEOUT_MACROP                                            = 0x004B,
      PHASECAL_CONFIG__TARGET                                                    = 0x004C,
      PHASECAL_CONFIG__OVERRIDE                                                  = 0x004D,
      DSS_CONFIG__ROI_MODE_CONTROL                                               = 0x004F,
      SYSTEM__THRESH_RATE_HIGH                                                   = 0x0050,
      SYSTEM__THRESH_RATE_HIGH_HI                                                = 0x0050,
      SYSTEM__THRESH_RATE_HIGH_LO                                                = 0x0051,
      SYSTEM__THRESH_RATE_LOW                                                    = 0x0052,
      SYSTEM__THRESH_RATE_LOW_HI                                                 = 0x0052,
      SYSTEM__THRESH_RATE_LOW_LO                                                 = 0x0053,
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
