UW-Allen-School-Robotics/opendubs/(commit log)

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2026-08-19 Rewrite thor-setup as a canonical guide; scrub Pixhawk from all docs
    - thor-setup.md: rewritten as a Thor-first how-to for an outside builder —
    flash JetPack 7 (Linux host), first boot, deploy+provision, and the
    touchscreen + kiosk-boot setup that was missing. Dropped the Pixhawk framing
    and the macOS-can't-flash-Jetson clone/VM tangents.
    - Scrubbed Pixhawk/MAVLink/ArduPilot from index, network-architecture,
    state-machines, portability-audit, localization-fusion (it's retired — RC is
    StampPLC SBUS).
    Note: dead MAVLink code residue remains (mavlink_rc.py, opendubs-mavros
    service/script, pymavlink dep) — a separate cleanup.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
2026-08-19 Suppress Pixhawk: move MAVLink/MAVROS to optional/pixhawk (off baseline)
    Pixhawk isn't the baseline (RC = StampPLC SBUS), but keep it for a possible future
    variant — treat it like the notes/ material: in-repo, off the baseline.
    - Move mavlink_rc.py + opendubs-mavros.service + mavros.sh → optional/pixhawk/
    (with a README on what it is and how to re-enable); pymavlink → its requirements.
    - Detach from baseline: drop pymavlink from backend requirements; drop opendubs-mavros
    from deploy-all.sh + provision-ros.sh SERVICES and the MAVROS apt/geographiclib steps;
    remove the MAVROS section from software/ros/README.md.
    - Fix stale/misleading live references: the frontend "RC via Pixhawk"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
    [mavlink_rc.py]
2026-08-20 firmware: enable RC drive with bench-verified ESC mapping + In_I2C fix
    Bring-up of the mecanum drive path on hardware (wheels off, then RC-confirmed):
    - DRIVE_ENABLE 0->1: RC/ROS mixer now writes the 8Servo -> ESCs.
    - ESC channel map bench-mapped [FL,FR,RL,RR] = 8Servo ch {1,3,0,2}
    (was the placeholder {1,2,3,4}). PRISM moved off ch0 to I2C.
    - Per-wheel direction sign kDriveInvert {1,1,1,-1}: RR (ch2) is wired
    reversed; invert so a forward command drives all four robot-forward.
    - kEscSpanUs 400->150 (band 1350-1650us). Narrow band clears the
    "all ESC LEDs red" trip seen at +/-400 and keeps inrush gentle when
    all four spin up together; widen back toward 400 after more testing.
    - uiPr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
    [main.cpp]
2026-08-20 docs: add drive bring-up diagnostic (channel -> ESC -> wheel & direction)
    Step-by-step bench procedure (wheels off) to verify each 8Servo channel
    maps to the intended ESC/wheel and spins the right way, using the
    firmware's SERVO8 <ch> <pulse_us> single-channel command, and to build
    the kDriveCh / kDriveInvert tables from the observed result. Includes the
    reference-build mapping and the ESC arming / latched-fault-clearing
    behavior (the ~5V signal rail holds the fault through an R0 power-cycle;
    drop the signal leads to fully reset). Linked under Build & Flash.
2026-08-21 firmware: self-healing Ethernet (link + heartbeat watchdogs) for USB-less operation
    Makes the StampPLC's Ethernet transport robust enough to run with USB
    physically disconnected (validated: telemetry in + R0 command out over
    UDP, zero re-inits).
    Ethernet robustness (the core change):
    - eth used to latch eth_up=true at boot and never re-check, so a single
    link/stack drop was permanent until a hard reset. Refactored bring-up
    into netBringUp() (DHCP at boot, captures the lease; STATIC non-blocking
    re-assert for self-heal so a mid-run re-init can't stall the 50Hz loop)
    and netMaintain() (1Hz): retries if never up, watches linkStatus() and
    re-inits the W5500 on a PHY drop, renews DHCP.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
    [main.cpp]
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2026-08-21 docs, gitignore: Thor OS-flash host fix + repair silently-broken ignores
    - docs/thor-setup.md: NVIDIA SDK Manager runs on an Ubuntu host OR on
    Windows (via WSL2); only macOS is unsupported. (Was "macOS and Windows
    cannot flash a Jetson.")
    - .gitignore: the `ops/` secrets-exclusion had an inline `#` comment,
    which git treats as part of the literal pattern — so `ops/` (keys /
    private config, "never public") was NOT actually being ignored.
    Verified `ops/secret.env` was committable. Moved comments to their own
    lines and added `notes/drafts/` (un-vetted working design notes). Both
    now ignore correctly.
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2026-08-21 docs: tighten design philosophy + fix power/data facts; move interfaces up front
    - design-philosophy: SO-101 is ~$300 (not ~$100); drop the "order of
    magnitude / doesn't compete on price" framing — state the relationship
    plainly (a different piece of the stack; complements LeRobot, doesn't
    compete). Reword the salesy positioning paragraph.
    - mechanical-mount: reword the awkward opening sentence.
    - power-data: corrected — 52 V nominal battery (enables a user 48 V add-on
    bus; can drive an inverter for AC, TBD); fused branches exist on BOTH the
    logic bus (Mini Power Module) and the drive bus (REV PDH); StampPLC is the
    CAN master and the PDH is a data node (not a controller); add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
2026-08-21 docs: regen clamp is settled — state the one-way buck as the reason, not a question
    Corrects my over-flagging. The regen clamp is kept and lives downstream at
    the ESCs *because* the 52->24 buck is one-way (regen can't backfeed the pack,
    so it's shunted at the bus) — a settled decision, not "under review". The
    sizing already works the 24 V bus case, so the numbers stand; only the old
    battery-direct ~21 V column is retired.
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2026-08-21 docs: power-architecture — Figma source link + fix logic buck to 20 A
    - Add the Figma board link (view/export with the link).
    - Logic buck is 20 A (not 35 A — misread the diagram); drive buck stays 60 A.
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2026-08-21 docs: sweep out contextless legacy references
    Reader-facing docs should state the current design, not narrate what changed.
    - hardware-bom: battery row drops the "replaces the DeWalt packs / switcher /
    Victron combiner" changelog; BOM-gaps line drops the internal "Case-2 load"
    jargon.
    - drive-bringup: drop the "on some earlier firmware ch0 was an LED"
    archaeology — just state ch0 is a drive ESC (PRISM is on I2C).
    - stamplc-ethernet-transport: drop "legacy … superseded by the tee" framing on
    the JSON heartbeat — just note it broadcasts and is ignored.
    (The remaining "stale frame/telemetry" hits are legitimate technical terms;
    the portability-audit "previously-manual" is an aud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
2026-08-21 docs: RC mapping — add Figma source link, resolve CH7 (mast enable)
    CH7 is the mast/Z-axis on-off enable (drive without risk of actuating the
    mast); "mat" was a mishearing of "mast".
2026-08-21 docs: e-stop system page — wiring from the actual diagram + reference datasheets
    New docs/e-stop.md (Electronics & Power), anchored by the real e-stop safety-
    logic diagram (Figma): GX11 contactor coil chain off the logic bus through a
    double-pole NC/NC e-stop (one pole in the chain, the other -> DI0 sensing) and
    the StampPLC R0 relay; opens on no-power / HW / SW e-stop; GX11 aux -> DI6 weld
    sense. A second diagram shows a payload/supplemental e-stop jumpered onto the
    WAGO buses in series.
    - DI0 sensing corrected per the M5 doc: the StampPLC DIs are OPTO-ISOLATED
    (EL3H4, DC 5-36 V, INPUT/COM). A +24 V high-level signal lands on INPUT with
    COM tied to the 24 V return -- not a measureme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
2026-08-21 docs: clarify the RUN button is the logic-bus master switch, not a coil-chain link
    The RUN button enables the logic bus; without it the StampPLC never powers up
    so R0 never closes and the contactor can't hold. Corrects power-architecture
    (which wrongly listed RUN as a coil-hold condition) and adds the mechanism to
    the e-stop page.
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2026-08-21 firmware: Ethernet OTA + 8Servo s8fail fix + I2C telemetry parity
    Batch flashed and validated on the robot over Ethernet (USB untouched):
    - Ethernet OTA: `OTA http://host:port/fw.bin` (serial or UDP) pulls a .bin over
    HTTP and self-flashes via the Update library, then reboots into it — so the
    StampPLC never needs USB again. Pinned default.csv (dual-OTA app0/app1, ~1.31MB
    each; image is ~0.6MB). Drops R0 first (no motion during reflash); aborts and
    stays on the current image on any failure. Added ota-from-thor.sh (build → serve
    → trigger → verify recovery). Proven end-to-end: download → write → reboot →
    telemetry live again, all over the network.
    - 8Servo MODE-once: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
    [main.cpp]
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2026-08-21 docs: StampPLC connections page + RC receiver wiring build page
    - stamplc-connections.md: canonical wiring reference for assembly + troubleshooting
    — the external bus map (SBUS/Ethernet/CAN/RS485/I2C + pins) and the relay /
    isolated-input tables (R0 contactor, R1 8Servo cycle; DI0 e-stop, DI1 weld). Two
    Figma-diagram figures scaffolded (commented until the PNGs land) per our convention.
    - build/rc-receiver.md: the SBUS blue-port (Grove/M5) -> 3-wire servo-cable pigtail
    as an assembly step, leading with the wire-by-function warning (Grove and servo
    color conventions differ; reversing 5V/GND kills the receiver).
    - e-stop.md: weld DI6 -> DI1; cross-link the connections page. Nav upd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
2026-08-21 docs: add the StampPLC bus + RC receiver wiring diagrams
    Wire the two saved Figma exports into their pages. The RC receiver diagram
    (RadioLink R8EF) shows the actual Grove cable colors — G4 white unused, G5 yellow
    = signal, 5 V red, GND black — which line up with the servo cable, so the build
    page is corrected from "colors don't map" to "verify anyway; G4 is the unused wire
    and pin order varies". The relay/DI diagram is still pending (placeholder kept).
2026-08-21 docs: add a real build-photo example (miter gear sub-assembly)
    Demonstrates the build-photo workflow end to end: photos from the "1 - Base Frame
    Build" Drive folder selected in photos.manifest, resized via
    convert-build-photos.sh (sips, 1600px), and placed in base-frame.md Step 2. Two
    shots — the 8mm REX miter gear before assembly, and mated to the hub — replace the
    Step 2 TODO-photo placeholder as a worked example for contributors.
2026-08-21 kiosk: fix touch panel USB port + rotation (persist the fixes)
    Nailed down on the robot: the touch panel must be on USB-C port 5b (host) or a
    USB-A port — 5a is the Force-Recovery port (device/UFP mode, peripheral never
    enumerates) — and off any bus-powered hub (it flaps "disabled by hub (EMI?)" on an
    overloaded hub; a root port is stable). And the panel is right-side-up at xrandr
    "right", not "left".
    - touch-bridge.sh: force `xrandr --rotate right` + `TOUCH_ROT=right` (the bridge
    reliably runs on boot; kiosk-session.sh doesn't always). Display and the bridge's
    touch mapping must agree or touches land rotated.
    - kiosk-session.sh: `--rotate left` -> `right`; drop the moot xinput matr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
2026-08-21 docs: add the StampPLC relay/input diagram; update base-frame hero
    - stamplc-connections.md: wire in the relay & input connections diagram
    (stamplc-inputs-and-relays.png) — e-stop button → DI0, contactor weld → DI1,
    RELAY 1 (R0) → e-stop contactor, Mini PDH feeding the input COMs. Adds a note
    that the board silk is 1-indexed (IN 1 = DI0, RELAY 1 = R0) vs the 0-indexed
    firmware/dashboard.
    - Replace the base-frame hero.png with the updated render.
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2026-08-22 docs: link the goBILDA ESC datasheet + note it's over-spec; fix OTOS level-shifter
    - parts.csv: point the 2x80A ESC row at the goBILDA datasheet and note that 2x80A is
    likely over-spec for this drivetrain (a lower-amperage ESC would work and cost
    less) — regenerated the electronics-bay BOM.
    - otos.md: the level shifter is the Adafruit logic level converter (5637), not a
    SparkFun Qwiic one — fixed the harness caption to match the BOM/reality (the
    diagram image itself is being corrected separately).
    [parts.csv]
2026-08-22 stamplc: show 1-indexed IN/RELAY numbers to match the board silk
    The StampPLC silkscreen labels inputs IN 1-8 and relays RELAY 1-4 (1-indexed), but
    the M5 API and our code are 0-indexed (DI0/R0), so the dashboard/UI numbers didn't
    match the hardware. Relabel the human-facing layer to the physical 1-indexed
    numbers; internal M5 calls + host commands stay 0-indexed.
    - dashboard: frontend shows IN{i+1} / RELAY{i+1}; status.py drops the 0-indexed
    "(DI2)"/"(R2)" parentheticals (the frontend supplies the physical number).
    - firmware SAFETY page: E-STOP IN1, WELD IN2, CONTACTOR R1, R2/R3/R4 for spares.
    - docs (stamplc-connections): tables lead with IN 1-8 / RELAY 1-4, code index in
    parens (R0/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
    [main.cpp]
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2026-08-22 docs: explain goBILDA + 3D printing and the drive system (why + limits)
    Design-philosophy pickups from the punch list:
    - What goBILDA is and why we use it + 3D printing (modular/no-fab, the FTC/FIRST
    ecosystem, abundant resources); link goBILDA's Product Insight (also added to the
    Base Frame resources).
    - Why mecanum (strafe + rotate-in-place), that it's reconfigurable to tank/4WD and
    other wheels (all-terrain link), and why not swerve (2-3x/wheel cost + complexity).
    - Load-limit analysis of the 8mm REX drivetrain: static is comfortable (~61N/wheel
    at ~25kg), dynamic is the limit — hard braking/off-road/overload damage
    hubs/bearings/mecanum wheels (static/impact) or miter/planeta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
2026-08-23 docs: Figma facade — static poster, click to load the live pan/zoom embed
    Replace the always-on Figma iframe on the bus map with a click-to-load facade: a
    lightweight poster PNG by default (fast, offline-friendly), and the interactive
    pan/zoom Figma board loads in place only when clicked. Reusable across pages
    (docs/javascripts/figma-facade.js + .figma-facade CSS + data-embed attr).
    Also logged a punch-list TODO to go diagram-by-diagram deciding embed vs. static.
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2026-08-23 fix: add missing goRAIL to base-frame BOM; fix embed-facade poster paths
    - BOM: add 4x 1118-0024-0192 (1118 Series Open goRAIL, 192mm) to the base-frame
    Frame-structure group; regenerated (64 parts).
    - Embed facade: the raw-HTML poster <img> used a source-relative path that mkdocs
    does NOT rewrite for directory URLs, so it 404'd → the broken-image "?" square.
    Switch the poster to a `markdown="1"` block + markdown image so mkdocs rewrites
    the path (../../assets on build pages, ../assets on top-level); add a p-margin
    reset for the paragraph the markdown block wraps around the image. Fixes both the
    Fusion CAD and the bus-map posters. Click-to-load embed unchanged.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
    [parts.csv]
2026-08-23 docs: real OTOS hero render (replace placeholder)
    Swap the OTOS page's placeholder-hero.svg for the new Fusion CAD render of the
    module (printed enclosure holding the sensor + level converter at the 10mm ride
    height). Fusion embed to follow once the share link is in hand.
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2026-08-23 docs: safety & disclaimer notice, PPE, battery-safety links
    - Home page: prominent Safety & disclaimer notice — "provided as is / no warranty /
    no liability" (standard open-hardware language), competence required, and the
    concrete hazards: heavy battery + no hands under the robot, electrical
    shock/arc/fire/stored-energy, PPE; operating hazards — uncommanded motion, mecanum
    roll-away on a slope, collisions injuring people/property. Links the ECO-WORTHY
    battery manual.
    - Battery Install page: battery-safety danger box + the ECO-WORTHY manual link.
    - Tools BOM: add Safety glasses + Work gloves (PPE, required) at the top; regenerated.
    - Electronics Bay: add a Wiring section with th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
    [parts.csv]
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2026-08-23 docs: retire the REV PDH CAN feasibility page (resolved + duplicated)
    The PDH<->StampPLC CAN path is implemented (firmware sniffs [PDH] telemetry + has
    PDH_SWITCH/PDH_CLEAR_FAULTS), so the feasibility "evaluation" is obsolete, and the
    only live question — REV PDH vs. a cheaper fuse block — is already covered on the
    Power Bay page. Archive it to notes/history/ with a banner; drop it from the nav and
    the home-page link.
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2026-08-23 docs: real hero renders for lidar + power bay
    Lidar hero.png now serves as the Fusion facade poster (click loads the live 3D
    viewer); power bay swaps its placeholder for the CAD render.
2026-08-25 docs(base-frame): real build photos + steps rewritten to match build order
    Wire the 19 photos from the "1 - Base Frame Build" Drive folder into the Base
    Frame page, replacing the TODO photo placeholders.
    The photos show the frame being built in a different order than the page
    described: the motors and hub shafts are installed INSIDE each side rail first,
    and only then are the rails joined into the rectangle. The old outline had the
    rectangle assembled first (Step 1) and the pods mounted afterwards (Step 3),
    which is not buildable — once the rectangle closes there is no clearance to
    drive the motor-mount screws. Steps are now:
    1. Lay out the rails and hardware
    2. Mount the motors insi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
2026-08-25 docs(base-frame): hold photos under the 300 KB budget from the assets README
    docs/assets/build/README.md asks for ~1600 px on the long edge AND under 300 KB
    each. The first pass met the first rule but not the second — 11 of 19 were over,
    up to 590 KB.
    convert_build_photos.py now enforces the budget itself (MAXKB, default 300): it
    steps quality down from QUALITY, and if a photo still won't fit at the quality
    floor it shrinks 10% at a time down to MIN_PX. Busy shots — carpet texture,
    cluttered benches — hit the floor while still oversize, and a slightly smaller
    photo reads better than a mushy full-size one. Each line now reports the size,
    quality and edge it settled on, and flags anythi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
2026-08-25 dashboard: responsive tablet layout + PWA (installable, fullscreen)
    The dashboard was hard-pinned to 1920x480 (the kiosk strip). Add a
    max-width:1600 media query so tablets/phones/laptop windows get a reflowed,
    scrollable, touch-sized layout (topbar wraps with a scrollable tab row; each
    view stacks its cards; inner grids go auto-fit). The 1920x480 panel reports
    width:1920 and never matches the query, so its fixed layout is untouched.
    Also add a web app manifest + SVG icon + apple-mobile meta and switch the
    viewport to device-width, so 'Add to Home Screen' gives a fullscreen landscape
    app on the Fire/Galaxy tablets.
2026-08-25 dashboard: fix landscape tablets falling back to the panel layout
    The responsive breakpoint was width-only (max-width:1600), so a high-res tablet
    in LANDSCAPE (e.g. Fire HD 10 = 1920x1200, CSS width >=1600) failed the query and
    got the fixed 1920x480 panel layout -> broken. Key the fallback on the panel's
    defining trait instead: it is uniquely SHORT. Query is now
    (max-width:1600),(min-height:561) so anything taller than the 480px panel
    (every tablet, either orientation) gets the responsive layout; only the true
    wide+short panel keeps the fixed grid.
    Also switch views to an auto-fit grid (minmax(min(600px,100%),1fr), forced with
    !important over each view's own grid) so it's 1 column in portr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
2026-08-28 docs(build): add step 2 Rivnut Installation; renumber lower frame to 1-12
    Insert a new "2 · Rivnut Installation" step between Base Frame and Electronics
    Bay — riv-nuts are far easier to set on the bare frame than after modules are in.
    Renumber the rest of the lower-frame steps (Electronics Bay 3 … Base Frame Final
    12) across page titles, the nav, and the assembly-overview list + counts.
    The one confirmed substep today is the rear odo-pod / Pinpoint module mount
    (thread riv-nut on tool → press TIGHT & flat to the rail and set → attach pods),
    with the critical technique called out: keep the tool flush/tight or the riv-nut
    bulges outside the frame. Tools + M10 riv-nut linked; photo pl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
2026-08-28 docs(build): add step 3 Thor Install (w/ photos); pull rivnut photos; renumber to 1-13
    - New "3 · Thor Install" step: mount the AGX Thor to the frame in a 3D-printed
    cradle held by two goBILDA dual blocks + 55 mm M4 screws. Real build photos
    pulled from the Drive folder (dual blocks/screws, other side, slide-in with
    orientation note, top view). BOM rows added (dual blocks, M4 screws, printed
    cradle); STL is a TODO. Placed as an early base-frame step per the build order.
    - Renumber the rest of the lower frame accordingly (Electronics Bay 4 … Base
    Frame Final 13) across titles, nav, the overview list + counts, and cross-refs.
    - Rivnut step: swapped the photo placeholders for the a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
    [parts.csv]
2026-08-28 docs(philosophy): note the TidyBot++ project (swerve vs mecanum)
    Add TidyBot++ as a closely-related open mobile-manipulation project in the
    ecosystem section, and reference it from the drive-system rationale. Capture the
    key divergence: TidyBot++ uses a powered-caster holonomic (swerve-like) base vs
    OpenDubs mecanum; swerve units currently ~3x the cost and can't be trivially
    reconfigured to a fixed FWD drive like mecanum can. A swerve alternative + a
    detailed OpenDubs<->TidyBot++ comparison chart are noted as future work.
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2026-08-30 docs(base-frame): real build photos + steps rewritten to match build order
    Wires the 19 photos from the "1 - Base Frame Build" Drive folder into the Base
    THE STEP ORDER CHANGED, and that is the part worth reviewing. The photos show
    the motors and hub shafts installed INSIDE each side rail first, with the rails
    only joined into the rectangle afterwards. The page had the rectangle assembled
    in Step 1 and the pods mounted to its corners in Step 3 — which is not
    buildable, because once the rectangle closes there is no clearance to get a hex
    driver onto the motor-mount screws. New outline:
    2. Mount the mo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
2026-09-01 build(stamplc): pin platform to espressif32@7.0.1
    The libs were pinned but the PLATFORM was not, so it resolved to the latest
    espressif32 — whose ESP-IDF changed esp_task_wdt_init() to the struct-config
    form, breaking the build outright:
    error: too many arguments to function 'esp_err_t esp_task_wdt_init(const esp_task_wdt_config_t*)'
    7.0.1 is the version this firmware was written and flashed against, and is the
    one cached on the robots for offline flashing. This restores the file's own
    stated intent that any machine reproduces the working build.
2026-09-01 fix(safety): read DI0 e-stop as a normally-closed fail-safe chain
    The e-stop button is an NC chain: DI0 HIGH = released/safe, LOW = pressed OR a
    broken wire. Both the firmware and the dashboard were reading it active-HIGH,
    which inverts the sense and — worse — makes a severed conductor read as "all
    clear" instead of as an e-stop.
    This is a correctness fix for every robot, not a per-unit wiring value. The
    fielded robot already runs this behaviour; the repo was simply behind.
    [main.cpp]
2026-09-01 feat(odometry): read the goBILDA Pinpoint and surface pose on the dashboard
    Firmware gains a Pinpoint driver (I2C 0x31, PaHub ch4) publishing a new [ODO]
    line at 10 Hz; the backend parses it; the dashboard shows it on the Navigation
    view. Verified end-to-end on hardware: ready=1, both pods detected, crc_bad=0.
    Three things the device requires that are easy to get wrong:
    * STOP between the register-pointer write and the read. readRegister() issues a
    repeated start, which the Pinpoint does not answer — the address probe still
    ACKs, so it looks present while every register read fails.
    * 100 kHz, not 400 — it sits behind the 3.3/5 V level shifter.
    * CRC-8 (poly 0x31) on each 4-byte wor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
    [main.cpp]
2026-09-01 fix(dashboard): e-stop re-arm on Operate, PiP touch guard, cache-busted assets
    Three fixes found while driving the robot from a tablet:
    * No way to clear a latched e-stop from the Operate screen — the only RE-ARM
    lived in the diagnostics views. Adds a hold-to-confirm RE-ARM that appears
    only while latched (re-arming re-energizes the contactor, so it is a 1 s hold,
    not a tap) and surfaces the server's refusal reasons rather than failing
    silently.
    * Touching the right stick expanded the rear camera: the PiP had a bare click
    handler that fired for any click reaching it. Now guarded to ignore events
    originating in the control zone.
    * CSS/JS are stamped with a content hash. A deplo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
2026-09-03 feat(tab5): pan/tilt bring-up tool for the 8Servo + ToF head
    Standalone serial tool for characterising the PTZ head, deliberately
    separate from firmware/tab5_face so the face is untouched.
    Bus: Grove Port A -> PaHub -> 8Servo 0x25 (ch4) + VL53L0X 0x29 (ch5).
    8Servo outputs: ch0 = tilt, ch1 = pan.
    Every default is chosen to make motion hard rather than easy, because the
    servo rail is fed from the Grove cable and stalling a torque servo browns
    out the host's USB rail. Channels boot in input mode (no pulse at all),
    EN starts at 1500us (safe in both servo modes), targets are clamped and
    slewed, and rail current is checked at 25 Hz with a configurable cutoff --
    40ms matters, since 200ms of stal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
    [main.cpp]
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2026-09-03 fix(stamplc): always STOP a failed I2C transfer; add bus recovery
    M5Unified's writeRegister() is a short-circuiting && chain, so a failure
    at any step skips endTransaction() and no STOP is ever issued. That leaves
    the slave abandoned mid-transaction -- the 8Servo's STM32F030 latches in
    exactly that state, ACKing its address forever while servicing nothing,
    which turns a single glitched write into a permanent wedge. scanID(), used
    by the 5s presence scan that probes 0x25, has the identical defect.
    servo8Write() now stops on every exit path, mirroring the discipline
    ppXfer() already used for Pinpoint -- which is why Pinpoint survived on the
    same bus while the 8Servo did not. Adds a bit-banged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
    [main.cpp]
2026-09-04 fix(dashboard): don't latch the physical e-stop; log e-stop edges instead
    The supervisor latched BUTTON the same as SOFTWARE, so once the physical
    e-stop was pressed the display stayed at E_STOP_LATCH even after the button
    was twisted back out. Meanwhile the StampPLC auto-arms the contactor on its
    own, so the two diverged permanently after the first e-stop: dashboard
    showing E-STOP LATCH with every subsystem DISABLED while the robot was
    armed, driveable, and being driven.
    A safety indicator that disagrees with the machine is worse than none --
    it teaches operators to disbelieve it.
    E-stop sources are now handled by whether they carry their own
    acknowledgement:
    BUTTON live --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
2026-09-04 feat(tab5): stabilize serial state-sync, flip orientation, and implement wifi/OTA
    Backend: Assert DTR/RTS (True) to fix ESP32-P4 HWCDC driver dropping packets, hold serial port open, and update Tab5 discovery glob.
    Firmware: Flip display rotation, init ESP-Hosted SDIO bridge for ESP32-C6 Wi-Fi, connect to Opendubs2, add ArduinoOTA, and expose Wi-Fi driver status codes on UI.
    Config: Remove hardcoded COM ports from platformio.ini to enable auto-detection.
    [main.cpp]
2026-09-04 feat(access): git-managed per-student SSH access for the robot fleet
    Replaces "one shared opendubs account with passwordless root and a single
    authorized_keys file" with per-person accounts declared in access/manifest.ini
    and applied by tools/access.py.
    The reason this is a manifest and not a GUI: TAs will eventually need to grant
    access, which raises "who may hand out root, and how do we know it was them?"
    GitHub already answers that -- a TA adding a student is authenticated,
    attributed, reviewable as a PR, and revocable by removing their repo access. A
    web tool would have needed all of that built from scratch, and would have
    inherited the dashboard's current lack of any authentication.
    T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
2026-09-04 feat(rc): per-robot RC channel map with guided calibration
    The channel map was eight hardcoded indices, so every new mechanism asked the
    same question again in a new place: which way is CH2 up for the mast, is CH6
    deadman active high (the comment said "polarity TBC"), is strafe reversed.
    Those are one question -- how is this transmitter set up -- and it now has one
    answer, stored on the robot.
    It also removes a class of per-robot value from the repo. Channel assignment
    and reversal depend on the transmitter, not the design, so they belong in NVS
    rather than as constants someone hand-edits after a bring-up -- which is the
    practice that has twice caused repo/robot divergence.
    Modelled on Ard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
    [main.cpp, rc_config.cpp, rc_config.h]
2026-09-04 docs(build): stub the Scissor Lift and Pan/Tilt HMI payload modules
    Provisions both under a new "Payload Modules" nav group, following the module
    recipe: page, BOM-AUTO markers, asset dir and photos.manifest stub. Both pass
    bom.py --check and mkdocs build --strict.
    Each carries a "values discovered per robot" section, because writing them
    made the pattern explicit: relay-to-leg assignment, servo horn indexing,
    travel limits and axis direction are coin flips on every build, wrong half the
    time if copied, and currently tribal knowledge. Marked TODO against the
    firmware-guided procedure so discovery ends up on the robot rather than
    transcribed into source.
    Relay contact type (NO vs NC) is doc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
2026-09-04 feat(tools): Arduino Uno dual-mode servo reprogrammer; record NO contacts
    The goBILDA/REV dual-mode servos switch between positional and continuous
    rotation over a Feetech/Dynamixel-style half-duplex link on the SIGNAL wire, not
    over PWM. This sketch speaks it, so a servo can be reconfigured without the
    goBILDA 3102 programmer.
    Proven on hardware: PING got a valid status packet from ID 1
    (FF FF 01 02 00 FC, error byte 00), then POS switched a pan servo from
    continuous to positional, confirmed by its behaviour afterwards.
    That also settles why the earlier in-firmware attempt from a Tab5 GPIO did
    nothing. Two candidates were on the table -- wrong servo ID, or 3.3 V too weak
    to drive the line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
    [main.cpp, rc_config.cpp]
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2026-09-04 feat(tab5): wire up hardware ToF, UDP telemetry, and IMU offsets (untested)
    - face: integrate VL53L0X I2C init and disable ToF simulation
    - face: pack ToF distance readings into CAN_ToF_Distance struct
    - face: add UDP listener on port 4242 for wireless state telemetry
    - face: load IMU offsets from NVS on boot to persist zero-orientation
    - pantilt: swap kPan and kTilt channel definitions to match physical wiring
    [lift.cpp, lift.h, main.cpp]
2026-09-04 fix(mast): lift bring-up on hardware — relay mapping, atomic writes, pulse timing
    Everything here was found on the robot; the driver as written did not work.
    RELAY MAPPING. Raj wired silk R2/R3, which are code R1/R2 -- silk is 1-indexed,
    code is 0-indexed, and that offset cost a debugging cycle. Bench-discovered by
    pulsing each and watching: silk R3 = UP, silk R2 = DOWN.
    TWO CONSECUTIVE RELAY WRITES DO NOT BOTH LAND. The second is silently lost, so
    whichever leg was pulsed second did nothing -- which presented as "UP works,
    DOWN doesn't", then inverted when the order changed. Each writePlcRelay() is its
    own I2C transaction and this bus drops closely-spaced ones, the same fragility
    behind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
    [main.cpp, mast.cpp, mast.h, rc_config.cpp, telem.h]
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2026-09-05 feat(tab5): implement AI tracking mode and backend control handoff
    This commit completes the transition of the Tab5 payload controller to
    support backend-driven automated tracking.
    - Added an explicit / UI toggle to the HMI controller.
    - Modified the main loop to yield pan/tilt servo control to incoming UDP packets when AI Mode is active.
    - Fixed a bug where the UI would report when only tracking packets were being received (reset link timeout on any valid Thor packet).
    - Added a prototype script to the workspace root that performs OpenCV motion tracking and streams UDP pan/tilt commands.
    - Updated with the current system state and TODOs for integrating the tracker script into the Tho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
    [face.cpp, hmi.cpp, hmi.h, lift.cpp, main.cpp, ui_shared.cpp, ui_shared.h]
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2026-09-08 feat(mast): ToF Z-height, and make the pinch guard actually stop the lift
    Brought up on OpenDubs 2. The guard shipped in the previous commit was never
    exercised on hardware; three descents showed it detecting correctly and failing
    to act, for two separate reasons, both fixed here.
    ToF driver. Vendors Pololu's vl53l1x-arduino (BSD-3, LICENSE kept) essentially
    unmodified — only the bus type changes, because Arduino's Wire is not on the
    StampPLC's external I2C and every device sits behind a PaHub mux. HubI2C presents
    the five TwoWire methods the driver uses over m5::I2C_Class, buffering writes so a
    register write goes out as one transaction and issuing STOP on every path,
    including failure.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
    [VL53L1X.cpp, VL53L1X.h, hub_i2c.h, main.cpp, mast.cpp, mast.h, tof.cpp, tof.h]
2026-09-08 fix(tab5): one owner for the lift, and close the paths around its guard
    Review of feat/tab5-wireless-update. Andrew's work predates the Z-axis pinch
    guard, so most of this is a merge-order problem rather than a mistake — but the
    result was four separate ways to move the lift without the guard seeing it, two
    of them live on the robot right now.
    THE LIFT HAS ONE OWNER. The Tab5 asks, the Thor forwards, the StampPLC acts
    through ScissorRelayMast — the same path the RC sticks use, so the pinch guard,
    the limits and the deadman/authority gate apply to every descent regardless of
    who asked. New `MAST CMD <-1..1>`, heartbeat-gated exactly like `DRIVE`: a caller
    that dies stops the lift.
    Remov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
    [can_protocol.h, hmi.cpp, lift.cpp, lift.h, main.cpp, ui_shared.cpp, ui_shared.h]
2026-09-09 fix(tab5): make the head's lift buttons actually reach the guard, on hardware
    Bring-up of the previous commit on opendubs2. It was written but never exercised;
    three separate breaks stood between a finger on the Tab5 and the lift moving.
    `MAST CMD` was never deployed. It was written and built locally and then left
    there while the work moved on to the Tab5, so the dashboard and the head were
    both posting into a firmware that had no such command. `/api/mast` answering
    {"ok":true} hid it, because the backend only queues the line.
    Its authority gate was wrong anyway. The Thor's Z-axis command required
    autonomous authority — RC switch in AUTO plus a live DRIVE heartbeat — and the
    robot live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
    [can_protocol.h, lift.cpp, lift.h, main.cpp]
2026-09-09 tools: audit what is actually running on a robot against the repo
    There is no deployment mechanism on this fleet — files reach the robots by hand,
    one at a time, usually mid-debug. The repo and the robots drift silently, and the
    drift surfaces as something unrelated breaking later.
    It cost us an hour on 2026-09-08. `platform = espressif32` was pinned to 7.0.1 in
    PR #9 on 2026-09-01, precisely because an unpinned platform resolves forward and
    breaks M5StamPLC against the newer ESP-IDF. opendubs2 never received it, so
    building an unrelated project on the same machine broke the StampPLC firmware
    build outright — the firmware that runs the drive, the e-stop and the lift — for
    reasons that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
2026-09-09 feat(rc): CH7 selects what the right stick means — OFF / Z-AXIS / PAN-TILT
    There are two sticks and three things that want one. The spare 3-position switch
    was provisioned to enable/disable the mast and had never been wired to anything;
    it now arbitrates the right stick, which also fixes what it was provisioned for:
    the lift used to creep whenever the operator only meant to drive.
    OFF right stick vertical does nothing; horizontal still strafes
    Z-AXIS vertical drives the lift; horizontal still strafes
    PAN-TILT vertical tilts, horizontal pans — strafe unavailable
    The left stick never changes meaning, so forward/reverse and rotate work in every
    position and the robot can s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
    [main.cpp, rc_config.cpp, rc_config.h]
2026-09-09 feat(odometry): send the Pinpoint its configuration — we never had
    The Pinpoint driver was read-only. goBILDA's user guide is explicit that the
    device does not keep its configuration: "Device Configurations are lost on device
    power cycles, so your I2C Controller device should send the config information
    over I2C once every time the code starts."
    We have never sent any. The device has been running on defaults — pod offsets of
    zero, whatever tick rate it starts with — and reporting a pose computed from them.
    Nothing looked wrong, because a misconfigured Pinpoint returns smooth, plausible,
    incorrect numbers. That is the whole problem with it: there is no failure to see.
    ppcfg.cpp owns t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
    [main.cpp, ppcfg.cpp, ppcfg.h]
2026-09-09 fix(safety): refuse to drive until the control loop is demonstrably running
    Twice, with the 8Servo working, an operator made legitimate deadman-held inputs
    during boot and the robot moved and could not be stopped for several seconds.
    CAUSE. netMaintain() retried DHCP with a BLOCKING Ethernet.begin(mac, 4000, 1500)
    every 5 s until a lease arrived, so through boot the loop ran roughly one second
    in five. That explains both symptoms at once:
    * "RC keeps dropping out with the transmitter plainly on" — SBUS frames were
    lost during each 4 s stall, so last_valid_frame_ms went stale and the mode
    fell to NOLINK, then recovered on the next running second, then fell again.
    * "it moved a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
    [main.cpp]
2026-09-09 fix(dashboard): a parse error must not be able to fabricate an e-stop
    The face reported E_STOP with the button released and the contactor closed.
    The e-stop was correct: the supervisor saw its telemetry stop and latched on
    STALE TELEMETRY, which is exactly what it should do. The fault was underneath it.
    `_i` is defined INSIDE the [ODO] branch of the parser, and the previous commit
    used it in the [DRIVE] branch. Every [DRIVE] line raised NameError, which aborted
    the remaining lines in that datagram — so [IO], [RC] and the rest never parsed
    either. Every field went None, `fresh` went False, and a one-line typo surfaced
    as a safety state.
    Two fixes, and the second matters more than the firs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
2026-09-09 fix(mast): a hand through the ToF beam must not drive the lift
    REPORTED: breaking the Z-axis ToF beam with a hand triggered Z-axis movement.
    CAUSE, and it is mine. The pinch backstop presses a relay leg when it sees the
    platform falling in the zone. On a pulse-toggle controller a press STARTS a
    stopped lift, so the whole thing rests on "falling" being real evidence of
    motion. A hand through the beam forges it perfectly: the range collapses, the
    height appears to plummet, the backstop concludes runaway and presses DOWN — and
    creates the descent it exists to prevent.
    The comment above that code says, in as many words, that pressing without
    evidence of motion would cause exactly this. I wro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
    [main.cpp, mast.cpp, mast.h, tof.cpp]
2026-09-09 feat: commit the PWM mirror; show what the right stick is driving on the face
    Two things, both about making state visible rather than remembered.
    THE PWM MIRROR moves into the repo, defaulting OFF. It duplicates one ESC's
    pulse onto a spare 8Servo channel driving an indicator light, so the 8Servo's
    ACTUAL PWM OUTPUT is visible during a wedge — it answers what the I2C side
    cannot: when writes start failing, does the 8Servo keep emitting its last pulse
    (timers alive, firmware hung) or stop entirely (no signal, ESC red-faults)?
    It has lived only on opendubs2 for weeks. That made it invisible to anyone
    reading the repo, put it one SD card away from being lost, and — because it
    appends fiel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
    [face.cpp, main.cpp, ui_shared.cpp, ui_shared.h]
2026-09-09 feat(head): the RC stick drives pan/tilt — and so does the D-pad, at last
    CH7's PAN-TILT position selected a mode that actuated nothing. Worse, while
    wiring this up it turned out the Tab5's own on-screen D-pad never worked either:
    handleTouch registered the arrows and set g_activeHold, and no code anywhere
    wrote g_targetPan/g_targetTilt. The AI path was the only thing that had ever
    moved that head. So "manual pan/tilt" has never existed on this robot.
    RATES, NOT ANGLES. The stick is spring-centred — hold to move, release to stop —
    and more importantly the Tab5 OWNS the head's position. Sending absolute angles
    from a second device means two integrators that drift apart, and a head that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
    [can_protocol.h, main.cpp]
2026-09-09 fix: honest stall attribution, and correct the head's servo directions
    The stall message was blaming the wrong phase. It printed g_worstPhase, which is
    the worst EVER seen, not the worst in the iteration that just stalled — so every
    stall reported "sbus 254ms" regardless of what actually overran, and I spent a
    cycle investigating the SBUS drain on that evidence. The instrumentation existed
    precisely to stop that kind of guessing, and it was doing the opposite.
    Now tracked per iteration and reset after the health check reads it. The all-time
    worst is still published for trend, but the stall line reports the iteration.
    With that corrected: the flapping was real but self-inflicted. Every st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
    [main.cpp]
2026-09-09 fix(rc): my SBUS byte cap was starving the loop it was meant to protect
    The drive-safe gate flapped constantly, which gated armOK, which silently
    suppressed every RC pan/tilt packet — so the sticks did nothing and the face kept
    dropping to INIT. The cause was the 256-byte drain cap I added earlier today.
    SBUS delivers ~8.3 kB/s. 256 bytes at 50 Hz is 12.8 kB/s of drain: a 1.5x margin,
    which any latency eats. Once behind, the drain hit the cap on EVERY iteration and
    could never catch up, so the UART ring sat permanently full and iterations ran
    130-250 ms. A cap intended to stop a transient boot backlog monopolising one
    iteration created a permanent deficit instead. 1024 gives ~50 kB/s: nev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
    [main.cpp]
2026-09-09 perf(rc): read SBUS in blocks — per-byte reads cost 370us each
    Measured, after three wrong guesses: single-byte rc.read() cost ~370 MICROSECONDS
    per byte, about 90,000 cycles at 240 MHz, and uniform rather than one slow call
    (worst single byte 1.4 ms across 676). Each read() takes the UART driver's mutex,
    and at this data rate the higher-priority UART event task holds it almost
    continuously, so every byte paid for lock contention.
    400-700 bytes an iteration therefore cost 150-250 ms. That dropped the drive-safe
    gate, which gates armOK, which silently suppressed every RC pan/tilt packet — so
    the sticks did nothing and the face kept falling back to INIT with every other
    indicator healthy.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
    [main.cpp]
2026-09-09 fix(ota): prove the flash landed; stop holding the only spare socket
    Several OTAs today reported success and flashed nothing, and I tested against
    stale firmware for a long stretch believing otherwise. Three faults, compounding.
    MAX_SOCK_NUM IS 2. The Ethernet library is built with two sockets: eth_udp holds
    one, so the dedicated head socket I added earlier — to fix a loop stall caused by
    sending on the receive socket — took the last one the first time an operator
    aimed the stick. From then on the OTA's HTTP client could not open at all. Each
    attempt still reached the board, which dutifully dropped R0 and latched its
    e-stop before discovering it could not fetch, so the drive bus went do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
    [main.cpp]
2026-09-09 fix(head): the rate frame was missing from the dispatcher whitelist
    headtx=553 with the head never moving: the StampPLC was transmitting at 20 Hz,
    socket open, no stalls, every gate satisfied — and the Tab5 discarded all of it.
    The text-vs-binary dispatcher decides a packet is a CAN frame only if its id is
    one it knows. CAN_ID_PAN_TILT_RATE was introduced after that list was written and
    never added, so every rate frame failed the test, fell through to the text
    parser, and was dropped without a word.
    Adding the id is the fix. The comment now says plainly that every id handled
    below must appear in the list, because the failure mode is silent by
    construction — a whitelist that quietly dis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
    [main.cpp]
2026-09-10 fix(relays): scrub the S8RESET/R1 allocation, and say Z-axis everywhere
    Relay R1 was documented in several places as gating the 8Servo's 5 V feed so
    software could power-cycle it. That rewire was never agreed to and never done.
    R1 is the scissor lift's DOWN leg and R2 is its UP leg, so a stale label on a
    relay that presses a lift button is a safety-doc defect, not cosmetic.
    Removed:
    - the `S8RESET` host command, still compiled into the StampPLC as a disabled
    stub, plus its dead `s8cycle_ms` and the two mode-cache comments that cited
    an "8Servo power-cycle" as a reason to re-assert pin modes
    - `S8RESET` from the firmware README's host-command list
    - `RELAY_8SERVO`, an unused constant sit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
    [main.cpp]
2026-09-11 WIP: Integrate YOLO face tracker (Tab5 failing to actuate)
    - Added *.pt to .gitignore to prevent committing PyTorch model weights.
    - Introduced yolo_tracker.py to offload face detection to the Thor backend.
    - Updated requirements.txt with YOLOv8/tracking dependencies.
    - Added systemd service (opendubs-yolo-tracker.service) and updated deployment/provisioning scripts to support the new tracker.
    - Current blocker: The tracker successfully initializes, connects, and sends UDP pan/tilt commands to the Tab5 (10.42.2.200:4242), but the robot is currently ignoring the commands or failing to move its servos in response.
2026-09-11 Deployed to Thor (untested)...Note: as noted in the tab5_pantilt/README.md, the Tab5 uses an SC2356 MIPI-CSI camera, and there is no Arduino driver for this sensor. The #if HAS_CAMERA block in the fi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
2026-09-13 docs: first pass on the documentation review — wording, stale blocks, wrong captions
    Bucket A of the documentation review: changes that need no hardware and no open
    decision. Source notes and the tracked triage live in the gitignored
    notes/drafts/ (docs-review-notes.md, docs-review-checklist.md).
    Home
    - "Start here" -> "Start Here"
    - removed the "Current baseline (2026-08)" card and the Status section; both were
    stale by construction, with nothing to keep them current
    System overview
    - dropped Purpose, which only restated the page title
    - "Embedded control edge: M5StampPLC" was word salad -> the mobile-base low-level
    controller, and explicitly one of several on the robot, since each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
2026-09-13 ci(docs): validate on pull requests, not only after the merge
    The docs workflow triggered on `push: branches: [main]` alone, so `bom.py --check` and
    `mkdocs build --strict` never ran on a pull request. A broken link or a stale BOM table
    was found by a red deploy on the branch that publishes the public Pages site — after the
    merge, not before it. PR #7 is a live example: it adds four links that escape docs/, which
    aborts the strict build, and nothing in review would have said so.
    - Added a `pull_request` trigger with the same paths filter as the push trigger.
    - Split validation from publication: the `build` job now runs on both events, while
    `deploy` is gated on `github.event_name != 'pu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
2026-09-21 fix(dashboard): a missing Tab5 no longer makes the PRISM trail the mode rocker by 15 s
    The PRISM color and the Tab5's state are pushed from the same loop in state_out.py, which
    is meant to run every 0.3 s. Every write to the Tab5 resolved `opendubs-tab5.local` over
    mDNS, and with the head offline each lookup fails after 5.01 s (measured on opendubs2).
    Failures weren't remembered — the code cleared the address "to force a re-resolve next
    time" — so every write paid the 5 s again. `_introduce_peers` did the same, and on failure
    reset its timer to zero, so it retried on every pass. Net effect: the loop ran every
    10-15 s, the PRISM followed the rocker that slowly, and fast toggles were misse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
2026-09-21 fix(pinpoint): stop re-zeroing the IMU mid-drive on a single glitched read
    Symptom (opendubs2, 2026-09-21): with the robot parked and the pod counts steady, the tablet
    showed heading, x, y and velocity all changing. Heading turned at -0.27, then -1.3, then
    -0.95 rad/s; position moved at 107-636 mm/s.
    Cause, from the running code and the log:
    - pinpointPoll() set pp_present=false on ANY failed read — a single glitch on the bus.
    - The next good read looked like a re-appearance, and ppCfgTick() assumed a reboot and
    re-applied config with ResetPosAndImu. That re-measures the gyro zero, which the goBILDA
    guide says needs the robot STATIONARY; the code's own comment said "At boot it is". It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
    [main.cpp, ppcfg.cpp, ppcfg.h]
2026-09-21 fix(dashboard): wrap the Pinpoint heading to ±180° for display
    The Pinpoint's heading register is continuous — it counts whole turns — and nothing wrapped it
    on the way to the tablet: firmware prints it raw, stamplc.py passes heading_rad through, and
    app.js showed heading_rad × 180/π. Any rotation past a full turn read as >360°; with the gyro
    drift fixed in the previous commit it had reached -715.6 rad, about -41,000°.
    Wrap only for display, to (-180, 180] — the convention app.js already uses for another angle.
    Telemetry stays continuous, since that is what anything fusing odometry wants; the raw radians
    readout beside it is left unwrapped for the same reason.
    Deployed to opend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
2026-09-21 build(stamplc): pin M5GFX/M5Unified by git tag and list them before M5StamPLC
    The repo's StampPLC config cannot build on a clean machine; the robot only builds because
    its copy was fixed in place and never brought back. Found by tools/deploy-audit.py, where
    platformio.ini had drifted the wrong way round — robot correct, repo stale.
    Two defects in the repo's lib_deps:
    1. `m5stack/M5GFX@0.2.21` does not resolve. M5Stack withdrew that build from the PlatformIO
    registry, which now lists only 0.2.27-0.2.29 in the 0.2.x line (checked 2026-09-21).
    M5Unified 0.2.15 IS still listed; the robot's comment said both had been pulled, which is
    corrected here.
    2. M5StamPLC was listed FIRST. Its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
2026-09-22 feat(openarm): host provisioning for the arms, and the openarm-up command
    Running two OpenArm arms from the Thor needed hand steps after every reboot: the Jetson kernel
    ships without the PEAK USB-CAN driver, the adapter's channels came up as canN numbers that shift
    with the loadable on-board CAN driver, and the links had to be raised by hand.
    software/openarm/ now provides:
    - provision-openarm.sh: builds peak_usb (unmodified upstream source for the running kernel)
    as a DKMS module, installs the link service and commands, and installs the default channel
    names only if the robot has none (the left/right mapping is per-robot wiring)
    - 70-openarm-can.rules + openarm-can@.service: channel 0/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
2026-09-22 fix(dashboard): an idle Tab5 no longer holds the Z-axis at STOP
    The head publishes its lift request every 50 ms, STOP included, and the dashboard forwarded
    every frame as MAST CMD. The StampPLC keeps only the latest MAST CMD, so while the head was
    online it was a second, permanent Z-axis commander saying STOP 20 times a second. Any other
    Thor-side sender, the dashboard's own Z-axis buttons included, had its UP or DOWN interleaved
    with those STOPs, and because the lift is driven by pulse-toggled relays every flip of intent
    fires a pulse.
    Now UP and DOWN are forwarded on every frame as before (that is the heartbeat), and STOP is
    forwarded once, on release. The stop path is unchanged in effect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
2026-09-22 fix(dashboard): a faulted Pinpoint no longer 500s the whole snapshot API
    The Pinpoint reports nan for pose and velocity while it is faulted (ok=0) and the firmware
    prints that as "-nan" in its [ODO] line. The parser turned it into a Python float nan,
    json.dumps refuses NaN, and /api/snapshot answered 500 — every poll. One optional sensor
    faulting took the entire dashboard API down with it; /api/stamplc kept working, which is
    why telemetry looked alive while the UI had nothing.
    Non-finite values now parse as None, the same as a missing field.
    Seen on opendubs2: [ODO] ok=0 st=0x01 ... x=-nan y=-nan h=-nan vx=-nan vy=-nan vh=-nan,
    fail counter climbing. The Pinpoint fault itself is separate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
2026-09-22 fix(tof): an invalid range sample must never become the lift height
    The plausibility gate only ever examined samples the sensor called VALID. A sample with any
    other status fell straight past it and was still stored as the current distance, and
    tofHeightMm() kept serving it for up to kStaleMs, because its only freshness test is how long
    ago the last VALID sample arrived.
    So one error reading of 65535 became a height of 65535 - zero. Seen in service on opendubs2:
    13 [DRIVE] lines reporting h=64260 mm, a lift 64 metres up. The pinch guard reads that as
    "nowhere near the bottom", which is the direction that permits a descent rather than blocking
    one.
    Now a non-valid sample is counted as an er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
    [tof.cpp]
2026-09-22 fix(dashboard): never open the head's serial port (it holds the Tab5 in reset)
    _find_device() took the first /dev/serial/by-id/*Espressif* match. The Tab5 head is an
    Espressif USB-JTAG device too, so plugging the head into the Thor to flash it handed its port
    straight to the dashboard, which opens it with DTR/RTS asserted — and on that chip those lines
    drive reset and boot mode. The head then sits in reset: dark screen, no Wi-Fi, no chirp, and a
    flash that fights whoever is running it.
    Cost us an afternoon today. The head was dark and presumed broken; the firmware on it was
    fine. It is also a good candidate for the "Tab5 goes flaky when cabled" reports.
    Now: OPENDUBS_STAMPLC_DEV still wi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
2026-09-22 feat(tab5): audio out, OTA by HTTP pull, and a 16MB partition table
    AUDIO. The head can now make a noise: BEEP <hz> <ms>, CHIME, VOL <0-255>, over the same UDP
    text channel as STATE. The speaker starts LATE — from the network task, after WiFi is up —
    and never from setup(): a first attempt that started it right after M5.begin() left the Tab5
    dark, no display and no WiFi, recoverable only with a cable. The state it reaches is shown on
    the face next to the IP (spk:init / spk:ok / spk:FAIL) and every command checks it, so a dead
    codec is visible and harmless instead of silent and fatal.
    It also raises the audio amplifier by hand: M5GFX's Tab5 init configures IO3 (AUDIO_EN) on the
    0x4F expa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
    [main.cpp]
2026-09-22 fix(tab5): audio survives a soft reboot — raise the amp, and don't let OTA hang
    TWO BUGS, both found on the robot.
    1. AUDIO WAS SILENT AFTER ANY SOFTWARE REBOOT. Sound worked after a power cycle and never
    after an OTA, while M5.Speaker.begin() reported success and the face read spk:ok both times.
    The codec was never the problem: M5Unified raises the speaker amplifier (PI4IO1 0x43, reg
    0x05, bit 1) only from its enable callback, and that does not happen in the state a warm boot
    leaves things in — so a healthy codec played into a muted amp. We now assert that pin
    ourselves after begin(). (An earlier attempt aimed at 0x4F/IO3, the AUDIO_EN pin named in
    M5GFX's display init: the wrong expan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
    [main.cpp]
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2026-09-23 feat(sim): scaffold the simulation model — datums, dimensions, and what CAD still owes us
    Sets up the sim work without inventing a single number. dimensions.yaml records what we know
    with provenance and leaves TODO where we do not; sim/README.md says what each simulator is for
    and, more importantly, what it cannot answer.
    The point of this, beyond previewing shows without the robot: SELF-COLLISION CHECKING, which
    nothing in the real stack has. cue.py currently refuses a shoulder above 157 deg because I
    measured contact with the head at 182 by hand, once, on one axis. Eric's controller will not
    stop it either — its only Cartesian guard is a 1.2 m box, and the arm reaches the head well
    in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
    [dimensions.yaml]
2026-09-23 feat(sim): a MuJoCo model of the chassis and Z-axis, in the CAD frame
    Builds on the supplied meshes (chassis, four wheels, the lift plate) and the three offsets that
    place the arms. Loads and steps in MuJoCo; the rendered preview at both lift extremes looks
    right.
    THE CAD ORIGIN IS THE DATUM. No second frame was invented for the simulator: every offset in
    the model is the real spatial relationship, which is what keeps sim and CAD from drifting apart.
    Derived rather than assumed:
    * the FLOOR is at z = -94 mm — the wheel meshes are 140 mm across with centres at z = -24,
    so that is where the contact patch lands
    * wheelbase 408 mm, track 589 mm, chassis top 356 mm, lift plate top fac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
    [FL-wheel.stl, FR-wheel.stl, RL-wheel.stl, RR-wheel.stl, chassis.stl, z-axis-down.stl]
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2026-09-23 feat(sim): attach the arms, at 423 mm, with the chest cover suppressed
    scene.py composes the robot: our chassis and Z-axis, with the OpenArm bimanual model attached
    to the lift platform. Uses MuJoCo's MjSpec, so neither file is edited or copied and an upstream
    asset update arrives for free. The assets are found by flag, env var, or the paths the arm
    software's own setup.sh uses — not vendored here: ~50 MB belonging to another project, and a
    stale copy of someone else's robot is a trap.
    THE ARM MOUNT IS 423, NOT 453. Confirmed by eye on a render: the arms sat 30 mm too far
    forward. The 453 came from reading "423 to the centre of the root body" and correcting by that
    body's 30 mm mesh offse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
    [dimensions.yaml]
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2026-09-23 fix(sim): the face was exported upside down — turn it over, and box the camera in
    The face meshes arrive a half turn about x from CAD: as authored the D415 hangs
    below the screen. quat="0 1 0 0" puts the camera back on top; x is preserved, so
    the screen still faces forward. Measured extents about the tilt axis are now
    recorded in dimensions.yaml rather than left to be re-derived.
    The collision box grew to cover the camera too (z -78.8..56.5 instead of stopping
    at 27). The arms have to know the D415 is up there; a head box that ends below it
    would let a shoulder sweep straight through the one sensor on the robot.
    head_pan needed an explicit inertial: removing the channel left it a moving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
    [dimensions.yaml]
2026-09-23 feat(sim): the head, in CAD coordinates — and it faces the wrong way
    pt_tilt_body, pt_screen_cover and D415 replace the old face set. They carry
    absolute CAD positions, so each geom simply cancels the head frame's offset and
    every vertex lands where CAD put it. One transform, no second origin, nothing to
    re-derive — which is what made the old placement guesswork.
    That also retires my earlier half-turn about x. The new files are a rigid 180 deg
    YAW of the old ones: every extent maps through x -> 449-x, y -> 1.85-y,
    z -> z+1216.78, exact to the hundredth of a millimetre. The old D415 Mount was
    simply exported flipped relative to the rest, which is what made the assembly look
    upside down a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
    [D415.stl, D415_Mount.stl, Tab_5_Mount.stl, face_screen_cover.stl, pt_screen_cover.stl, pt_tilt_body.stl]
2026-09-23 feat(sim): the head faces forward, on the centreline — and a viewer you can turn
    Confirmed against the robot: the head faces forward, so the export's pan=180 pose
    is an artefact and gets corrected, along with the 1.85 mm y offset. Both fold into
    the one transform that already places each mesh, so there is still a single
    transform per part and no second origin. Placed, the screen spans x 460.0..482.8
    and y -79..79, the camera x 461.6..481.6 on top — ahead of the tilt axis, square on
    the centreline.
    --head-yaw is gone with it. It existed to keep an open question visible; the
    question is answered.
    view.sh opens the interactive viewer. Two macOS traps recorded there rather than
    rediscovere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
    [dimensions.yaml]
2026-09-23 fix(sim): the viewer runs under plain python, not mjpython
    mjpython is broken on this machine. It starts — viewer._MJPYTHON is set, so the
    trampoline and the app bundle both work — but constructing the viewer then throws
    "Caught an unknown exception!". I checked it against 3.14.0 and 3.3.5, a model
    that is a single sphere, and three different shells: same failure every time. So
    the version pin in the previous commit was wrong, and so was my reading of the
    3.3.5 test — I killed it before it got far enough to fail.
    Plain python works because this is the BLOCKING viewer, which wants the main
    thread and, run this way, has it. mjpython exists for launch_passive, where a
    script keeps runnin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
2026-09-23 fix(sim): head tilt is asymmetric — 87.5 up, 14.7 down, not +/-68.8
    The joint carried a +/-1.2 rad placeholder I never replaced, which let the viewer
    pitch the head 69 degrees down. The real travel had already been measured and
    written up in firmware/tab5_pantilt/README.md: the servo was crept in small steps
    watching current, soft-stopping at 0.20 A so it never stalled.
    920 us full up | 1545 us HORIZONTAL | 1650 us full down | hard stop 1680 us
    7.14 us/deg -> 87.5 deg up, 14.7 deg down, hard stop 18.9 deg down
    So the placeholder was wrong in both directions at once: it forbade 19 degrees of
    real upward travel and invented 54 degrees of downward travel that ends at a
    mechanical stop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
    [dimensions.yaml]
2026-09-23 fix(sim): pan is the servo's own 300 deg, and that corrects tilt too
    Pan has no mechanical limit on this build — no stop in the bracket, no slip ring —
    so the only limit is the servo's travel, with the horn set at the middle of it:
    +/-150 deg. Left deliberately wide. Whether the head can sweep that far without
    meeting the arms or the extrusion is the question the model exists to answer, and
    narrowing the joint would answer it by assumption instead.
    The same fact corrects the tilt limits committed an hour ago. goBILDA specify 300
    deg of travel for the 2000-series dual-mode servo, so 500-2500 us is 6.667 us/deg,
    not the 7.14 that firmware/tab5_pantilt/README.md used from an assumed 280. T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
    [dimensions.yaml]
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2026-09-23 fix(sim): say plainly that the dynamics are placeholders, and stop the lift flying
    Three things you found, and one banner they add up to.
    THE BANNER. The geometry is real and the dynamics are not, and the model did not
    say so anywhere. Lengths, axes and pivots trace to CAD or a measurement; masses,
    inertias, stiffnesses, damping and speeds do not. The chassis mass is a guess, the
    head's is mesh volume at the density of water, the arm masses are someone else's,
    and the lift's numbers were picked to look right. That now leads the XML, the
    README and dimensions.yaml, because a model that answers clearance questions well
    will be asked force questions eventually.
    THE LIFT could throw the robot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
    [dimensions.yaml]
2026-09-23 feat(sim): clearance.py — the question the model was built to answer
    software/choreo/cue.py refuses a shoulder above 157 degrees because contact with
    the head was measured by hand, once, on one axis, with a human watching. Nothing in
    the arm controller would stop it either: its only Cartesian guard is a 1.2 m box
    that the offending pose satisfies comfortably. This answers the same question with
    geometry — minimum distance between any two parts, for any pose.
    It also CHECKS the hand measurement, which is the more interesting result. Contact
    was felt at J2 182. The model reaches zero at 188.3, identically for both arms, and
    barely moves with elbow fold: 187.5 at J4=60, 188.3 at J4=140. Th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
2026-09-23 docs(sim): this is the robot description, not a planner's model
    Emma's framing, and it is the right one: the geometry here, and the platform's own
    dynamics, are independent of whoever moves the robot. Several planners are likely
    over this robot's life and they will disagree with each other. Anything that would
    have to be rewritten per planner does not belong in sim/.
    Recorded with it: mj_manipulator moves the ARMS AND GRIPPERS AND NOTHING ELSE. The
    lift, head, base, sound, face and lights are ours under any planner, which makes a
    planner a part rather than the whole. A full-body planner is roadmap, and will
    consume this same description.
    Two corrections to my own overclaiming:
    clearance.p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
2026-09-23 docs: render mermaid, and draw where a command actually goes
    Material ships the renderer and pymdownx.superfences was already enabled, so this
    is one custom fence. Verified: the block builds as <pre class="mermaid">, not a
    highlighted listing, and mkdocs build --strict passes.
    The diagram goes INTO the command & telemetry interface page rather than beside it,
    because that page already claimed something stronger than the wiring delivers —
    "any source produces drive / actuator commands, they pass the StampPLC arm +
    failsafe gate". Drive and lift do. The arms and the front panel do not: the
    contactor gates the drive bus only, the arms are not on it, and the onboard
    computer forms and sends t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
2026-09-23 docs: refresh the README, and point at sim/
    The layout table had drifted past several merges. Missing entirely: sim/,
    software/choreo/, software/openarm/, the pan-tilt bring-up firmware, and access/.
    hardware/ still advertised a bom/ directory; parts.csv has been the BOM source of
    truth for a while, and every table in the docs is generated from it.
    The hardware summary was stale in a more visible way — it described a mobile base
    with a face and no arms. Added the bimanual OpenArm and the lift it rides on, the
    head servos and speaker on the front panel, and the sensing.
    New Simulation section, because sim/ had no route in from the front page. It says
    what the model is for and, more import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
2026-09-23 fix(sim): the chassis notch was an artefact, and the head's 1.85 mm is real
    Three corrections from Emma, two of which reverse things I had recorded as settled.
    THE CHASSIS NOTCH is not geometry. chassis.stl was a bounding shape whose extrude
    left an 8 mm step at two diagonally opposite corners. I had written it up as
    supplied geometry worth knowing about; it was a mistake in the export. The chassis
    is now a box primitive stating the same volume exactly, which also drops a file
    that only ever described a box, and MuJoCo was filling the notch back in anyway
    because mesh collision uses the convex hull.
    THE 1.85 mm Y OFFSET IS REAL. The pan axis is on the centreline; the parts around
    it are no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
    [chassis.stl]
2026-09-26 Tune AI tracker performance, fix startup typo, and update manual handover logic
    - Tuned YOLO tracker PID/smoothing variables for faster and smoother face tracking (slew rate at 37.5 deg/sec).
    - Fixed a typo in the tracker's CLI arguments inside `app.py` that was causing a startup crash.
    - Increased the stationary jitter deadzone and alpha smoothing filter in `yolo_tracker.py` to prevent camera oscillation when the user is sitting still.
    - Removed unused files and added `.pio_env/` to `.gitignore`.
    - Adjusted manual handover logic in `yolo_tracker.py` to explicitly yield telemetry to the StampPLC when the manual controller is active.
    Note on manual override behavior (STICK: HEAD mode):
    When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
    [can_protocol.h, main.cpp]
2026-09-28 fix(mast): the pinch guard's consent had a 1.4 s window nobody was told about
    THE BUG BEHIND "a just-right flick of the stick is required to go fully down".
    One flag meant two things. pinchHold_ was both "I am refusing right now" -- an
    announcement, correctly cleared kHoldShowMs (2 s) after the operator stops asking
    DOWN -- and "I am latched awaiting consent", which must persist until consent is
    given or the platform leaves the zone. Consent tested the announcement. So a
    release longer than 2 s cleared the very flag the gesture was checked against, and
    the re-command was refused: the operator had to release for longer than the 600 ms
    dwell AND shorter than the 2 s announcement, a 1.4 s wind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
    [main.cpp, mast.cpp, mast.h, prompt.cpp]
2026-09-28 fix(mast): the pinch zone latched at the bottom, and the tones were unusable
    Two follow-ups from testing the guard on the robot.
    THE ZONE COULD NOT BE LEFT. The band's bottom edge was 18 mm with the shared
    10 mm hysteresis, so exit needed h < 8 -- below where the platform actually
    rests (9-15 mm). Once the zone was entered on the way down it was never left,
    and the banner stayed up against the bottom limit however hard the stick was
    leaned on. Telemetry made it plain: zone=1 and zone=0 at the same 10 mm,
    depending only on which side it had arrived from.
    The floor is now 22 mm with its own 4 mm hysteresis, so exit is at 18 -- above
    the resting height. Note the sensor offset: fully down read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
    [mast.cpp, mast.h, prompt.cpp]
2026-09-28 firmware(tab5): drop the Tab5 camera experiment, keep the tracker feedback
    The Tab5's own camera never worked. It is an SC2356 on MIPI-CSI with no
    Arduino driver, and the workaround — building Arduino as an ESP-IDF
    component so the V4L2 path was available — is what dragged in
    `framework = arduino, espidf`, both CMakeLists, `sdkconfig.defaults`, and
    the `espressif/m5stack_tab5` BSP in place of the plain `idf: '>=5.1'`.
    That build does not compile. `framework-arduinoespressif32` 3.3.11 ships an
    `ESP_Video` Arduino library calling `esp_video_init_with_flags` and
    `ESP_VIDEO_INIT_FLAGS_*`, which the `espressif/esp_video` component pulled in
    by the BSP does not define. `lib_ignore = ESP_Video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
    [main.cpp]
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2026-09-29 notes: triage the capability backlog against what the robot actually is
    Last touched 2026-06-08, and describing a robot that has moved on.
    **Removed the "Open design questions" section entirely.** It was marked
    *resolved*, and what it resolved was the abandoned multi-small-battery concept:
    source-OR by highest-voltage-wins through a Victron Argo diode combiner, plus a
    shore-power rail. None of that is baseline — the robot has one 52 V pack with an
    RS-485 BMS. The section also still placed "logic (Thor/StampLC/Pixhawk)" on a
    mini-PDH and pointed at `power-architecture.md`, which is archived.
    **§3 router is fielded, not backlog.** A MikroTik hAP ac3 on RouterOS at
    192.168.88.1 with UW-MPS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
2026-09-29 docs: rule bucket B — distribution, I²C hub, and the philosophy page
    **B1 — recommend the fuse block, and be honest about the one that is fitted.**
    The drive bus is 24 V; the REV PDH is built for the 12 V FRC ecosystem, so a new
    build should not repeat it. But this robot has one installed, it distributes
    power, and it is not being pulled out — so the docs say that plainly, including
    that whether 24 V has degraded it is unknown. Previously `power-bay.md` said "we
    use the REV PDH because we already owned it" and called a fuse block merely
    "perfectly acceptable", which reads as an endorsement of the wrong part.
    `parts.csv` notes carry the recommendation and the tables were regenerated.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
    [parts.csv]
2026-09-29 docs: introduce each edge controller once, then call it by name
    Neither controller reduces to a single role, so a repeated role label carries no
    information. The StampPLC is an edge controller *and* the RC receiver, the e-stop
    moderator and the source of every ESC command. The Tab5 is an edge controller
    *and* the front control panel, the human–robot interface and the pan/tilt
    controller. The pattern is therefore: introduce the device once with what it
    actually does, then use its name.
    **The Tab5 was missing from `system-overview.md` entirely** — the Responsibility
    split listed only the Thor and the StampPLC, so the board that owns the face, the
    head servos, the lift's ToF and the sound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
    [parts.csv]
2026-09-29 all: spell it StamPLC, the way M5Stack does
    Three spellings were in use for one board: **StampPLC** (365 places), **StampLC**
    (a third form, in `software/` and `notes/`), and **StamPLC** — which is the only
    correct one. M5Stack's product page is `docs.m5stack.com/en/core/stamplc`, its
    library is `M5StamPLC`, and its classes are `M5StamPLC_IO` and `M5StamPLC_AC`.
    A replicator searching for the part types what the vendor page says.
    384 occurrences across 77 tracked files. Deliberately out of scope:
    - **`notes/history/`** — archived docs are preserved as written, banners and all.
    - **`.pio/libdeps/M5StamPLC/`** — vendored library, untracked, and already right.
    - **lowercase `stamplc`**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
    [parts.csv]
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2026-09-29 docs: the robot has no local display — the kiosk is retired
    B4 asked to confirm the on-robot touchscreen was off the BOM. It is, and the
    question inverts: an Android tablet is the only operator UI, it is functionally
    equivalent, and retiring the panel frees a USB port.
    Corrected two claims that assumed a panel:
    - `design-philosophy.md` listed "on-robot touchscreen" as one of the control
    sources speaking the command contract. There is no such source; it is the
    operator's tablet over WiFi.
    - `camera-selection.md` budgeted USB bandwidth for a touch panel and attributed
    USB instability to it. That port is free and that instability went with the
    panel — which matters, because USB to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
2026-09-29 docs: write the payload contract
    `interfaces/power-data.md` already called itself "the contract a payload builds
    to", and the contract was two lines: stay in budget, use a standard connector.
    That is not a contract anyone could build against. It is six rules now.
    Take power from the **drive** bus — it de-energizes with the e-stop, and that is
    the point. Isolate galvanically, because the M5 I²C bus is 5 V and un-isolated,
    grounds are shared across the frame, and a payload is the one part of the robot
    its builder did not design. Be self-contained, since the base may be busy or
    rebooting exactly when it matters. **Fail safe when the power vanishes** — an
    e-stop is a power cut, not a messa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
2026-09-29 ros: name topics by function, and give ROS a guarded lift path
    **The find.** `/stamplc/relay2` was a ROS service writing the scissor lift's UP
    leg. The backend refuses channels 1 and 2 with a 409 — deliberately, because a
    direct relay write bypasses the mast driver and with it the pinch guard, the limit
    detection and the authority/deadman gate. So the service was permanently broken
    while advertising lift control, and **ROS had no safe way to move the lift at
    all**. It is now `/zaxis/{up,down,stop}` through `MAST CMD`, the same driver the RC
    sticks feed, whose intent the firmware expires after 250 ms so a caller that dies
    stops the lift. `/robot/aux_relay` keeps relay 3, the only free chann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
2026-09-30 docs: stub operating instructions, starting with the charging rule
    There was no operator page at all — how to power the robot on, what makes it
    move, and how to charge it lived in people's heads.
    **The charging rule is the reason to write this now.** BATTERY on and RUN off is
    the only correct combination. BATTERY off with RUN on points the charger straight
    at the logic bus through the logic converter, with no pack in the path: a charger
    is not a bench supply, so it pulses and the electronics brown out and cycle. The
    punch list had recorded that exact hazard in 2026-08 as the reason the logic leg
    needs its own hard break — the break is now the RUN button, so items (1) and (2)
    of that ope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
2026-09-30 docs(operating): correct the charging rule, and the locations
    **The charging rule was wrong.** I had written it as a combination — BATTERY on
    *and* RUN off. Only the first half is a requirement. Charging with RUN on is fine,
    and the charger-present interlock inhibits drive while it is connected. The single
    failure case is BATTERY **off** with RUN on, where the charger's output reaches the
    logic bus through the logic converter with no pack in the circuit: a
    current-limited constant-voltage source cannot regulate against that load, so its
    output pulses and the electronics cycle.
    Charger and settings recorded: 48 V, any current setting will charge, 8 A
    recommended, time depends on depletion.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
2026-10-01 feat(comms): the payload protocol spec and its encode/decode core
    Taken from PR #7 (Module Comms). This is the self-contained half: the
    specification, the framework-free encode/decode core, and its host test. The
    firmware integration in that PR is not included — see the tracking issue.
    `firmware/comms/opendubs_can.h` is a structured 11-bit CAN ID — `[10:7]` module,
    `[6:0]` message type — with `makeId()`, fixed structs per message type rather than
    TLV, and timing constants that say where they come from: AUTHORIZE at 20 Hz with a
    250 ms safety-derived timeout, lift state at 10 Hz with a rate-derived 300 ms. It
    includes only `<cstdint>` and `<cstring>`, so it compiles for the host and fo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
    [opendubs_can.h, opendubs_can_udp.h]
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2026-10-01 fix(dashboard): mast= carries a type prefix, and expose the lift subsystem
    Two bugs in yesterday's lift work, both found by reading the robot's live
    telemetry rather than the firmware's source.
    **`mast=` is `<type>:<motion>`.** The firmware prints `mast=%s:%d`, so the real
    field is `mast=scissor:0` — the Z-axis type and what it is doing. The derived
    mapping looked it up as `"0"`, so `motion` was `None` on every real robot while
    passing every test written from the format I assumed. It strips the prefix now.
    **`_lift()` was never exposed.** It fed `_robot_state()` but was not in
    `collect()`, so no API consumer could see it: `/api/snapshot`'s `status.lift` came
    back empty.
    Two regression t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
2026-10-01 fix: the StamPLC flash needs no IP, and a dead link cannot report success
    Three fixes for one morning's worth of avoidable time.
    **1 · The flash finds the board.** `ota-from-thor.sh` took an IP and defaulted to
    one robot's address. Now it resolves in order — argument, `$OPENDUBS_STAMP_IP`, the
    dashboard's learned peer, then `opendubs-stamplc.local` — prints what it found, and
    **refuses an address belonging to the Thor itself**, which is the specific trap that
    cost the time: the dashboard reported the StamPLC at 192.168.55.1, the Thor's own
    DOWN `l4tbr0`. Verified end to end on the robot with no argument.
    **2 · The stale peer is cleared.** `_run_udp`'s `finally` reset `_connected` and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
    [prompt.cpp]
2026-10-01 feat(yolo): the tracker has a unit file, and its weights survive a reboot
    The only thing stopping the face tracker on the robot was a missing systemd unit.
    Verified rather than assumed: `yolo_tracker.py` was deployed, the venv already had
    pyrealsense2 2.58.4 / ultralytics 8.4.163 / torch 2.14.0+cu130 / cv2 5.0.0, the
    camera was present and nothing held it, and `--show` was already honoured so it runs
    headless. `systemctl is-enabled opendubs-yolo-tracker` said `not-found`.
    It is in the repo now and `provision.sh` installs and enables it. That matters
    because an older revision of that same script **deleted this unit on every run**,
    so provisioning silently removed a working demo and nothing i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
2026-10-01 fix(yolo): unbuffered output, so the tracker's log answers 'is it seeing anything'
    Without PYTHONUNBUFFERED the script's prints sit in Python's buffer and
    `journalctl` shows only the unit's own start line. With it, the log immediately
    answered the question that mattered on the robot:
    ✅ NVIDIA GPU Detected! YOLO will run on GPU.
    Processed 30 frames. Found face? Yes. Is manual? True
    — detection, GPU, camera and UDP all working, and the head not moving because the
    Tab5 reports a human owns it (`is_manual = (ui_mode == 1) or (tracking == 0)`,
    yolo_tracker.py:225). That is an operator state, not a fault, and it would have been
    invisible without logs.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
2026-10-01 feat(stamplc): the contactor arms itself at boot, and says why when it will not
    Every StamPLC restart left the robot with no motion power and no indication —
    three flashes today meant three manual dashboard re-arms, and a restart mid-demo
    would have silently killed the drive bus. The firmware never closed R0: all four of
    its own writes were `false`, and the only close path was a host command.
    **It keeps checking rather than deciding once.** Powering on with CH5 in MANUAL is
    not a stuck state: it waits, and arms the moment authority reaches OFF.
    **It says why.** A fast amber PRISM strobe (160 ms, against the white 700 ms "not
    ready" breath) while it refuses, plus `[SAFE] not arming: <reas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
    [main.cpp]
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2026-10-01 fix(dashboard): the AI TRACKING button drives systemd, not a subprocess
    Andrew reported the button "doesn't work". The endpoint existed; what it did was
    wrong in three ways and silent about all of them.
    It `subprocess.Popen`'d `yolo_tracker.py` from inside the backend with the Tab5's
    address hardcoded as `10.42.2.14`. So: a second copy fought the systemd service for
    the camera and lost, because a RealSense admits exactly one client; the hardcoded IP
    broke whenever DHCP moved the head; and a tracker started by systemd at boot was
    invisible to the button, which would cheerfully launch a rival.
    There was also a shutdown hook that killed the tracker whenever the backend
    restarted. Restarting t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
2026-10-01 fix(dashboard): the AI button's label is driven by the websocket, not the snapshot
    My previous fix was incomplete, and the symptom was unchanged: the button still
    appeared to do nothing.
    The POST worked and the service started — but the dashboard is driven by the
    **websocket**, and I refreshed `ai_tracking` only in the `/api/snapshot` handler.
    `renderServerState()` reads `d.state` off the socket, which kept sending a stale
    flag, so the label never moved and the button looked dead even though the tracker
    was toggling underneath it.
    Refreshed in the websocket's 1 Hz slow path, off-thread alongside the other
    subprocess collectors — `systemctl is-active` has no business on the fast path.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
2026-10-01 fix(tab5): tracking mode is commandable from the network
    The real reason the dashboard's AI TRACKING button "doesn't work": it started the
    tracker process, and the head never let it drive. `g_trackingMode` had exactly one
    writer — `main.cpp:609`, the Tab5's own touchscreen — so the authority to grant the
    head lived on a screen the dashboard cannot touch. Two switches for one function,
    and the dashboard owned the wrong one. Pressing it was invisible rather than broken.
    Adds `CAN_ID_TRACK_MODE` (0x108): the Thor asks the head for AI or MANUAL. A request,
    not a seizure — the head still reports `tracking=0` whenever the RC or the d-pad
    actually owns it, so this cannot take the head from s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
    [can_protocol.h, main.cpp]
2026-10-01 notes: record opendubs2's calibration before a deploy eats it again
    A backup, explicitly not a source. These values live in `static constexpr` in a
    tracked file, so `deploy-all.sh` — which rsyncs with `--delete` — overwrites them,
    and the next flash silently reverts the robot. That is what happened on 2026-10-01
    and it took most of the day to find and fix.
    Captured from the robot: `kDriveInvert = {-1,-1,1,-1}` and `kStrafeInvert = -1`,
    both verified by driving, plus `kDriveCh`, the ESC neutral/span/slew/rev-dwell, and
    the RC map from `RCCAL SHOW` — including that MAST is reversed and DEAD rests at 200.
    It records how the inverts were *reconstructed*, since they had already been lost: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
2026-10-01 notes: index the calibration backup in the open-work register
    The row was meant to land with e38f96a; the insertion matched nothing and failed
    before the commit, so the file was recorded without being findable from the index
    that exists to make these registers findable.
2026-10-01 feat(ros): /cmd_vel in, /odom out — the two Isaac ROS blockers
    ROS could neither drive this robot nor know where it was. Nothing subscribed to
    `/cmd_vel`, and Pinpoint odometry reached the StamPLC and stopped there as an `[ODO]`
    telemetry line the dashboard rendered. Both are prerequisites for anything
    navigation-shaped, and `software/choreo` already refused to move the base for exactly
    the second reason.
    `drive_bridge.py` does both over one UDP socket on 5005, speaking the StamPLC's text
    protocol **directly** — the dashboard is a telemetry consumer and putting a web
    backend in a motion path would add a failure mode for nothing.
    Half of this already existed in firmware: `DRIVE <fwd> <r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
2026-10-01 feat(stamplc): AUTO requires the deadman and is speed-capped, for now
    Autonomous motion had no limits at all. `autoAuth` alone fed the mixer, so CH5 in
    AUTO plus any live `/cmd_vel` publisher drove the robot at the planner's full
    commanded magnitude with nobody holding anything — and the CH8 speed knob was not
    applied either, so the operator's physical throttle did nothing in the one mode
    where a human is least in the loop.
    Two restrictions, both `static constexpr` in one place so relaxing them is one edit:
    - **`kAutoRequiresDeadman`** — AUTO now needs the deadman held, exactly as manual
    does. This is the wrong *end state* and is marked as such in the comment: a planner
    cannot hold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
    [main.cpp]
2026-10-02 notes: the calibration backup said 150 — the robot runs 400
    Recorded `kEscSpanUs = 150` this morning and raised the robot to 400 an hour later
    without updating the file that exists precisely so these values are not lost. A
    restore from it would have silently undone the change — the same failure the file
    was written to prevent, in a smaller way.
    Also carries forward what the Pinpoint test established and what it did not: yaw
    sign is confirmed correct (one CCW turn gave +389°, so heading increases CCW per
    REP-103), while yaw scale and the pod offsets remain unproven after the 4-turn run
    hit a desk leg.
    And records a harness bug worth not repeating: multi-turn rotation cannot be
    measured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
2026-10-03 feat(dash): arm pose view — real OpenArm geometry driven by joint angles
    The teleop page needs to show where the arms actually are. This is the
    renderer, verified end to end without the robot.
    WHY REAL GEOMETRY AND NOT A STICK FIGURE. Three of the seven joints per arm
    rotate about the limb axis, and a roll moves NO link origin: measured, 37 deg
    on joint 3 moves the end point 0.000 mm. A skeleton of link origins is
    therefore blind to it — and the robot really sat in that state on 2026-10-02,
    right arm at j3 -36.6 deg, looking identical to stowed. Asymmetric geometry
    shows it for free. An earlier 2D proposal here was simply wrong, and was
    rejected on exactly this.
    The cost argument that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
    [base_link.stl, body_link0_symp.stl, ee_base_link.stl, finger_inner.stl, finger_outer.stl, link1.stl, link2.stl, link3.stl]
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2026-10-03 fix(dash): the arm view was rendering the V2 arm; this robot is V1
    Caught in review. The vendored description was openarm_v2.0 — chosen without
    checking — and this robot runs the v1 arm with the parallel-link gripper, not
    v2's pinch gripper.
    IT IS NOT JUST THE END EFFECTOR, which is what made the mistake worth
    correcting rather than patching. EVERY joint origin and axis differs: v1's
    chain runs along +Z with lateral offsets (0.0301, 0.0315, 0.0375) and is
    mounted rpy=-1.5708 to bring it back down, while v2's runs along -Z with no
    lateral offsets at all. Nine of nine left-arm joints differ; none are shared.
    So the previous render was the wrong robot throughout, not merely the wrong
    hand.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
    [base_link.stl, ee_base_link.stl, finger.stl, finger_inner.stl, finger_outer.stl, link0_symp.stl, link1.stl, link1_symp.stl]
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2026-10-05 notes(tab5): bench the render path; measure instead of trusting the comment
    A bench harness (firmware/tab5_face/bench/) for the two questions the face
    firmware cannot answer about itself, run on a Tab5 with no head attached.
    The render finding is that face.cpp's own comment is wrong. It says the eye is
    "sized to fit INTERNAL SRAM (~290KB)", but at 324x448 the sprite needs 283 KB
    CONTIGUOUS and the largest internal block is 247 KB, so createSprite fails and
    the code takes its own silent PSRAM fallback. g_eyePsram records that to serial
    only, which nobody reads on the robot -- so the shipping face has likely been
    running from PSRAM all along. 55.1 fps for one push, 27.6 for the two the face
    a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
    [main.cpp]
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2026-10-05 feat(tab5): narrow the eye to 276 so it fits internal SRAM; interactive mic eval
    face.cpp: EW 324 -> 276. The old comment claimed the sprite was "sized to fit
    INTERNAL SRAM (~290KB)", but 324x448x16bpp needs 283 KB CONTIGUOUS against a
    ~247 KB largest block, so createSprite failed and the fallback silently put the
    whole face in PSRAM -- where it has been running. Benched, a two-eye frame goes
    27.6 -> 39.5 fps (+43%): +21% from 15% fewer pixels, +18% from reaching internal
    SRAM. 280 is the widest that fits but leaves 2 KB of margin against a block that
    moves with fragmentation, so 276 keeps 6 KB.
    BW 284 -> 242 in the same change, and NOT cosmetically: BW is the eye body inside
    the sprite and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
    [face.cpp, main.cpp]
2026-10-05 fix(tab5 micbench): stop writing a guessed gain at startup -- it silenced the mic
    applyGain() ran in setup() AFTER M5.Mic.begin() and wrote 0x00 to the ES7210's
    MIC1/MIC2 gain registers, on my assumption that 0x00 was "the chip default". It
    is the bottom of the PGA range. The Tab5 init leaves those registers alone, so
    the write replaced a working configuration with a muted one, and the bars that
    had been moving in the previous session stopped. Emma caught it as "something has
    changed since your last eval", which is exactly what it was.
    The harness now READS 0x43/0x44 back after Mic.begin() rather than asserting
    what they contain, starts in an UNTOUCHED state that changes nothing, and can
    re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
    [main.cpp]
2026-10-05 notes(tab5): the mic works at default gain; gain is a dead end
    Interactive result from the operator-paced harness: left/right/centre voice
    detection reads the intended direction reasonably reliably from the
    inter-channel level ratio, at the chip's default gain. So the input side of
    "turn toward a voice" needs no driver work -- which also closes out the last
    actionable item from comparing the Tab5 and CoreP4x init paths.
    That comparison had suggested the missing gain write was the obvious knob
    (CoreP4x sets 0x44-0x46 to 0x1B, the Tab5 path writes nothing). Stepping
    0x43/0x44 across 0x05-0x1E made little difference. The note now says so, and
    says not to spend time there again -- while being e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
    [main.cpp]
2026-10-05 fix(tab5 face): keep the eye in PSRAM -- internal SRAM belongs to the radio
    Flashing the previous commit to real hardware reboot-looped the board:
    [FACE] up eyePsram=0 freeInt=134KB
    assert failed: sdio_mempool_create sdio_drv.c:255 (buf_mp_g)
    rst:0xc (SW_CPU_RESET)
    The ESP32-P4 has no radio. Wi-Fi is an ESP32-C6 over SDIO, and esp_hosted's
    sdio_mempool_create() needs a DMA-capable pool from INTERNAL memory. Moving the
    241 KB eye sprite into internal SRAM left 134 KB, the pool failed to allocate,
    and the driver asserted on every boot -- trading OTA and payload comms for 6 fps.
    faceBegin() now calls setPsram(true) deliberately, with internal as the fallback
    rather than the preference,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
    [face.cpp]
2026-10-05 revert(tab5 face): put the eye back to 324x448 -- shrinking was the wrong axis
    EW/BW back to 324/284, restoring the original eye. The +21% frame rate the
    narrower sprite bought (27.6 -> 33.4 fps on a two-eye frame) was not a problem
    anyone had reported, and it was paid for in eye size -- which Emma would rather
    have LARGER. Optimising the one dimension the user actively wants more of, to
    improve a dimension nobody complained about, is a bad trade however good the
    measurement was.
    Kept from the exercise, because these are the parts that matter:
    - setPsram(true) is now DELIBERATE, with internal SRAM as the fallback rather
    than the preference. An internal-resident eye starves esp_hosted's S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
    [face.cpp]
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2026-10-05 feat(tab5 face): gaze leads motion -- faceLookAt() and a GAZE command
    The cheapest legible-motion behaviour there is: look where you are about to go
    before going there. It changes no trajectory and needs no planner, and an
    observer who sees the eyes move first can infer the goal.
    Adds faceLookAt(x, y, hold_ms) and a "GAZE <x> <y> [hold_ms]" protocol command.
    Arguments are in the ROBOT's frame -- x +1 its right, y +1 up -- because that is
    how callers think; both the viewer mirror (the robot's right is the observer's
    left) and the screen-y flip happen inside faceLookAt, in one place, so they
    cannot drift from the existing TURN handling that already negates turnDir.
    Three findings shaped it.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
    [face.cpp, face.h, main.cpp]
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2026-10-05 feat(tab5): social attention -- notice a voice, glance at it, acknowledge it
    The smallest complete interaction the robot can have, and the first thing here
    that is a BEHAVIOUR rather than a measurement: something makes a sound, the eyes
    go to it, and a short blip says "heard you". Mic direction -> gaze -> audio cue,
    in one loop a person can stand in front of and talk to.
    Three findings from the HRI survey are built in rather than bolted on.
    Gaze toward a speaker is the convention humans already use, so it reads correctly
    without being taught. Acknowledgement lands inside about a second whether or not
    anything can be done, because silence is read as being ignored or as broken. And
    the robot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
    [attention.cpp, attention.h, main.cpp]
2026-10-05 bench(tab5): negative zoom DOES mirror, and is 22% slower -- hypothesis dead
    Verified by pixel readback into an off-screen canvas, with a control case, so the
    answer needed nobody at the bench:
    control zoom +1,+1 -> marker stays LEFT OK
    mirror X zoom -1,+1 -> marker moves RIGHT OK
    So pushRotateZoom's negative zoom_x really does mirror. It is still the wrong
    tool for the face:
    A 2 rasters + 2 pushSprite (today) : 27.6 fps
    B 1 raster + push + mirror (new) : 21.5 fps -22%
    C 1 raster + 1 pushRotateZoom : 29.2 fps
    The affine blit costs about 16 ms where the raster it replaces costs about 18, so
    it buys back almost exactly what it spends and loses on overhead. I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
    [main.cpp]
2026-10-05 fix(tab5 attention): the robot was hearing its own chirp, and now reports itself
    Running the behaviour for the first time found the bug immediately: the
    acknowledgement chirp came back into the microphone at ~14000 RMS against a
    quiet-room floor of 20, registered as a fresh onset, produced another glance and
    another chirp, and dragged the tracked floor up to 327 -- so it went deaf to
    actual people while talking to itself.
    [ATTN] onset L13983 R13485 floor 327/320 -> look CENTRE +chirp
    Nothing upstream will fix this: the speaker and mic share the board, and the
    ES7210's echo-cancellation channels are disabled by M5Unified's own Tab5 init. So
    the module goes deaf while it makes noise, plu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
    [attention.cpp]
2026-10-05 feat(tab5 face): make the glint move AGAINST the eye, so the eye reads as turning
    Emma's observation: the gaze movement is subtle, and the glint not moving
    "largely defeats the feeling that the eyes are tracking". Both halves were right,
    and the code shows why.
    The glint was positioned off cx, which already carries the gaze offset, so
    highlight and eye body moved as one rigid object -- the same 12 px, zero relative
    motion. That reads as a texture sliding, not an eyeball rotating.
    What an observer actually reads as gaze is the CHANGING OFFSET between highlight
    and iris. A specular highlight is a reflection of a fixed light source off a
    curved eyeball, so when a real eye turns the highlight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
    [face.cpp]
2026-10-05 feat(tab5 face): gaze through per-eye shape, not a chasing highlight
    Reverts the counter-moving glint experiment to a single fixed highlight and
    replaces it with the primitive this kind of eye actually uses.
    The second glint read as confusing and "less like eyes", and the whole approach
    was wrong for a pupil-less eye. Anki hit precisely this building Cozmo: he
    originally had pupils, which made it easy to tell where he was looking, but they
    made him read as too human -- so they removed them and recovered the same effect
    through eye SIZE AND RATIO. Shape, not a marker inside the eye. Faking a rotating
    specular reflection was solving a problem this design language does not have.
    The structura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
    [face.cpp]
2026-10-05 feat(tab5 face): saccadic gaze -- ballistic jumps between dead-still fixations
    Replaces the gaze model rather than tuning it. Emma's read was that it looked
    jittery and conveyed nothing, and both symptoms had the same cause: the eyes were
    never still.
    The old model was `gx = lp(gx, target, k)` -- an exponential approach that never
    settles -- so the eyes were permanently in motion with nothing to read. In
    AUTONOMOUS it was worse: `sinf(breathe * 0.7f) * 0.6f`, a continuous sine sweep,
    which is smooth pursuit of a target that does not exist. Real eyes do not drift,
    and on top of that the per-eye width asymmetry added last commit was recomputed
    from a continuously-moving gx every frame, so the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
    [face.cpp]
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2026-10-05 feat(tab5-idf): 1.2a -- human-scale eye spacing, square eyes, emotes as multipliers
    Applies the geometry the measurement argued for. The dominant change is SPACING:
    interpupillary distance goes from 380 px (32.9 mm, 52% of human) to 729 px
    (63.0 mm, human scale). Eye width was never really the problem -- 284 px was
    24.6 mm, already 82% of a human eye's 30 mm visible aperture -- but 3x-tall,
    narrow and half-spaced is a small animal's face rather than a person-scale robot
    at human eye level.
    Body goes 284x376 (0.76:1 portrait) to 400x400 (34.6 mm square): wider than a
    human aperture per the baby schema, which finds large round eyes give the highest
    perceived trustworthiness on robot faces, an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
    [app_face.cpp]
2026-10-05 feat(tab5-idf): bigger eyes, closer spacing, and actual eyebrows
    Three corrections from looking at it.
    EYEBROWS WERE NEVER IN THIS APP. drawBrow() is in the OLD Arduino face.cpp; this
    LVGL app had body, pupil, glint and lid and nothing else, so "I still don't see
    eyebrows" was simply correct and my earlier "you already have them" was about
    different firmware. Added now as a child of the SCREEN rather than the body --
    as a child of the body it would be clipped by the thing it has to sit above --
    with sprung raise and a mirrored angle, so one signed number describes a
    symmetric pair. Each emote gains browRaise and browAngle; positive angle is
    inner-end-down, the scowl direction.
    They earn th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
    [app_face.cpp]
2026-10-05 fix(tab5-idf): a rotated brow allocated a layer buffer per draw and starved the device
    Animation broke on the Tab5 after adding eyebrows. Root cause measured rather than
    guessed, and it was mine twice over.
    lv_obj_set_style_transform_rotation makes LVGL render that object through a LAYER,
    allocating a buffer the size of its bounding box ON EVERY DRAW. The 438x42 brow
    asked for 73 KB per draw, the allocation failed, LVGL retried in a tight loop, and
    the idle task starved until the task watchdog fired:
    lv_draw_buf_create_ex: No memory: 438x42, cf: 16, stride: 1752, 73584Byte
    lv_draw_layer_alloc_buf: Allocating layer buffer failed. Try later
    E (90746) task_wdt: Task watchdog got trigger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
    [app_face.cpp]
2026-10-05 fix(tab5-idf): gate face telemetry behind a build flag -- it was a suspect
    Emma asked whether my telemetry grab stopped the animation or whether a problem
    remained. It is a fair question and I should have raised it unprompted.
    The ESP-IDF console goes out over USB-serial-JTAG, and when no host is draining
    the port a write can BLOCK THE CALLING TASK -- which here is the task driving the
    animation. So the 1 Hz diagnostic printf in onRunning() is a plausible cause of
    the face freezing, which makes it useless for diagnosing a frozen face: it cannot
    be the instrument and the suspect at once. It also makes behaviour depend on
    whether a reader is attached, and head -c N exits partway through and s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
    [app_face.cpp]
2026-10-05 feat(tab5-idf): glint lives inside the pupil; radial shading on eye and highlight
    Emma's question -- shouldn't the glint be inside the pupil? -- is right, and
    parenting it there fixes the bug she spotted at the same time. A catchlight is a
    corneal reflection sitting over the iris and pupil, not a spot floating beside
    them. As a child of the pupil it now travels with the gaze for free, and it can no
    longer escape the eye's rounded silhouette, which is what was showing in SQUINT:
    LVGL clips children to the parent's bounding box rather than its rounded shape,
    and at squint the corner radius reaches 115 px on a 269 px-tall eye.
    Also enables LV_USE_DRAW_SW_COMPLEX_GRADIENTS, which the draw code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
    [app_face.cpp]
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2026-10-05 feat(tab5-idf): 1.2c -- port the real seven-state machine
    Replaces the five invented emote presets with the actual state table, copied
    verbatim from ui_shared.cpp so the two faces cannot drift: INIT, SAFE_IDLE,
    MANUAL, AUTONOMOUS, DEGRADED, E_STOP, CHARGING, each with its colour and its
    Expr of {h, w, tilt, bow, squint, lookY, brow}.
    Each of the seven parameters now has its OWN AnimateValue rather than one lerp
    toward the whole tuple, which is what makes a state change read as a change of
    posture instead of a crossfade -- and was the specific claim that justified moving
    to this toolkit. State colour animates as well, with the gradient rim tracking it
    at 35% of the hue so the sphere falloff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
    [app_face.cpp]
2026-10-05 feat(tab5-idf): separate states from emotes; ease colour so it stops flashing
    Three corrections from Emma.
    STATES AND EMOTES ARE DIFFERENT THINGS, and mapping one state to one expression
    conflated them. A state is mostly a COLOUR plus a policy; an emote is an
    EXPRESSION. In the calm states the face should be free to be emotive rather than
    locked to a posture, so SAFE_IDLE, MANUAL and AUTONOMOUS now draw from a free
    vocabulary while E_STOP, DEGRADED, INIT and CHARGING stay locked -- deliberately,
    because those postures ARE the message and a robot that looks cheerful while
    degraded is lying.
    THE EMOTES I REMOVED ARE BACK, which they should not have been removed for in the
    first place: NEUTRA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
    [app_face.cpp]
2026-10-05 feat(tab5-idf): rebuild expression on EYELIDS, not on deforming the eyeball
    Emma's objection was that the emote forms should come from research rather than be
    invented, and that the ones I had invented were worse than what they replaced. Both
    correct, and the research explains every individual complaint with one cause.
    The eyelid literature parameterises a lid by horizontal shift, vertical shift and
    CURVATURE, over an eye model of upper lid, lower lid, iris, cornea and sclera.
    That is: the eyeball is a CONSTANT and the lids move across it. My model deformed
    the eyeball -- scaling h and w, carving a notch out of a corner -- and every
    symptom followed:
    SLEEPY looked malformed .... height c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
    [app_face.cpp]
2026-10-05 revert(tab5-idf): back to the face that worked, before the state port
    Reverts app_face.cpp to f2c638b. Two successive attempts at expression made it
    worse, and Emma said so both times -- "better before your state flash" -- which I
    should have acted on the first time instead of rebuilding the model again.
    What is restored: 480x480 eyes at a 0.34 eye-width gap, radial body shading, the
    soft catchlight inside the pupil, lv_line eyebrows, eased saccades with
    main-sequence timing, sprung shape, and the five simple multiplier-based emotes.
    No corner notches, no ellipse eyelids, no slant bars.
    What is discarded: the seven-state port (1.2c) and the eyelid-based expression
    model. The RESEARCH behin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
    [app_face.cpp]
2026-10-05 feat(tab5-idf): state colours only -- shapes and emotes untouched
    One change against the restored baseline, after two attempts that changed the
    whole expression model at once and made the face worse both times.
    Adds the seven states from ui_shared.cpp carrying COLOUR AND LABEL AND NOTHING
    ELSE. The emote table still drives every shape parameter; no state touches a
    width, a height, a lid or a brow. The eye's base colour, its gradient rim at 35%
    of the same hue so the sphere falloff follows, and the brow line all take the
    state colour.
    Colour is EASED, not sprung. Three independent springs on R, G and B overshoot,
    and an overshoot in RGB lands on a genuinely different hue, which is what made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
    [app_face.cpp]
2026-10-05 feat(tab5-idf): reporting states pin one emote; attending states stay free
    Restores the directional point I dropped in the revert. Cycling emotes through
    E_STOP was incoherent -- SLEEPY during an e-stop says nothing true about anything.
    The test is whether the robot is ATTENDING TO THE WORLD or REPORTING A CONDITION.
    SAFE_IDLE, MANUAL and AUTONOMOUS are attending, so the face is free to be emotive.
    INIT, DEGRADED, E_STOP and CHARGING are reporting, and each pins one emote.
    Pinning the EMOTE does not freeze the FACE: saccades and blinks carry on in every
    state, because a robot whose eyes have stopped moving reads as broken rather than
    as stopped -- which is the opposite of what an e-stop sh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
    [app_face.cpp]
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2026-10-05 fix(tab5-idf): smoother band sweep -- 120 segments, 64 opacity levels
    The sweep read as pixelated, and both causes were mine. Opacity was quantised to
    16 levels, which is exactly what betrays a smooth ramp; and the wave was sampled
    at only 48 points around a 4000 px perimeter, so each segment was 83 px wide.
    Now 120 segments at ~33 px and 64 opacity levels. The change-guard per segment is
    what keeps the cost bounded rather than the step size, so the step can afford to
    be fine -- during a sweep only the segments the bump is passing over change at all.
    [app_face.cpp]
2026-10-05 fix(tab5-idf): back to 48 band segments -- 120 froze the device
    120 segments froze it; 48 was running. Reverted the object count and kept the
    opacity quantisation change (16 -> 64 levels), which is where the smoothness
    actually came from and which costs nothing -- the per-segment change-guard bounds
    the cost regardless of step size.
    The lesson is the same one as the rotated brow: on this device the thing that
    bites is not arithmetic, it is how many objects LVGL has to consider. Change one
    of these at a time.
    [app_face.cpp]
2026-10-05 fix(tab5-idf): band back to 48 segments at 16 opacity levels -- the config that ran
    Restores exactly the band that was working before I tried to smooth it. Both of my
    "smoothing" changes cost frames, and my reasoning about the second one was wrong.
    I claimed finer opacity quantisation was free because the change-guard bounds the
    cost. That is backwards: the guard makes writes CONDITIONAL, but a finer step makes
    more of them pass the condition. 64 levels meant roughly four times the
    invalidations per frame, and the device froze with the object count already back at
    48.
    So the sweep is visibly stepped, and that is the version that runs. Getting it
    smoother is not free on this device and shou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
    [app_face.cpp]
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2026-10-05 feat(tab5-idf): SOC gauge on the band, and CHARGING stops pinning a mood
    The band is already 48 addressable segments, so reading charge off it costs ZERO
    new objects and one opacity write per segment -- and since SOC moves on a timescale
    of minutes, almost every frame writes nothing at all. The filled proportion reads
    as a level, with a slow travelling shimmer over the filled part only, so
    "charging" is distinguishable from "this is simply how full it is". The old
    renderer did this inside the eye via drawEye's gauge branch; the band is a better
    home because it does not spend the eyes on it.
    CHARGING no longer pins an emote. Charging is a CONDITION TO DISPLAY rather than a
    mood to adopt, so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
    [app_face.cpp]
2026-10-05 perf(tab5-idf): band becomes four gradient strips -- 4 writes/frame, not 48
    Emma's observation located the freeze precisely: it went on MANUAL / ALERT / idle,
    which is the peak-cost frame rather than a random one. ALERT is the largest body
    (1.06 x 1.08, so the biggest dirty area on every resize) and IDLE is the band's
    worst case, because breathing is UNIFORM -- all 48 segments change opacity every
    frame, where a sweep only touches the few the bump is passing over. Maximum eye
    area plus a guaranteed 48 writes per frame.
    So the band is now one strip per edge, each carrying a FIXED linear gradient, with
    opacity the only per-frame write: 4 objects and at most 4 writes per frame, down
    from 48. T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
    [app_face.cpp]
2026-10-05 perf(tab5-idf): quantise the body resize, guard the brow, coarsen band opacity
    The second freeze was AUTONOMOUS / SLEEPY / thinking, which has a different cost
    profile from the first: SLEEPY is a SMALL body (475 x 192), so the eye was not the
    dominant term. Two things were.
    lv_line_set_points() on the brow had NO GUARD. It invalidated both brows every
    frame whether or not a point had moved, and on SLEEPY the brow is static, so this
    was pure waste at ~16 k px per eye per frame. Every other write in the render loop
    was guarded; this one was simply missed.
    And "thinking" is the fastest sweep, so all four large strips -- 1280x16 and
    720x16 of gradient each -- were redrawing at maximum rate.
    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
    [app_face.cpp]
2026-10-05 fix(tab5-idf): the freezes were radial gradients -- and the change was untracked
    Emma asked when the freezes started and whether we had changed something we had
    not considered. Both halves of that question found it.
    The freezes begin exactly at f2c638b, "radial shading on eye and highlight" --
    the commit that enabled LV_USE_DRAW_SW_COMPLEX_GRADIENTS and put a radial gradient
    on the eye body and the glint. Everything before it ran. Complex gradients are
    cached PER GEOMETRY, and the body animates its size every frame, so each frame
    minted a new gradient and the churn accumulated until an allocation failed. That
    is precisely the run-for-a-while-then-freeze signature, as against the immediate
    f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
    [app_face.cpp]
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2026-10-05 fix(tab5-idf): accessories built once and inset clear of the band
    Two mistakes in my own claim that the accessory layer was static and therefore
    free. Both caused the freeze.
    "STATIC" MEANS NEVER ALLOCATED, not just never animated. The first version created
    and deleted 14 lv_line objects on every theme change -- allocation churn on an
    18-second loop, with the same run-then-freeze signature as the gradient cache.
    Every theme's objects are now built ONCE at startup and shown or hidden; nothing
    is allocated after the scene exists.
    AND A STATIC OBJECT IS ONLY FREE IF NOTHING REDRAWS BENEATH IT. Overlapping
    objects get recomposited whenever the dirty area touches them, and I put the
    cobwebs in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
    [app_face.cpp]
2026-10-05 fix(tab5-idf): unclip the right-hand web; put free heap on the panel
    The right cobweb was missing rather than mirrored: lv_line coordinates are
    relative to the object's own box, so the negative coordinates my mirror produced
    fell outside it and LVGL clipped them. Points are now kept positive by measuring
    from the object's right edge, with the object positioned to suit.
    And rather than flash-and-wait on another freeze hypothesis, the free heap and the
    largest free block now read out on the panel itself. Console telemetry cannot be
    used for this: a console write blocks the calling task when no host is draining
    USB-serial-JTAG, and that task is the one driving the render, so the instrument is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
    [app_face.cpp]
2026-10-05 fix(tab5-idf): the freeze was an unbounded normalisation loop, not memory
    The on-screen heap readout settled it in one glance: 23 MB free, 22 MB largest
    block, and frozen. Every memory hypothesis was wrong -- the leak, the
    fragmentation, and the gradient-cache churn that had looked so convincing.
    The cause was unbounded while loops normalising the band's phase accumulator:
    while (g_phase > 1.0f) g_phase -= 1.0f; // iterates ONCE PER UNIT
    while (d < -0.5f) d += 1.0f;
    dt comes from now - g_lastMs, so one long frame -- a scheduling hiccup, a slow
    redraw -- makes the phase large, and those loops then iterate millions of times
    per edge per frame inside the render path. CPU pin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
    [app_face.cpp]
2026-10-05 fix(tab5-idf): applyEmote() was calling LVGL without the lock
    Found by auditing the file statically rather than flashing another hypothesis. One
    call site mutated LVGL without holding the lock:
    if (... && now > g_nextEmote) {
    g_emote = (g_emote + 1) % kNEmotes;
    applyEmote(g_emote); // lv_label_set_text() with NO LOCK HELD
    Every other call site took GetHAL()->lvglLock(). This one did not, so every 3.2
    seconds it mutated LVGL's label buffer and invalidation list while the LVGL task
    could be mid-render.
    An unsynchronised LVGL call corrupts internal state rather than failing cleanly,
    which is why the symptom was so misleading: a render task that hung after a
    VARIABL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
    [app_face.cpp]
2026-10-05 docs: an invariant checklist, and four more latent bugs found by running it
    Emma's point stands: four consecutive "found it" claims, each arrived at by
    picking a plausible mechanism, flashing, and waiting. That is not a method, and it
    spends a flash and someone's attention per attempt. So this does the systematic
    pass instead, and writes the checklist down so it can be re-run rather than
    re-derived.
    firmware/tab5_idf/AUDIT.md lists nine invariant classes with the grep for each,
    every one of which has already caused a failure in this app: LVGL calls outside
    the lock, layer-inducing styles, complex gradients on animated geometry, unbounded
    loops in the render path, wrap-unsafe deadlines, stea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
    [app_face.cpp]
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2026-10-05 tools(tab5-idf): the sim cost gate -- and the current face FAILS it
    A desktop-only gate that hooks LV_EVENT_INVALIDATE_AREA and LV_EVENT_REFR_READY
    and reports dirty area per frame against the device's budget. No-op on the device,
    which should not carry an instrument it cannot act on. Run with ./build.sh cost.
    FIRST MEASUREMENT: mean 2,835 k px/frame -- 3.08 screens, 532% of the device's
    533 k px budget. Allowing for the overcount below the real figure is likely
    1-1.5 screens/frame, which is at or over budget and consistent with the face
    having frozen repeatedly. So the gate's first act is to confirm, from the laptop
    and without a flash, something it took many flashes to discover.
    THE METR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
    [app_face.cpp, cost_gate.cpp, cost_gate.h]
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2026-10-05 feat(tab5-idf): 1.2b OpenDubs splash, 1.2e quote strip -- and lv_conf.h is desktop-only
    1.2b replaces the M5Stack vendor splash. The robot should not boot into a dev
    board's branding, and two things beyond the logo were wrong with the original: it
    was WHITE, so booting flashed white then snapped to the black face; and it called
    GetHAL()->startWifiAp(), standing up an access point on a machine students use,
    which this robot does not want since it joins an existing network. Now black,
    "OpenDubs" over "UW Allen School Robotics" in SAFE_IDLE's green so the splash and
    the face are the same robot, fading up with the letter spacing settling so it reads
    as the robot coming to rather than a static im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
    [app_face.cpp]
2026-10-05 feat(tab5-idf): 1.3 -- six audio cues, and the channel model in the design was wrong
    Six cues rendered once into 48 kHz interleaved-stereo PCM with an 8 ms attack and
    55 ms decay plus a little second harmonic: the envelope asymmetry is what makes a
    tone read as a sound rather than a switch, and a pure sine on a small speaker reads
    thin. Format read from hal_audio.cpp's i2s_reconfig_clk_fn rather than assumed.
    THE DESIGN'S CHANNEL MODEL DOES NOT EXIST IN THIS BUILD. It assumed M5Unified's
    eight virtual channels; the demo HAL exposes a single audioPlay() that REFUSES
    while something is already playing -- no queue, no mixing, just a warning. So
    "separate channels so an acknowledgement can neve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
    [app_face.cpp, cues.cpp, cues.h]
2026-10-05 fix(tab5-idf): per-cue gain -- Mode was too loud for something routine
    Emma: the mode tone is too loud, especially for something that happens routinely.
    Correct, and the principle generalises: LOUDNESS SHOULD BE INVERSELY PROPORTIONAL
    TO HOW OFTEN A CUE FIRES.
    Mode sounds on every state change. A routine cue at alarm volume is the fastest
    way to make someone mute the robot entirely -- and then the cue that actually
    mattered goes with it. So gain is now per-cue rather than one master level: Mode is
    the quietest thing that still registers at 0.30, Fault keeps the headroom at 1.00,
    and the rest sit between by how often they fire against how much it costs to miss
    them.
    Adds 1.3b to the plan: b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
    [cues.cpp]
2026-10-05 feat(tab5-idf): OTA partition table; cues off; two traps closed
    Cues are OFF (kCuesEnabled=false) at the user's request until they say to re-enable.
    The Mode cue is also retuned 2000 -> 950 Hz at 0.22 gain for whenever that happens:
    "shrill" is a pitch complaint and 2-4 kHz is exactly where the ear is most sensitive,
    so the old tone was loud in the one band that needs least power. That is a better
    guess, not a verified fix -- it has never been heard.
    partitions.csv makes the image OTA-capable: two 5 MB app slots, otadata, and nvs left
    at 0x9000/0x5000 byte-for-byte matching the Arduino default_16MB.csv so the per-robot
    tilt limits and IMU offsets in NVS survive the switch. No phy_init -- th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
    [partitions.csv]
2026-10-05 fix(tab5-idf): two wrap-unsafe deadlines in cues.cpp; widen the audit's scope
    Second run of AUDIT.md. app_face.cpp passed invariants 1-6 clean. cues.cpp violated
    invariant 5 twice -- and was never searched, because every grep in the checklist named
    app_face.cpp by hand.
    cuePlay `now < g_busyUntil` -- at the 32-bit ms wrap (~49 days uptime) every cue of
    priority <= the last is suppressed until a higher
    one happens to fire and rewrite the deadline.
    cueTick `nowMs < g_nextFault` -- PERMANENT. The early return happens before
    g_nextFault is advanced, so the repeating fault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
    [cues.cpp]
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2026-10-05 fix(tab5-idf): sdkconfig is VENDOR-TRACKED -- my "staleness guard" broke the boot
    I was wrong about sdkconfig, and the wrong version of that belief is what broke the
    bench device for several builds.
    The earlier commit called sdkconfig "generated and accumulating" and had build.sh delete
    it whenever sdkconfig.defaults was newer. That is true of most IDF projects. It is NOT
    true here: the Tab5 demo COMMITS platforms/tab5/sdkconfig -- 94 KB, 3245 lines, the
    vendor's known-good configuration. Deleting it replaced all of that with whatever our
    1.7 KB defaults plus Kconfig defaults produced, and the result aborted at 1307 ms:
    E (1307) i2c: CONFLICT! driver_ng is not allowed to be used with t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
    [app_face.cpp]
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2026-10-05 feat(tab5-idf): visible camera preview as the instrument; correct the "face detection works" claim
    Emma: "I've still never seen your cyan square and it feels a lot like we're in a try and
    hope instead of design properly." Correct, and the root of it is a claim I made earlier
    today: the built-in-image self-test passed and I reported "face detection WORKS". That
    proves the MODEL runs and exercises NO part of the camera. The live path had never run
    once. Corrected in the workplan where I wrote it.
    She also rejected my next idea -- a synthetic test feeding the reference image through the
    live conversion code -- on the grounds that a test without her in frame proves nothing.
    Right again, and for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
    [app_face.cpp]
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2026-10-05 fix(tab5-idf): four UNLOCKED LVGL calls in onRunning froze the face; probe priority; mirror sign
    Emma: "there's a real chance you just straight up broke the animation - this might be a
    simpler issue - look at when animation stopped and what you did." That was the right
    instruction and it found it in one diff.
    THE BUG. I added four LVGL calls to onRunning with NO LOCK HELD:
    lv_label_set_text(g_probeLabel, ...)
    lv_obj_set_pos(g_reticle, ...)
    lv_obj_remove_flag(g_reticle, ...)
    lv_obj_add_flag(g_reticle, ...)
    I had assumed onRunning holds the LVGL lock throughout. It does not -- it acquires it in
    short bursts around each block that touches LVGL, and my code landed between two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
    [app_face.cpp]
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2026-10-05 perf(tab5-idf): drop a 934 KB MP3 we never play; report the heap that actually binds
    MEASURED: app image 4,132,832 -> 3,215,328 bytes. 896 KB saved, headroom 21% -> 39% free.
    With face detection INCLUDED we are now leaner than we were without it, so the dead
    payload more than paid for esp-dl.
    The vendor embeds audio/canon_in_d.mp3 via EMBED_TXTFILES for a music demo -- 956,208
    bytes, ~25% of the entire image, and almost exactly esp-dl's cost (~726 KB code + 196 KB
    model). Nothing in the face has ever played it. I had been treating the app-slot budget as
    a real constraint on the architecture; most of it was dead vendor payload.
    Removing the embed alone breaks the link, because hal_audio.cpp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
    [app_face.cpp]
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2026-10-05 fix(tab5-idf): theme palette was keyed by ORDINAL while reserved() was keyed by name
    Found by the design-debts cloud session, confirmed here. theme::stateColour() was:
    if (g_active == NONE || reserved(state)) return base;
    switch (state) { case 0: ... case 3: ... case 6: ... }
    I made reserved() table-driven and name-based earlier today and was pleased with it. The
    palette it protects was still addressed POSITIONALLY. Insert a state anywhere above
    CHARGING and every themed colour is handed to its neighbour, while whichever state is
    pushed past the last case silently stops being themed at all -- and the reserved guard
    stays correct throughout, so nothing looks broken. The colours are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
    [app_face.cpp]
2026-10-05 feat(tab5-idf): motion saliency is the attention cue; face detection confirms
    Face detection cannot be the robot's sense of where people are. msr_s8_v1 takes a
    160x120 input with a 16 px smallest anchor, so the smallest face it resolves is
    ~128 px of the camera's 1280x720 -- about 1.1 m. That is the model's input
    resolution against the lens, not a threshold anyone can move.
    So motion leads. Frame-difference the luma of the downscaled frame, keep the
    previous plane (57,600 B, PSRAM), threshold per pixel, accumulate into a 16x9
    cell grid, smooth, and take a sub-cell centroid over the hottest neighbourhood.
    Distance-independent, whole field of view, no model, 5,584 bytes of flash.
    Face detecti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
    [app_face.cpp, attention.cpp, attention.h, cues.cpp]
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2026-10-05 fix(tab5-idf): build-time Wi-Fi credentials must override stored ones
    The provisioning path I wrote was useless in the only situation it is needed. It applied
    OPENDUBS_WIFI_SSID only `if (!stored)` -- but NVS already holds credentials for the
    robot's network (proved on device: reason 201 NO_AP_FOUND rather than "none stored"), so
    the one case that actually occurs is "NVS has credentials for a DIFFERENT network and
    someone is moving the board". In that case the build-time values were silently ignored
    and the board kept hunting a network that is not there.
    Passing OPENDUBS_WIFI_SSID is a deliberate act and now wins over whatever was left behind.
    The status line and log say which network is be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
    [net.cpp]
2026-10-05 feat(tab5-idf): OTA works end to end -- verified by the slot flipping app0 -> app1
    The gap that gated everything else is closed. The robot's head is flashed over the air
    today; the IDF rewrite could only be flashed over USB, behind the robot's face on the
    e-stop-protected drive branch. It can now be updated the same way the robot already is.
    Verified from the laptop, nobody watching the panel:
    before: PONG m5stack_tab5 b4e356b-dirty Oct 5 2026 slot=app0
    ack: OK ota
    192.168.68.119 - - "GET /m5stack_tab5.bin HTTP/1.1" 200
    after: PONG m5stack_tab5 b4e356b-dirty Oct 5 2026 slot=app1
    The slot flip is the proof. An earlier attempt looked plausible and was NOT one: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
    [net.cpp]
2026-10-05 feat(tab5-idf): touch UI — graded controls, technician + fault screens (DEVICE BUILD UNBUILT)
    The ESP-IDF face had no touch handling at all. The Arduino firmware it replaces does
    (firmware/tab5_face/src/: hmi.cpp's lift controls and head D-pad, main.cpp's handleTouch,
    idle auto-revert), and notes/design/tab5-dashboard.md's own "Still open" list names the LVGL
    input device as the first implementation question. This answers it, plus the four confirmation
    grades that note settles.
    DEVICE IMAGE IS UNBUILT. No ESP-IDF toolchain on this machine; the M5Tab5-UserDemo tree was
    cloned to compile against, but the esp32p4 install was not attempted. What IS verified:
    * the DESKTOP target builds and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
    [app_face.cpp]
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2026-10-05 feat(tab5-idf): OTA rollback works -- proven by reverting a deliberately broken image
    Gate item 2 closed, and cheaply, because it was done on a desk rather than on the robot.
    1 good, before OTA : slot=app0 state=VALID
    2 bad image booted : slot=app1 state=PENDING_VERIFY
    3 after reboot : slot=app0 state=VALID
    A deliberately-bad image (OPENDUBS_NO_MARK_VALID=1, which runs normally but never declares
    itself healthy) was pulled over the air, booted, and the bootloader put the working
    firmware back with no human and no cable.
    THE BUG THIS FOUND IS THE POINT. The first two attempts failed with state=NEW rather than
    PENDING_VERIFY. CONFIG_BOOTLOADER_APP_ROLLBACK_ENABLE is a BOOTLO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
    [net.cpp]
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2026-10-06 fix(tab5-idf): the face's first frame is correct, and the eyes open into it
    At boot the face appeared distorted for seconds before settling: teal eye
    bodies, an oversized white blob where the catchlight belongs, and a black
    square over the eye. Measured on the desktop build rather than reasoned
    about:
    as built: body 480x480 pupil 130x130 glint 130x130 lid 130x130
    correct: body 480x480 pupil 163x163 glint 54x54 lid 480x0
    plainBox() creates an object and removes all its styles but never sizes it,
    and buildScene() sized only the eye BODY -- so the pupil, glint and lid sat
    at LVGL's default 130x130 until the first render pass. The glint at 130 in a
    130 pupil is the white blob; t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
    [app_face.cpp]
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2026-10-06 fix(tab5-idf): make the wifi state actually reachable — three logging defects
    Found by flashing the robot's head, where a NO_AP_FOUND loop was invisible
    from both routes a person would look.
    1. THE STATUS LINE WAS A BOOT-TIME SNAPSHOT. The text lived inside
    applyEmote(), which also retargets every animation -- so refreshing it
    would have restarted the springs, and nothing refreshed it. applyEmote runs
    once in onOpen and then only on a state or emote change, and with no
    StamPLC link neither ever happens. The panel therefore sat on "wifi: idle",
    which is the INITIAL value of net.cpp's status buffer and had never been
    overwritten, while the radio retried in a loop. The one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
    [app_face.cpp, net.cpp]
2026-10-06 feat(tab5-idf): the head gets a name, pan/tilt, RC input and an I2C scan
    mDNS. opendubs-stamplc.local and opendubs2.local already resolved on the
    robot's network; the head was the only device without a name, and that absence
    is what forced a configured TAB5IP into the StamPLC link -- an address that
    fails SILENTLY when a DHCP lease changes, because the StamPLC keeps
    transmitting into the void and its own counters keep incrementing. The Arduino
    firmware intended this (ArduinoOTA.setHostname("opendubs-tab5")) but hung it on
    ArduinoOTA, whose listener sits behind the ESP-Hosted co-processor and never
    worked on this board.
    Verified on the robot: opendubs-tab5.local -> 10.42.2.14, and _opendubs.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
    [net.cpp, pantilt.cpp, pantilt.h]
2026-10-06 feat(tab5-idf): every HMI button works, and the lift/e-stop link is resolved by name
    The controls were drawn but inert. `commandBox()` attached no handler at all, so RAISE, LOWER,
    the pan/tilt d-pad, MODE and the soft e-stop were pictures of buttons.
    Split by what they actually need:
    - **The d-pad and MODE need nothing.** They act on servos and state this board owns -- the Arduino
    set `g_dpadPanDps`/`g_dpadTiltDps` straight into its local integration at 45 deg/s. They are live
    on `LV_EVENT_PRESSING`, which repeats while held and so refreshes the 600 ms lease: a missed
    release stops the head by construction rather than by a handler running.
    - **RAISE/LOWER and the e-stop go to the Sta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
    [app_face.cpp, net.cpp, net.h, pantilt.cpp, pantilt.h, ui_hmi.cpp]
2026-10-06 fix(tab5-idf): the controller panel closed before a button could be pressed
    Two defects, and the first is why the controls were unreachable rather than merely inert.
    **Opening was not counted as activity.** hmiTick() early-returns while the panel is closed, so
    g_lastTouch kept the timestamp from the PREVIOUS session -- and on re-open `nowMs - g_lastTouch`
    was already past kRevertMs, so the panel closed on its very first tick. The first open after a boot
    worked, because g_lastTouch == 0 seeds itself; every open after that flashed open and shut. From
    the front that looks like the face covering the buttons before they can be hit, which is exactly
    how it was reported.
    **A press on a control di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
    [ui_hmi.cpp]
2026-10-06 fix(tab5-idf): the d-pad was never integrated, and the state chip had no source
    **The d-pad.** onRunning() returned early whenever a panel owned the screen, and pantiltTick() sat
    below that return -- so pan/tilt stopped being ticked at exactly the moment the d-pad is used. The
    arrows set a rate that nothing integrated and the servos were never written. The e-stop beside them
    worked because its effect leaves over the network and does not need that loop at all, which is what
    made the symptom look like an event-delivery problem.
    It was NOT an event-delivery problem, and the census says so: pressing=83 on the very build where
    the arrows were dead. LV_EVENT_PRESSING fires on this hardware. The h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
    [app_face.cpp, net.cpp, ui_hmi.cpp]
2026-10-06 fix(tab5-idf): the lift buttons were not clickable, and the head fought the d-pad
    **The lift never sent anything.** commandBox() never set LV_OBJ_FLAG_CLICKABLE, so RAISE and LOWER
    received no press events at all: no command left the head and the robot's arm gate was never even
    reached. The e-stop worked only because it set the flag explicitly, and liveBox() did too -- this
    one was written when the plan was to attach no handler at all, and the flag was never added back.
    The robot's own telemetry said armed=1 estop=0 bus=1 safe=1 throughout, which is what moved the
    search from the StamPLC to this side.
    **The head fought the d-pad.** Manual aiming was a 600 ms LEASE, so the moment it lapsed t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
    [app_face.cpp, net.cpp, net.h, pantilt.cpp, ui_hmi.cpp]
2026-10-06 fix(tab5-idf): a sentinel read as a clock slammed the panel shut on the first press
    Touching a d-pad arrow brought the eyes back INSTANTLY -- not on a timeout, which is what made the
    symptom read as "the d-pad fights me" and sent two rounds of looking at the wrong thing (ownership
    leases, then the revert duration, which was never involved).
    g_lastTouch carries two meanings. onAnyHmiPress runs on the LVGL task where reading the clock is
    awkward, so it writes 0 as a "stamp me on the next tick" flag, and the TOP of hmiTick converts 0 to
    nowMs. The hold re-assertion I added later wrote that same 0 -- but it sits BELOW that conversion
    and ABOVE the revert check, which reads g_lastTouch as a time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
    [pantilt.cpp, ui_hmi.cpp]
2026-10-06 fix(tab5-idf): manual aiming now actually clears tracking, so the head stops re-centring
    The previous commit claimed this and did not do it. The edit that was supposed to add
    `g_tracking = false` to pantiltTouchRate() matched a pattern with the opening brace on the same
    line; the source has it on the next, so the replacement silently did nothing and I did not assert
    on it. The manual-hold branch landed, the thing that SELECTS it did not -- so every release still
    fell through to the tracking branch, whose target is kCentreDeg, and the head crawled back to
    centre exactly as reported.
    Two process notes, because this is the second silently-skipped edit in this session (the first left
    a constant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
    [pantilt.cpp]
2026-10-06 feat(tab5-idf): a real ToF driver, no FPS overlay, random emotes, no band, reticle opt-in
    **The front ToF was never unwired.** The panel said so because no driver existed. Identified on the
    robot from its model ID -- VL53L0X (0xEE at 0xC0), not the VL53L1X -- because that distinction is
    silent: the L1X has sixteen-bit registers and a driver for one simply fails against the other.
    app_face/tof.cpp ports ST's bring-up (the sequence Pololu's Arduino library implements, which does
    not exist here): 2V8 mode, stop variable, SPAD reference map, the default tuning table, VHV and
    phase reference calibration, continuous back-to-back ranging polled non-blocking because it shares
    a task with the servos.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
    [app_face.cpp, net.cpp, pantilt.cpp, pantilt.h, tof.cpp, tof.h, ui_hmi.cpp]
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2026-10-06 feat(choreo): composer — a preview-only timeline editor with the validator in the loop
    software/choreo/composer/: a vanilla-JS, no-build, no-CDN timeline editor
    and a stdlib HTTP server. One lane per slot plus clips/music/ruler,
    keyframe diamonds on arm lanes, duration-bearing blocks, waveform and
    beat/bar grid, Web Audio playback with the playhead read from
    AudioContext.currentTime (latency-corrected), a click track on the audio
    clock, snap, tap tempo, drag/tap/add with pointer events for the tablet,
    an inspector that shows inferred values resolved, violations drawn on
    the offending cue, per-lane mute, undo, a YAML view.
    Saves are text-surgical (yamledit.py): an unedited file round-trips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
    [server.py]
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2026-10-07 feat(description): one robot description, consumed by the sim and the dashboard
    description/opendubs/ holds our base, lift and head (opendubs.xml, meshes,
    dimensions.yaml, moved from sim/). description/openarm/ holds the arms:
    the MJCF and collision meshes vendored unchanged from openarm_assets, the
    visual meshes decimated by tools/vendor_openarm.py (41 MB -> 6 MB, ~1.6 MB in
    git), PROVENANCE.json with both upstream commits, and the dashboard's URDF and
    chain.json.
    The dashboard's own collision-mesh copy was byte-identical to the sim's and is
    removed: frontend/assets/arm is now a symlink to description/openarm, and
    deploy.sh copies chain.json and the collision meshes to the robot as real fi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
    [1120_channel.stl, D415.stl, FL-wheel.stl, FR-wheel.stl, RL-wheel.stl, RR-wheel.stl, body_link0.stl, body_link0_0.obj]
2026-10-07 feat(choreo): the body twin — a native MuJoCo window that follows the composer
    twin.sh opens the whole robot in MuJoCo's passive viewer (under mjpython) and
    keeps it in step with the composer's playhead. The composer posts only time
    and play state (/api/playhead -> /api/twin) and serves the latest resolved
    timeline (/api/twin/timeline); the viewer samples that timeline with
    sim_preview.py's own code and extrapolates on its local clock, so seeking is
    free, network delay cannot accumulate, and the window cannot disagree with an
    offline preview. Unsaved edits reach the window too.
    Verified from the viewer's --log: play, pause, seek and an unsaved edit were
    all followed. The no-robot tripwire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
    [server.py]
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2026-10-07 notes+feat(tab5): close out the Tab5 plan — retire 1A, split audio into its own workplan
    Emma's dispositions, 2026-10-07, after talking through what was actually left.
    **1A, the Tab5 as a dashboard: RETIRED.** Dashboard features get added selectively when something
    needs them, rather than porting a working HTML dashboard onto the panel wholesale. The operator's
    tablet already serves that audience. The JPEG-streaming route stays documented in case one specific
    page is ever wanted.
    **1.5 (voice probe) and 1B (Tab5<->Thor comms) MOVED to notes/workplan-tab5-audio.md**, a new plan
    whose purpose is two-way voice. Moving them is what actually lets the Tab5 plan close -- they were
    never loose e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
    [app_face.cpp]
2026-10-07 fix(tab5-idf): states tested by named property, and the no-link face actually appears
    Two findings from the choreography session (their F11 and F12), taken here because both live in
    app_face.cpp and two sessions sweeping one file is how merge conflicts happen.
    **F11 — no more bare state indices.** Five checks compared g_state against 4, 5 and 6 directly:
    two deciding whether the head may move, two latching the fault cue, one driving the band. Inserting
    or reordering a state silently retargeted the safety behaviour. The struct comment above kStates
    already made this argument when `reserved` was converted from `state == 4 || state == 5`; these are
    the rest of that job. Now `stateFault(idx)`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
    [app_face.cpp]
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2026-10-07 feat(choreo): grippers as open 0..1, with each robot's calibration on the robot (plan 1.2)
    A gripper cue now says open: 0..1 (0 closed, 1 open), the same on both sides,
    or do: open|close. The old pos: <metres> is refused by name with what replaced
    it, so an old metre value is never silently read as a fraction. The per-side
    metre ranges are removed from cue.py: they were one robot's calibration in a
    committed file.
    grippers.py loads a robot's calibration from /etc/opendubs/grippers.yaml (or
    $OPENDUBS_GRIPPER_CAL), refuses one with no real travel or the wrong units,
    and converts both ways for the runner and teach-by-capture. The repo holds
    only a template (grippers.py template) and a made-up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
    [gripper_calibration_fixture.yaml]
2026-10-07 feat(choreo): the earliest legal time for an arm pose — teach and re-time use it (plan 1.3)
    Show.earliest_time() answers when an arm can arrive at a pose at or after a
    requested time: from the end of the keyframe it actually follows (re-solved
    if moving later passes another keyframe), by the binding joint's average-speed
    cap, with the later time that also avoids the eased-peak warning and a note
    if the next keyframe would then be too fast. It lives in cue.py so there is
    one copy of the speed rule.
    The composer's teach now places a captured pose with it, and says so -- with
    the binding joint and the reason -- whenever the pose cannot be at the
    playhead. The inspector gains '⇤ soonest', w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
    [server.py]
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2026-10-07 fix(tab5-idf): the simulated e-stop is two events, not one
    An e-stop is TWO events: the head sets a PENDING request and resends it, and the robot's later
    `E_STOP` report is what clears that flag. The twin simulated only the first, so pressing `e` moved
    the banner and left the face on whatever state it already had.
    Now: request -> PENDING, the simulated robot confirms after 1.2 s, the confirmation clears the
    pending flag exactly as net.cpp does, and `SIM ESTOP OFF` re-arms to SAFE_IDLE. One key walks the
    whole sequence. Verified over UDP: `estop=PENDING` -> `state=E_STOP estop=off` -> `SAFE_IDLE`.
    The twin does this because a twin should behave like the head, and that is all. On the robot t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
    [net.cpp, sim_inputs.cpp, sim_inputs.h]
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2026-10-08 feat(tab5-idf): the desktop twin shares its picture, for the robot's MuJoCo body twin
    For choreography plan 2.5: the MuJoCo body twin shows the face on the robot's head, so one window
    shows the whole robot. It cannot draw the face itself -- a second drawing would drift from this
    one, which is what a twin exists to prevent -- so the twin shares what it has ALREADY drawn.
    - frame_tap.{h,cpp}: off unless OPENDUBS_FACE_FRAMES names a file (a run-time switch). Then, at
    most ~15 times a second and only after a frame that changed (LV_EVENT_REFR_READY), the frame
    is scaled to 320x180 RGB888 into that file, memory-mapped, behind a sequence number that is
    odd mid-write, so a reader never shows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
    [app_face.cpp, frame_tap.cpp, frame_tap.h]
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2026-10-08 feat(tab5-audio): Phase B transport — the clip's trip to the Thor, tested against a fake one
    Phase B of notes/workplan-tab5-audio.md: resample, accumulate, frame, send, parse the reply. The
    head's real framing code is exercised end-to-end over a real socket by `./build.sh loopback`,
    with no board and no robot.
    TESTED AGAINST A DIFFERENT PROGRAM, which is the point. The in-process self-test cannot catch a
    framing mistake, because a bug and its mirror image in the same file agree with each other.
    tools/fake_thor.py is written to the Phase C contract rather than to this code and REJECTS
    anything that misses it. Verified it has teeth by attacking it with the mistakes the head could
    actually m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
    [mic.cpp, net_cmd.cpp]
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2026-10-08 feat(tab5-audio): audio down, streamed — and the robot becomes interruptible
    Phase B's remaining half. TTS arrives in chunks and reaches the speaker as it arrives, which the
    plan asked for ("streamed, not file-at-a-time, or the robot pauses mid-sentence").
    THE BLOCKER WAS NOT REAL, and reading the vendor source rather than the header dissolved it. I had
    recorded that hal.h has audioPlay() and no stop, so a reply could not be cut short. True -- but
    hal_audio.cpp shows audioPlay has TWO paths, and only the async one copies into a task and refuses
    while busy. The SYNCHRONOUS path is a bare blocking i2s_write with no mutex and no busy check at
    all. So a reply can be fed chunk by chunk, and ST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
    [cues.cpp, cues.h, mic.cpp]
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2026-10-08 tune(tab5): the head's slew limit 25 -> 70 deg/s, so a nod lands on the beat
    Decided by the maintainers on 2026-10-08, after the first live GAZE run: every move landed and
    nothing clamped, but nods read as a sway rather than as rhythm.
    THE MEASUREMENT THAT SET THE NUMBER. A 16 degree nod DOWN AND BACK is 32 degrees of travel, and at
    123 BPM a beat is 488 ms. At 25 deg/s that is 1.28 s -- two and a half beats for one nod. 70 deg/s
    needs 457 ms and fits, with 31 ms of slack.
    60 WAS PROPOSED AND IS NOT ENOUGH, which is worth recording because the mistake is easy to repeat:
    that figure treats a nod as a one-way 16 degree move (267 ms) and omits the return leg, which puts
    the real thing at 533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
    [pantilt.cpp]
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2026-10-08 tune(tab5-gaze): the lease compared unsigned, so the freshest command read as expired
    GAZE did not work on the robot: it replied correctly, reported itself as owner, and moved the head
    6 degrees in 2.2 s where 60 should take 0.86 s.
    `nowMs` is captured ONCE at the top of the render frame. A GAZE arriving on cmdTask midway through
    that frame stamps g_gazeMs with a LATER time than the frame it is judged against, so
    `nowMs - g_gazeMs` is a small NEGATIVE number -- about 4.29 billion unsigned -- which is not less
    than the lease. The freshest possible command read as the most expired one. And the expiry branch
    then set g_gazeMs = 0, so one unlucky frame did not skip a tick, it DESTROYED the leas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
    [pantilt.cpp]
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2026-10-08 shows: Robotic smile moves on single beats, at the measured arm speeds
    The arm parts are rewritten for the caps measured on 2026-10-08. Each
    move's eased peak stays under its joint's cap, so nothing warns:
    - waves: 30 deg per beat (61 deg/s average), right hand bars 5-6, left 7-8
    - forearm pumps: 25 deg per beat, alternating arms, bars 9-12
    - new "raise the roof": both shoulders 20 deg per beat, bars 13-14
    - the reach on bar 15 and rest by bar 17, as before
    The head nods on every beat (16 deg in 0.23 s at its 70 deg/s) and looks
    at each waving hand. The face's every-bar changes, the earcons and the
    33 s length are unchanged. It validates against the fixture and against
    opendubs2's own limits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
    [robotic-smile.yaml]
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2026-10-09 description: generate the ROS URDF from dimensions.yaml, with the head swappable
    robot_state_publisher needs a URDF and the model was MJCF only. Rather than hand-author a
    second copy of the geometry, gen_urdf.py reads a new ROS FRAMES section of dimensions.yaml
    and writes opendubs.urdf; `--check` fails if the URDF is stale or the TF tree is not one tree
    rooted at base_link. A path-filtered workflow runs it on every PR that touches the model.
    - base_link: the centre of the wheel rectangle at axle height (decided, workplan L.1), with
    base_footprint on the floor and the CAD datum as a fixed child, so CAD coordinates are
    used as-is below it.
    - Joint names match the MJCF (zaxis, head_pan, he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
    [opendubs.urdf]
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2026-10-09 fix(tab5-face): the robot network's credentials were committed as string literals
    firmware/tab5_face/src/main.cpp passed the robot network's SSID and its pre-shared key straight to
    WiFi.begin() as two string literals. They have been in the repository since 4d64282 (2026-09-03),
    in a repository with write access for the whole team. Raised by the Hygiene lane's first sweep as
    S1.
    It now follows the pattern the IDF head already uses (app_face/net.cpp): credentials are COMPILED
    IN only when deliberately supplied for a provisioning build, and otherwise the radio reconnects
    with whatever a previous provisioning left in NVS. A bare WiFi.begin() is the fallback, so the
    retired tree stays usable as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
    [main.cpp]
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2026-10-09 feat(arms): the teleop bridge's refusals reach the tablet (plan 0.13)
    A grip refused because CH5 is not MANUAL, a lost hand, a refused home and
    an unreachable target appeared only in `journalctl -u opendubs-teleop`, so
    an operator gripping with CH5 OFF saw nothing happen and no reason.
    The bridge now reports each hand's current condition, with its
    troubleshooting code, as JSON over localhost UDP 5011 (org openarm fork,
    status.py). Here:
    - backend/openarm.py: a listener thread keeps the latest report; older
    than 1.5 s reads "the bridge is not reporting", never "all clear".
    Bound without SO_REUSEADDR, so a second listener fails instead of
    silently splitting the datagrams. A gripper act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
    [arms.yaml]
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2026-10-09 feat(face): spinning asset skins can occasionally counter-rotate
    A spinning image or video skin can break out of a together-spin into opposite directions for a few
    seconds and then ease back, at random intervals. Requested by the maintainers after seeing a
    spinning-object skin. Default OFF, so every existing library entry is unchanged.
    "counter": { "every_s": [8, 20], "hold_s": [2, 4], "ease_s": 0.9 }
    THE PART THAT MADE THIS MORE THAN A SIGN FLIP. The spin was `rate * t` -- an angle computed from
    absolute time, which is exact and drift-free but can only express a CONSTANT rate. Flipping its
    sign teleports the object to a mirrored orientation, which is precisely the snap this feature
    ex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
    [asset.js]
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2026-10-09 docs(arms): ARM_CAN_NOT_READY names its commonest cause, an e-stop, and the fix order
    From an incident on 2026-10-09: after an e-stop, reactivation failed with
    "CAN links not ready". The arms are powered from the drive bus behind the
    contactor, so with it open the links go to error or bus-off, and our link
    service sets no restart-ms, so they never recover by themselves. Fix in
    order: re-arm, confirm the contactor is closed, restart both links, then
    activate. Restarting first just falls back to bus-off. See: contactor-open.
    Suggested by the Docs and BOM lane.
    [arms.yaml]
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2026-10-09 docs(arms): correct ARM_CAN_NOT_READY -- the links stay in bus-off after the e-stop clears
    Corrects the previous commit's account. The sequence was: arms down, then
    the e-stop, then the e-stop cleared and the contactor closed, then
    activation failed. The links went to bus-off while the arms were unpowered
    and did not recover when power returned.
    - The entry no longer names a re-arm control.
    - The unverified claim that restarting the links early falls back to
    bus-off is dropped.
    - ARM_MOTOR_FAULT's power-cycle step now restarts the links too, instead
    of naming a re-arm.
    [arms.yaml]
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2026-10-09 docs(arms): ARM_CAN_NOT_READY -- an e-stop CAN leave a link in bus-off, so can a loose connector
    The commonest-cause claim overreached. On 2026-10-08 ACTIVATE alone
    recovered after an e-stop. On 2026-10-09 one link was bus-off, and loose
    CAN connectors were found on that arm. The entry now says what was seen,
    and adds the status check before activating.
    [arms.yaml]
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2026-10-11 Asset skins: the head protocol's SPIN, and both eyes cross zero together
    Gives asset skins the `spin(mode, holdS)` the Tablet lane asked for, so a show
    can drive a counter-spin on a beat instead of waiting for the autonomous
    schedule to happen to fire.
    Three things this had to get right, each one a promise to another lane.
    SYMMETRIC. A single split factor s runs 0 (together) to 1 (counter), and the
    eyes take omega*|1-2s| and omega*(1-2s). At s = 0.5 BOTH are stopped. The
    earlier version reversed only the right eye, which read as one eye
    misbehaving rather than as one gesture -- and it also left "the cue's time is
    the zero crossing" true of only one eye. Measured: both cross on the same
    fra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
    [asset.js]
2026-10-11 Prove the wire reaches the skin, and refuse a mode rather than misread it
    Merged main (#161 landed, so protocol.js now dispatches SPIN) and closed the
    gap that left: the conformance suite runs SPIN against a CODE skin, whose
    `spin` is undefined, so the guard in protocol.js skips and nothing there ever
    proved the dispatch reaches an asset skin -- or that it hands over what the
    skin expects. test_spin.mjs now drives the real parser into a real asset skin:
    a `SPIN COUNTER 3` line off the wire eases it through zero at 0.450 s, and the
    mode arrives lowercased with the hold as a number.
    That test immediately earned itself. An un-lowercased mode did not fail: it
    fell through to the `together` bran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
    [asset.js]
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2026-10-11 Name the minimum ease, since two lanes now mirror it
    The traversal was clamped by a bare `0.05` whose only comment described the
    line it was on. It is not an implementation detail: library.py accepts
    `ease_s: 0` -- it refuses only negatives and non-numbers -- so a VALID library
    entry can ask for an instant reversal, which protocol v3 says the wire may not
    have and which is the snap this mechanism exists to avoid. The skin clamps it,
    so such an entry still crosses zero EASE_MIN/2 after receipt.
    Choreography computes its show lead as max(ease_s, EASE_MIN) / 2 to match, and
    prints which it used. So the number is now a contract between three lanes:
    named EASE_MIN, with the consequence of changi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
    [asset.js]
2026-10-12 Composer: add, choose, remove and delete a show's music from the library
    The timeline had no way to add or delete music. Now:
    - music: song: <id> names a song in the show library (file: still works;
    both together is a problem). Checked against the library like a skin,
    a notice where there is none, its hash in the export.
    - The composer's music dialog: choose a library song or none; add one by
    drop or pick (wav/mp3/ogg/flac/m4a, type checked by content, 80 MB cap,
    source and licence required, through library.py's rules, never into the
    repo); remove from the show (the reference only); delete from the library
    behind a confirm, refused while a show still names it, listing them.
    - On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
    [server.py]
2026-10-12 Composer: an upload never fails as a bare "Load failed"; the server reads every song's length
    A user's MP3 failed to add with only "Load failed" — Safari's word for a
    request that got no answer. Reproduced in WebKit: a refused connection (the
    composer stopped or restarting under an open page) reads exactly that. The
    user's file itself adds fine. Now:
    - the editor turns a request with no answer into a sentence (who did not
    answer, what the browser said, what to do), and keeps an upload's error
    in the dialog, not only in a toast; a file it cannot read is said too;
    - the server reads a song's length from the file for every type (MP3 with
    any ID3v2 tag and a Xing/Info/VBRI header or CBR,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
    [server.py]
2026-10-12 Export the asset params' defaults, so the validator pins to the engine
    `library.py` refuses an entry with an unknown param key at authoring time,
    because `spinn_dps: 90` would otherwise silently do nothing at all. That check
    needs the list of valid keys, and a validator keeping its own copy would drift
    from the engine -- so the list is now exported from the engine that defines it,
    as a frozen ASSET_PARAM_DEFAULTS, and a sync test can fail CI when the two
    disagree. Adding a param here then tells library.py about it.
    No behaviour change, and not merely asserted: the hoisted object compares
    identical, key for key and value for value, with the literal on main.
    Requested by the Choreography lan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
    [asset.js]
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2026-10-12 Shows: sweep the whole show for self-collision, and refuse an arm show without a current, clear stamp
    The validator checked arm TARGETS for collisions (ik.py) but not joint keyframes
    or the motion between them; an agent-written show put the arms into each other
    (-48 mm) and only a sweep on the twin caught it. Now:
    - sweep.py sweeps a whole show on motion.py's smoothed path (the robot's) against
    the twin's collision model, with the head, lift and grippers as the show has
    them: 80 ms and every keyframe, halving any interval where the joints moved
    enough to hide a dip — a bounded minimum, not a sampling accident;
    - it stamps clearance: { min_mm, at_s, between, checked_for: <motion hash>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
    [robotic-smile.yaml]
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2026-10-12 Skins: `layout: full`, a still card across the whole face
    An asset skin whose params say `layout: full` is drawn ONCE across the design
    area, aspect-fit and centred, instead of once per eye. For a photo a show pops
    up for a bar with `SKIN <id>` and takes away with `SKIN default`. Requested by
    the Choreography lane, approved by the maintainers.
    IT IS A CARD, NOT A FACE, which is a trade rather than an oversight: gaze,
    blink, the emote's shaping, spin, mirror and the counter-spin are all ignored
    while it is up, so the face has no expression and does not blink at all. A
    photo that squashed vertically every few seconds would read as broken. Agreed
    with Choreography, which is adding a validator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
    [asset.js]
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2026-10-12 fix(stamplc): the lift answers MAST CMD in AUTO with the deadman held
    In AUTO the lift's intent was gated on armOK, which requires a fresh DRIVE
    command (rosFresh). Nothing sends DRIVE while drive_bridge is held off, so
    every MAST CMD from a show was silently zeroed, contradicting the comment
    that the Z-axis "deliberately does NOT depend on the DRIVE heartbeat".
    The lift now has its own gate, mastOK: MANUAL, or AUTO with the deadman
    held, plus the same contactor / e-stop / RC-link / loop-ready terms as the
    wheels (factored into motionOK so the two cannot drift). armOK and every
    drive path are unchanged. The 250 ms intent expiry, the pinch guard and
    the stick-wins-in-MANUAL rule are untouche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
    [main.cpp]
2026-10-12 research: voice and LLM for the robot (on-Thor LLM, tablet audio, wake word, Claude API)
    A decision-first study, notes/design/voice-llm-research.md: an on-device LLM on the
    Thor (runtimes, models, cited single-stream numbers, memory and GPU budget beside the
    stack), STT/TTS/VAD options and licences, audio to and from the Galaxy tablet through
    the kiosk's WebView, push-to-talk and a later on-tablet wake word, a proposed CONVO
    head-protocol message, the Claude API path with offline fallback and cost, failure
    modes and a phased plan. Nothing in it was measured on a Thor or the tablet; every
    number is tagged measured, cited or estimated.
    tools/voice-bench/: benchmark and prototype scripts, none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
    [safe_tools.py]
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2026-10-13 neck_dial step one: the protocol half, before a single servo is wired
    The NECK, on an M5Dial (ESP32-S3), after the tablet took over the face. It
    replaces the Tab5 as the neck AND the AtomS3R in the plan, so nothing here is
    worded as temporary.
    STEP ONE ON PURPOSE: Wi-Fi, PING answering kind=neck, and NECK answering
    honestly. There is no pan/tilt wired, and the protocol already defines
    `ERR neck no pan/tilt fitted` for exactly that -- so conformance --neck can be
    run against this before a servo is connected, and the protocol half is proven
    with no hardware risk. When the servos arrive the only new thing is the servos.
    Everything else the neck owes -- GAZE, PARK, TOUCH, TRACK, TOF, I2CSCAN,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
    [main.cpp]
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2026-10-13 neck_dial: write first, reset only if that cannot connect
    The flashing helper had the obvious order -- reset into download mode, then
    write -- and the obvious order is WRONG when the board is ALREADY in download
    mode, because the reset kicks it straight back out.
    That is not hypothetical and it cost most of an afternoon. The maintainers put
    the Dial into download mode by holding its button while plugging it in; the
    helper's first act was a usb_reset that threw it out again; and every write
    after that failed while the board still looked perfectly healthy on USB. The
    maintainers spotted it from the outside -- "I think you're kicking it out of
    jtag mode and not realizing" -- which is exactly w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
    [flash.py, pio_no_stub.py]
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2026-10-13 neck_dial: it boots, and the first boot crashed
    FLASHED AND RUNNING, from the Thor's USB. It reports on its 10 s timer:
    neck: fw=0000000000000000
    wifi: ssid=(unset) state=down ip=- rssi=0
    udp: port=4242 packets=0
    pantilt: not fitted yet (step one: protocol only)
    THE FIRST IMAGE CRASH-LOOPED, which is exactly what a minimal first image is
    for. `assert failed: xQueueSemaphoreTake queue.c:1709` on every boot: WiFi.mode
    was only called when there were credentials, so a board with none never
    initialised lwIP, and g_udp.begin() then asserted inside FreeRTOS. A fresh
    board has no credentials BY DEFINITION, so that was the one path guaranteed to
    run first -- and the one I had reasoned was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
    [main.cpp]
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2026-10-13 neck_dial: pan/tilt live, OTA, TOF suppressed, and the tilt limits read from NVS
    The 8Servo is on Port A and answering at 0x25, both channels in servo mode, so
    the ported control law now drives the real head: GAZE sets a target and the
    firmware owns the slew limit, the bounds and the arbitration, exactly as it did
    on the Tab5.
    TOF IS SUPPRESSED, as the maintainers asked, and deliberately as
    `ERR tof not fitted` rather than `ERR unknown`. A caller can then tell "this
    neck has no ToF" from "this neck never heard of ToF"; falling through would
    have lost that distinction for nothing.
    OTA IS IMPLEMENTED EARLY, out of the planned order. The Dial is now on the 24 V
    bus and about to lose its USB c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
    [flash.py, main.cpp]
2026-10-13 neck_dial: reply to OTA before restarting, and stamp the build sha
    Two fixes, both found by actually proving OTA rather than assuming it.
    THE OTA REPLY NEVER WENT OUT. The handler called ESP.restart() itself, which
    killed the board before the caller had sent the reply -- so a SUCCESSFUL update
    looked exactly like a dead one. The first end-to-end test showed it plainly:
    the image downloaded (HTTP 200 in the server log), the firmware changed, and
    the flashing tool saw NO REPLY. A tool that cannot tell success from bricked is
    worse than one that is merely slow. The restart is now scheduled 400 ms out and
    happens in the loop, after the reply has gone.
    THE BUILD IS STAMPED with the commit it ca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
    [main.cpp, pio_build_stamp.py]
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2026-10-14 feat(voice): Parakeet and Kokoro, English only, no GPL
    The project team decided (2026-10-14): English only, and no GPL component ships. Kokoro's default
    install brings in espeak-ng and phonemizer (both GPL-3.0-or-later) through misaki's [en] extra,
    so this keeps them out and proves it:
    - speech.py: Parakeet-TDT-0.6B-v2 (int8 ONNX) on sherpa-onnx, and Kokoro-82M through kokoro's
    own KPipeline, American English only. Both on the CPU until gate L-4 says otherwise. A backend
    whose weights are missing refuses and says how to fetch them.
    - kokoro and misaki installed with --no-deps; their other dependencies listed without the GPL
    ones. misaki pinned to a commit of its main branch: the 0.9.4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
    [fetch_models.py, no_espeak.py, server.py, speech.py]
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2026-10-14 feat(voice): the local brain, Qwen3-30B-A3B on vLLM, desk-tested (workplan 1.5)
    The project team chose Qwen3-30B-A3B-Instruct-2507 as the local brain, with Qwen3-4B-Instruct-2507
    as the fallback if gate L-3 fails (V-O3). This is the desk half of step 1.5:
    - models.lock.json: both models pinned (repository at a commit, every file by SHA-256 or git blob
    id), marked optional so fetch_models.py fetches them only when named. The 30B is Red Hat AI's
    4-bit W4A16 build (16.7 GB): BF16 (~61 GB) and FP8 (31 GB) do not fit the <= 24 GiB share.
    - llm_profile.py: one serving profile per model (served name, tool parser `hermes` from the
    models' own Hermes-style chat template, 8,192 context, 2 seque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
    [brains.py, conversation.py, fetch_models.py, llm_profile.py, server.py]
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2026-10-15 face: engine hooks for the offline video render
    What an offline render of a show needs from the face engine, so that
    re-rendering after a one-line fix differs by that line and nothing else.
    ONE SEEDED RANDOM SOURCE. engine/rng.js: `setRandom(fn)` and `random()`.
    The face is full of chance on purpose -- blink intervals, saccades, the
    gaze break, which emote comes next, microsaccades, an asset skin's
    counter-spin schedule -- and that is what stops it reading as a loop; it
    also means the same show rendered twice is two different videos. Every
    one of those draws now goes through `random()`: the four in face.js and
    `pick()` in skins/asset.js. A renderer calls `setRandom` once with its
    own seeded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
    [asset.js]
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2026-10-15 face: record that a repeatable render uses image and code skins
    A video library skin cannot be deterministic in an offline render: it
    resolves ready on `canplay`, so its first frame is there, but which
    frame is up on a later draw follows the wall clock, which the render
    does not control.
    Settled with the Choreography and Tablet lanes rather than left as a
    caveat, because the alternative was real and was weighed: seeking the
    video per frame (`currentTime`, then awaiting `seeked`) would make it
    deterministic at the cost of making every render much slower, for the
    one skin type that needs it. Choreography's render.py warns when a show
    uses a video skin, so an author meets the limit where they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
    [asset.js]
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2026-10-15 face: show charging — purple, and the edge ring as a charge gauge
    The robot never showed charging at all. The dashboard sent SAFE_IDLE
    while it charged, and CHARGING's teal (0x00c4a8) sat so close to
    SAFE_IDLE's green (0x2ecc58) that it would not have registered if it
    had been sent. The Tablet lane is fixing the first half by sending
    STATE CHARGING and a new BATT message; this is the face's half.
    PURPLE (0x6d30e0), the maintainers' pick, matching the PRISM, in
    vocab.js and the Tab5's kStates so the two heads cannot disagree.
    Deeper than the ARMED overlay's violet by a measured 15 points of
    lightness, because HUE IS NOT AVAILABLE. With seven state colours the
    circle is full -- green, cyan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
    [app_face.cpp]
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2026-10-15 neck: TILT over UDP, and NECK reports the tilt band
    Commissioning the tilt range needs two things the Dial could not do.
    TILT WAS SERIAL-ONLY, which was right while the board was on a bench
    with a USB cable. It is on the robot now, powered from the 24 V bus with
    no USB, so the only way to commission it was a cable onto a live board
    -- and CLAUDE.md is explicit that host->device serial writes here are
    unverified, so that path cannot tell a refused command from a broken
    one. The same parser is now reachable over UDP as well; the validation
    is unchanged (0 <= min < max <= 180) and is the safety, since the band
    is what every target is clamped to.
    NECK COULD NOT REPORT THE BAND, so "the robot i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
    [main.cpp]
2026-10-15 neck: PING reports the real pan/tilt, not a hard-coded zero
    PING answered pan=0.0 tilt=0.0 owner=none whatever the head was doing.
    That was honest when it was written -- no servos were wired, and
    inventing a position would have been worse than admitting to none. The
    servos were fitted later and nobody came back to it.
    Found during the tilt commissioning: NECK reported pan=61.2 tilt=95.4
    and PING, one line later, said 0.0/0.0. A field that once meant "we do
    not know" had quietly come to mean "we do know, and this is wrong",
    which is the worse of the two. With no servos fitted it still answers
    zeros, because then the old meaning is the true one.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
    [main.cpp]
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2026-10-16 neck: CHEST, the chest light's pulse
    A goBILDA RGB Indicator Light (3118-0808-0002) behind the chest plate,
    on the neck's 8Servo channel 2 -- tilt is 0 and pan is 1, so the driven
    channels stay contiguous. Head protocol v7, agreed with the Tablet lane.
    CHEST <us> -> OK chest <us> 500..2500, the pulse the light gets
    CHEST OFF -> OK chest off
    bad args -> ERR chest <us 500-2500> | OFF
    no 8Servo -> ERR chest not fitted
    THE PULSE IS THE COLOUR, published by goBILDA: 500 off, 1100 red, 1200
    orange, 1300 yellow, 1400 sage, 1500 green, 1600 azure, 1700 blue, 1800
    indigo, 1900 violet, 2500 white, a smooth gradient between, BELOW 1100
    OFF and ABOVE 1900 SOLID WHITE. No brightnes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
    [chest.cpp, chest.h, main.cpp, pantilt_host_test.cpp]
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2026-10-16 description: no chassis GPS; the tablet's GNSS and rear camera join the head
    Corrections from the user (2026-10-15):
    - The robot has NO GPS fitted. dimensions.yaml no longer declares a chassis gps_link (it cited a
    Holybro M9N "mounted per docs/build/lidar.md"). The robot's GPS is the head tablet's GNSS:
    /tablet/fix, frame tablet_gps_link on the head, now first-class in the contract (L.6) and a
    global-tier source in docs/localization-fusion.md.
    - The tablet's rear camera has a full backward view: tablet_rear_camera_link joins
    tablet_front_camera_link (renamed from tablet_camera_link). Both cameras are on demand,
    /tablet/camera/front and /tablet/camera/rear.
    - gen_urdf.py: `optical: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
    [opendubs.urdf]
2026-10-16 description: the chassis GPS is planned, not yet fitted
    Correction from the user: a chassis GPS (the Holybro M9N on the front lidar stack) WILL be fitted;
    this robot just hasn't had it fitted yet. So it is restored in dimensions.yaml as fitted: false,
    PLANNED, NOT YET FITTED, rather than deleted. Once fitted it is the primary GPS; until then the
    head tablet's GNSS (/tablet/fix, tablet_gps_link) is the only one, and the fallback after (L.6,
    docs/localization-fusion.md). The build docs' GPS rows are correct as the design.
    [dimensions.yaml]
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2026-10-19 fix(voice): fetched weights are readable by the voice container
    fetch_models.py writes each file through a mkstemp temp file (mode 0600) and kept that mode, so
    weights fetched as root were unreadable by the voice container's non-root user. Found while
    fetching the Qwen weights onto opendubs2 (vLLM runs as root, so those were not affected). Files
    are now 0644 after they verify; the test checks it and fails without the fix.
    [fetch_models.py]
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2026-10-19 fix(voice): fetch_models resumes a dropped download instead of failing
    On opendubs2 the CDN ended the connection for the 30B model's first 5 GB shard at 1.66 GB. The
    size check refused it, rightly, but with no retry the whole fetch failed. Downloads now keep a
    fixed-name partial file, resume it with an HTTP Range request, and retry up to six times with
    backoff, asking for the URL again each time so an expired redirect is renewed. A file that does
    not verify is still deleted, never kept or resumed. Tests cover a connection ended mid-file, errors
    then success, and a server that never finishes.
    [fetch_models.py]
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2026-10-19 fix(voice): fetch_models --check never writes (run.sh mounts the weights read-only)
    The first deploy of the voice container on opendubs2 was refused: run.sh runs
    `fetch_models.py --check` with /models mounted read-only, and check mode still rewrote the G2P
    model's refs/main at the end, so it failed with Errno 30 although every file and the ref were
    correct. Found by the Thor lane's deploy.
    Check mode now compares refs/main with the pinned commit and refuses if it is missing or
    different, but never writes; a real fetch writes it only when it differs. Reproduced in the
    robot's built image with the read-only mount: main's script fails there, this one passes.
    Two new tests fail on the old code.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
    [fetch_models.py]
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2026-10-19 fix(voice): the wake check finds "hey dubs" near the start, by spelling distance
    On the robot the one real "hey dubs" the spotter caught was refused by the Thor's check. The check
    needed the transcript to START with the phrase, but the 1.5 s pre-roll holds the end of whatever
    came before (often an earlier try: "Dubs. Hey dubs, ..."), and it needed one spelling of "dubs".
    Now the phrase may begin within the first six words, and "dubs" matches within one edit (Dubbs,
    Doubs, Debs, Dubz, Dub's); "doves", "dogs", "does" and "Dad" are still refused.
    [wakeword.py]
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2026-10-20 bom: the arms' CAN-FD adapter is a Pibiger SavvyCAN-FD-X2
    The robot's dual-channel CAN-FD adapter is a Pibiger USB to dual-channel CAN FD
    converter (SavvyCAN-FD-X2), not a PEAK PCAN-USB Pro FD. Name, SKU, link, note
    and price (.00, Amazon, read 2026-10-20) corrected; the row id is kept.
    Names, links and price only: no software, driver or provisioning change.
    [parts.csv]
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2026-10-20 fix(voice): never offer motion or speak emoji, held in code as well as the persona
    On the robot the model said "Let me show you a little move" with an emoji. spoken.py now gates
    every sentence the model writes, before speech: emoji, markdown and *stage directions* are removed,
    and a sentence offering or claiming motion is dropped, the first one replaced by "I can't move on
    my own; my operator controls that." The history keeps what was actually said. The persona is
    rewritten: shorter replies, plain words, no motion of any kind (and no "likes dancing shows"), and
    answer the most likely meaning of an imperfect transcript, asking to repeat only when there is no
    sensible reading.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
    [conversation.py, spoken.py]
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2026-10-20 fix(studio): resolve black screen with frame bounding, ResizeObserver, and continuous WebGL rendering
    [server.py]
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2026-10-20 fix(planner-ui): make WebGL context creation resilient, use Lambert materials, and add client telemetry
    [server.py]
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2026-10-20 fix(planner-ui): make SSIK and sequence keyframes arm-aware with automatic J1-J3 mirroring
    [server.py]
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2026-10-20 feat(voice): the wake phrase is "Hey OpenDubs"; the Thor check accepts its spellings
    The project team lengthened the phrase from "hey dubs" (about six phonemes, spotted only close to
    the face) to "Hey OpenDubs", spoken "hey open dubs". The Thor's transcript check accepts "hey open
    dubs", "hey opendubs", "open dubs" with the hey lost, and run-together forms, each word within one
    spelling edit. "Hey dubs" stays accepted on the Thor only, for a real phrase whose middle word
    Parakeet dropped; the page no longer spots it, so this costs no false wakes. Near misses ("hey
    doves", "open the door", "hey, open the window") are still refused. ready.wake.keyword is now
    "hey opendubs".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
    [conversation.py, server.py, vad.py, wakeword.py]
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2026-10-20 fix(voice): match /api/status/spoken as built (#433); keep routine ids readable
    The endpoint sends a show's routine id ("herb_oreo_v2"); underscores became nothing and the name
    ran together. They become spaces now. A test holds the endpoint's real shape: caption words
    ("Charging 82%"), a routine id, the arms null when no recent probe, a fault code, "no router".
    [robot_facts.py]
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2026-10-20 fix(voice): the robot answers about its battery: a live snapshot was refused as from the future
    Asked for its battery by Talk, the robot said its status tool was not responding. Two causes, both
    reproduced against the robot's own model:
    - robot_facts refused any snapshot whose ts was ahead of now, and the dashboard rounds ts to 0.1 s,
    so a live snapshot was often a few ms "in the future" and thrown away: "cannot be read".
    - The model did not call robot_status at all; primed by the quoted "I can't tell right now" in the
    persona and the tool result, it answered with that phrase straight away.
    Now a snapshot up to 1 s ahead is live; every question carries the dashboard's facts, read for it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
    [brains.py, conversation.py, robot_facts.py]
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2026-10-21 fix(planner): isolate keyframe sequences per arm and ensure mirrored collision-free presets
    [server.py]
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2026-10-21 feat(choreo): integrate CBiRRT and cuRobo motion planners into choreography composer
    - Add planner selection (spline, cbirrt, curobo) to choreography cue schema and validator
    - Implement arm_planner_bridge to bridge choreography timelines with CBiRRT and cuRobo backends
    - Add API endpoints GET /api/planners and POST /api/arm/plan
    - Update composer UI with Motion Tool & Routing card, planner selector, and reach target solver
    - Add offline compiler support in ik.py for per-cue collision-free planning
    - Add unit tests in test_arm_planner_bridge.py
    [server.py]
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2026-10-21 description: place both RPLIDARs from CAD, with their measured yaw
    laser: datum (554.38, 0, 241.3) mm, yaw 180. laser_rear: (-199.578, 0, 241.3) mm,
    yaw 0. Positions from CAD (centreline; the beam window is not modelled, so z is
    approximate). Yaw from the scans: each unit is blind in a ~120 deg arc centred on
    its 0 deg, where the frame sits inside range_min, and the motors face the datum.
    The dashboard's LIDAR view, confirmed correct at the robot, encodes the same.
    The earlier assumption (rear 180, front 0) was reversed.
    [opendubs.urdf]
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2026-10-22 neck: HOLD on the knob, a status badge on the screen, TOUCH HOLD (head protocol v9)
    The user's design for the neck Dial (head-ownership.md, rewritten for the Dial):
    - HOLD: the knob turned one way, three detents within a second, holds the head where it is;
    the other way releases. Tracking, shows, touch and RC don't move a held head. Software and
    the dashboard use the same hold: HOLD / HOLD HERE / HOLD <pan> <tilt> (slewed, clamped like
    GAZE) / HOLD OFF. A release is announced for 3 s (screen, NECK hold=releasing, a dashboard
    notice) before the head may move. RAM only: a reboot always comes back released. Pure
    compute in neck/hold.{h,cpp}, host-tested with the control law.
    - The sc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
    [badge_screen.cpp, badge_screen.h, hold.cpp, hold.h, main.cpp, pantilt_core.cpp, pantilt_core.h]
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2026-10-22 feat(arms): name the arm whose CAN link is in error, and restart it from the tablet
    On 2026-10-21 a loose left-arm CAN cable left arm_left ERROR-PASSIVE with its motors silent.
    openarm-up restarted the link once (A7), the motors stayed silent, the hardware's activation
    check refused -- and the only words the operator saw were "hardware is 'inactive', not
    active": the reason was in the arm stack's log. Recovery needed a shell.
    - openarm-motors links: each arm's link as key=value, from ip alone (nothing on the bus).
    - openarm-up: a refused activation says which arm, whether any motor answers, and what its
    link is ("Left arm: no motor answers. Its CAN link is in error (ERROR-PASSIVE; ...)"),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
    [arms.yaml]
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2026-10-22 public prep: no vendor meshes, no personal account name in the ROS units
    L3: description/opendubs/meshes/1120_channel.stl (vendor CAD, never placed)
    is deleted. D415.stl (the camera maker's CAD) is replaced by the camera's
    envelope, an eight-vertex mesh written into opendubs.xml at the same CAD
    extents (20.05 x 98.86 x 23.0 mm; the datasheet's 20 x 99 x 23). It keeps the
    mesh name d415, so sim/scene.py finds and places it as before: scene.py
    --check, the Tab5-head invariants and the choreo tests that load the model pass.
    N2: the ROS units and the sudoers rule name their account as @OPENDUBS_USER@ /
    @OPENDUBS_HOME@. provision-ros.sh renders them from the robot:
    OPENDUBS_SERVICE_USER in /etc/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
    [1120_channel.stl, D415.stl]
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2026-10-22 StamPLC: accept only signed firmware updates (ECDSA P-256), signed on the Thor
    The OTA command is unauthenticated UDP, so the image must prove it is ours.
    - Board: otaHttpPull fetches <path>.sig, hashes the image as it streams into
    the inactive slot, and checks the signature against the compiled-in public
    key BEFORE Update.end() makes it bootable. Bad, missing or keyless means
    Update.abort(), "[OTA] REJECTED: <why>", and the current firmware keeps
    running. A build with no key refuses every OTA (fail closed). The [NET]
    line reports otakey=<id|none>. src/ota_verify.cpp is plain mbedTLS (md/pk,
    the same in 2.28 on the board and 3.x on a laptop), so it is host-tested.
    - Thor: softwa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
    [main.cpp]
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2026-10-22 signed updates for every board: one shared check, one signing step, one key
    The neck Dial gets signed updates too, so the check moves to a library both
    boards link, and the signature names the board.
    - firmware/common/ota_verify: the shared check. ECDSA P-256 over SHA-256 of
    "OPENDUBS-FW-SIG-1" \0 <board> \0 <image>, so a StamPLC image fails on the
    Dial (both are ESP32-S3s). It trusts up to two keys (a rotation window) from
    the committed keys/ (tools/ota_keys.py, --check), and runs a known-answer
    self-test at boot. Linked into each firmware as lib/ota_verify -> ../../common
    (no platformio.ini change; resolves in the repo and on the robot).
    - software/stack/firmware-signing/sign-fi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
    [main.cpp]
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2026-10-22 StamPLC: per-robot calibration moves to src/robot_config.h; main.cpp deploys normally
    main.cpp carried each robot's drive calibration inline, so deploys skipped it,
    and any change to it (the signed-update check included) never reached a robot.
    - src/robot_config.h (per robot, git-ignored, never deployed) holds kDriveCh,
    kDriveInvert, kStrafeInvert, kEscNeutralUs, kEscSpanUs, kEscSlewUs,
    kEscRevDwellTicks and the lift relays; src/robot_config.h.example documents
    each (worked-example values). main.cpp includes it and will not build without
    it. kStrafeInvert is new in the repo (opendubs2 had it inline); default 1.
    - tools/make_robot_config.py makes a robot's robot_config.h from its old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
    [main.cpp, make_robot_config.py]
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2026-10-22 Address safety review: fail-closed telemetry, 30mm clearance, hitl-only planner bridge, port 8095
    - Revert ik.py 15mm clearance override back to origin/main CLEAR_MIN_MM (30.0 mm)
    - Remove direct ROS2/SSH/Docker hardware execution bypass from sim/planner; all physical robot motion is mediated through software/choreo/runner.py
    - Enforce fail-closed safety semantics in get_robot_safety_state (requires deadman=True, estop=False, ch5=AUTO, motion_power=True, no faults)
    - Use dynamic joint limits from cue.load_limits with MARGIN_DEG, speed caps from cue.SPEED_CAP_DEG_S, and trip limits from cue.TRIP_DEG_S in trajectory preflight
    - Move planner studio port to 8095 to prevent collision with opendub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
    [server.py]
2026-10-22 Clean up deprecated standalone planner UI and hardware bridge
    - Remove sim/planner/ui (superseded by Choreo Composer on port 8091)
    - Remove direct hardware execution scripts (sim/planner/hardware_bridge.py and execute_hardware.py) to prevent bypassing show runner
    - Remove prototype sequence manager (sim/planner/choreo_io.py and saved_choreos/)
    - Streamline sim/planner/test_motion_planner.py to test core simulation planners (kinematics, collision clearance, CBiRRT, cuRobo, benchmarking)
    - Update docs and READMEs to direct users to Choreo Composer as the unified choreography and motion planning tool
    [server.py]
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2026-10-22 neck: a stranded neck costs a visit to fit a USB cable, not opening the head
    The neck takes a USB cable; none is routinely fitted on the robot. The Thor stack lane's review of #507,
    from the user's correction.
    [main.cpp]
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2026-10-22 feat(voice): the wake word is off by default while it is parked
    The project team parked the wake word on 2026-10-20 (0 of 3 live at a normal distance). On
    2026-10-22 the face's tracker stalled beside a spotter worker that kept failing to load, and wake
    was switched off on opendubs2 in voice.env. OPENDUBS_VOICE_WAKE now defaults to off, so a robot
    offers wake only if it sets 1, and the face never loads the spotter otherwise. The workplan records
    the parking and the open question of voice input in a crowd (array, lapel mic, a physical
    push-to-talk, an operator listen control, other wake-word approaches).
    [server.py]
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2026-10-23 description: the Galaxy tablet head from CAD; the Tab5 head retired
    The head's geometry now comes from the head assembly's own CAD: two
    binary STLs in its own frame (the neck, riding head_pan; the face, the
    tablet and its holder, riding head_tilt), placed on the robot by one
    pure translation (+423, 0, +356.875) mm that puts the export's pan/tilt
    point on the measured (423, 0, 1245.575). The axes did not move.
    - opendubs.xml: both meshes, one offset each; coarse collision boxes
    from the new extents (neck_collision, head_collision); a head_screen
    site at the tablet's front-face centre, read off the mesh.
    - dimensions.yaml: the export frame and translation as the source,
    the extents and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
    [head_face_tilt.stl, head_neck_pan.stl, opendubs.urdf, pt_screen_cover.stl, pt_tilt_body.stl]
2026-10-23 description: the Femto Bolt module on the head, from the user's mount
    The mount and the camera's 115 x 65 x 40 mm envelope (the user's own
    geometry, not Orbbec's CAD), in the head's export frame and moved by
    the same translation, both riding head_tilt.
    - femto_mount_link is where the mount's two legs enter the face's
    holder: they slide into two pockets, held on all four sides, and leave
    it at the face's top face. Read off the meshes' contact faces:
    export (55.75, 0, 940.7), (55.75, 0, 52.0) mm from the tilt axis.
    - opendubs.xml: a femto_mount body there with both meshes and a coarse
    collision box for each.
    - dimensions.yaml: the module fitted; the two sensor marks on the
    camera's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
    [femto_bolt.stl, femto_mount.stl, opendubs.urdf]
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2026-10-23 choreo: the head-up gate names the head that is fitted, and means its face is showing
    The user's word: reinstate the gate (the temporary waiver is reverted in
    the commit before), and say "head", not "Tab5", which the robot no longer
    has.
    - requires: head: true replaces tab5: true; tab5: is still read, as head:,
    with a notice, so the shows already on the robots keep working. The
    repo's shows now write head:.
    - The runner refuses with its own code, SHOW_HEAD_NOT_UP: "the head
    tablet must be showing its face page, with no video call holding it".
    It reads the dashboard's new `head` field, or an older dashboard's
    `tab5`.
    - The dashboard's probe (choreo_proxy.head_up) now says the head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
    [robotic-smile.yaml]
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2026-10-24 choreo tests: on fixtures, not on shows that move to the content repo (content split, d)
    The user's choice: hello, beat-demo and wave-and-nod stay in the
    repository as the example shows; reach, celebrate, shrug, robotic-smile,
    agent-written, christmas and halloween move to the content repo. The tests
    that used the moving shows now read test-data copies in
    tests/fixtures/shows/ (reach, celebrate, shrug, robotic-smile), and the
    runner's palette tests assemble their folder from the examples and those
    copies. Checked both ways: every choreo CI line passes with the shows in
    place and with the seven set aside.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
    [robotic-smile.yaml]
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2026-10-26 neck: REBOOT restarts the Dial (it answered "OK reboot" and did nothing)
    Found 2026-10-26, answering the Network lane's Wi-Fi rotation questions: the Dial's REBOOT replied
    "OK reboot" over UDP and never restarted; only the OTA path scheduled the restart. A caller believed it had
    rebooted. REBOOT now sets g_restartAt as OTA does: the reply goes out first, the restart follows 400 ms
    later in the loop. A head-protocol check fails if the REBOOT branch stops scheduling it, and the workflow
    now runs when the neck's main.cpp changes.
    [main.cpp]
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2026-10-27 choreo: a generated sheet's marker; the composer opens it read-only and defaults to the content folder
    cue.py accepts a top-level generated: { by, source, sha256, revision } and checks
    its shape. A sheet ENCORE makes from its own source carries it, as agreed with the
    ENCORE build session (notes/design/choreo-content-split.md, step 2).
    The composer (and so the studio) refuses to save over or rename a marked sheet,
    and refuses to write a marker into one; Save As makes an ordinary copy without
    it. The editor shows a banner naming the source and greys Save. The shows list
    skips the content folder's encore/ and tools/. server.py's --shows defaults to
    content.shows_dir() when it exists, else the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
    [server.py]
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2026-10-28 sim: the candy bucket as an optional prop, with collision
    The user's Fusion model of the bucket ARCHITECT's trick-or-treat demo
    draws candy from, for the twin, the clearance tool and pick planning.
    The export was upside down: the mesh in sim/props/ is flipped about x,
    in metres, origin at the bottom centre. It is drawn only; the bucket
    collides as a base, sixteen wall panels and a capsule handle, so the
    inside stays free for a hand. --candy-bucket [X,Y,H] adds it on a stand,
    by default with its candy at the coverage study's best right-arm spot
    (0.40 m forward, 0.20 m right, 0.90 m above the floor).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
    [candy_bucket.stl]
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2026-10-28 feat(arms): a ready pose, apart from stow, picked with ssik; the controller renamed track
    Stow (all zero) is exactly singular, and the model's own ready keyframe is nearly so, so a controller
    engaged from either has its guard swing the arm 0.75 rad while the hand barely moves. The arm now has
    a ready pose of its own: elbow bent 103 deg, the hand in front of the chest, smallest Jacobian
    singular value 0.128 (twice the guard's floor), 0.57 rad from every joint limit, 78 mm from the head
    and 188 mm between the arms at every lift height. It was picked by sampling the self-motion manifolds
    of 108 candidate hand poses with ssik and checking the best in this robot's scene.
    tools/arm_ready_pose.py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
    [controllers.yaml]
2026-10-28 feat(arms): a freedrive controller; the impedance one removed, its gravity did nothing
    freedrive is the zero-stiffness controller for hand-guiding (FREE, DEC-11): gravity from the model through
    an acceleration stage, and joint damping. In simulation from the ready pose it floats (5.6 mm and 0.011
    rad of creep in 4 s) and with gravity 0 the same controller lets the arm fall 554 mm. It is not safe on its
    own: in zero stiffness a dead stack leaves near-zero torque, so it needs the authority layer's exits.
    The task-space impedance controller is removed. Its gravity setting is ignored for a wrench-output stage:
    from the ready pose the hold sagged 43.9 mm at gravity 0, 9.81 and 19.62 alike, and w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
    [controllers.yaml]
2026-10-28 feat(arms): engage an arm from stow to ready, one or both, and hand over to track
    The straight joint-space line to the ready keyframe is checked against the collision
    geometry, followed by a posture controller under gravity, then track takes over as a hold.
    Both arms run under one controller over the model's new bimanual task space.
    [controllers.yaml]
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2026-10-28 arm-gafro: follow_pose, a position controller for live pose targets
    The pose, joint-limit and posture stages of a velocity controller, run on an anchor their own velocity moves; the integrated anchor is the
    command, as in the position mode the arm already runs. Starting values: it has run in the simulator (holds without drift, reaches a target
    0.026 m away to 0 error with the driver's gravity feed-forward stood in for), not on an arm.
    [controllers.yaml]
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2026-10-28 arm-gafro: follow_pose guard margin 0.01 rad, pose gain 40
    The joint-limit guard sits above the pose stage, so a joint inside its margin blocked the hand. At margin 0.35 the first lap of a closed 8 cm circle left a joint inside it and the hand
    froze on the second lap (146 mm off by the end, joints 0.535 rad from where they started). At 0.01 both laps track at a steady lag and the joints come back to within 0.05 rad.
    With the guard out of the way the pose gain sets the lag: mean hand error 10.7, 6.1, 3.8 and 2.6 mm at gain 10, 20, 40 and 80, no oscillation up to 80. 40 is the value: past it the
    gain is 1 mm for twice the risk on an arm that has not run this controller. Simulator only; the ar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
    [controllers.yaml]
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2026-10-28 arm-gafro: follow_pose feeds forward the estimated twist of its target
    The pose stage's lag on a moving target is its speed over its gain. A PoseStamped carries no velocity, so pose_follow estimates one: log(M_before^-1 M_now) / dt of what the controller
    last sampled, which is the twist in the tool frame (the frame the pose error is in), filtered over 50 ms and limited to the stage's own speed limits so a target that jumps is not a
    huge twist. It feeds the new `reference_rate` input of follow_pose through the pose law's `feedforward`; engage.build takes the twist source.
    In the simulator through ctl follow, on a closed 8 cm hand circle, the mean hand error at pose gain 40 goes from 3.76 to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
    [controllers.yaml]
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2026-10-28 arm-gafro: follow_pose damps harder near a singularity (regularization 0.05 rising to 0.3 below a smallest singular value of 0.15)
    Needs the gafro with SingularityDamping (public PR #20). In simulation, with the target going out to 24 cm and back, jumping back from there, or wandering outside the reach
    and re-entering, the peak joint speed is 1.0-1.9 rad/s and no run stops on vibration; without the damping the same runs peak at 4.0-4.5 rad/s and stop. The damping constrains
    no direction, which a singular_values guard stage above the pose did not manage (it held the singular value at its floor and the hand stayed where it caught it). Cost: a hand
    held at the very edge of the reach tracks less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
    [controllers.yaml]
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2026-10-28 arm-gafro: raise the path speed limit to 3.5 rad/s, with the vibration stop at 4.5 for paths and max_velocity in the example config
    [hardware.example.yaml]
2026-10-28 arm-gafro: the driver's max_velocity is the one path-speed setting; the service's limit and its vibration stop derive from it
    [hardware.example.yaml]
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2026-10-28 description: the chest cover, and a 30-degree Femto mount as a variant
    The chest cover (the neck's M5Dial on its back) is a fixed part on lift_platform, in the head's
    export frame, where the OpenArm frame's stock cover was. Its collision is a box that stops between
    the two shoulder bases: the mesh's convex hull wraps them and would be a contact that never ends.
    The 30-degree Femto Bolt mount fits the default mount's pockets. Its STL was exported 380 mm to the
    right and 8 mm low; the leg footprint, the leg ends and the detent faces all register it at
    (0, +380, +8) mm. Its mesh carries the camera envelope, turned 30 deg down, so camera_link pitches
    36 deg (Orbbec's 6 plus the mount's 30). The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
    [chest_cover.stl, femto_mount_tilt30.stl, opendubs-femto-straight.urdf, opendubs-femto-tilt30.urdf, opendubs.urdf]
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2026-10-28 description: the 30-degree Femto mount is the fitted default
    The 30-degree mount is fitted on opendubs2, so it becomes what opendubs.urdf and opendubs.xml
    describe: dimensions.yaml femto_mount.module is femto_bolt_tilt30, camera_link pitches 36 deg (6 deg
    Orbbec + 30 deg mount) and camera_color 30 deg. The straight mount stays a selectable variant:
    opendubs-femto-straight.urdf for robot_state_publisher (OPENDUBS_URDF), and
    variants.femto_mount(spec, "straight") for the MJCF, which now swaps the old meshes, boxes and
    sites back in. Both mounts compile to the same geometry as before the swap (sites, boxes, visuals,
    to 1e-6). coverage.py's Head defaults to the fitted mount; its tilt sweep still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
    [opendubs.urdf]
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2026-10-28 ros: keep discovery on the Thor with a FastDDS profile, not LOCALHOST
    ROS_AUTOMATIC_DISCOVERY_RANGE=LOCALHOST adds a shared-memory transport on top of any XML profile in
    Jazzy (rmw_fastrtps_shared_cpp participant.cpp), which undid the UDP-only profile nine units carry
    against the deaf-subscriber failure (workplan L.10), and would break the arm container's data if it
    took the setting (private /dev/shm). Found by the Arms lane.
    software/ros/fastdds-robot.xml does the localhost limit itself: UDP on 127.0.0.1 only, no shared
    memory, metatraffic and initial peers on 127.0.0.1, peers 0..63. ros-dds.env now names it and says
    SUBNET explicitly. Every ROS unit reads the file (required now: provision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
    [fastdds-robot.xml]
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2026-10-29 sim: a second candy bucket, its handle folded down (--bucket-variant)
    The same bucket with its handle folded onto the rim, from the user's Fusion
    model in the same export frame as candy_bucket.stl and flipped the same
    way: props/candy_bucket_handle_down.stl, 205 mm tall. It sits beside the
    original as a variant. handle_up stays the default; handle_down is
    --bucket-variant handle_down on scene.py and clearance.py, or
    build(bucket_variant=...).
    The folded handle lies within the wall's own radius at the rim, so it
    collides as the base and wall panels only, with no handle capsules. Mass,
    centre of mass, freejoint, pose and target are the same as the original;
    scene.py --check --candy-bucket --b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
    [candy_bucket_handle_down.stl]
2026-10-29 description: the bucket stage, in front of the robot over the front lidar
    A stage for the candy bucket, from the project's CAD. The file was exported Y-up in its own frame
    with the lift plate as a reference piece, so it is registered on the plate: a +90 deg turn about x,
    then (x + 601, -z - 186, y + 297.555) mm. The plate's 400 x 320 outline lands on the lift plate
    mesh to 0.00 mm, and its hole pattern is centred on that outline to 0.00 mm. The stage itself is a
    plain box in the file, so it is a box here: x 597..829, y -190..234, z 296.6..348.1 mm, on the
    chassis (to be confirmed), visual and collision, and in the URDF's datum link.
    Its underside is 55.3 mm above the front lidar's scan plan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
    [opendubs-femto-straight.urdf, opendubs-femto-tilt30.urdf, opendubs.urdf]
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2026-11-03 choreo: the project's shows and the Surge pack leave the core (content split, step 6)
    The seven shows that are the project's own content (halloween, christmas,
    reach, celebrate, shrug, robotic-smile, agent-written) and the Surge hand's
    tool pack (surge_left, surge_right, its gaits, NOTICE and drivers/surge_at.py)
    are now in the content repository (opendubs-shows: the top level, and
    tools/surge/). The core keeps its three example shows (hello, beat-demo,
    wave-and-nod) and its own tool types (openarm_gripper, suction_cup,
    pneumatic_gripper).
    The tests keep working on fixture copies: the shows they read were already
    in tests/fixtures/shows/, and the Surge pack moves to
    tests/fixtures/content/t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
    [robotic-smile.yaml]
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
